Govish/Shimamp-Hardware/README.md

# Shimamp-Hardware
 Hardware Design Files for high-efficiency shim amplifier
