Govish/Shimamp-Hardware/Mechanical CAD/revB/board_outline_r2.dxf

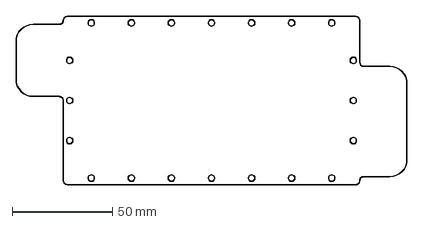
[picture p1: CAD file, 2023-11-08]
Mechanical CAD/revB/board_outline_r2.dxf
195.0 x 84.0 mm
