Govish/Shimamp-Hardware/Mechanical CAD/revB/board_outline.dxf

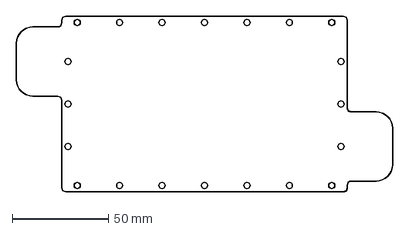
[picture p2: CAD file, 2023-11-08]
Mechanical CAD/revB/board_outline.dxf
195.0 x 91.0 mm
