Govish/Shimamp-Hardware/Mechanical CAD/revA/Class-D Prototype RevA Board Outline.dxf

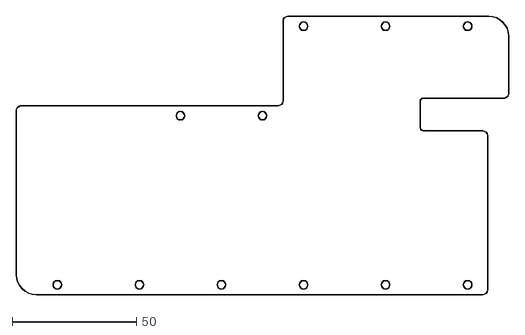
[picture p3: CAD file, 2023-11-08, an earlier design]
Mechanical CAD/revA/Class-D Prototype RevA Board Outline.dxf
198.0 x 112.0
