Govish/Shimamp-Hardware/Mechanical CAD/revA/Class-D Prototype RevA Heatsink.dxf

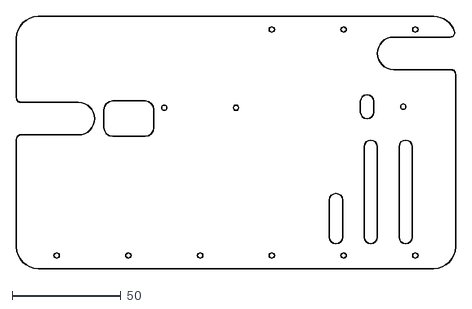
[picture p4: CAD file, 2023-11-08, an earlier design]
Mechanical CAD/revA/Class-D Prototype RevA Heatsink.dxf
202.0 x 116.0
