Govish/Shimamp-Hardware/(list of files, cad)

Other CAD files:
Mechanical CAD/revA/Class-D RevA Board Heatsink.ipt
Mechanical CAD/revA/Class-D RevA Board Outline.ipt
Mechanical CAD/revA/OldVersions/Class-D RevA Board Heatsink.0003.ipt
Mechanical CAD/revA/OldVersions/Class-D RevA Board Outline.0011.ipt
Mechanical CAD/revB/Board Outline.ipt
Mechanical CAD/revB/OldVersions/Board Outline.0009.ipt
