Govish/Shimamp-Hardware/Class-D Prototype revB/Class-D Prototype RevB/Class-D Prototype RevB.pdf

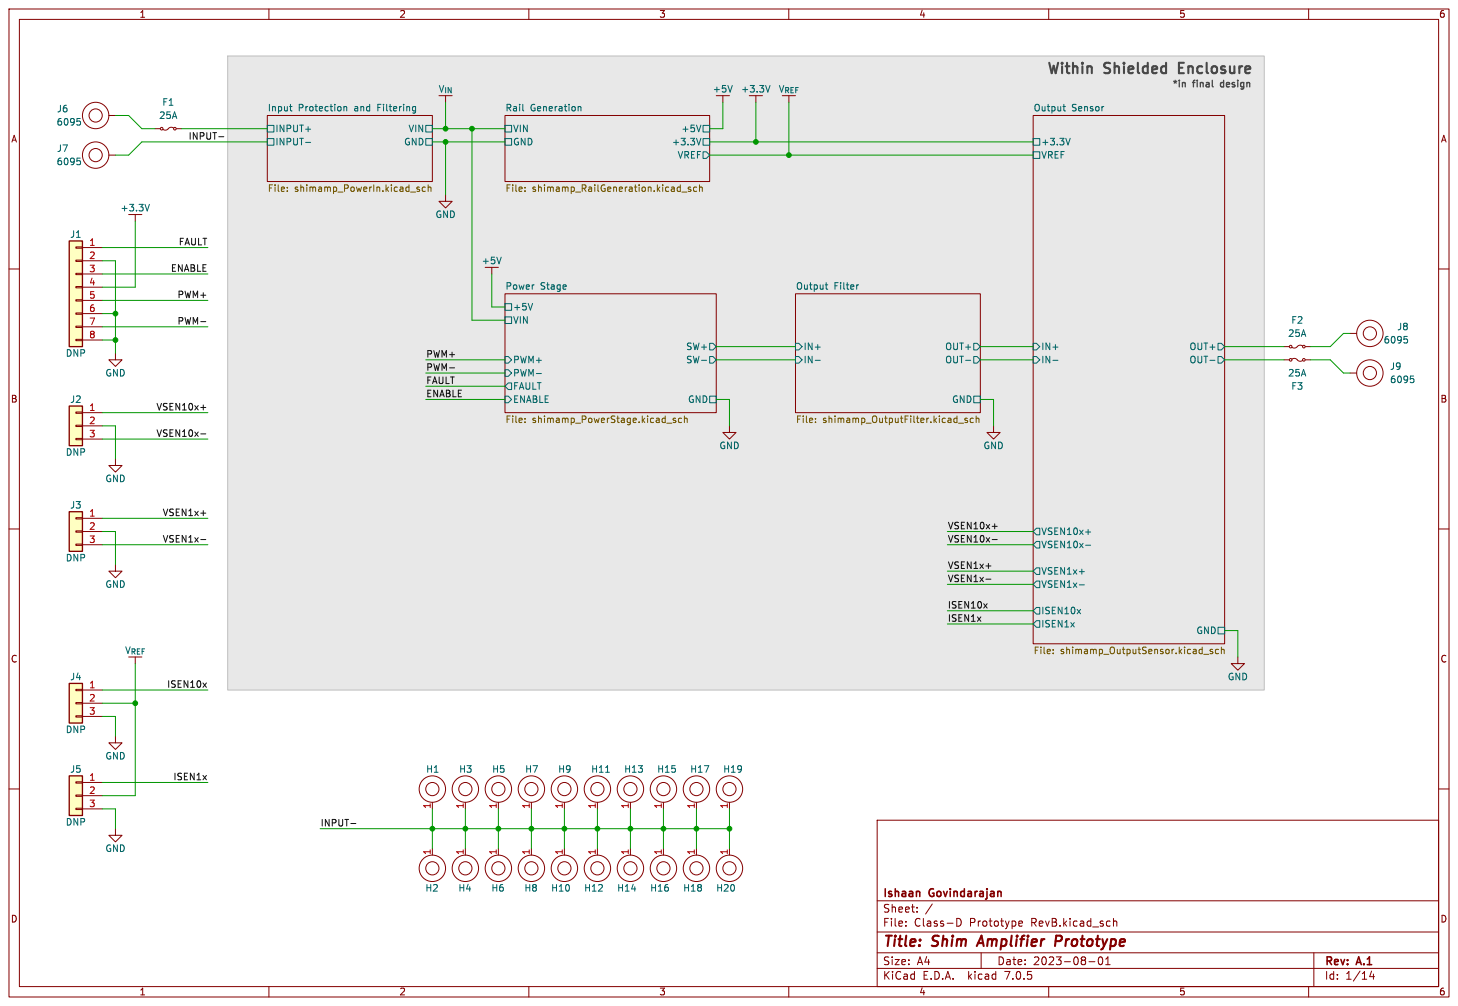
[picture p5: page 1]

Rail Generation File: shimamp_RailGeneration.kicad_sch GND

Ishaan Govindarajan
Id: 1/14 Title: Shim Amplifier Prototype

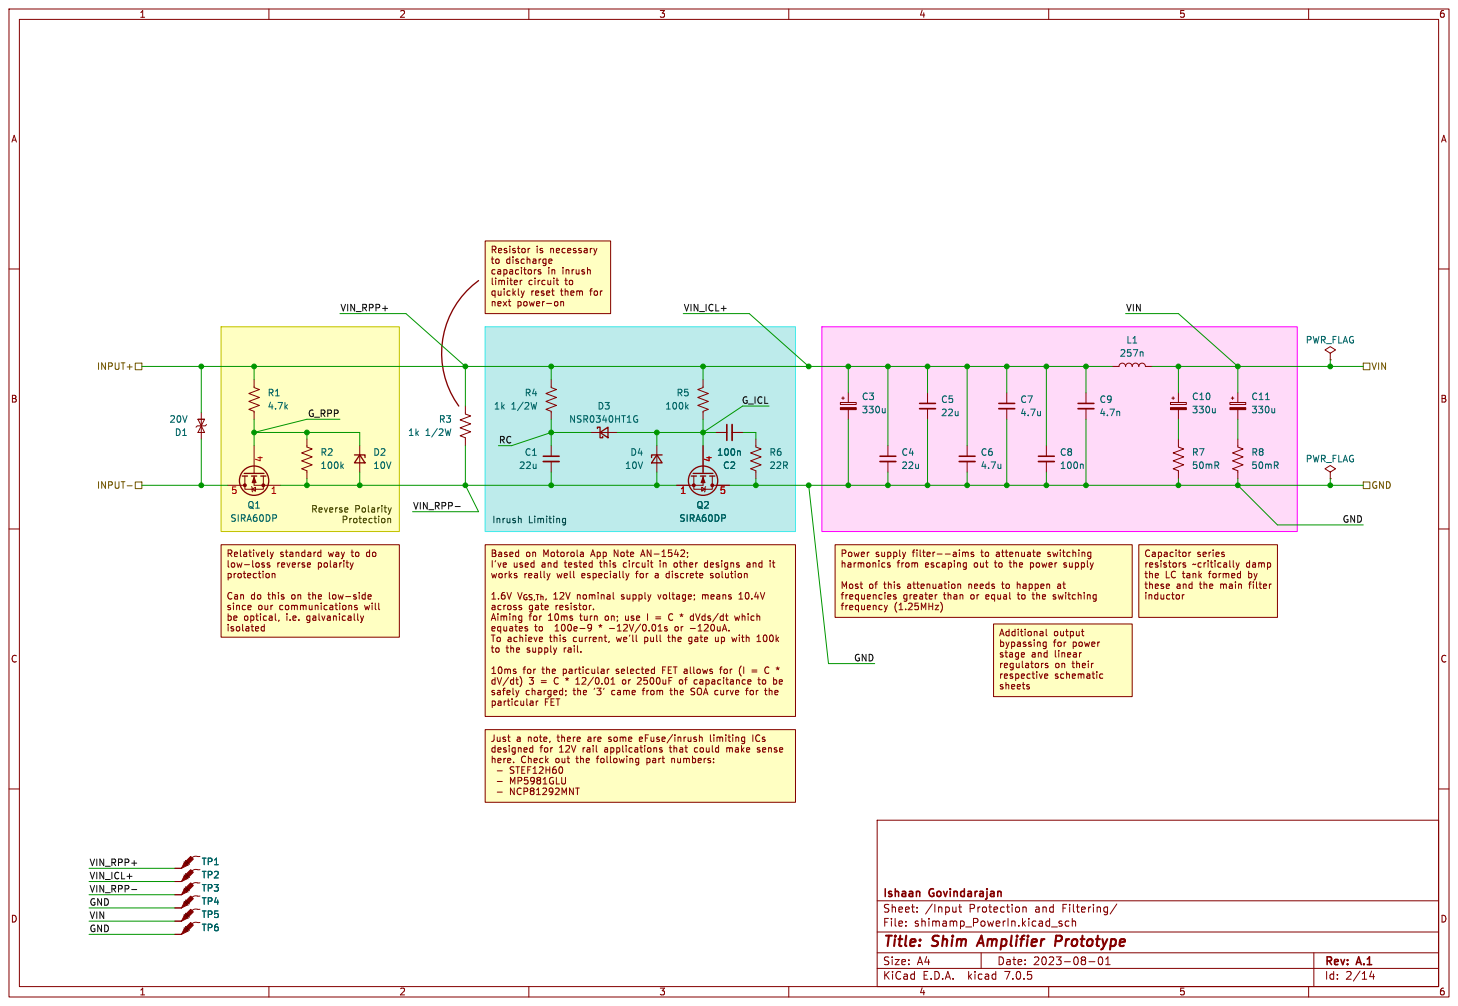
[picture p6: page 2]

- NCP81292MNT Based on Motorola App Note AN-1542;

protection Can do this on the low-side

the LC tank formed by
these and the main filter

1.6V V_{GS,Th}, 12V nominal supply voltage; means 10.4V

safely charged; the '3' came from the SOA curve for the

Id: 2/14 Title: Shim Amplifier Prototype

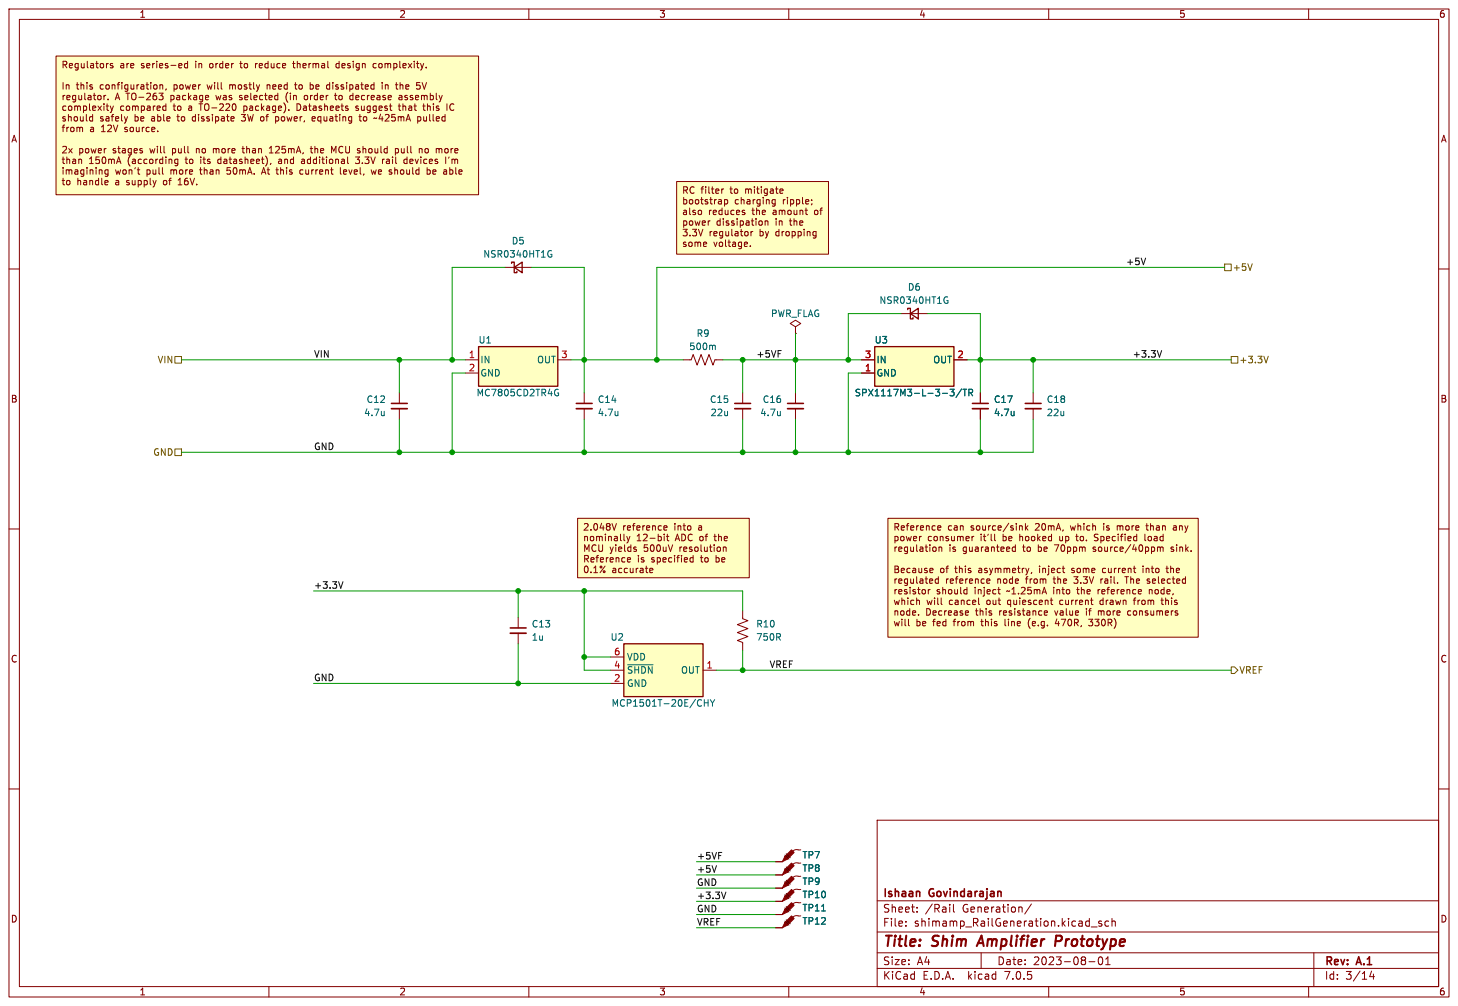
[picture p7: page 3]

from a 12V source. 2x power stages will pull no more than 125mA, the MCU should pull no more

RC filter to mitigate

Ishaan Govindarajan
Id: 3/14 Title: Shim Amplifier Prototype

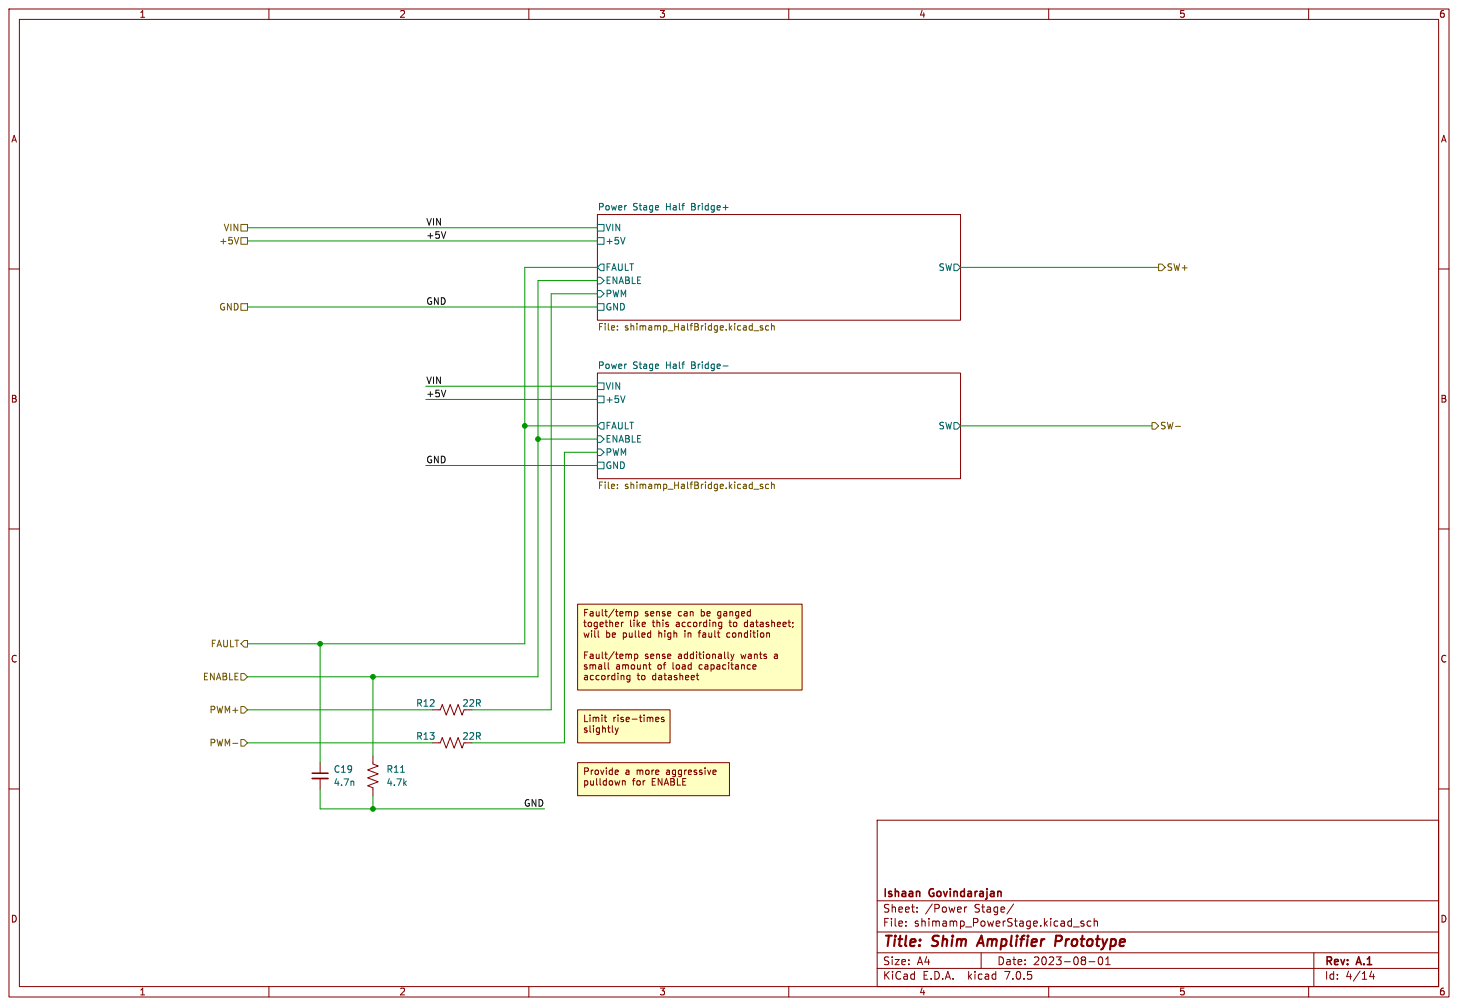
[picture p8: page 4]

Power Stage Half Bridge- File: shimamp_HalfBridge.kicad_sch GND

small amount of load capacitance

Id: 4/14 Title: Shim Amplifier Prototype

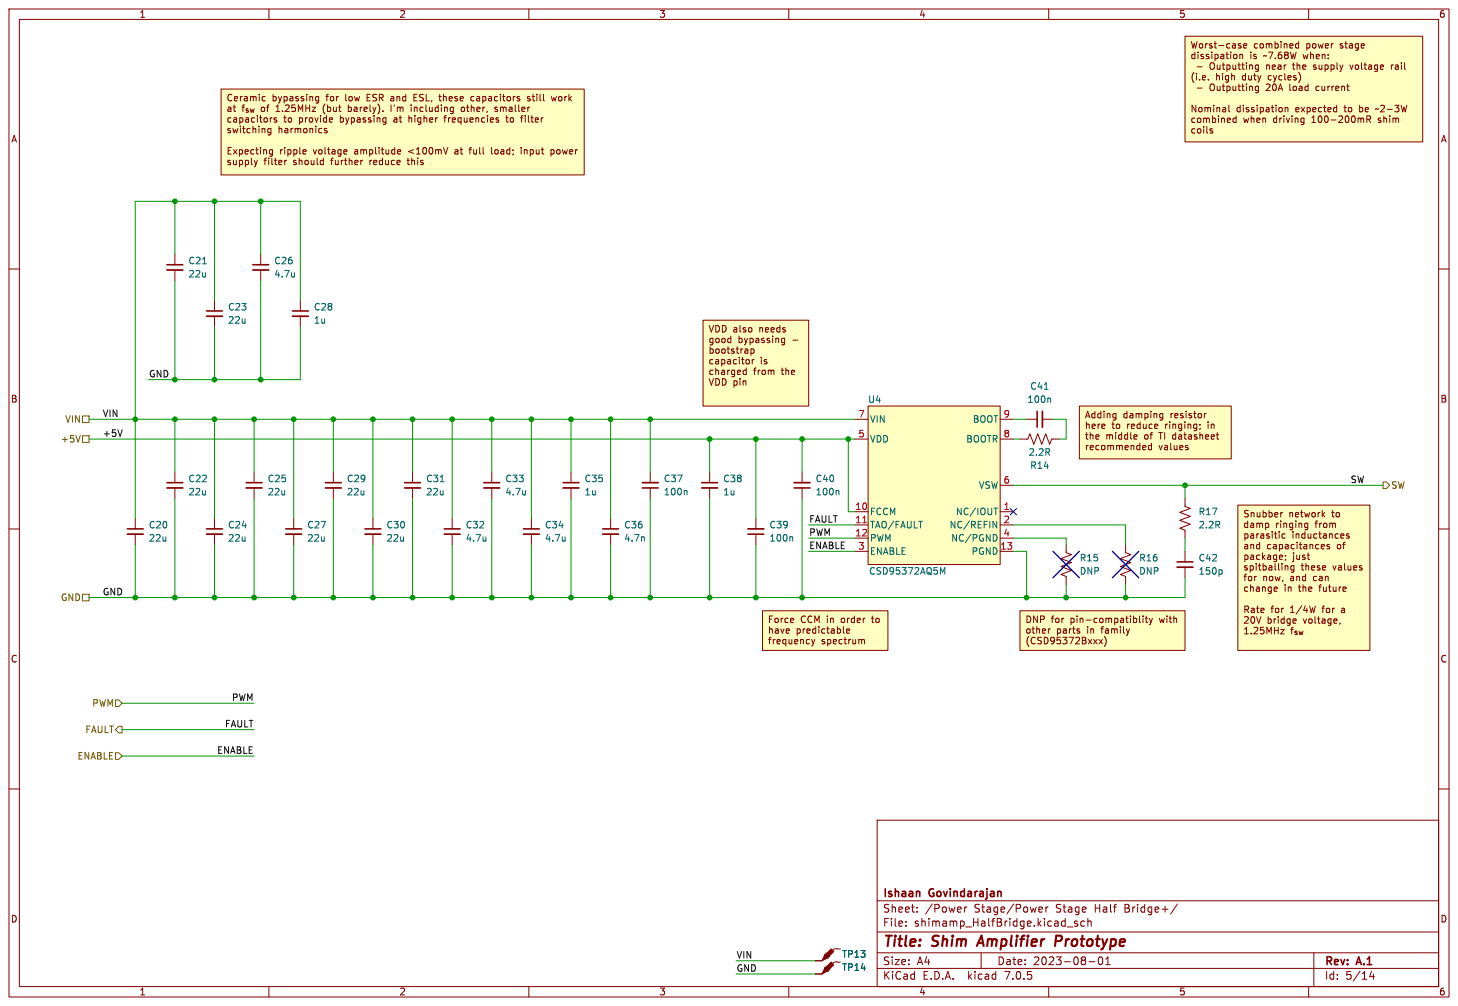
[picture p9: page 5]

charged from the VDD pin

for now, and can
change in the future Rate for 1/4W for a

Force CCM in order to
have predictable

other parts in family

Id: 5/14 Title: Shim Amplifier Prototype

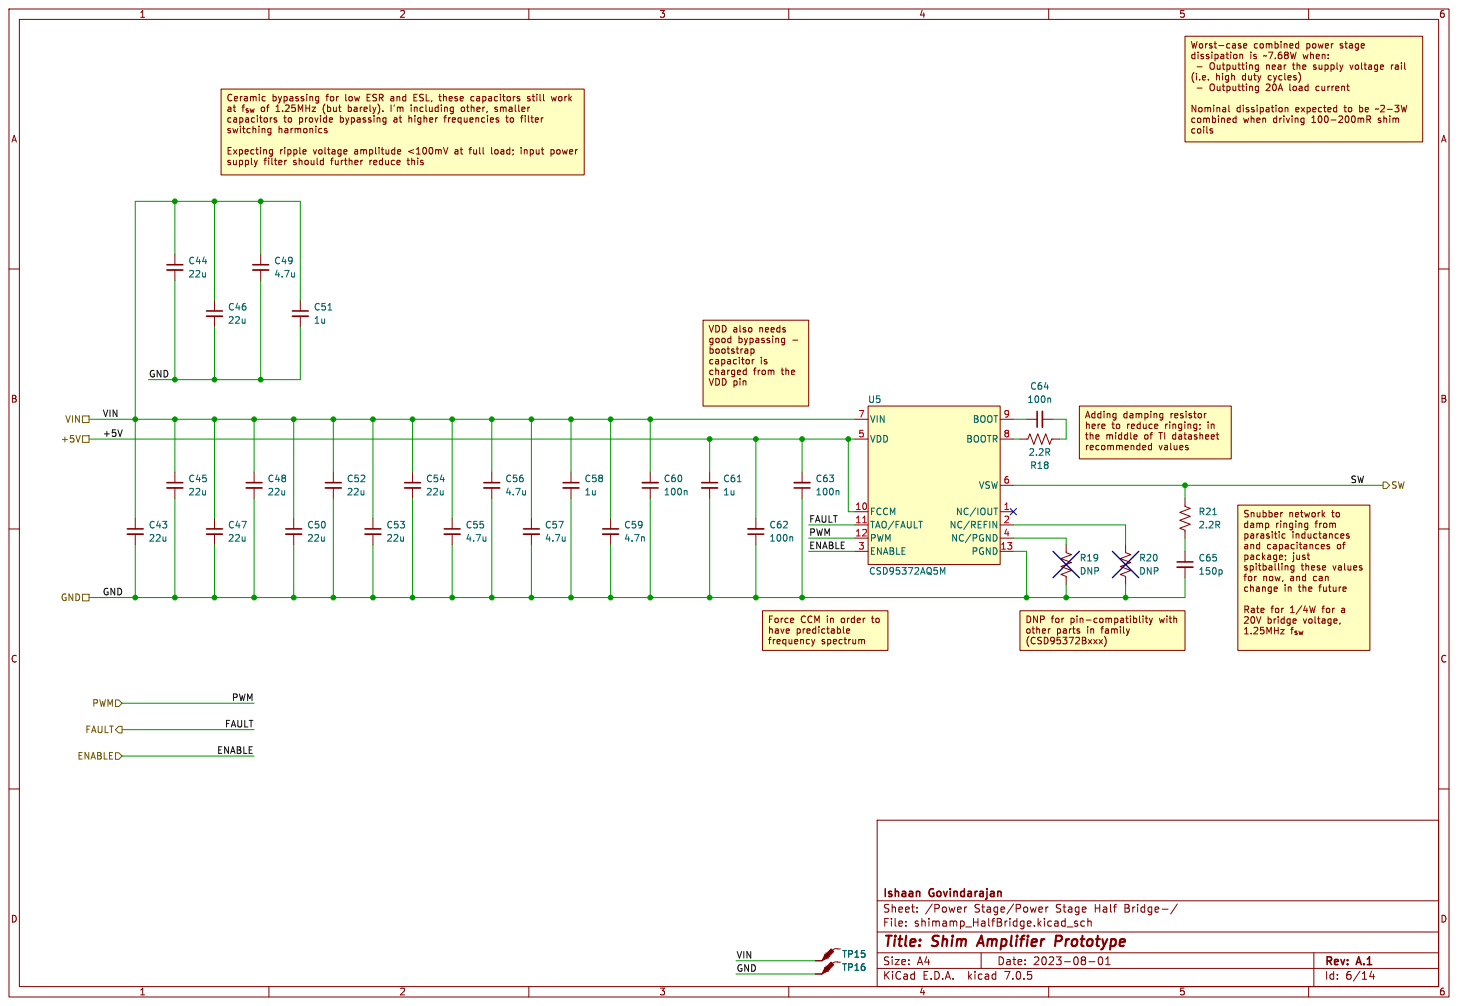
[picture p10: page 6]

charged from the VDD pin

for now, and can
change in the future Rate for 1/4W for a

Force CCM in order to
have predictable

other parts in family

Id: 6/14 Title: Shim Amplifier Prototype

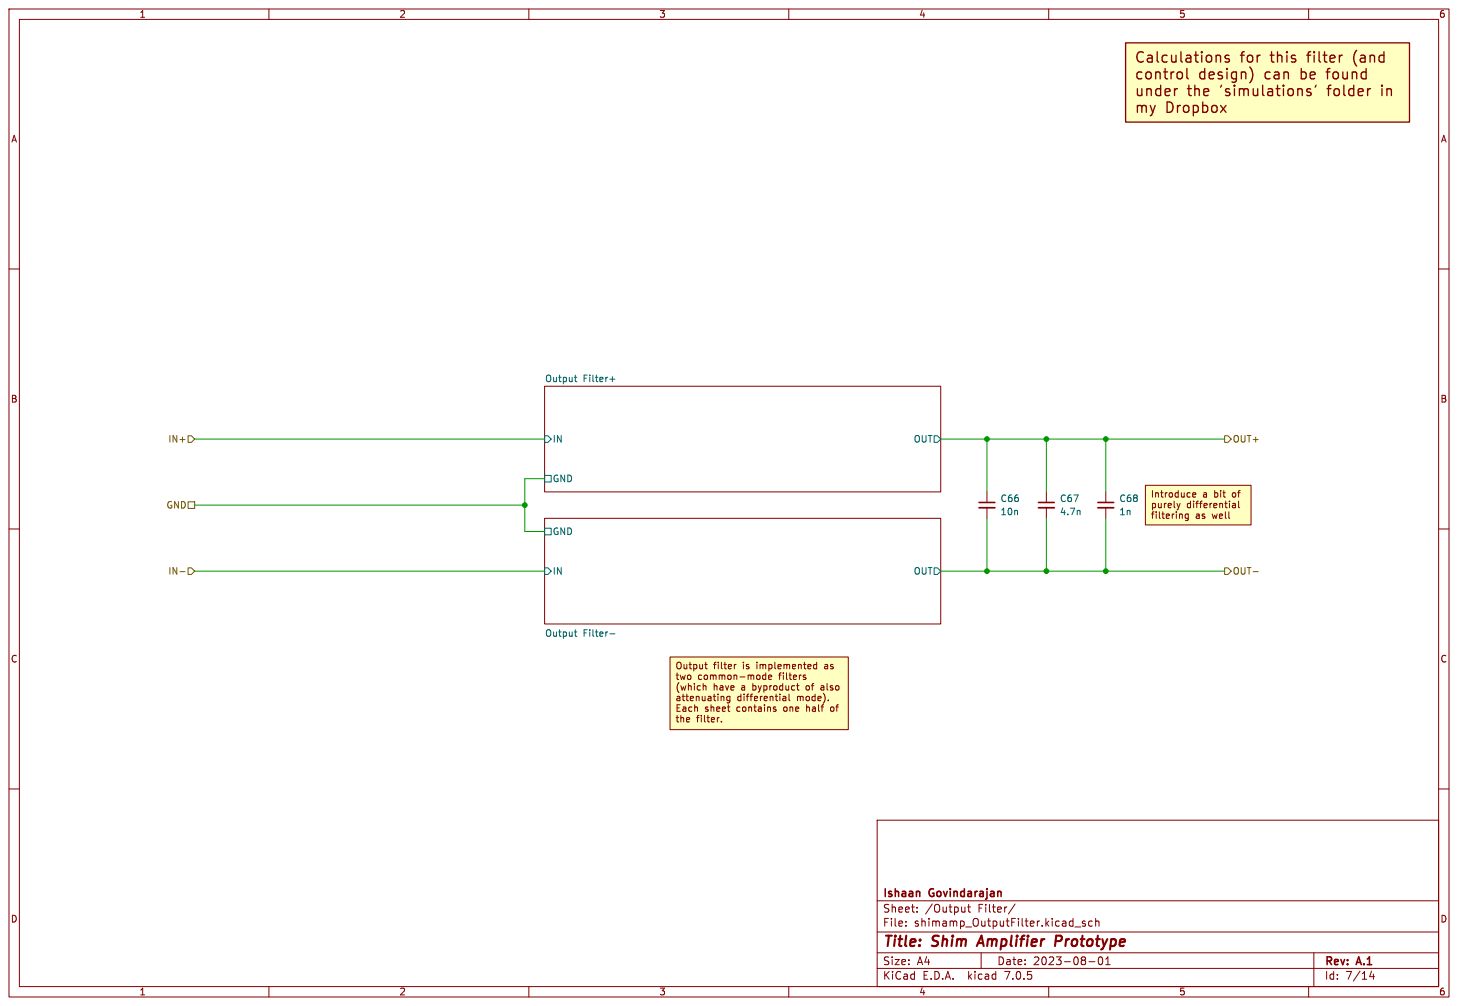
[picture p11: page 7]

Ishaan Govindarajan
Id: 7/14 Title: Shim Amplifier Prototype

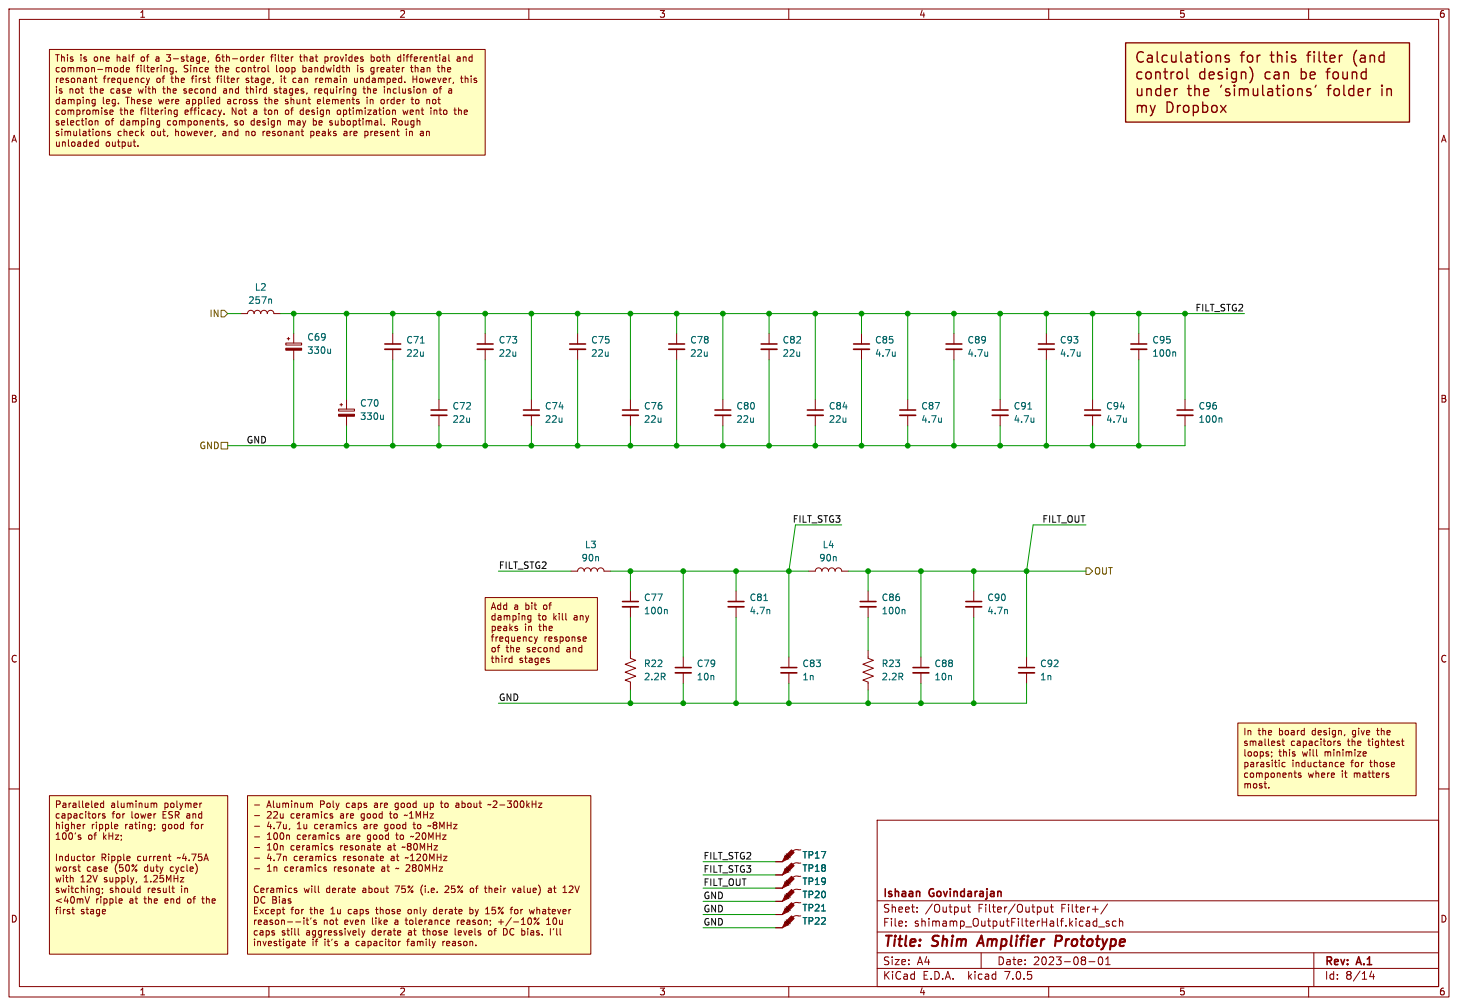
[picture p12: page 8]

Calculations for this filter (and
control design) can be found
my Dropbox

of the second and
third stages

In the board design, give the
loops; this will minimize

- Aluminum Poly caps are good up to about ~2-300kHz

higher ripple rating; good for 100's of kHz;

Ishaan Govindarajan
Id: 8/14 Title: Shim Amplifier Prototype

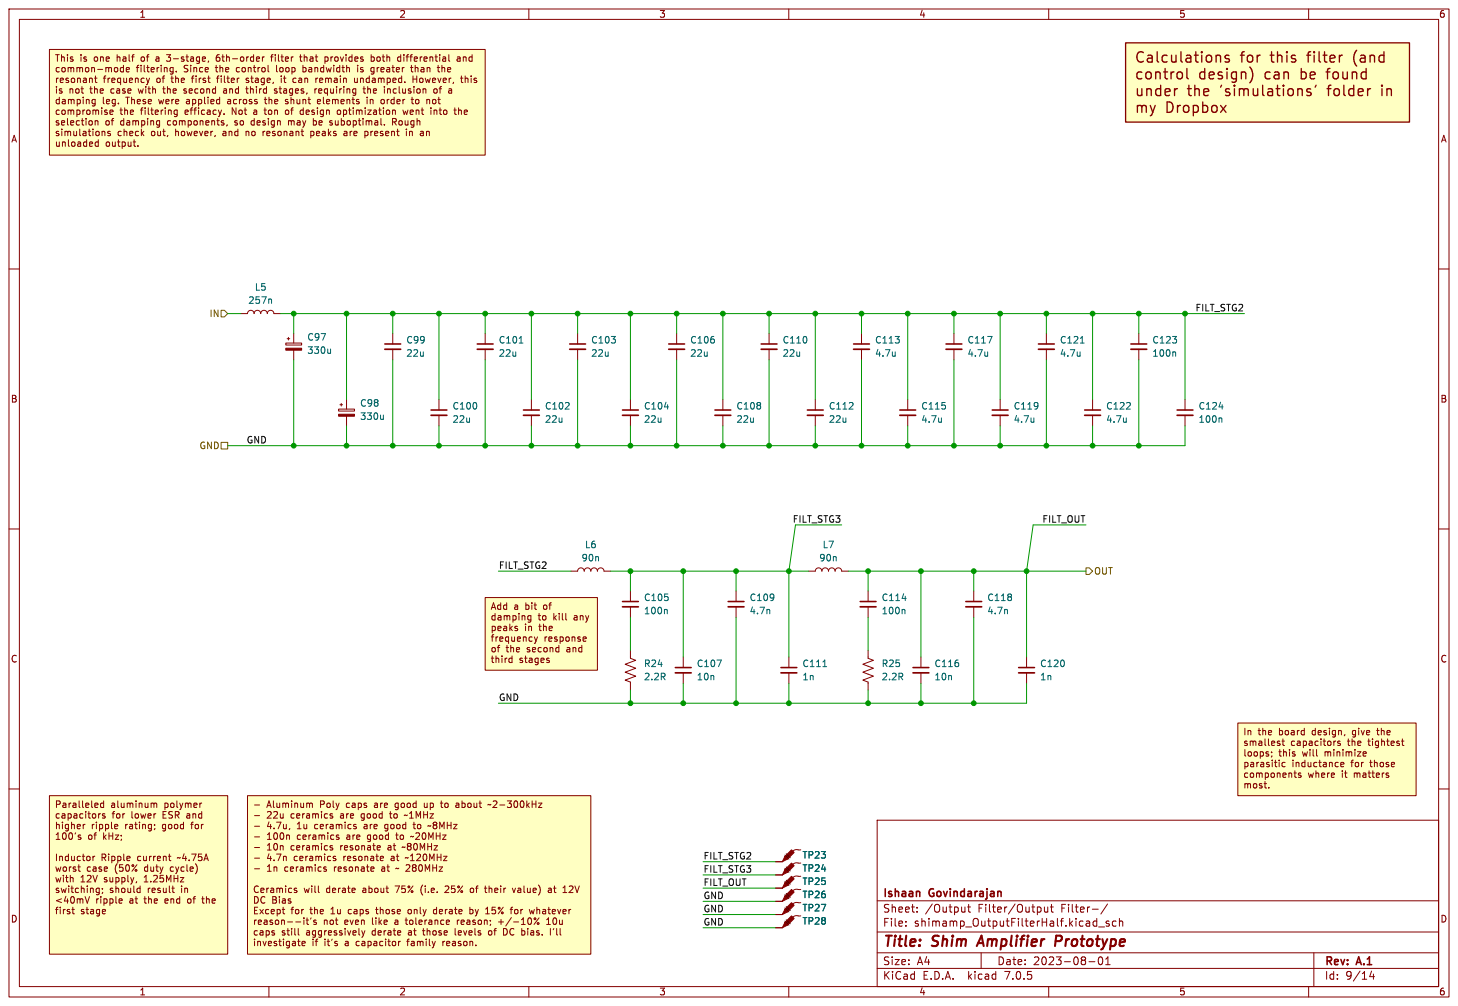
[picture p13: page 9]

Calculations for this filter (and
control design) can be found
my Dropbox

of the second and
third stages

In the board design, give the
loops; this will minimize

- Aluminum Poly caps are good up to about ~2-300kHz

higher ripple rating; good for 100's of kHz;

Ishaan Govindarajan
Id: 9/14 Title: Shim Amplifier Prototype

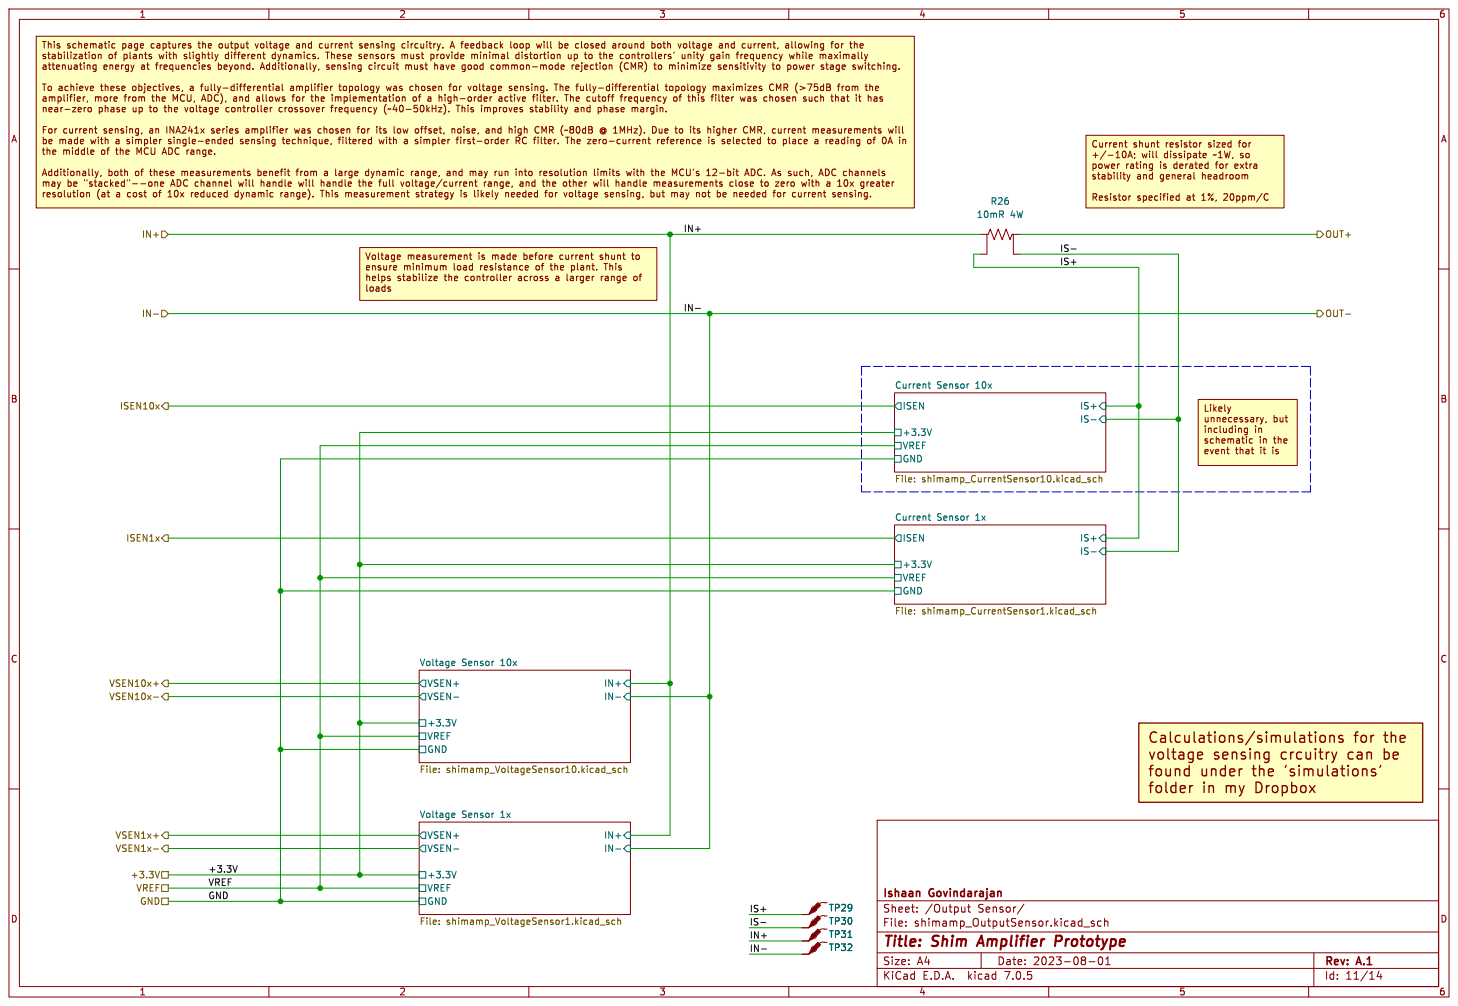
[picture p14: page 10]

power rating is derated for extra

Current Sensor 10x File: shimamp_CurrentSensor10.kicad_sch GND

event that it is

IS+ Current Sensor 1x File: shimamp_CurrentSensor1.kicad_sch VSEN- VSEN+

voltage sensing crcuitry can be
found under the 'simulations'
folder in my Dropbox

Id: 11/14 Title: Shim Amplifier Prototype

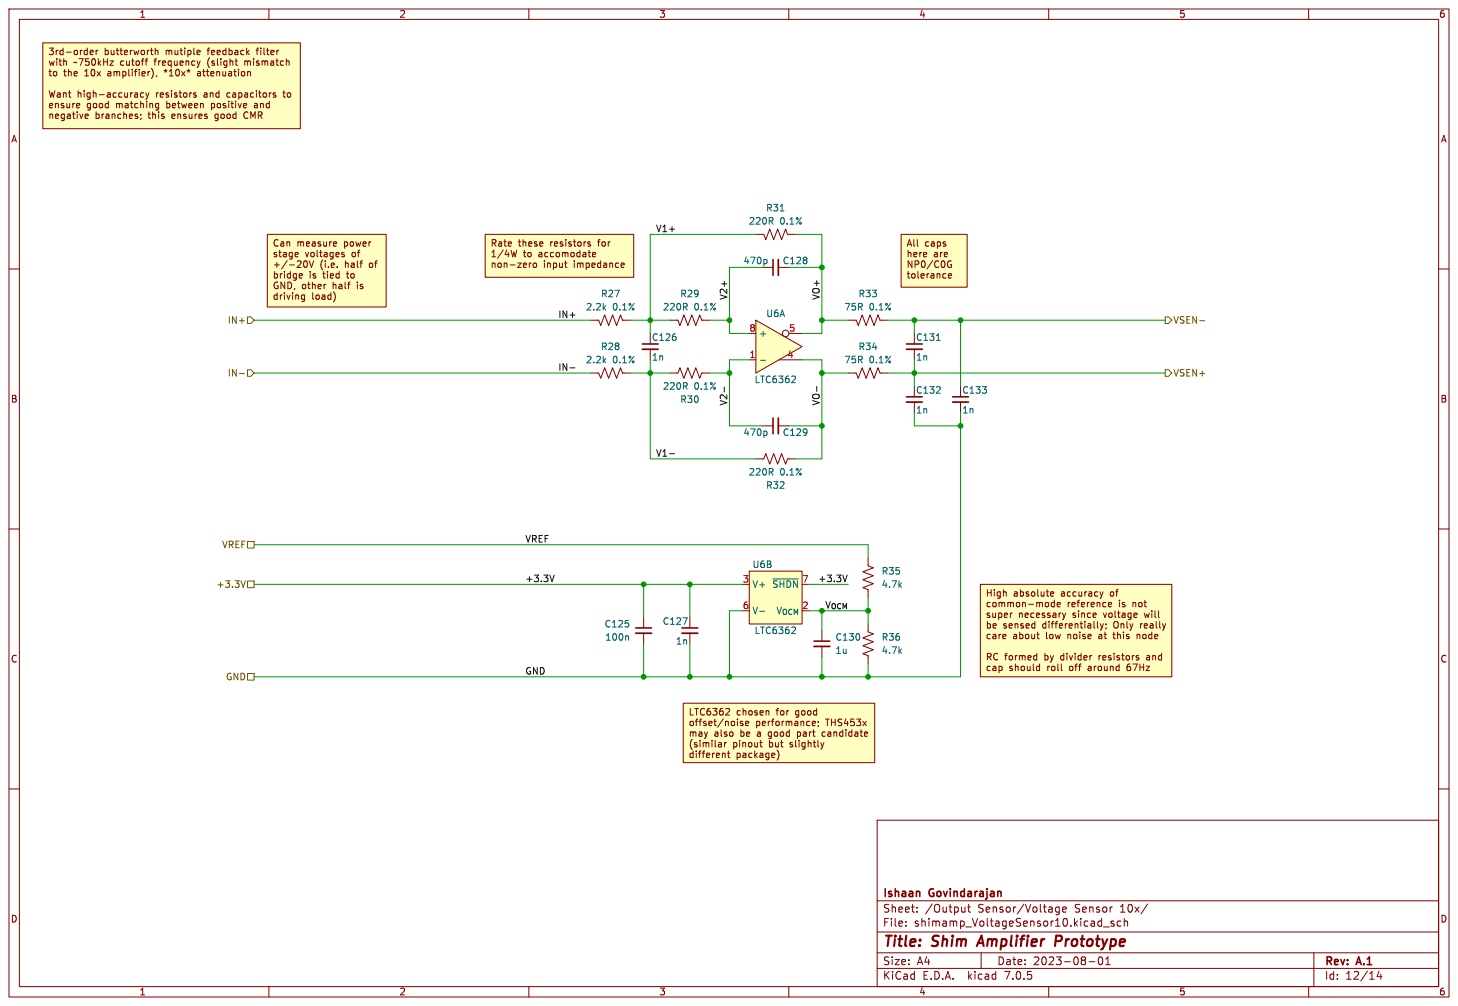
[picture p15: page 11]

cap should roll off around 67Hz LTC6362 chosen for good

Id: 12/14 Title: Shim Amplifier Prototype

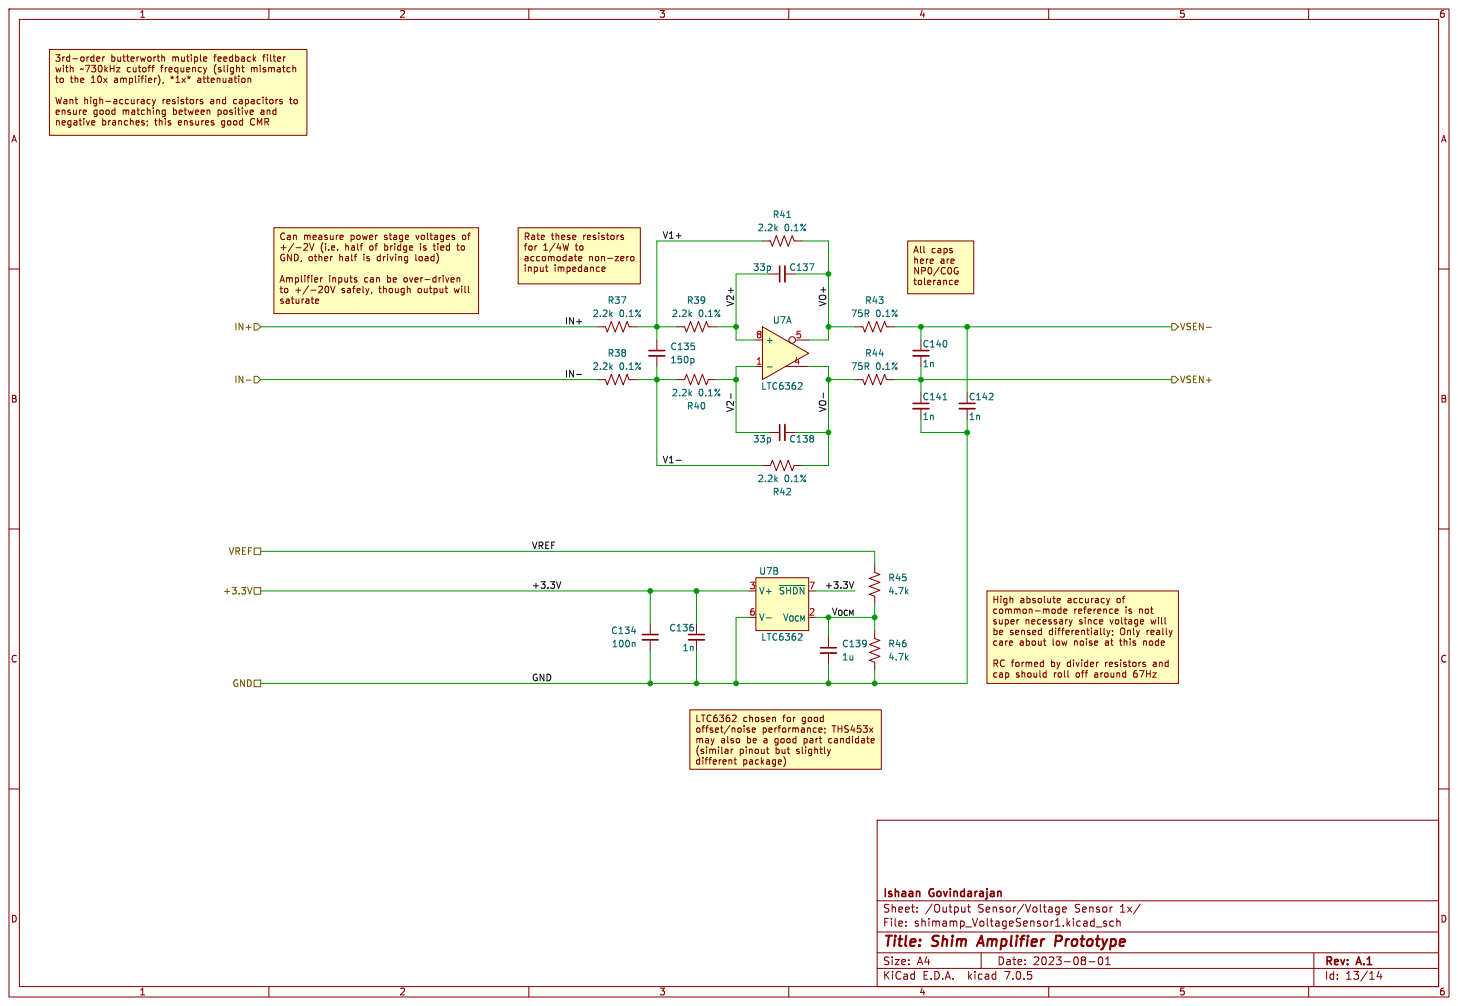
[picture p16: page 12]

cap should roll off around 67Hz All caps here are NP0/C0G

Id: 13/14 Title: Shim Amplifier Prototype

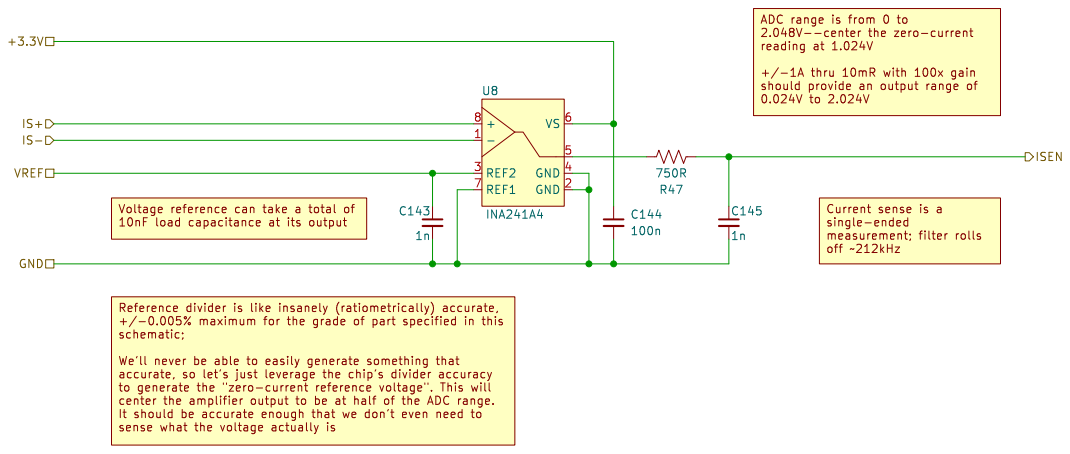
[picture p17: page 13]

should provide an output range of 0.024V to 2.024V

Id: 14/14 Title: Shim Amplifier Prototype

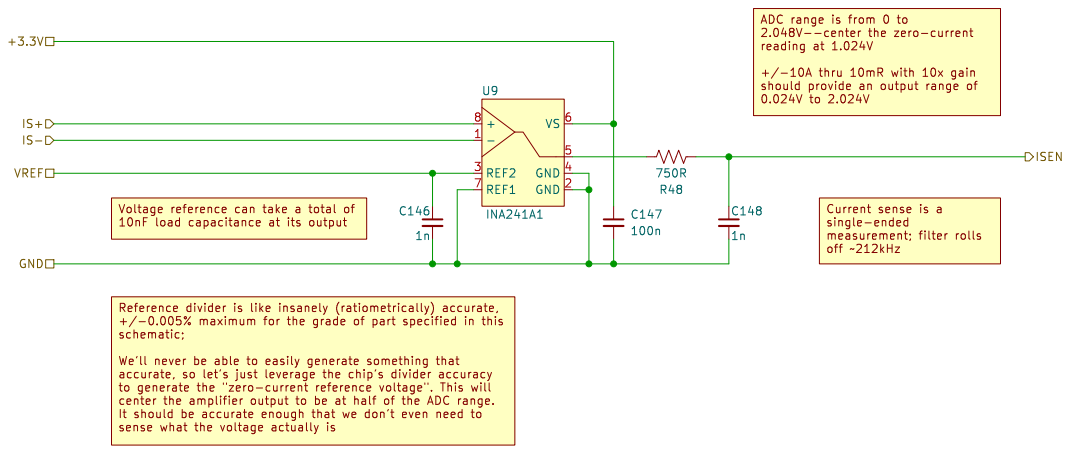
[picture p18: page 14]

should provide an output range of 0.024V to 2.024V

Id: 15/14 Title: Shim Amplifier Prototype
