Govish/Shimamp-Hardware/Class-D Prototype revB2/Class-D Prorotype RevB2/Class-D Prorotype RevB2.pdf

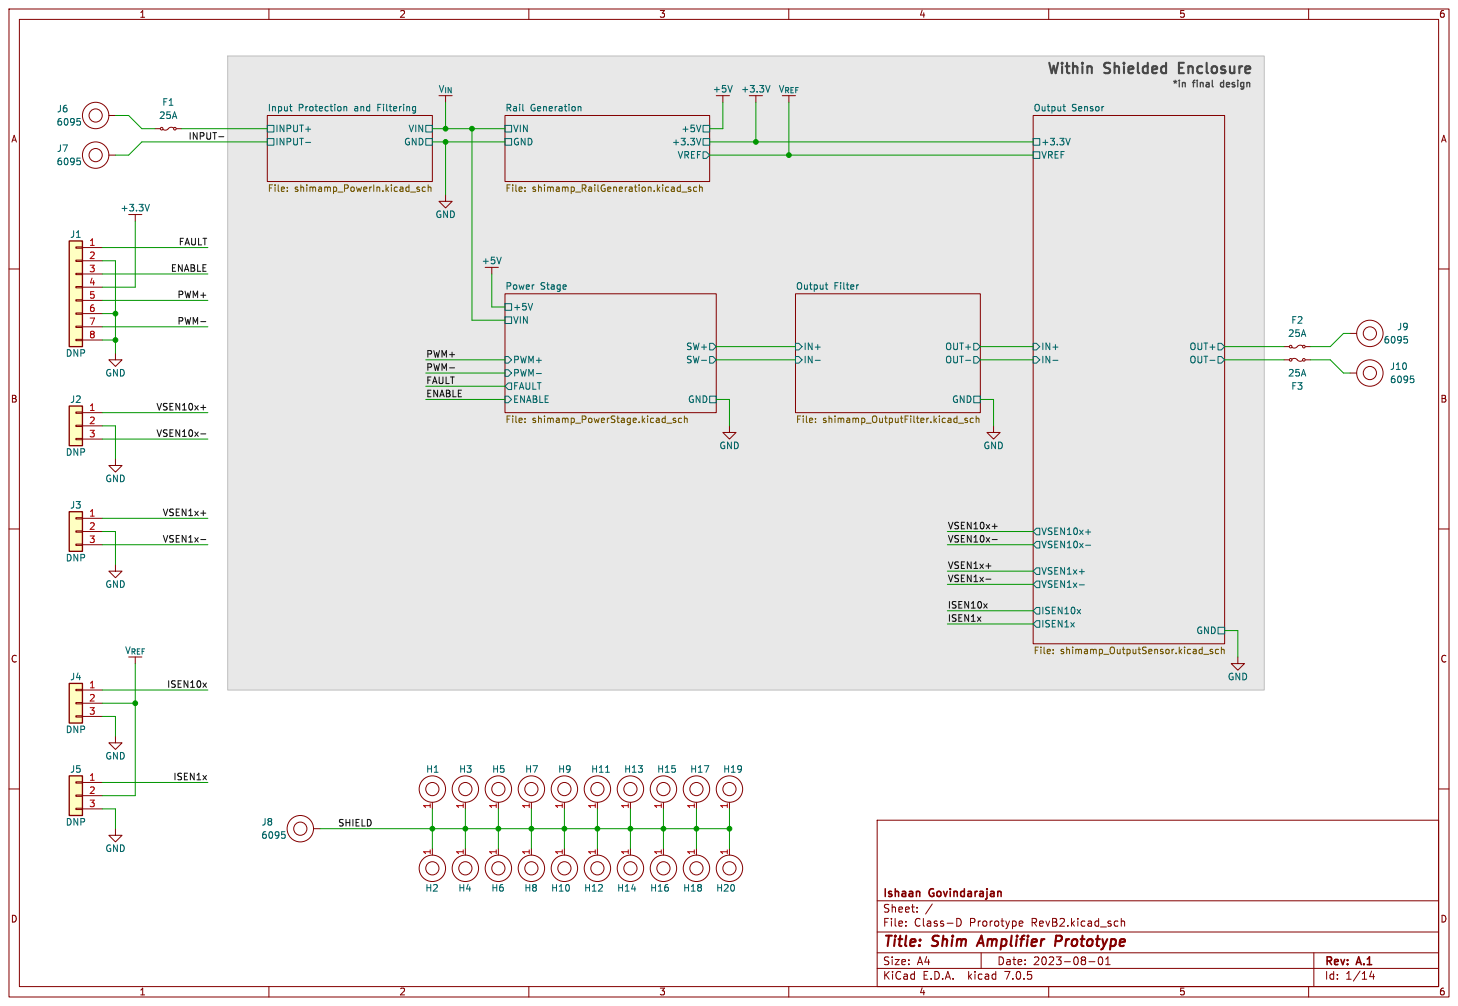
[picture p19: page 1]

Ishaan Govindarajan
Id: 1/14 Title: Shim Amplifier Prototype

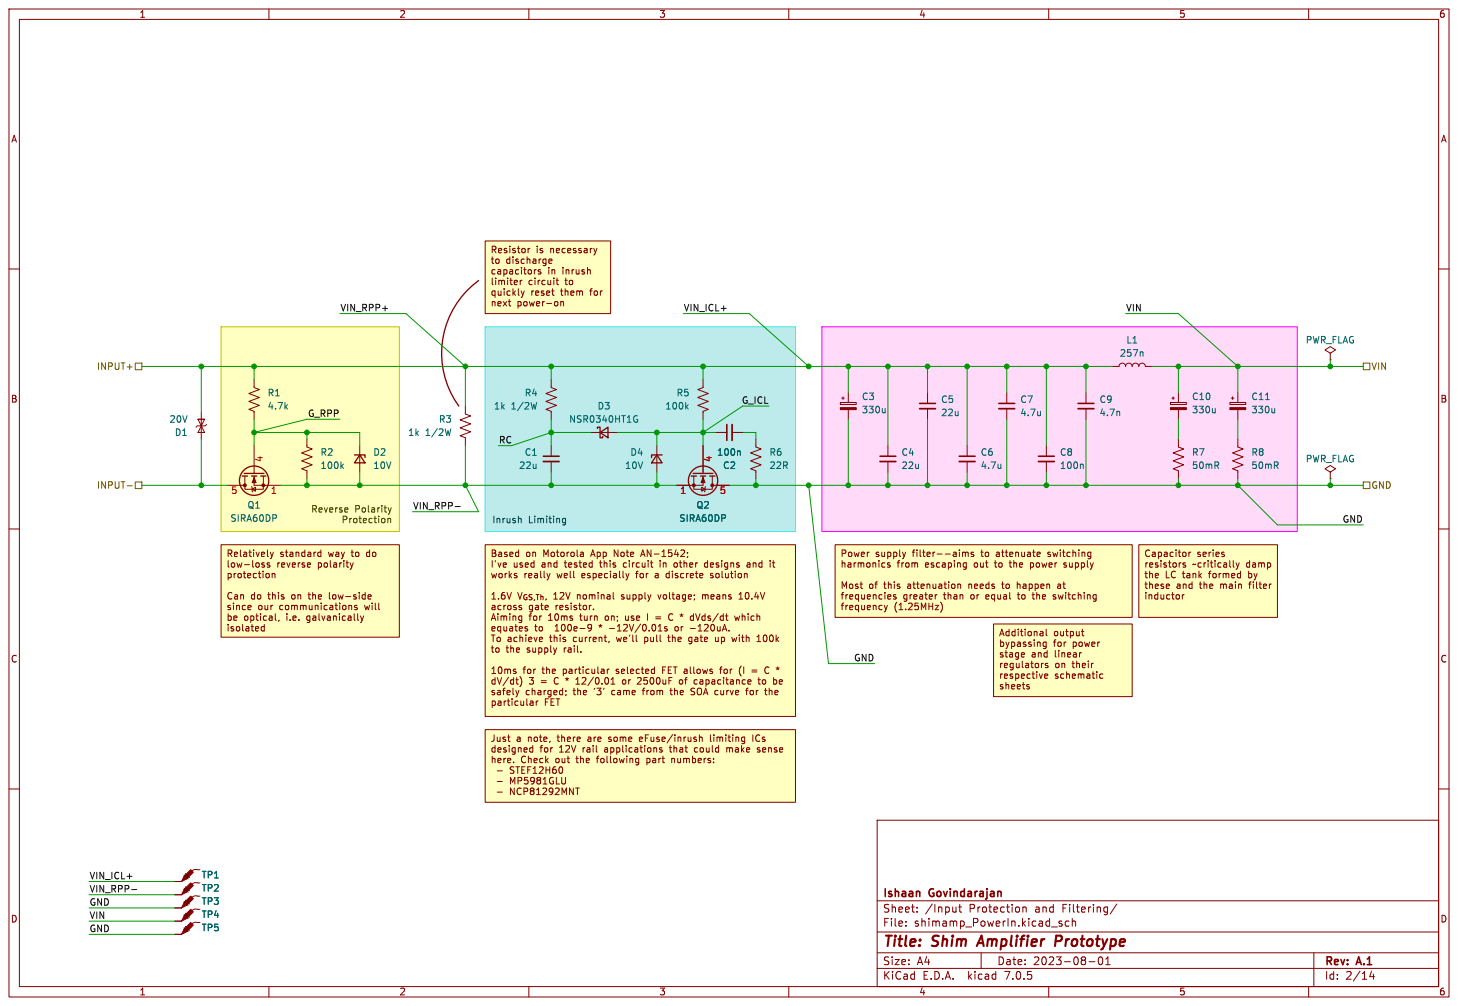
[picture p20: page 2]

protection Can do this on the low-side

the LC tank formed by
these and the main filter

1.6V V_{GS,Th}, 12V nominal supply voltage; means 10.4V

safely charged; the '3' came from the SOA curve for the

Id: 2/14 Title: Shim Amplifier Prototype

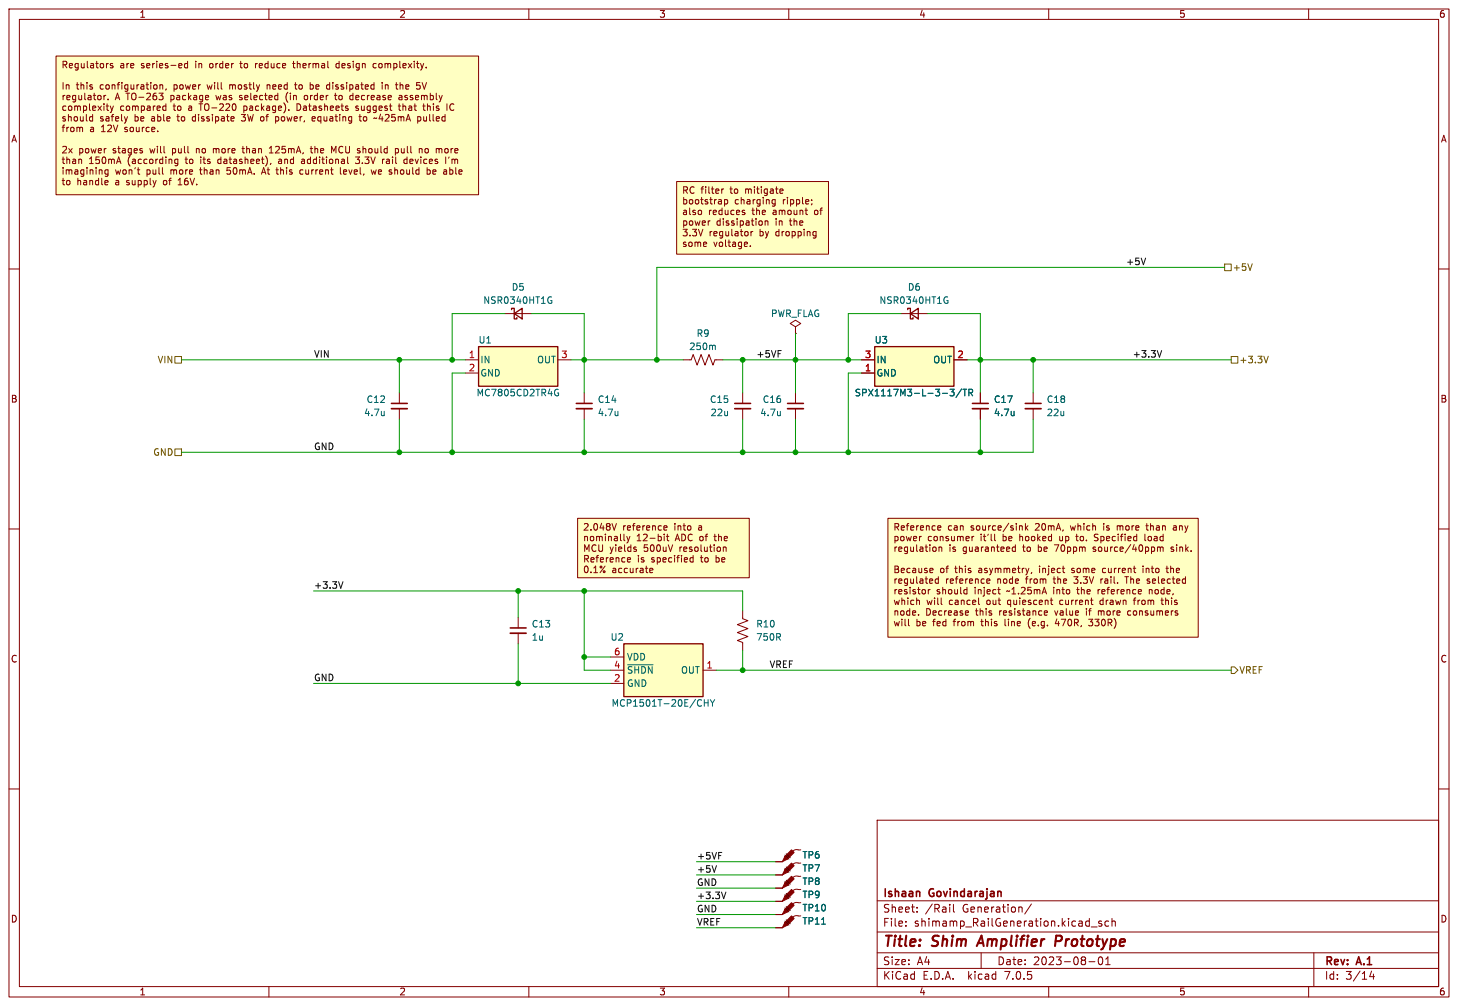
[picture p21: page 3]

from a 12V source. 2x power stages will pull no more than 125mA, the MCU should pull no more

Id: 3/14 Title: Shim Amplifier Prototype


Power Stage Half Bridge- File: shimamp_HalfBridge.kicad_sch GND

small amount of load capacitance

Id: 4/14 Title: Shim Amplifier Prototype

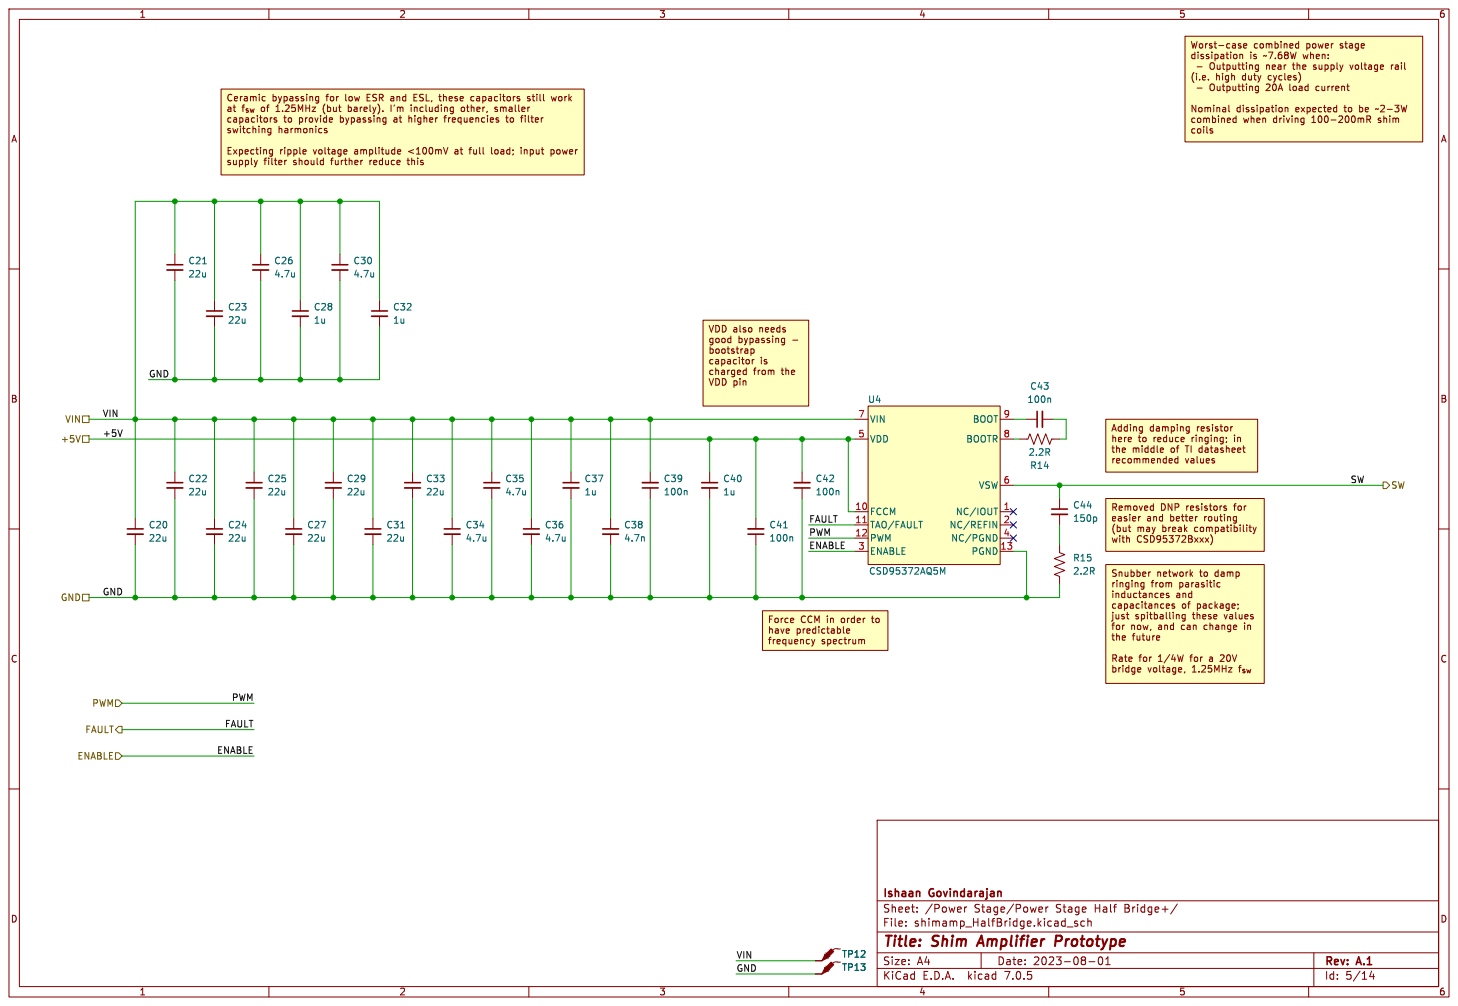
[picture p22: page 5]

coils Snubber network to damp

ringing from parasitic
for now, and can change in
the future Rate for 1/4W for a 20V

bridge voltage, 1.25MHz f_{sw} Force CCM in order to
have predictable

Ishaan Govindarajan
Id: 5/14 Title: Shim Amplifier Prototype

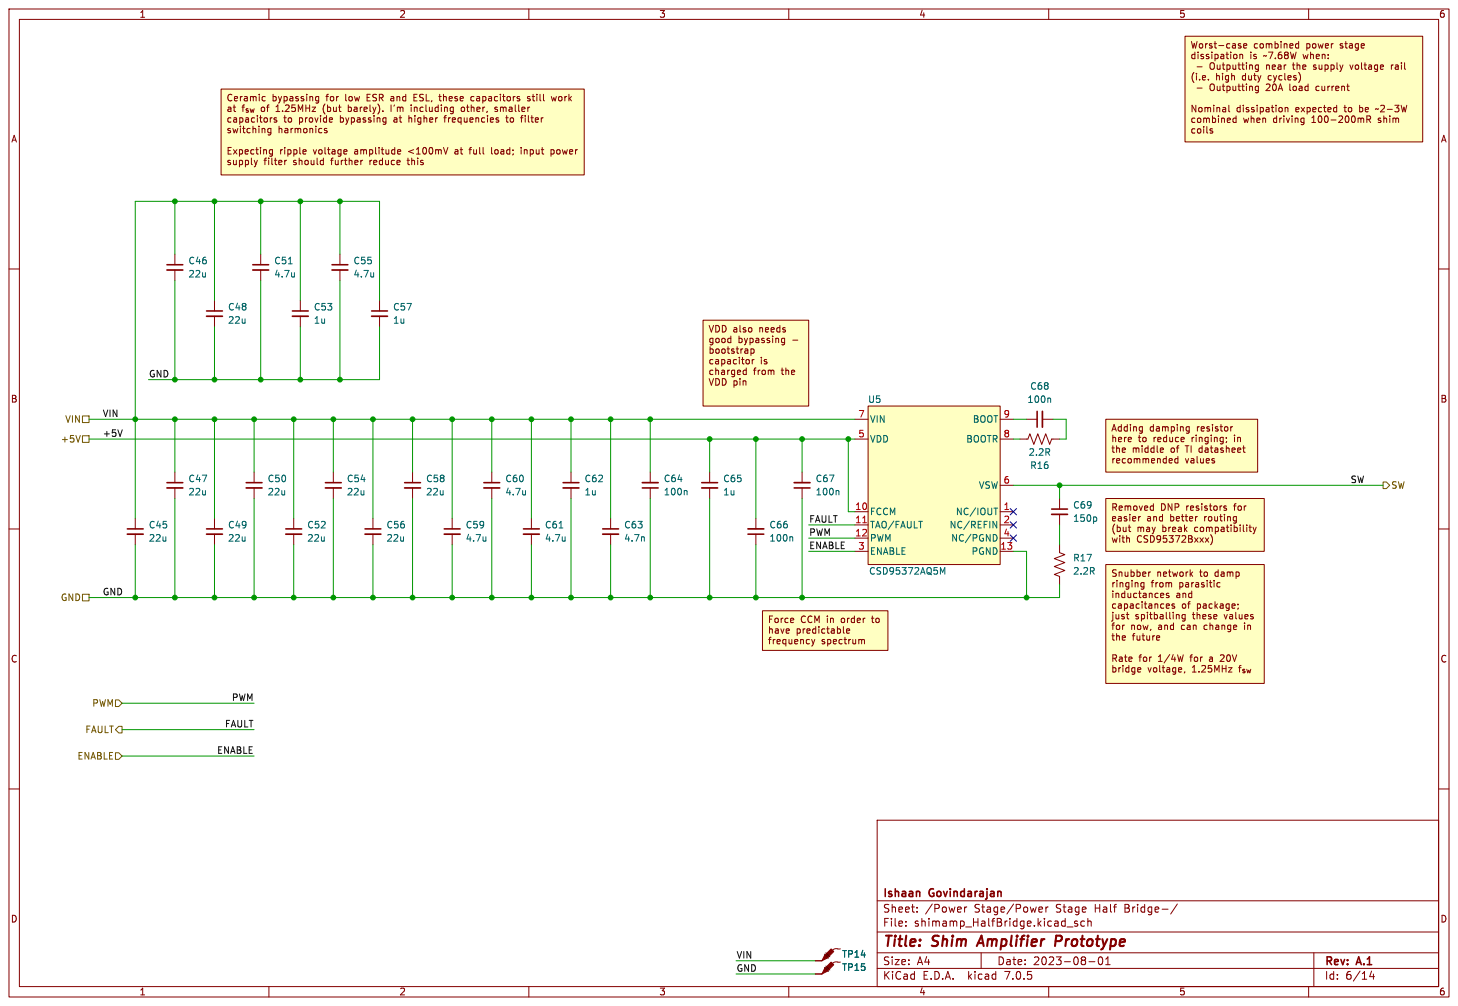
[picture p23: page 6]

coils Snubber network to damp

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

bridge voltage, 1.25MHz f_{sw} Force CCM in order to
have predictable

Ishaan Govindarajan
Id: 6/14 Title: Shim Amplifier Prototype

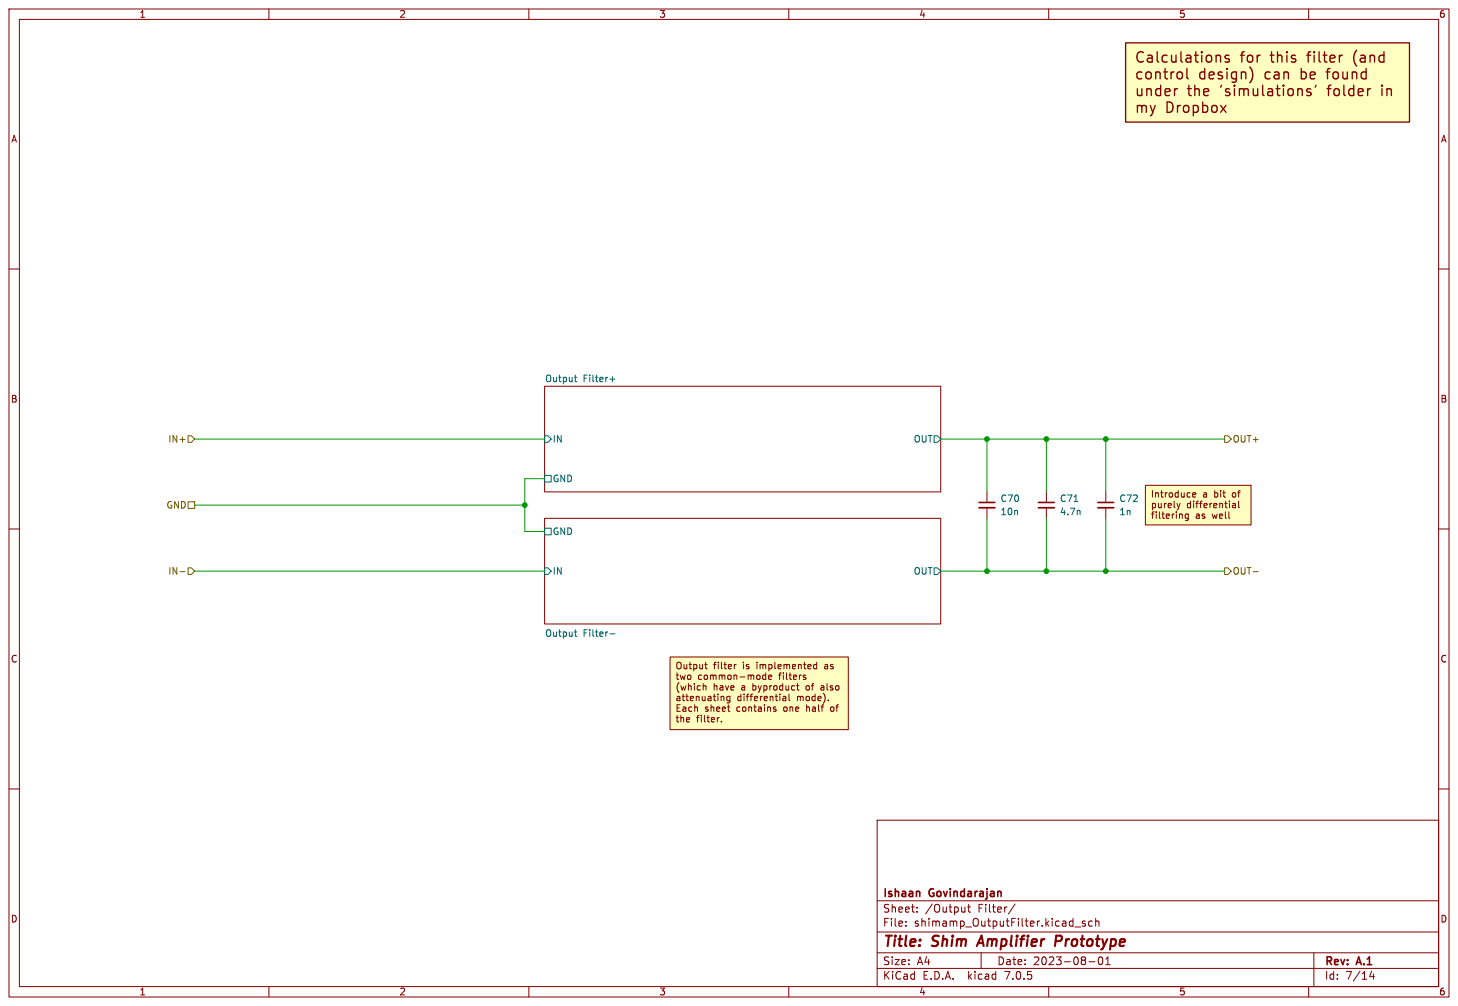
[picture p24: page 7]

Ishaan Govindarajan
Id: 7/14 Title: Shim Amplifier Prototype

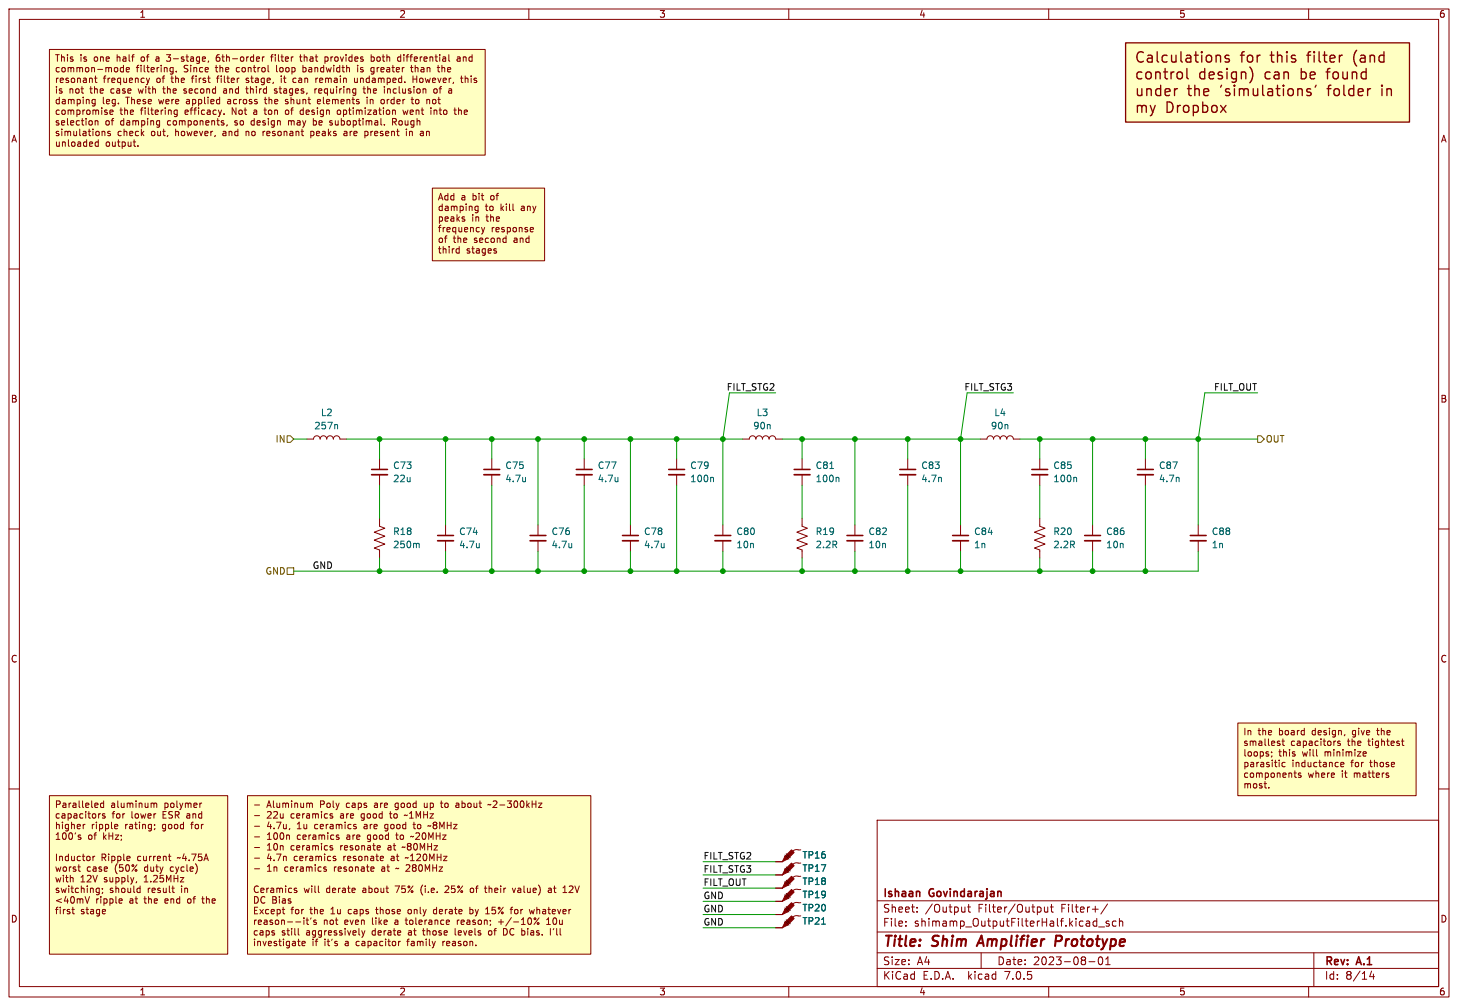
[picture p25: page 8]

Calculations for this filter (and
control design) can be found
my Dropbox

of the second and

In the board design, give the
loops; this will minimize

- Aluminum Poly caps are good up to about ~2-300kHz

higher ripple rating; good for 100's of kHz;

Id: 8/14 Title: Shim Amplifier Prototype

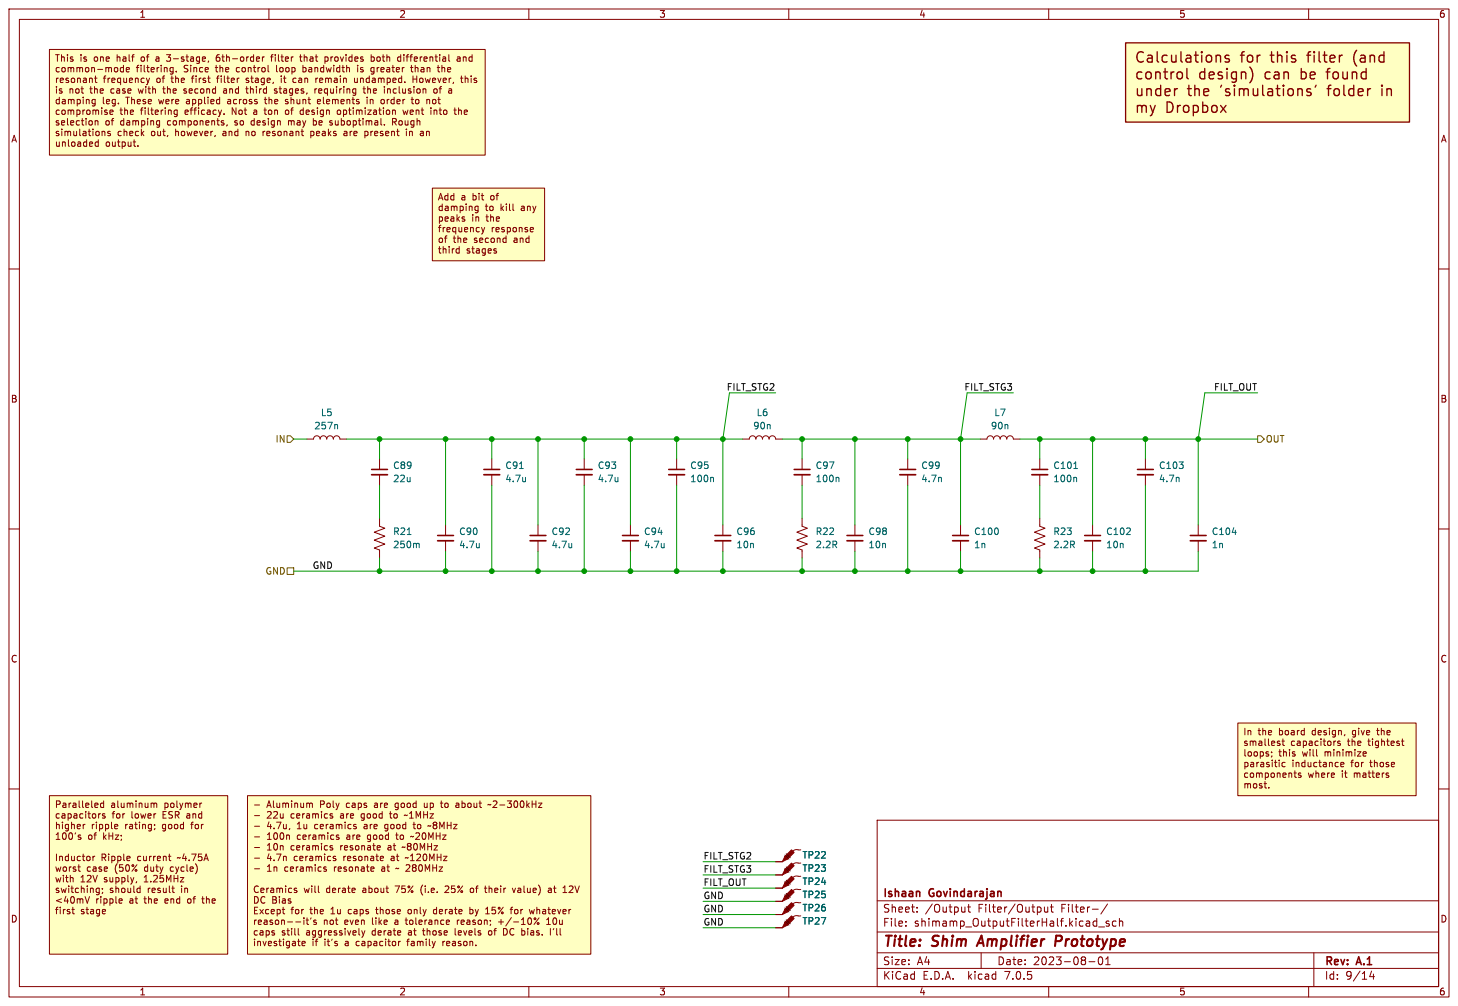
[picture p26: page 9]

Calculations for this filter (and
control design) can be found
my Dropbox

of the second and

In the board design, give the
loops; this will minimize

- Aluminum Poly caps are good up to about ~2-300kHz

higher ripple rating; good for 100's of kHz;

Id: 9/14 Title: Shim Amplifier Prototype

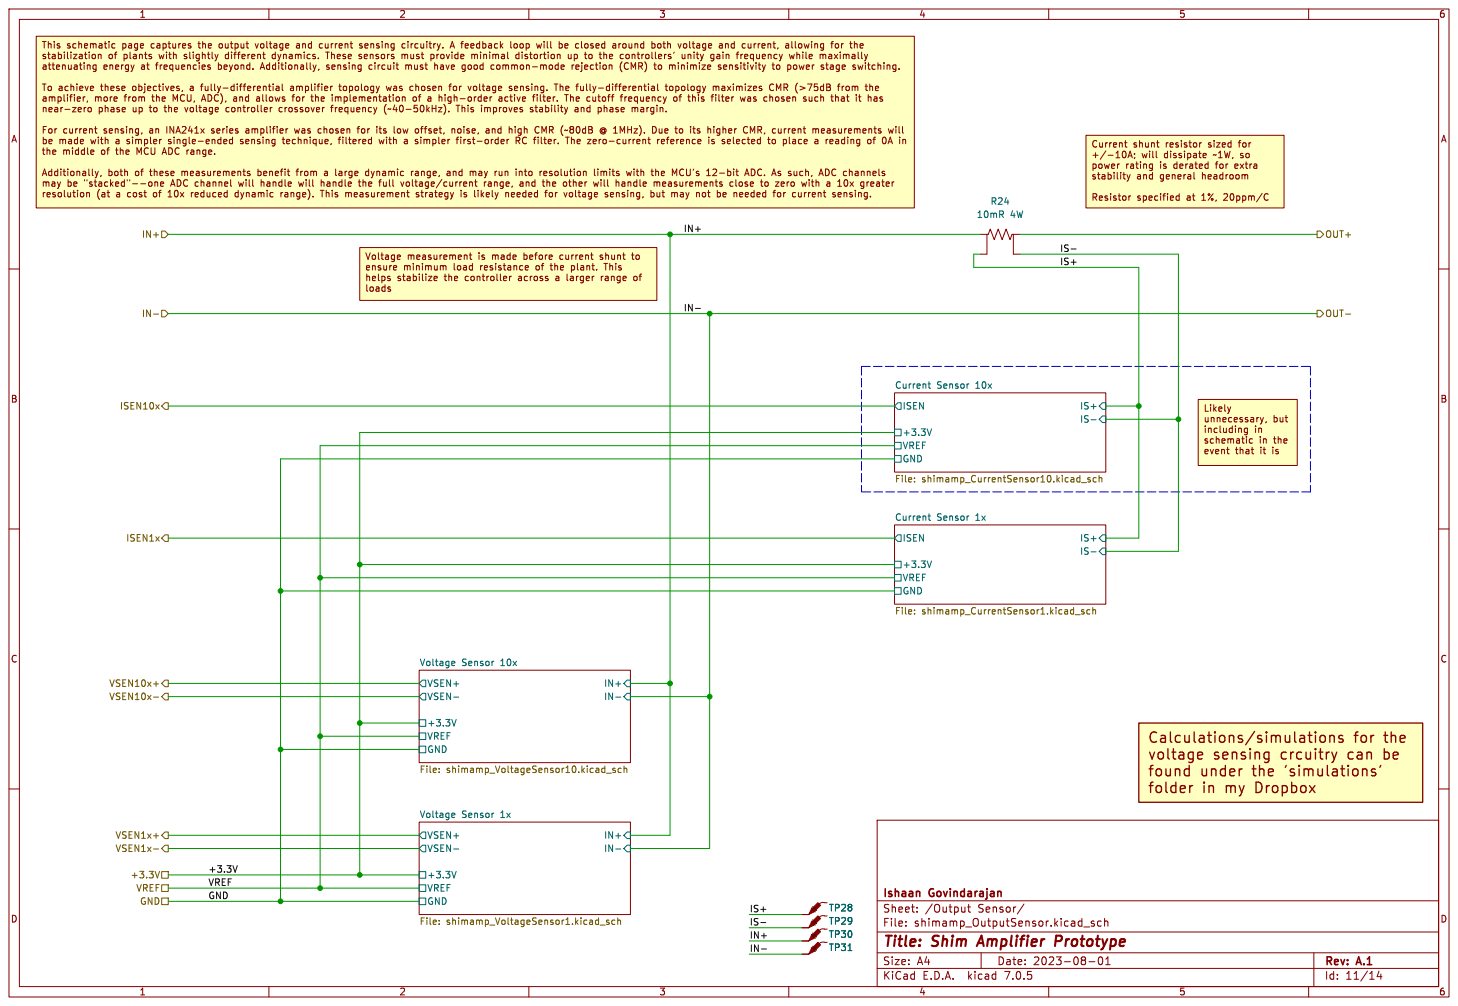
[picture p27: page 10]

power rating is derated for extra

Current Sensor 10x File: shimamp_CurrentSensor10.kicad_sch GND

event that it is

IS+ Current Sensor 1x File: shimamp_CurrentSensor1.kicad_sch VSEN- VSEN+

voltage sensing crcuitry can be
found under the 'simulations'
folder in my Dropbox

Id: 11/14 Title: Shim Amplifier Prototype

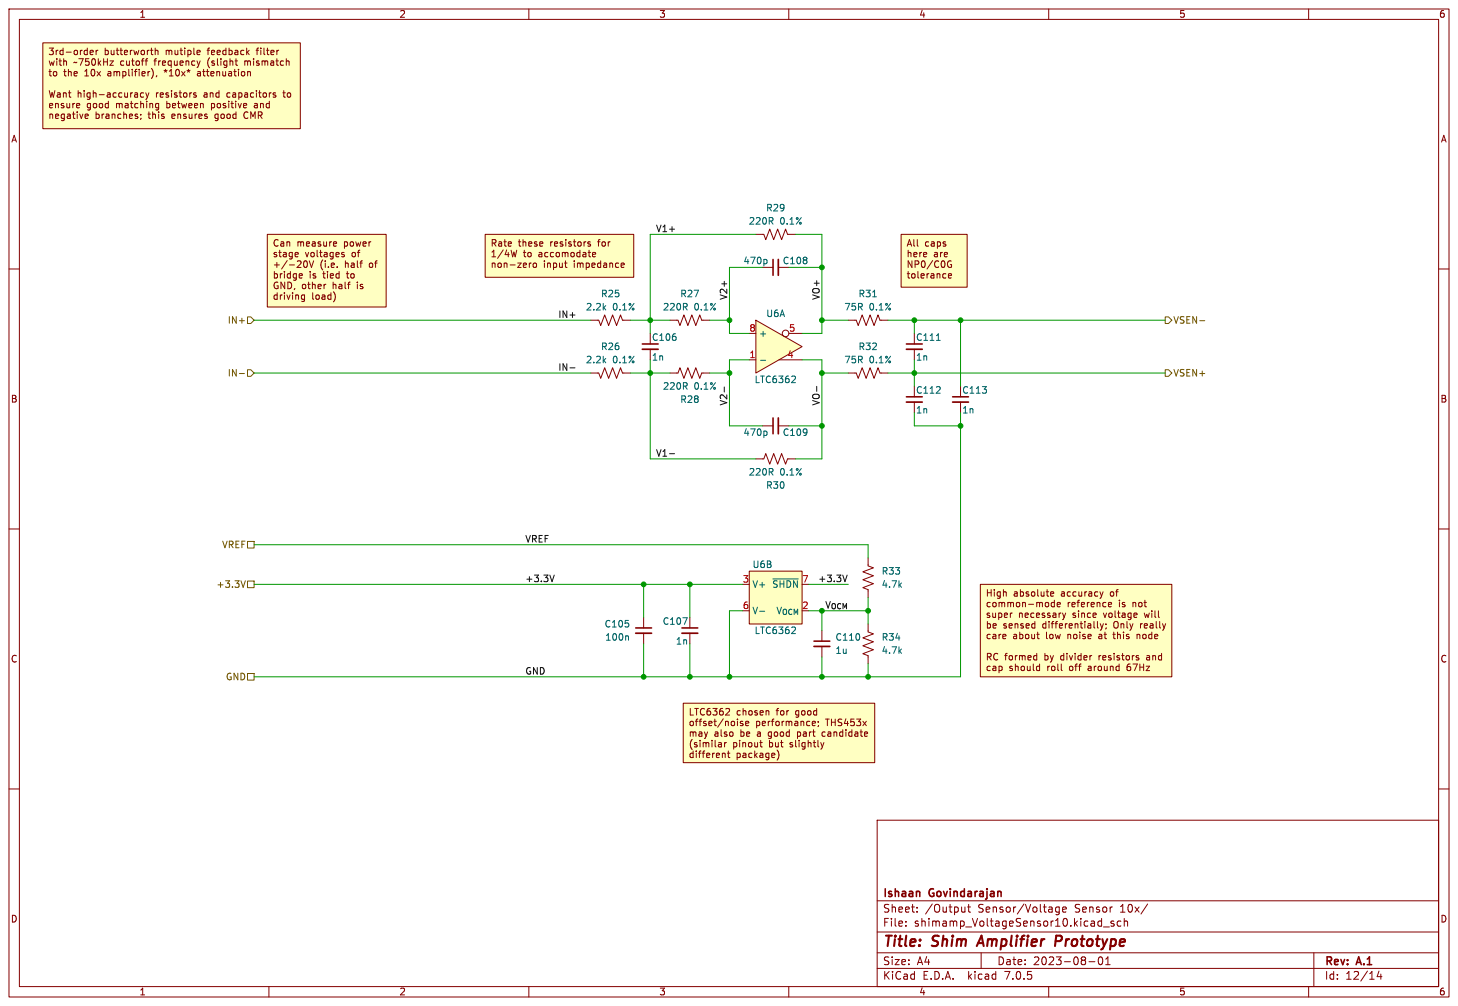
[picture p28: page 11]

cap should roll off around 67Hz LTC6362 chosen for good

Id: 12/14 Title: Shim Amplifier Prototype

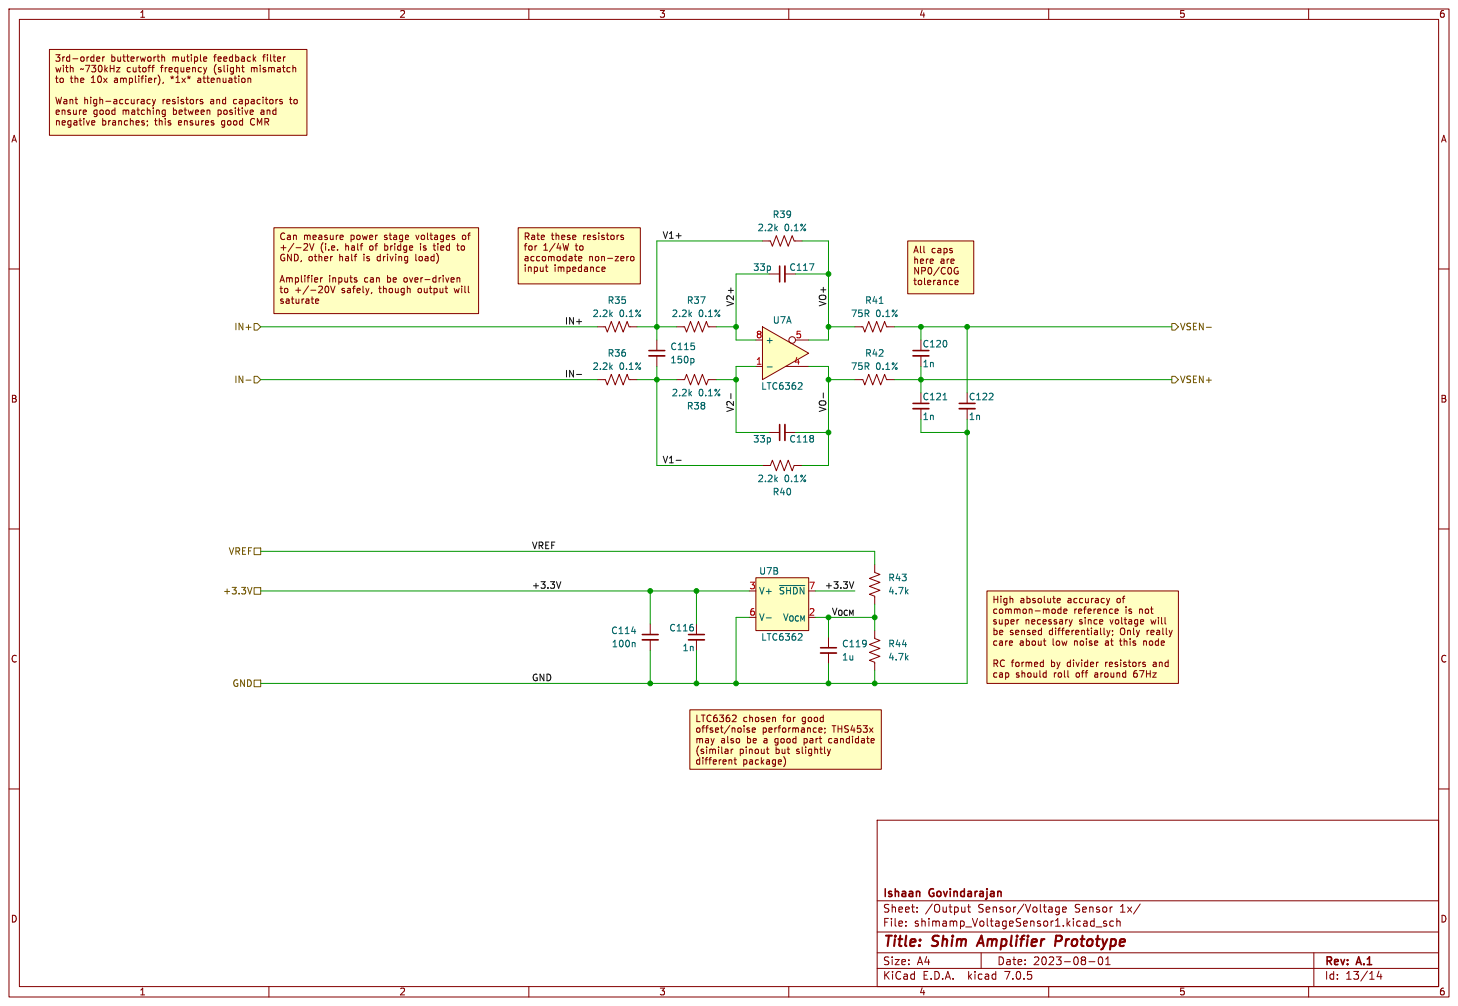
[picture p29: page 12]

cap should roll off around 67Hz All caps here are NP0/C0G

Id: 13/14 Title: Shim Amplifier Prototype

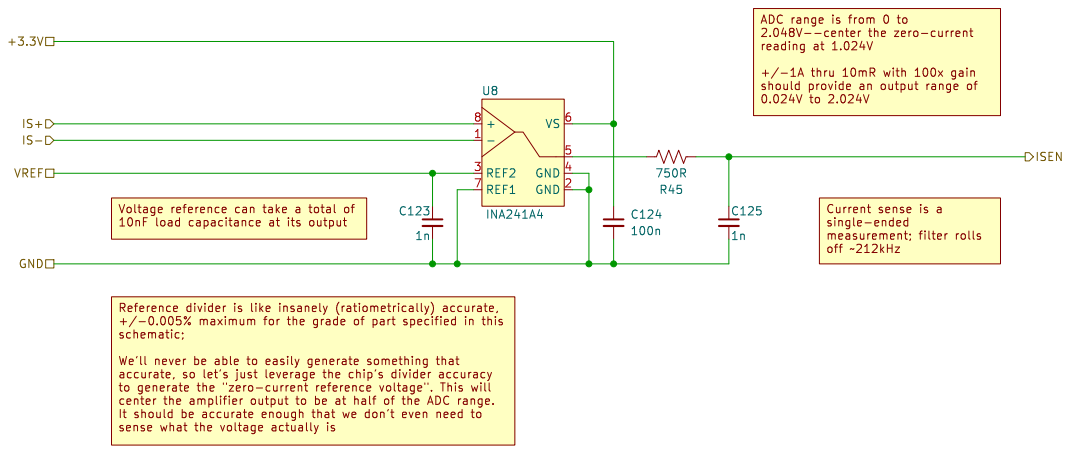
[picture p30: page 13]

should provide an output range of 0.024V to 2.024V

Id: 14/14 Title: Shim Amplifier Prototype

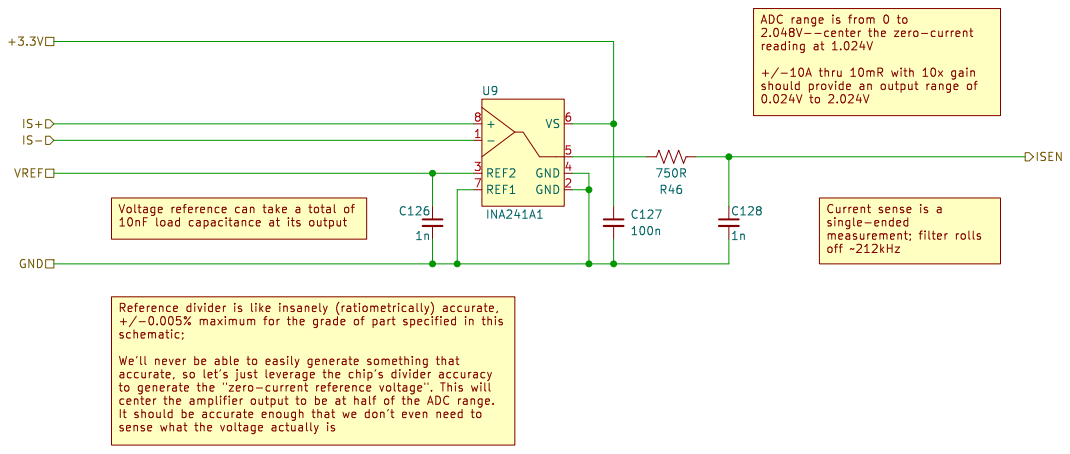
[picture p31: page 14]

ADC range is from 0 to
Ishaan Govindarajan C128

should provide an output range of 0.024V to 2.024V Current sense is a

Id: 15/14 Title: Shim Amplifier Prototype
