Govish/Shimamp-Hardware/Class-D Prototype revA/Class-D Prototype revA Schematic.pdf

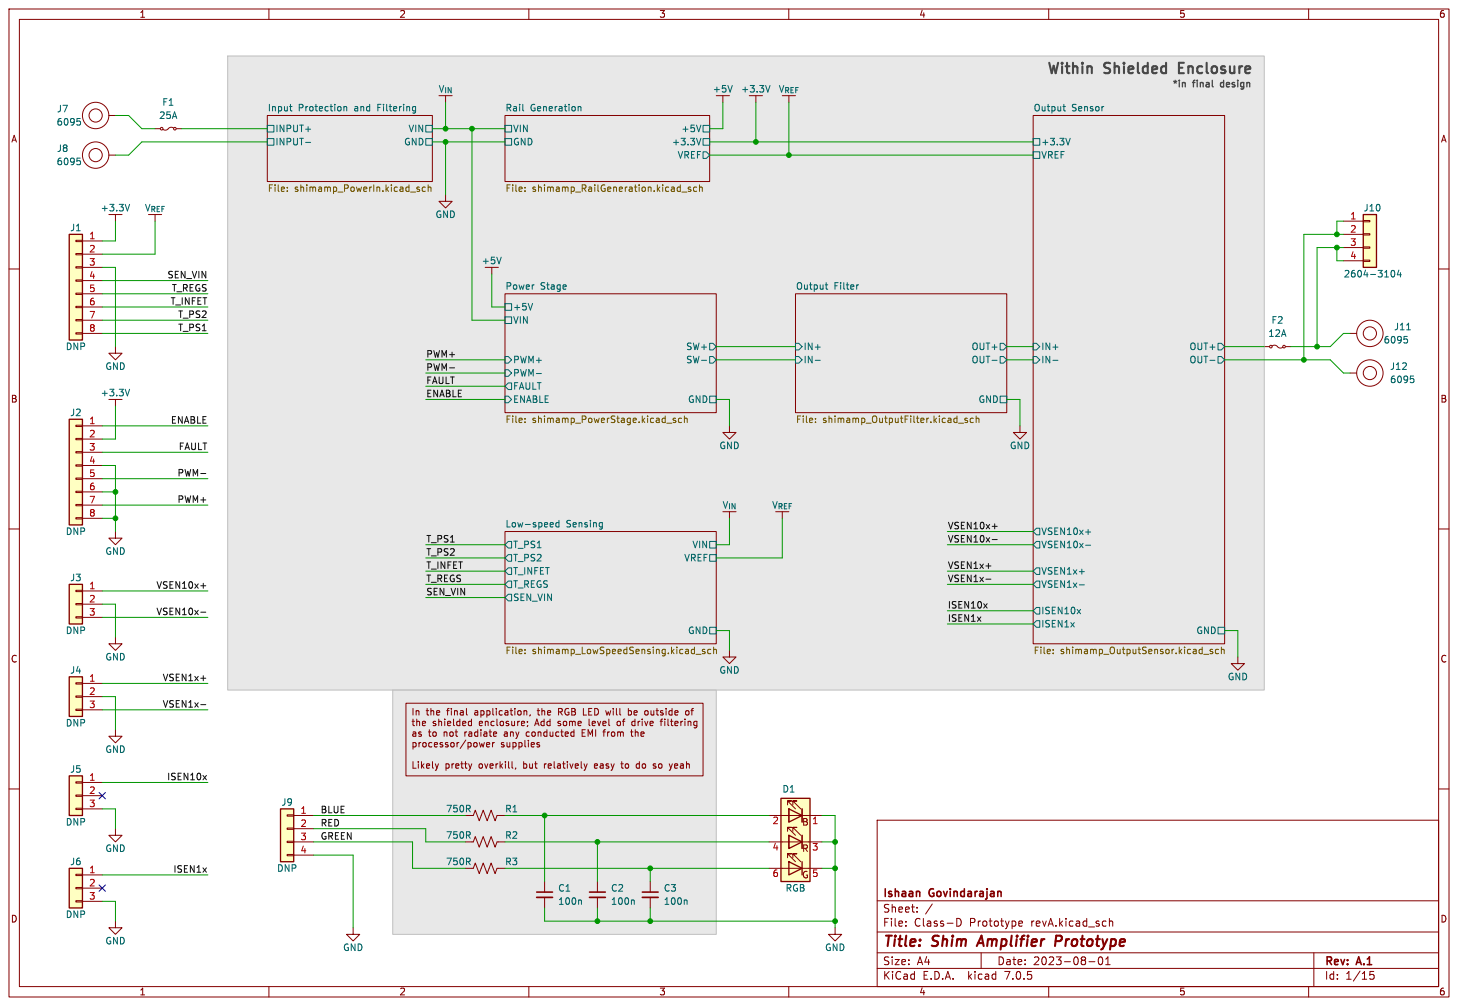
[picture p32: page 1]

VIN
SW- SW+ Power Stage File: shimamp_PowerStage.kicad_sch GND

Id: 1/15 Title: Shim Amplifier Prototype

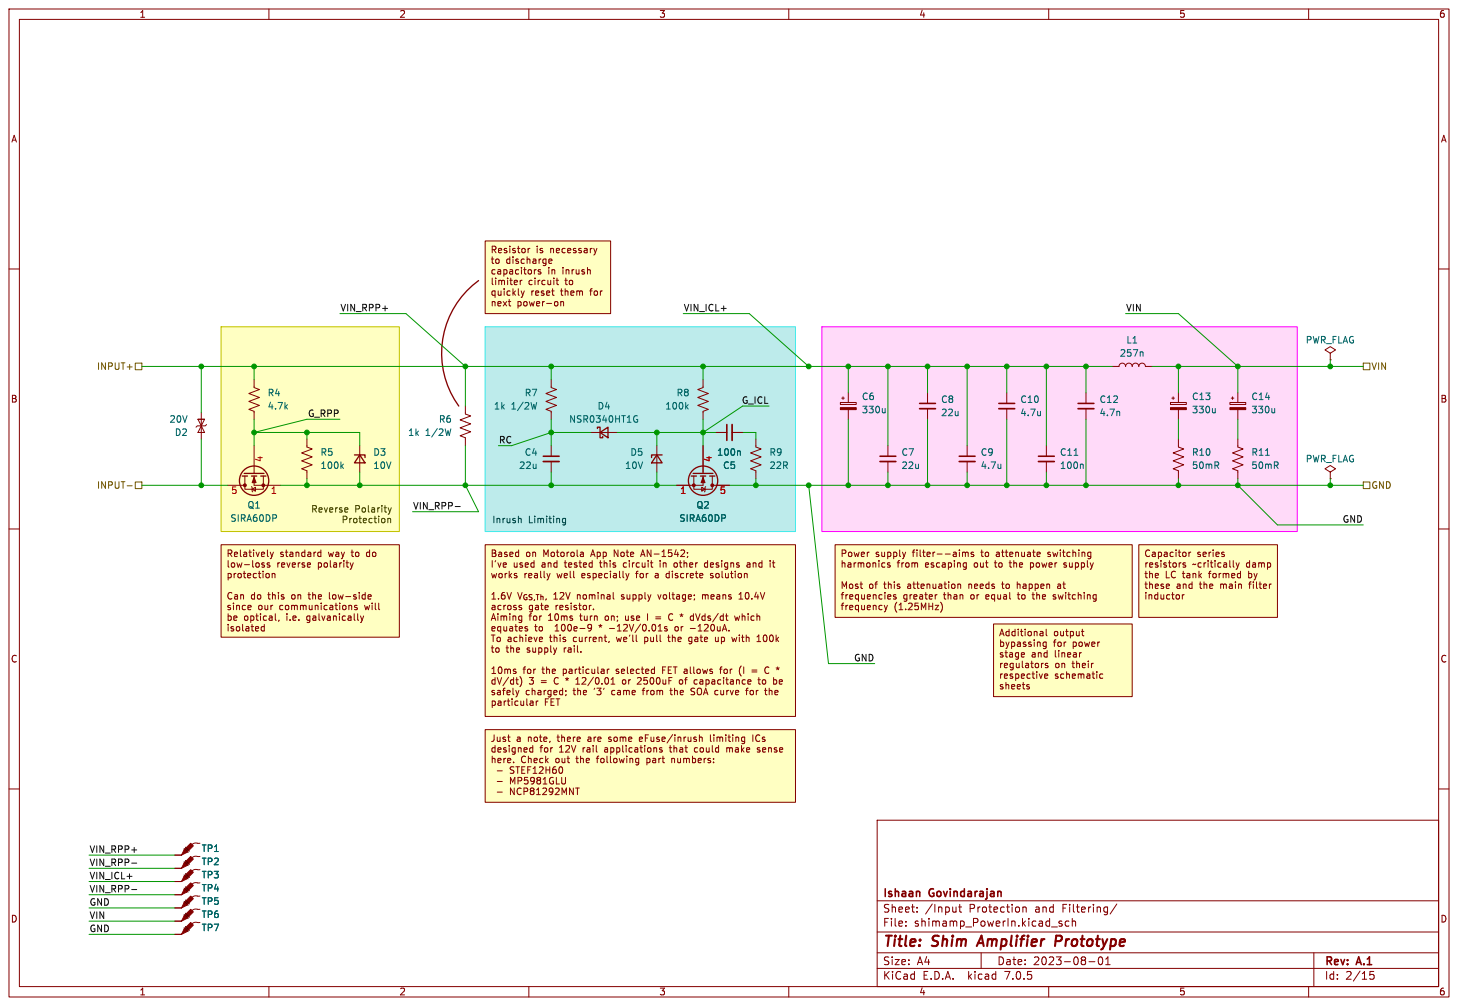
[picture p33: page 2]

protection Can do this on the low-side

the LC tank formed by
these and the main filter

1.6V V_{GS,Th}, 12V nominal supply voltage; means 10.4V

safely charged; the '3' came from the SOA curve for the

Ishaan Govindarajan
Id: 2/15 Title: Shim Amplifier Prototype

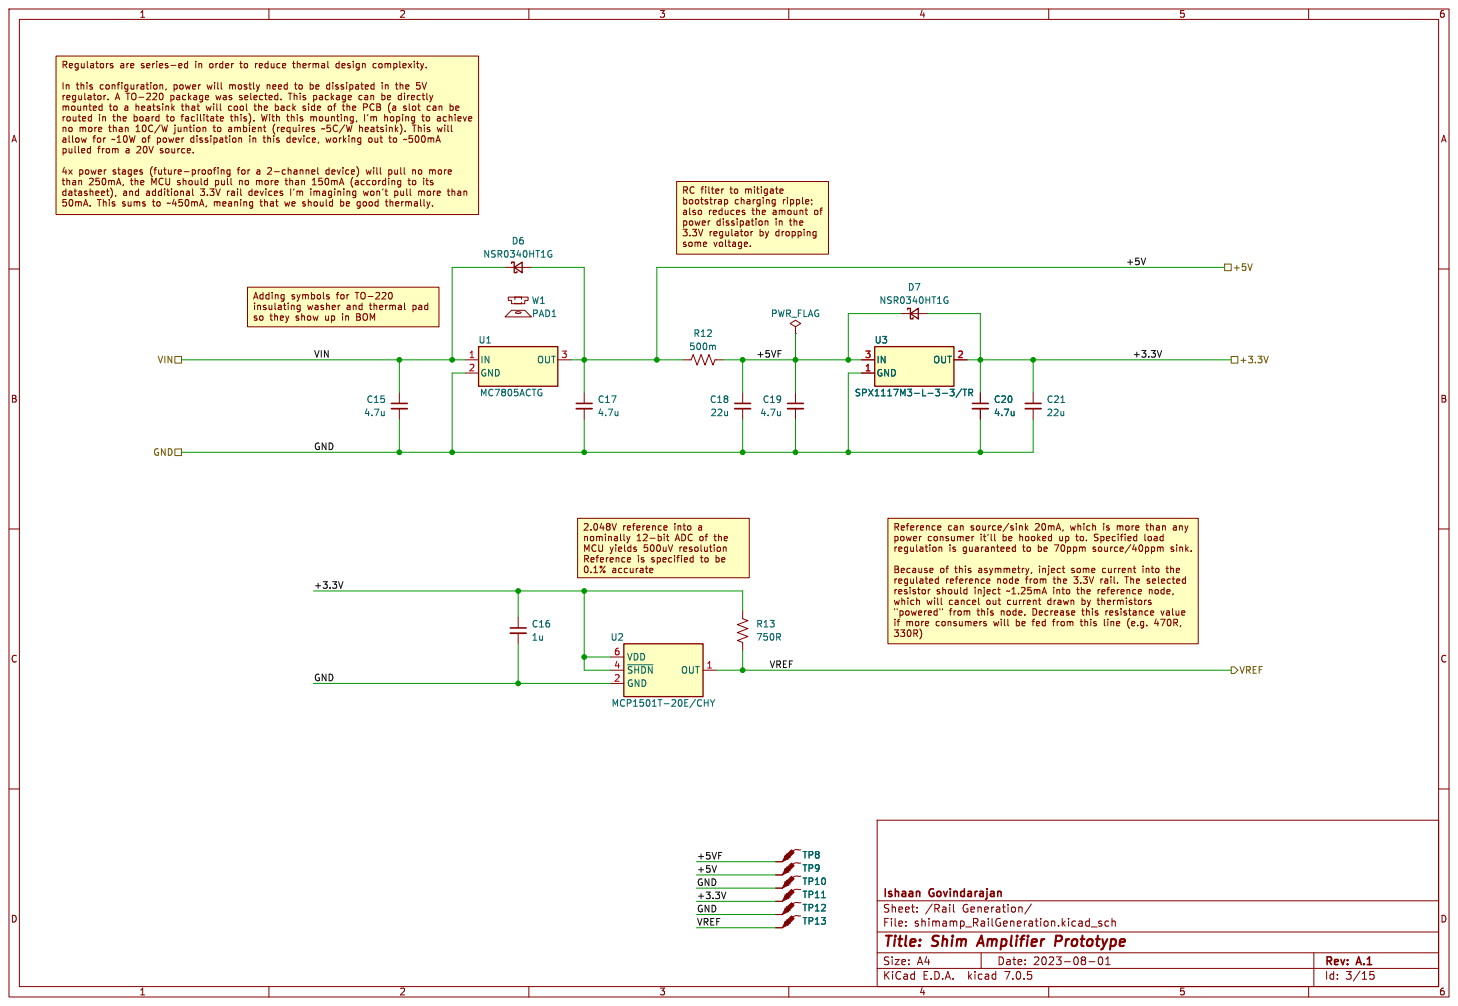
[picture p34: page 3]

Adding symbols for TO-220
so they show up in BOM

Ishaan Govindarajan
Id: 3/15 Title: Shim Amplifier Prototype

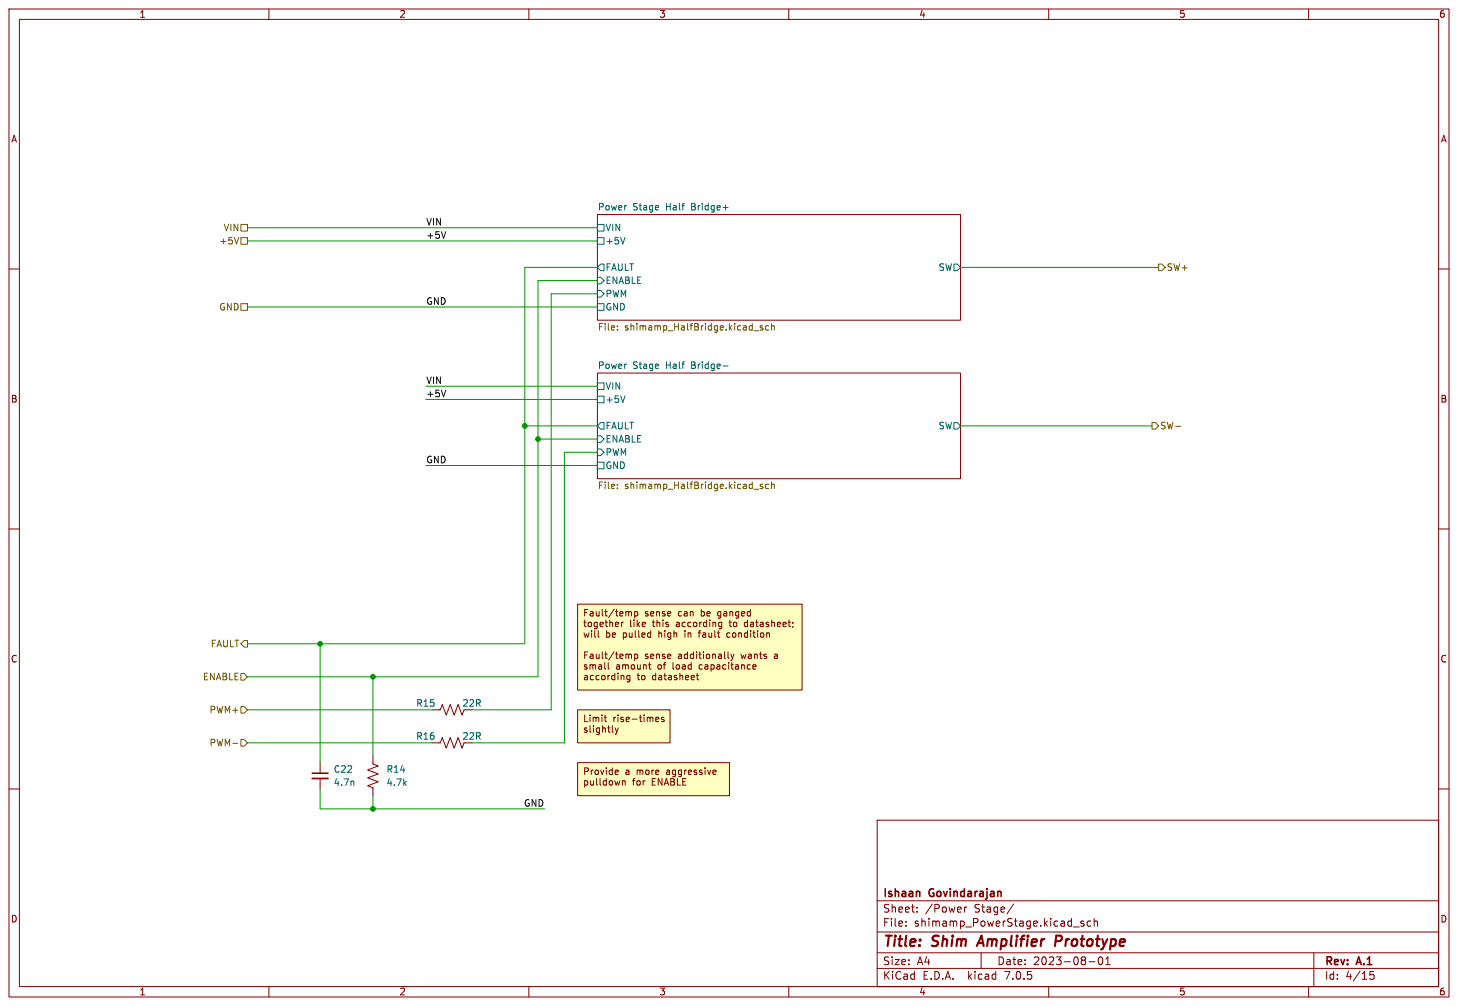
[picture p35: page 4]

Power Stage Half Bridge- File: shimamp_HalfBridge.kicad_sch GND

small amount of load capacitance

Id: 4/15 Title: Shim Amplifier Prototype

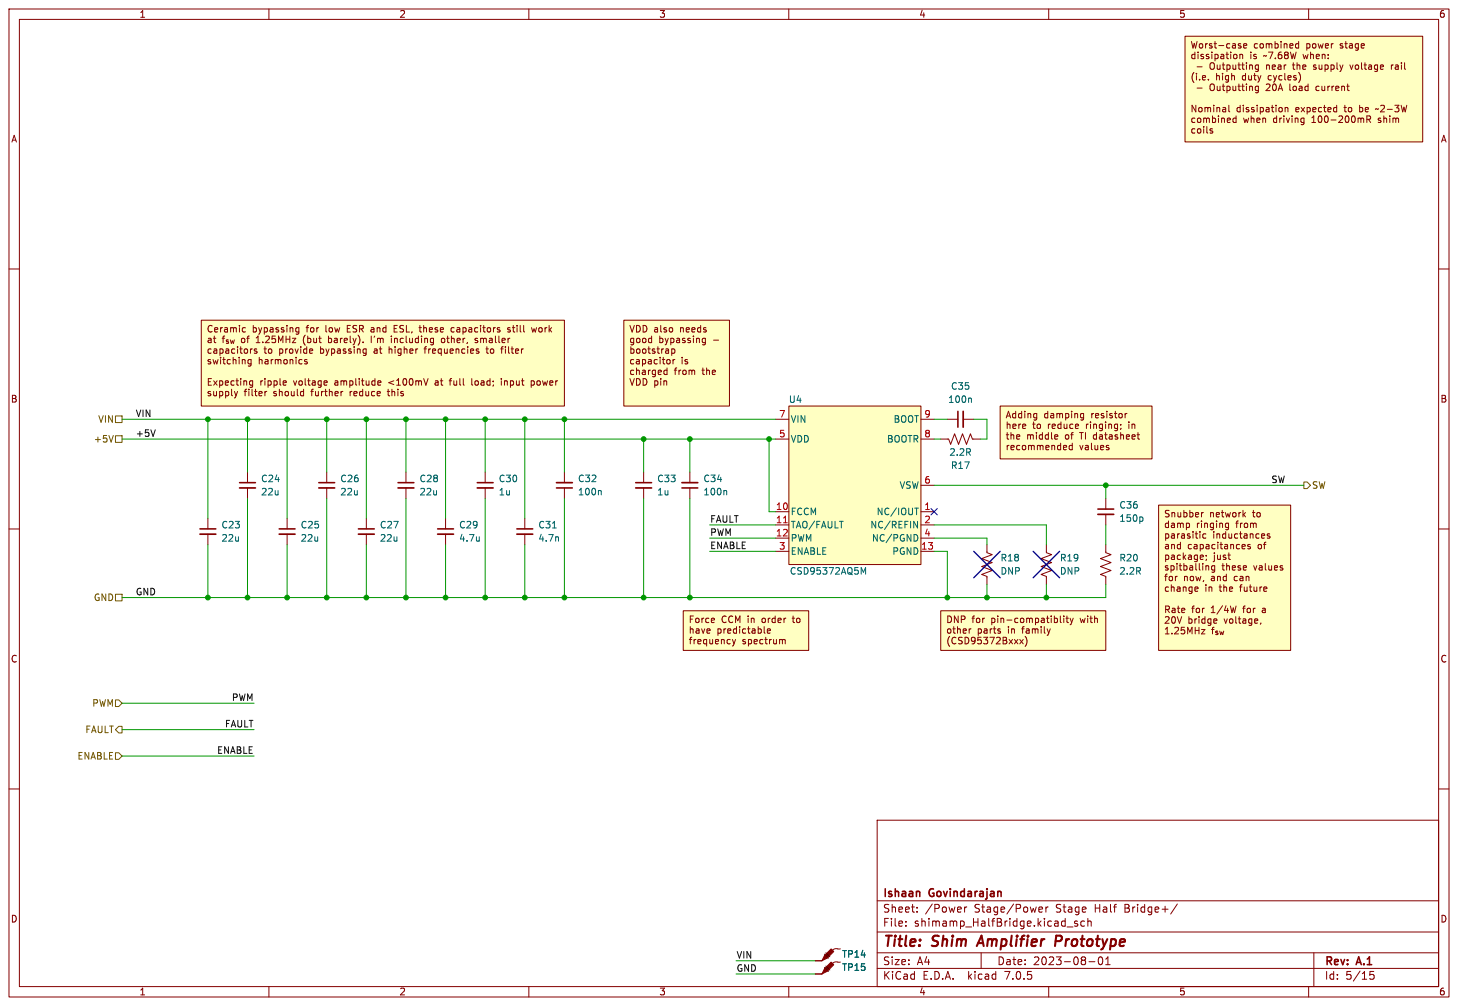
[picture p36: page 5]

coils Snubber network to

for now, and can
change in the future Rate for 1/4W for a

other parts in family
(CSD95372Bxxx)

Ishaan Govindarajan
Id: 5/15 Title: Shim Amplifier Prototype

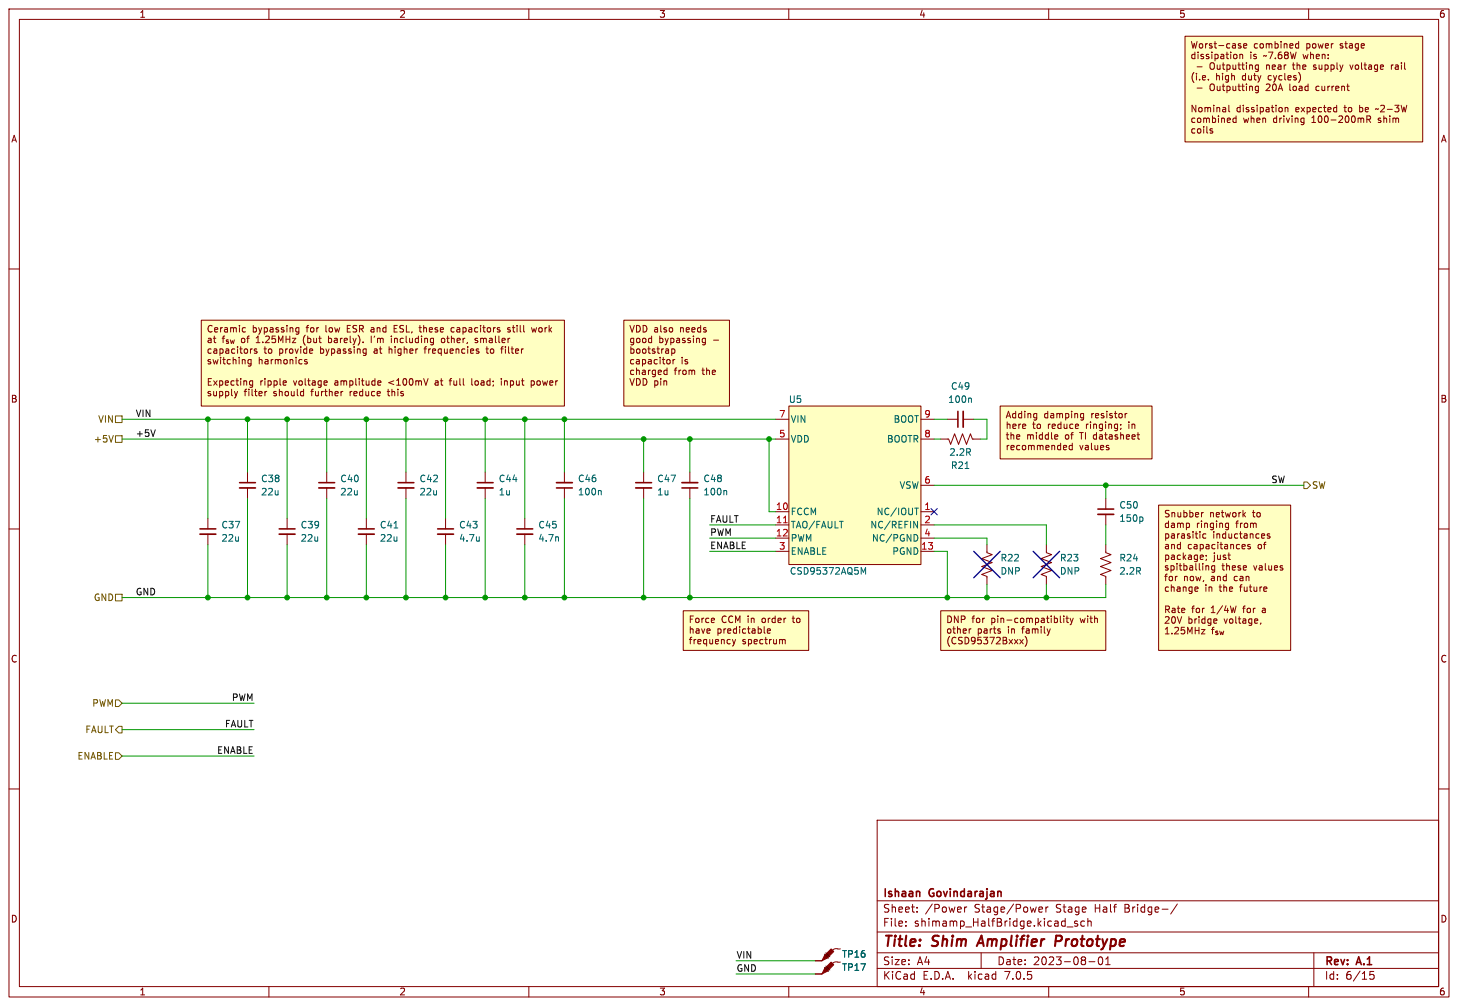
[picture p37: page 6]

coils Snubber network to

for now, and can
change in the future Rate for 1/4W for a

other parts in family
(CSD95372Bxxx)

Ishaan Govindarajan
Id: 6/15 Title: Shim Amplifier Prototype

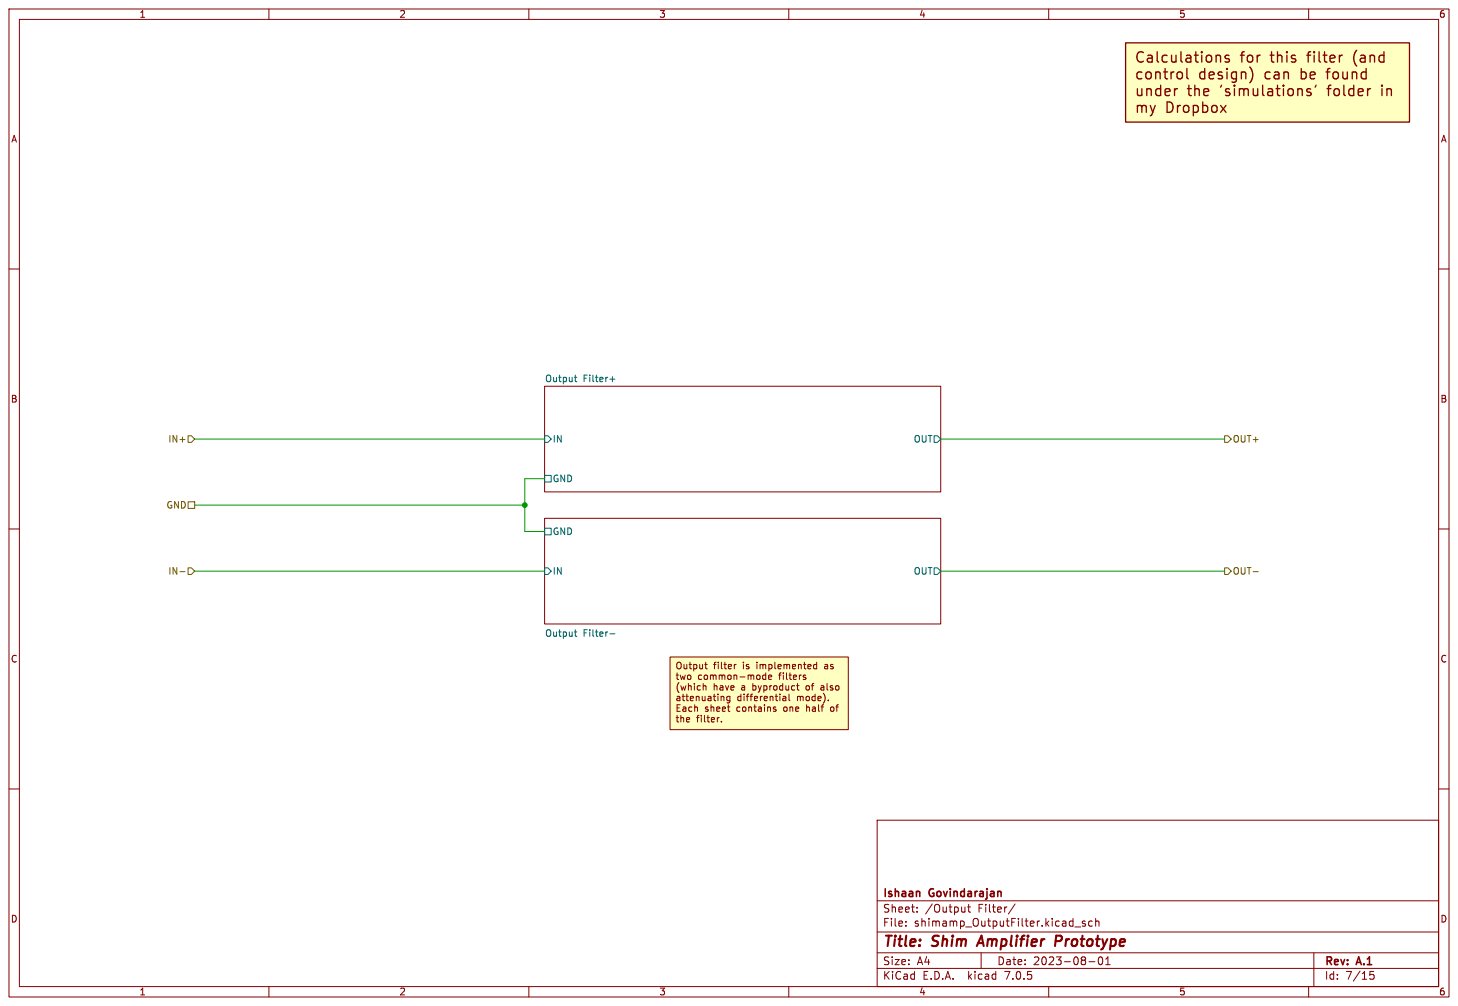
[picture p38: page 7]

Ishaan Govindarajan
Id: 7/15 Title: Shim Amplifier Prototype

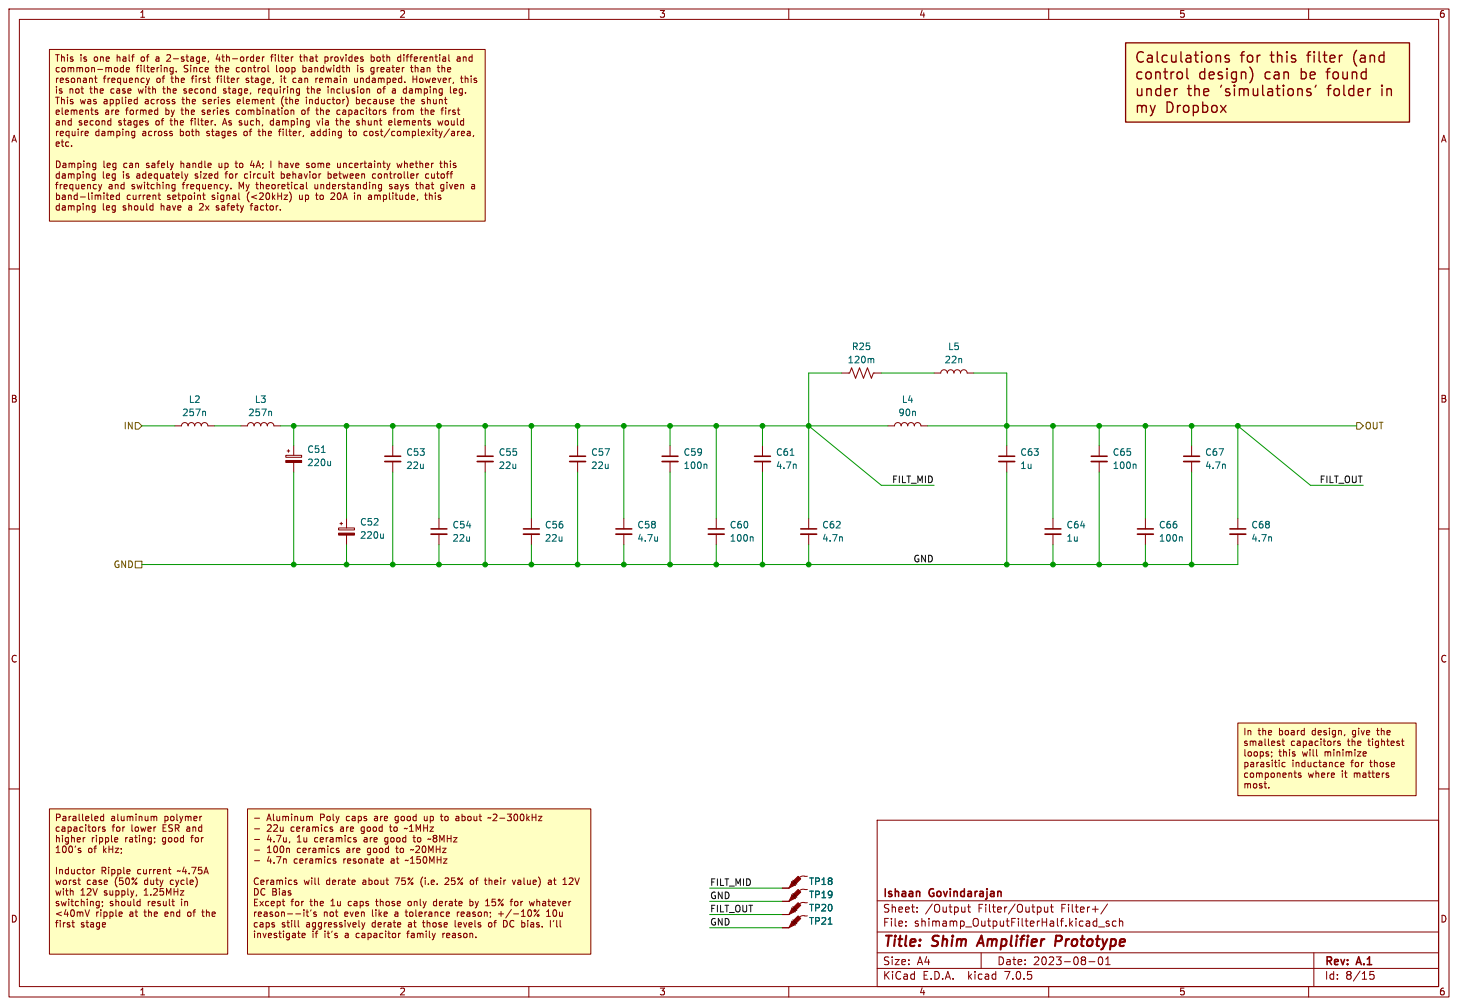
[picture p39: page 8]

control design) can be found
my Dropbox

In the board design, give the
loops; this will minimize

higher ripple rating; good for 100's of kHz;

- Aluminum Poly caps are good up to about ~2-300kHz

Ishaan Govindarajan
Id: 8/15 Title: Shim Amplifier Prototype

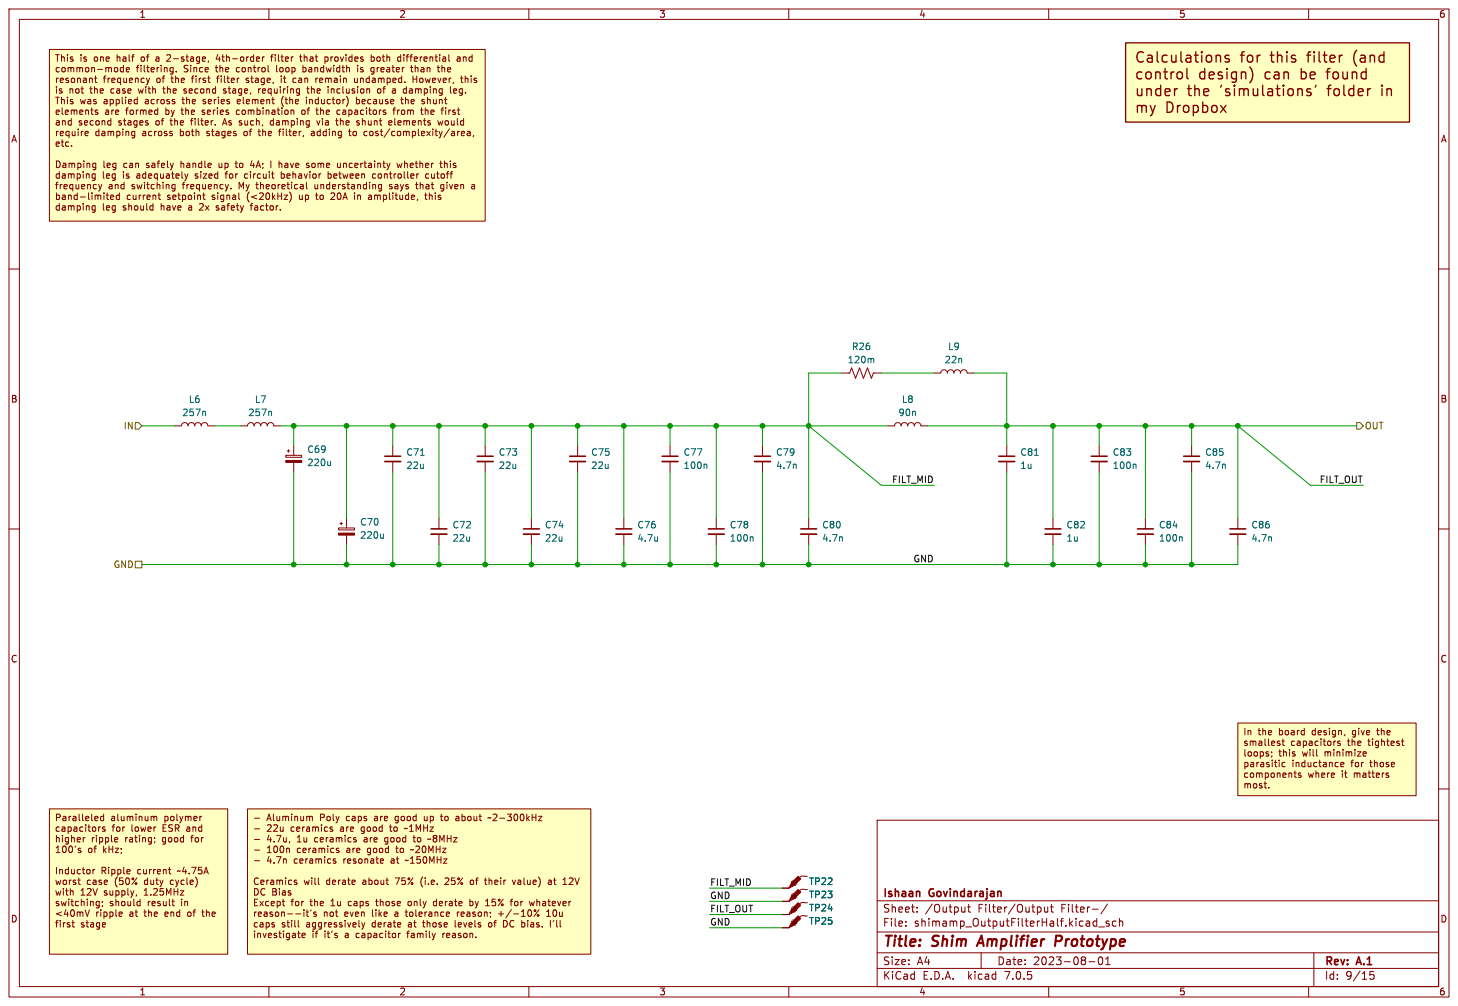
[picture p40: page 9]

control design) can be found
my Dropbox

In the board design, give the
loops; this will minimize

higher ripple rating; good for 100's of kHz;

- Aluminum Poly caps are good up to about ~2-300kHz

Ishaan Govindarajan
Id: 9/15 Title: Shim Amplifier Prototype

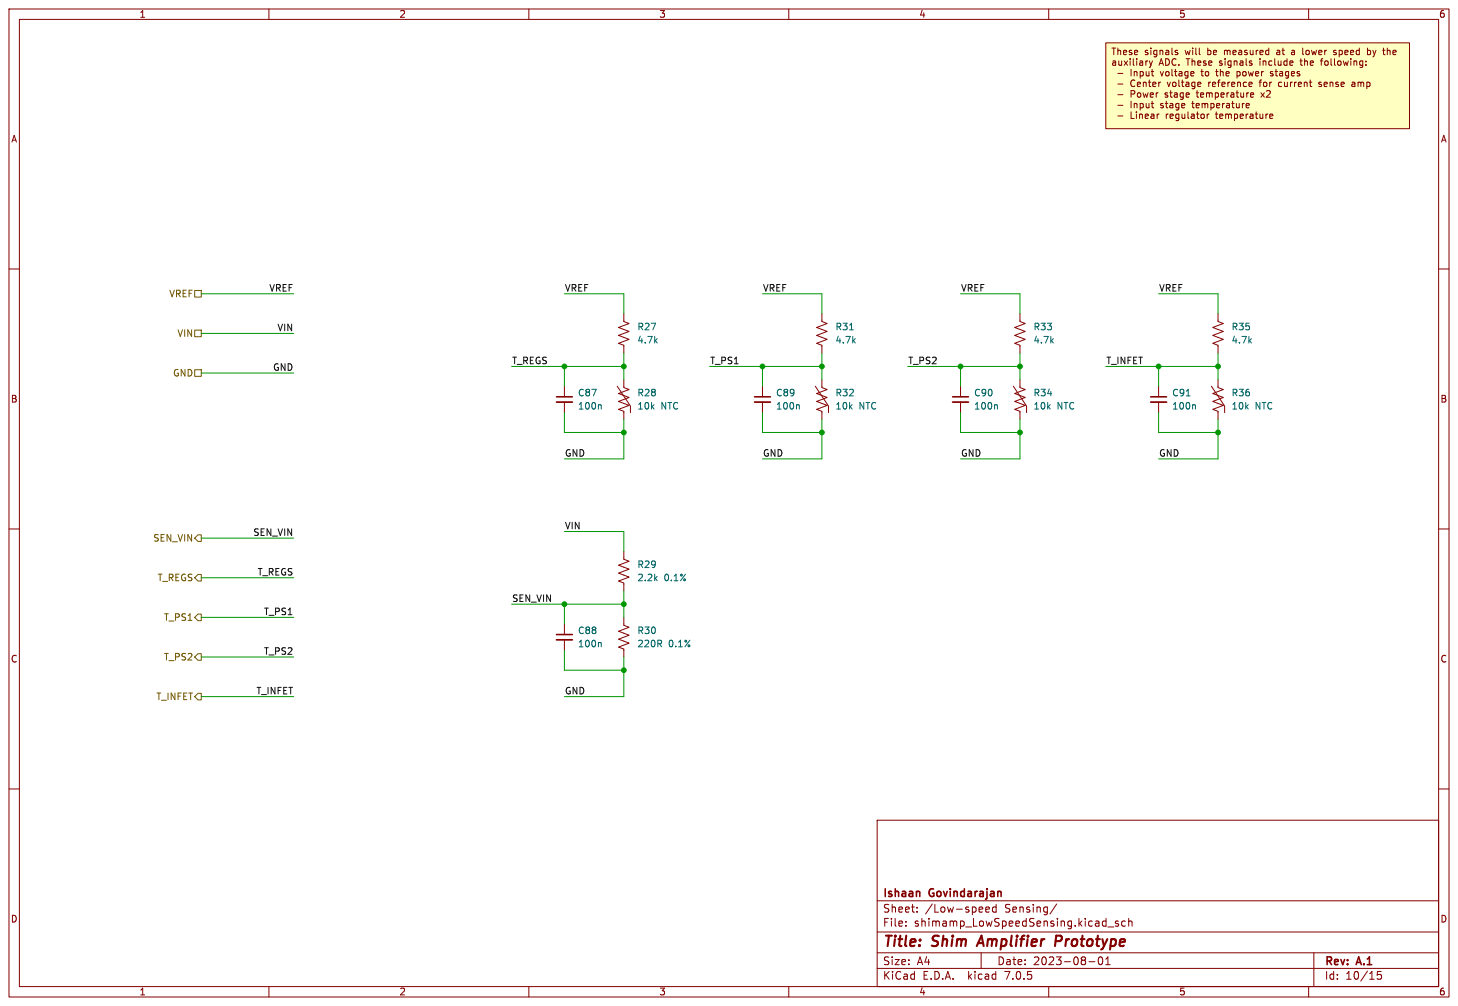
[picture p41: page 10]

These signals will be measured at a lower speed by the

Ishaan Govindarajan
Id: 10/15 Title: Shim Amplifier Prototype

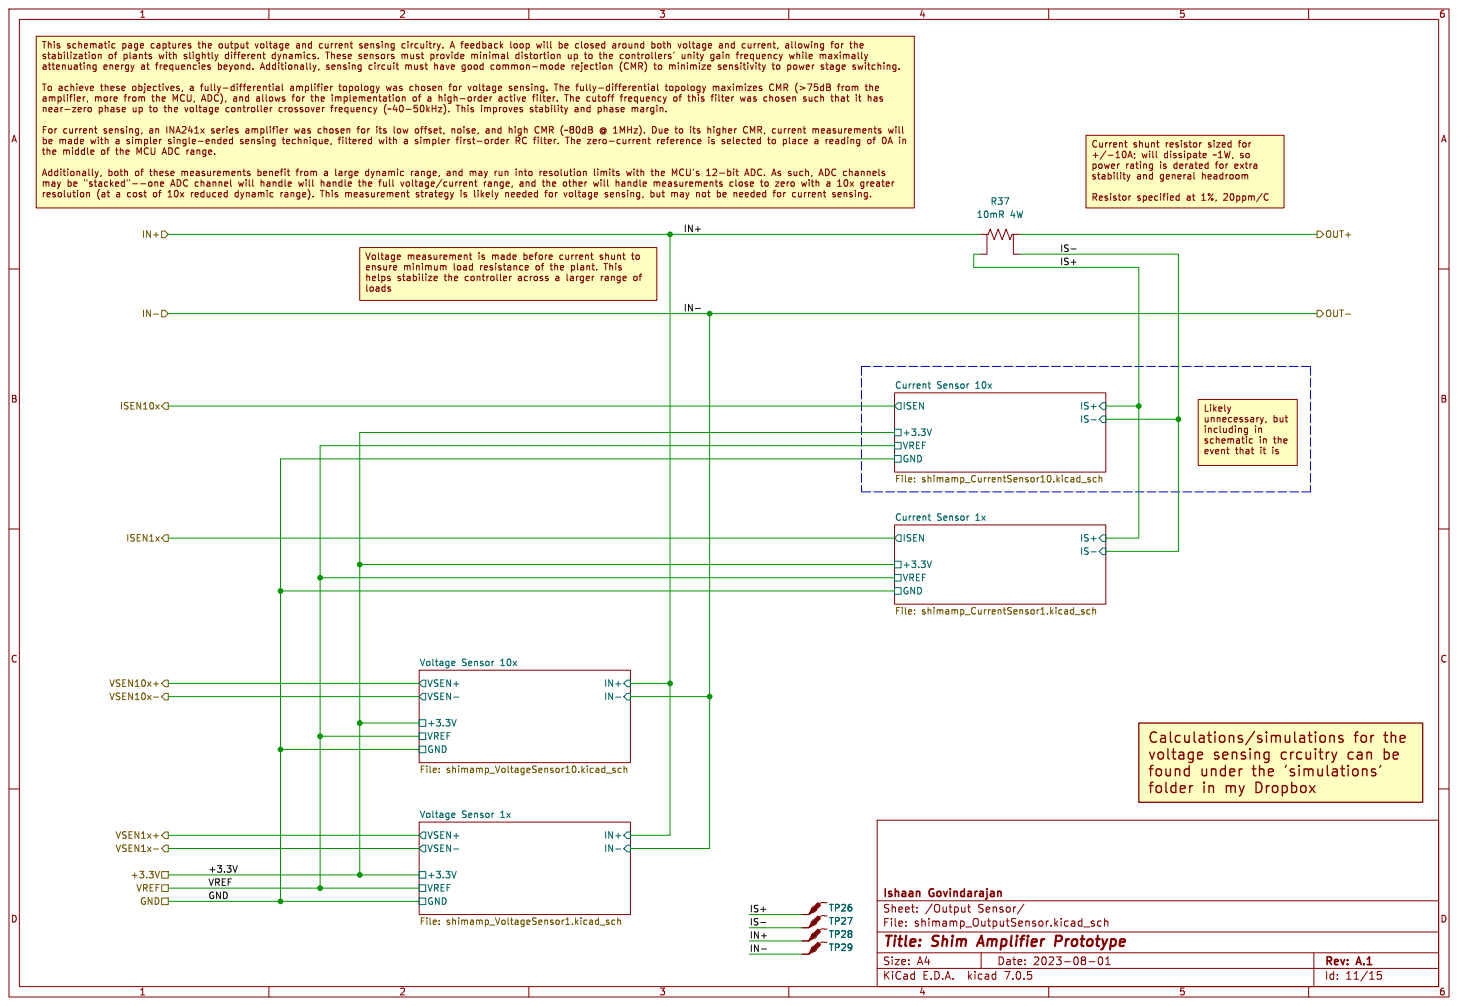
[picture p42: page 11]

power rating is derated for extra

Current Sensor 10x File: shimamp_CurrentSensor10.kicad_sch GND

event that it is

IS+ Current Sensor 1x File: shimamp_CurrentSensor1.kicad_sch VSEN- VSEN+

voltage sensing crcuitry can be
found under the 'simulations'
folder in my Dropbox

Id: 11/15 Title: Shim Amplifier Prototype

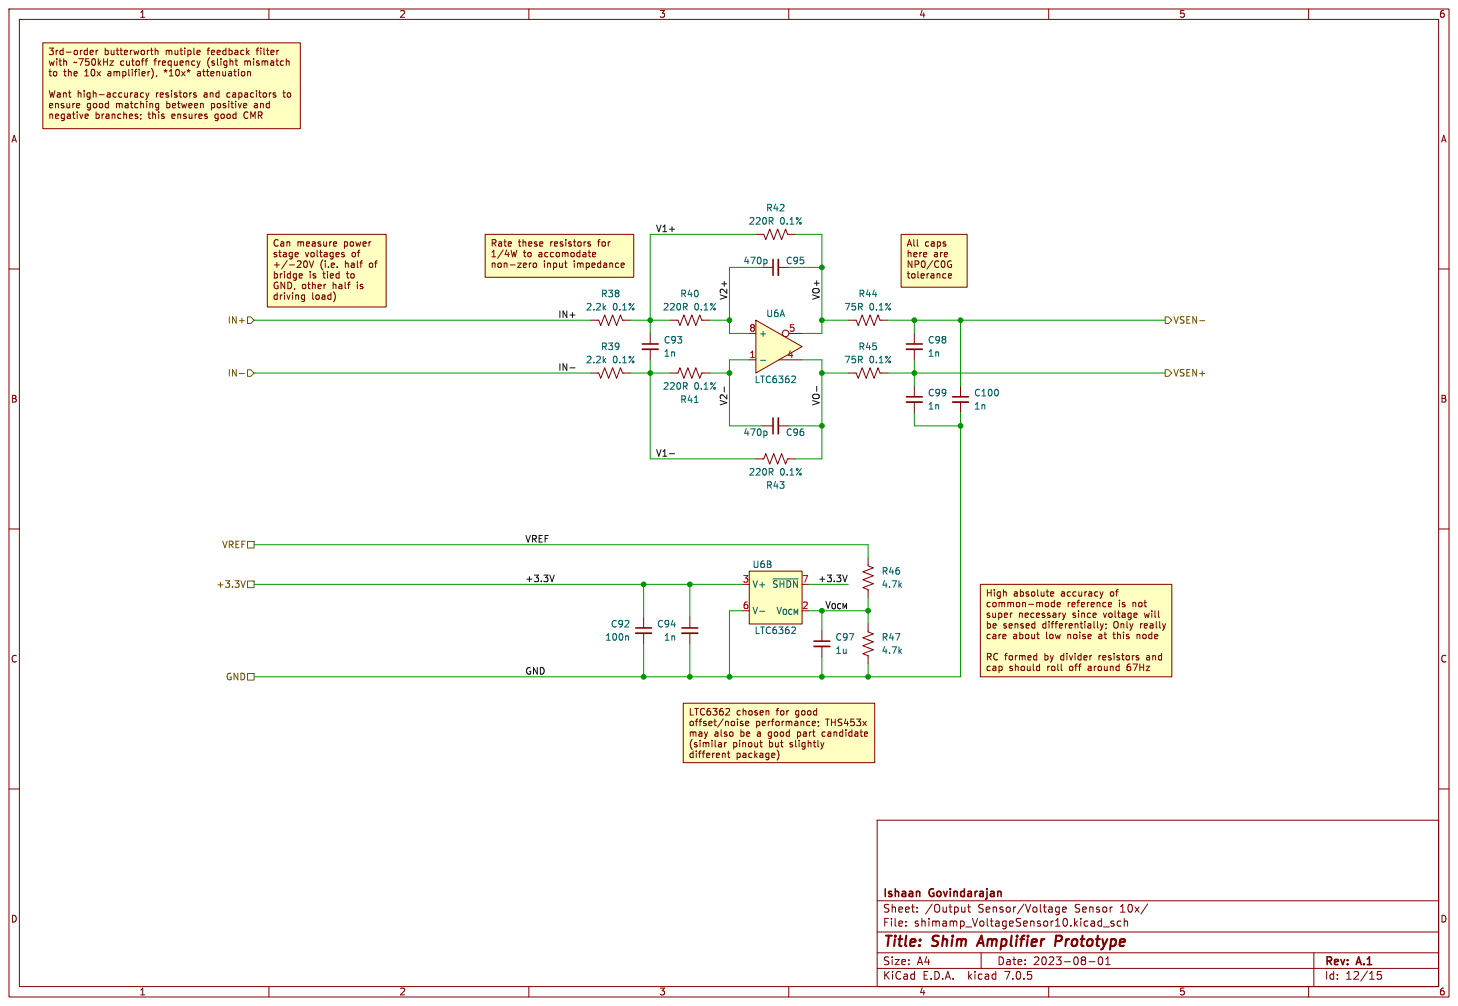
[picture p43: page 12]

cap should roll off around 67Hz LTC6362 chosen for good

Id: 12/15 Title: Shim Amplifier Prototype

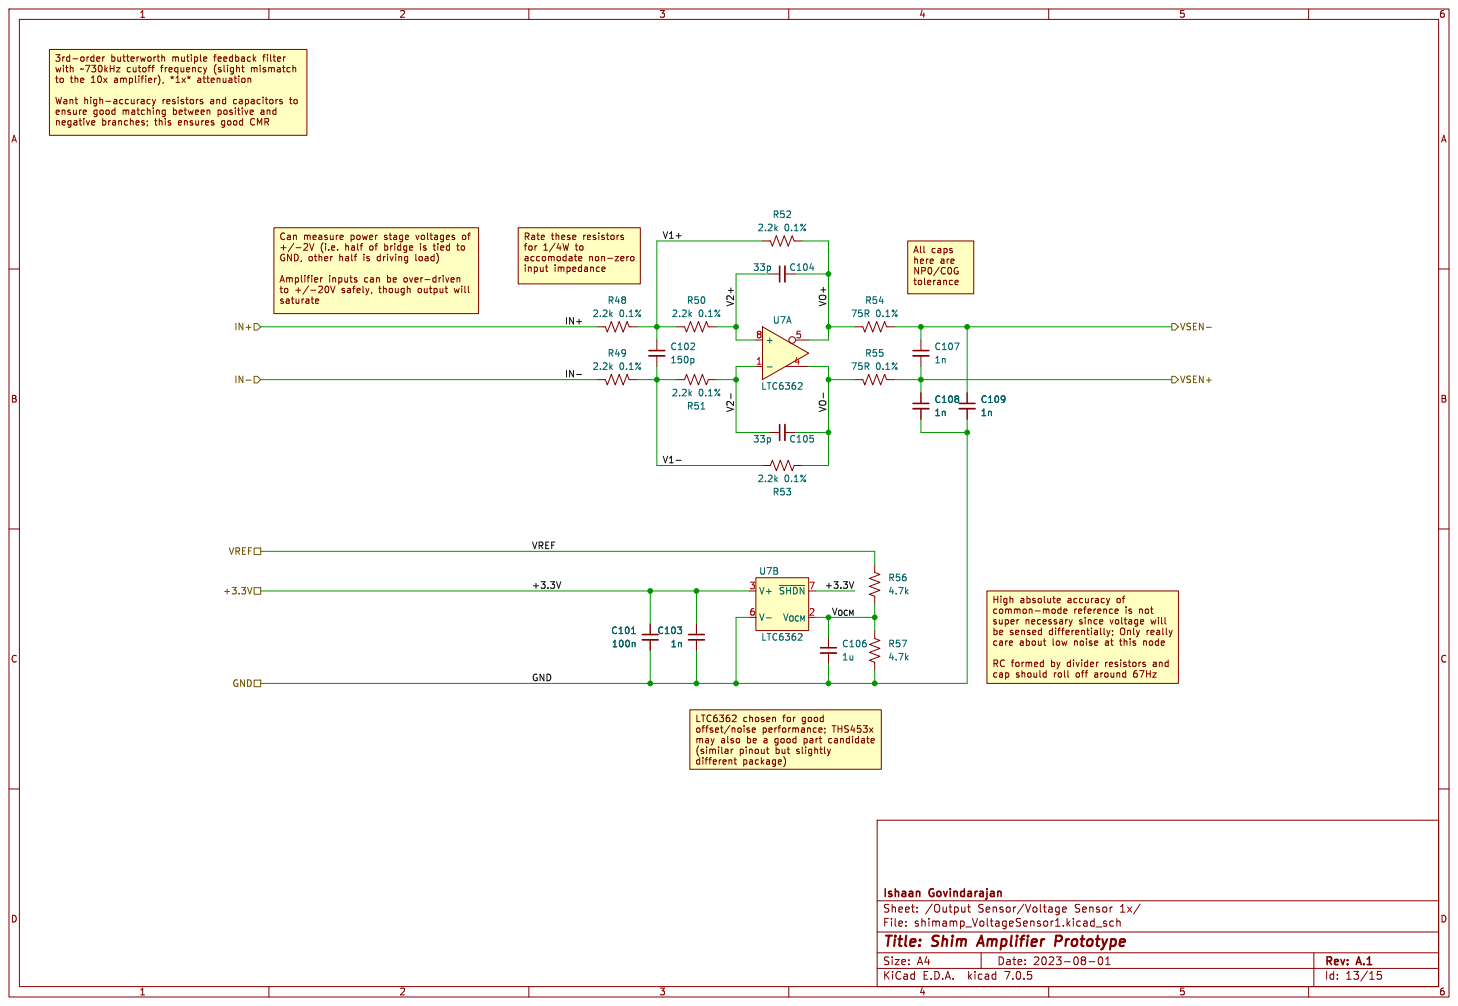
[picture p44: page 13]

All caps here are NP0/C0G

cap should roll off around 67Hz LTC6362 chosen for good

Ishaan Govindarajan
Id: 13/15 Title: Shim Amplifier Prototype

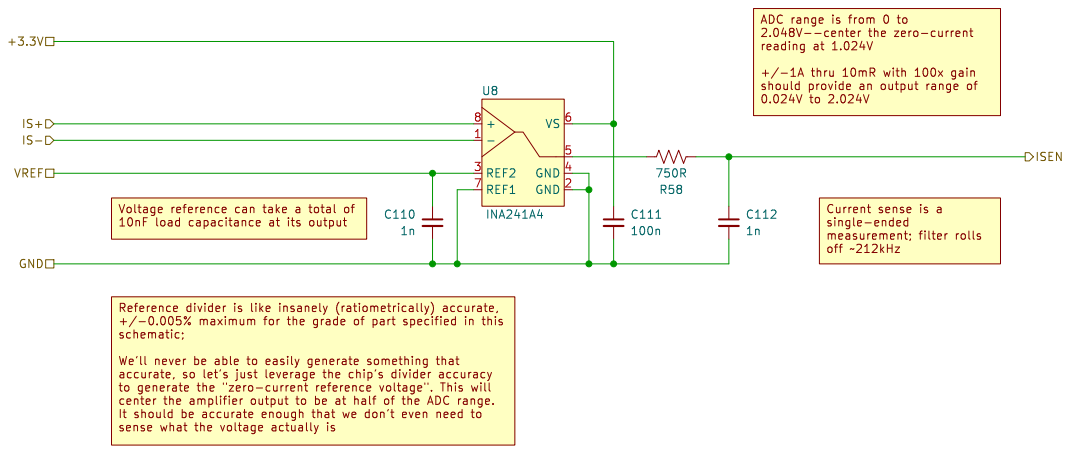
[picture p45: page 14]

should provide an output range of 0.024V to 2.024V

Id: 14/15 Title: Shim Amplifier Prototype

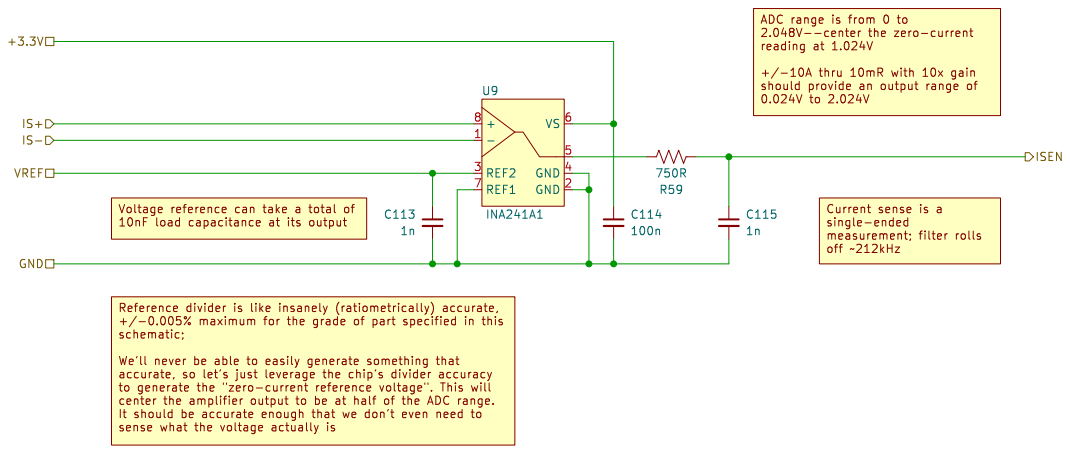
[picture p46: page 15]

should provide an output range of 0.024V to 2.024V

Id: 15/15 Title: Shim Amplifier Prototype
