Govish/Shimamp-Hardware/Class-D Prototype revB/Class-D Prototype RevB/Class-D Prototype RevB.kicad_pcb

## KiCad design Class-D Prototype revB/Class-D Prototype RevB/Class-D Prototype RevB.kicad_pcb (2023-11-08)

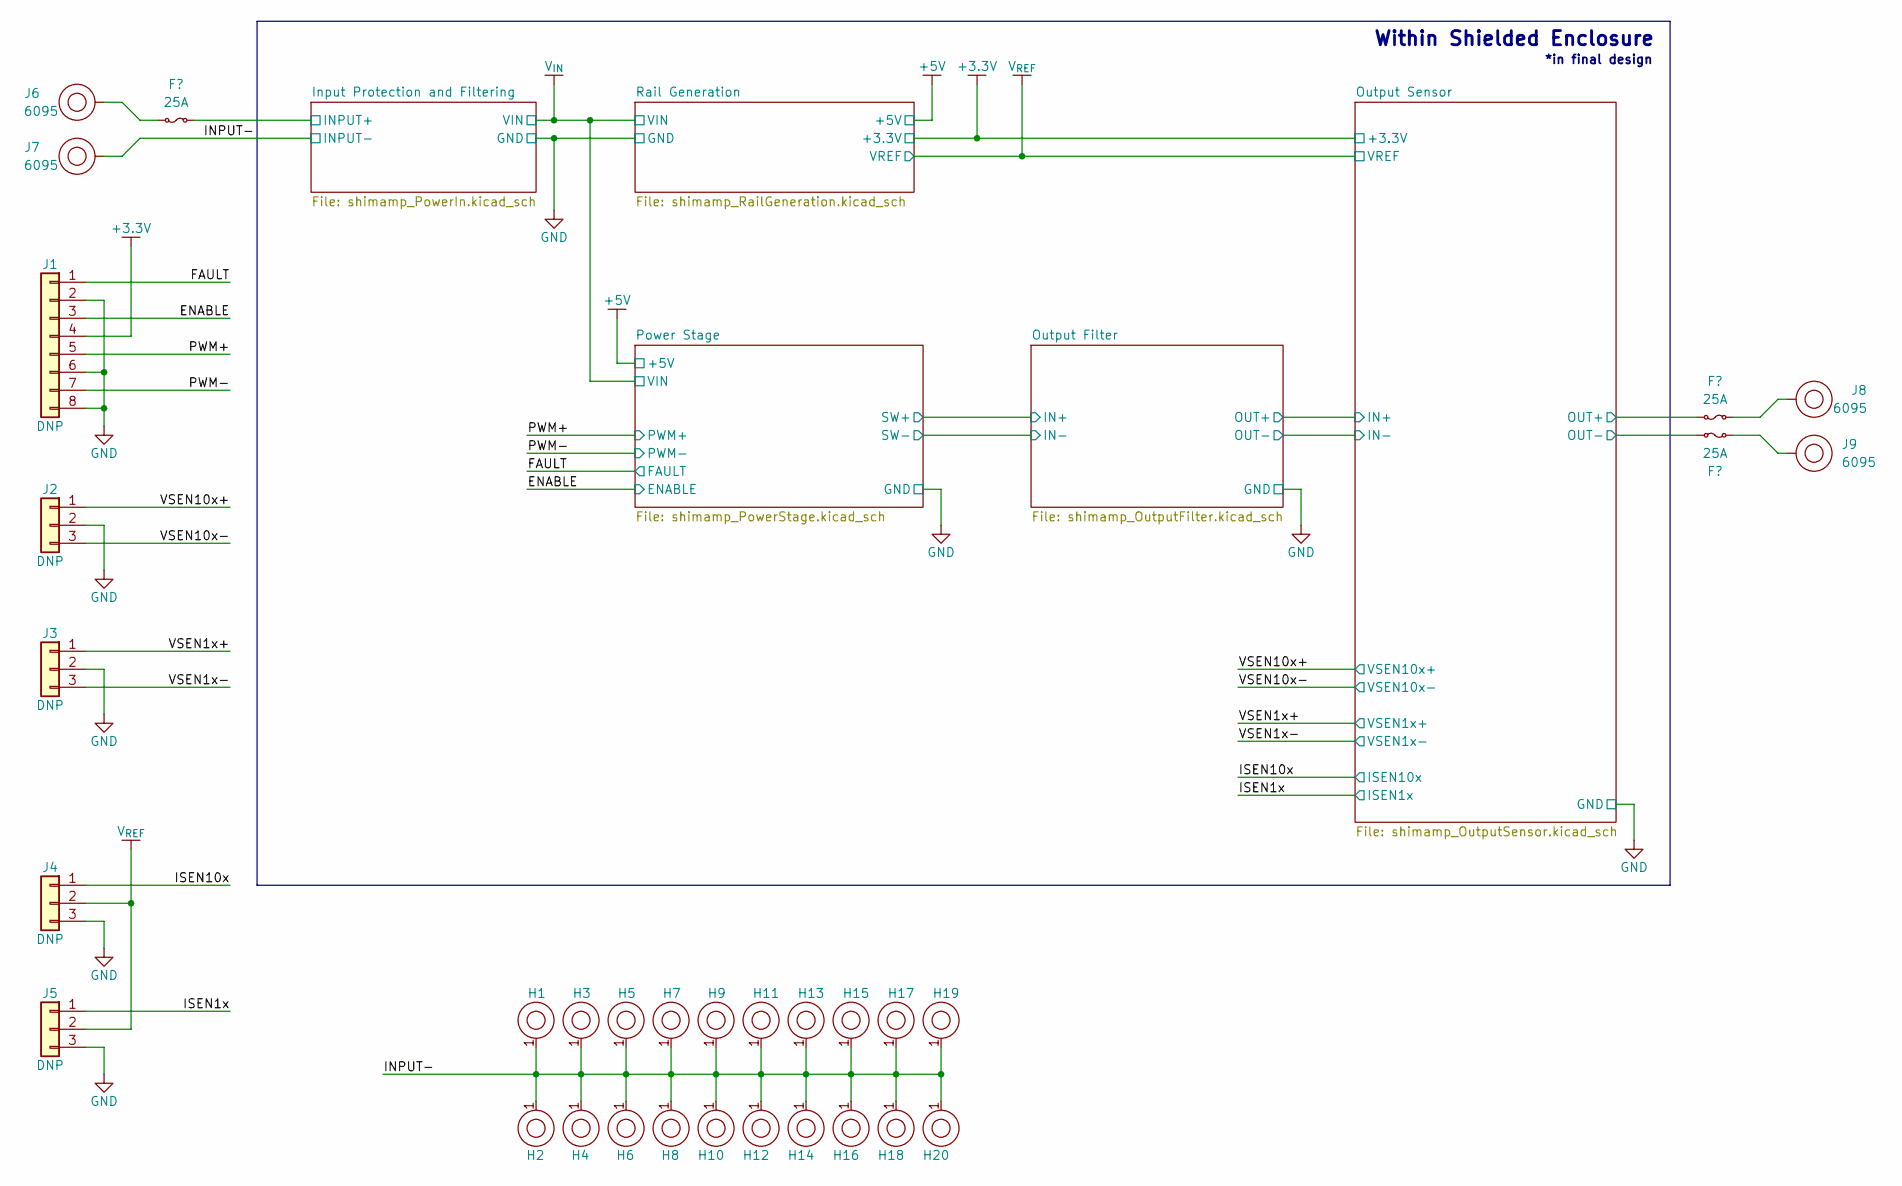
[picture p47: schematic Class-D Prototype RevB.kicad_sch, Shim Amplifier Prototype]

Parts:
F1, F2, F3: 25A; Fuse_1206_3216Metric_Pad1.42x1.75mm_HandSolder; Part Number 0685H9250-01
H1, H2, H3, H4, H5, H6, H7, H8, H9, H10, H11, H12, H13, H14, H15, H16, H17, H18, H19, H20: MountingHole-3mm_small_annulus
J1: DNP; PinHeader_1x08_P2.54mm_Vertical
J2, J3, J4, J5: DNP; PinHeader_1x03_P2.54mm_Vertical
J6, J7, J8, J9: 6095; Keystone 6095; Part Number 6095

Connections:
+3.3V: J1.4; also elsewhere on the board
/ENABLE: J1.3; also elsewhere on the board
/FAULT: J1.1; also elsewhere on the board
/INPUT-: H1.1, H2.1, H3.1, H4.1, H5.1, H6.1, H7.1, H8.1, H9.1, H10.1, H11.1, H12.1, H13.1, H14.1, H15.1, H16.1, H17.1, H18.1, H19.1, H20.1, J7.1; also elsewhere on the board
/ISEN1x: J5.1; also elsewhere on the board
/ISEN10x: J4.1; also elsewhere on the board
/Input Protection and Filtering/VIN_ICL+: F1.2; also elsewhere on the board
/Output Sensor/IN-: F3.1; also elsewhere on the board
/Output Sensor/OUT+: F2.1; also elsewhere on the board
/PWM+: J1.5; also elsewhere on the board
/PWM-: J1.7; also elsewhere on the board
/VSEN1x+: J3.1; also elsewhere on the board
/VSEN1x-: J3.3; also elsewhere on the board
/VSEN10x+: J2.1; also elsewhere on the board
/VSEN10x-: J2.3; also elsewhere on the board
GND: J1.2, J1.6, J1.8, J2.2, J3.2, J4.3, J5.3; also elsewhere on the board
unnamed: F1.1, J6.1
unnamed: F2.2, J8.1
unnamed: F3.2, J9.1
V_{REF}: J4.2, J5.2; also elsewhere on the board

Notes on the sheet:
*in final design
Within Shielded Enclosure

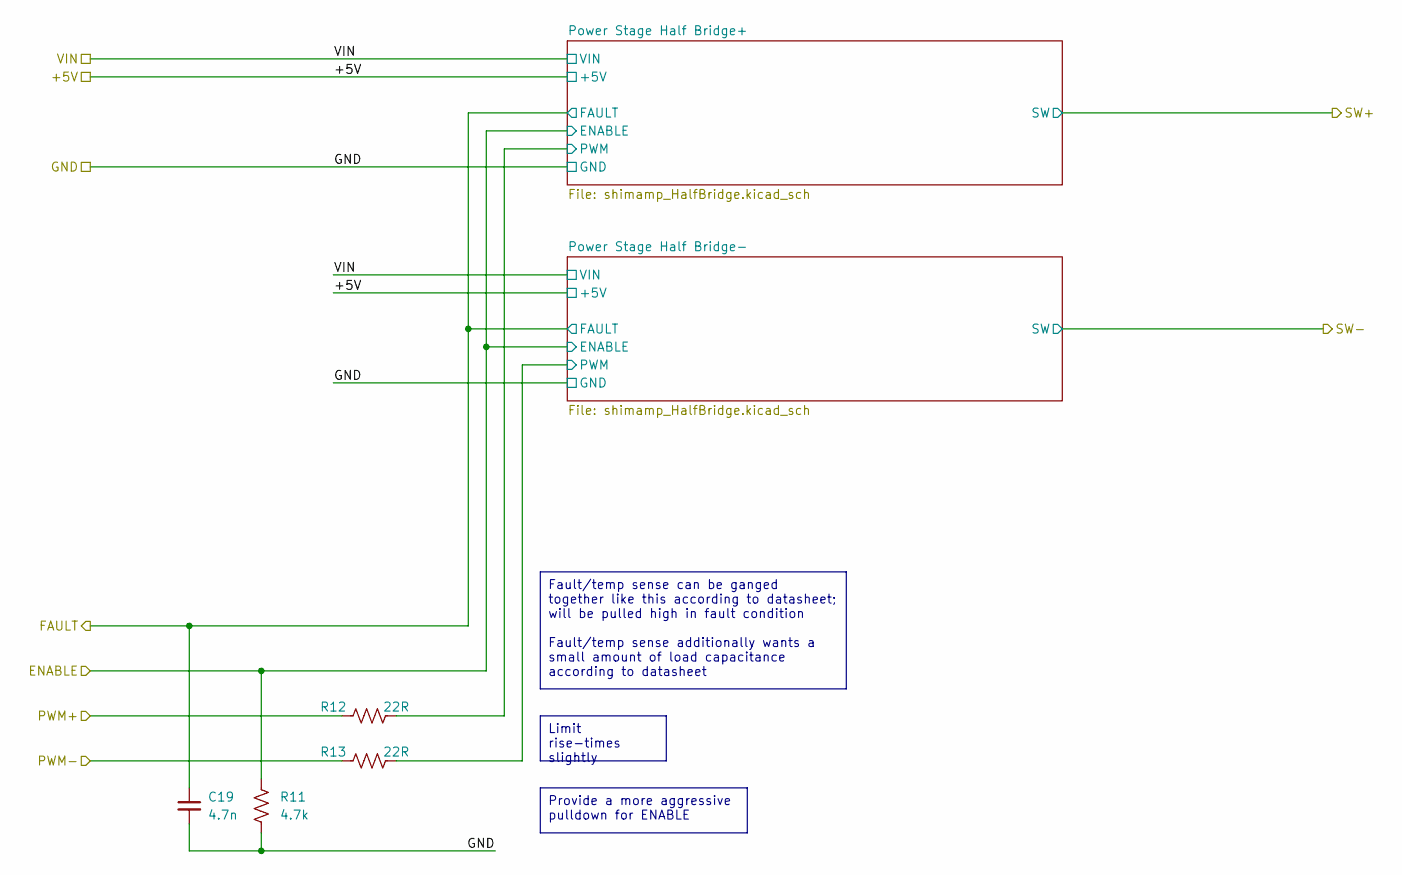
[picture p48: schematic shimamp_PowerStage.kicad_sch, Shim Amplifier Prototype]

Parts:
C19: 4.7n; C_0603_1608Metric_Pad1.08x0.95mm_HandSolder; Part Number CL10B472KB8NFNC
R11: 4.7k; R_0603_1608Metric_Pad0.98x0.95mm_HandSolder; Part Number RMCF0603FT4K70
R12, R13: 22R; R_0603_1608Metric_Pad0.98x0.95mm_HandSolder; Part Number RMCF0603FT22R0

Connections:
/ENABLE: R11.2; also elsewhere on the board
/FAULT: C19.1; also elsewhere on the board
/PWM+: R12.1; also elsewhere on the board
/PWM-: R13.1; also elsewhere on the board
/Power Stage/Power Stage Half Bridge+/PWM: R12.2; also elsewhere on the board
/Power Stage/Power Stage Half Bridge-/PWM: R13.2; also elsewhere on the board
GND: C19.2, R11.1; also elsewhere on the board

Notes on the sheet:
Limit rise-times slightly
Provide a more aggressive pulldown for ENABLE
Fault/temp sense can be ganged together like this according to datasheet; will be pulled high in fault condition Fault/temp sense additionally wants a small amount of load capacitance according to datasheet

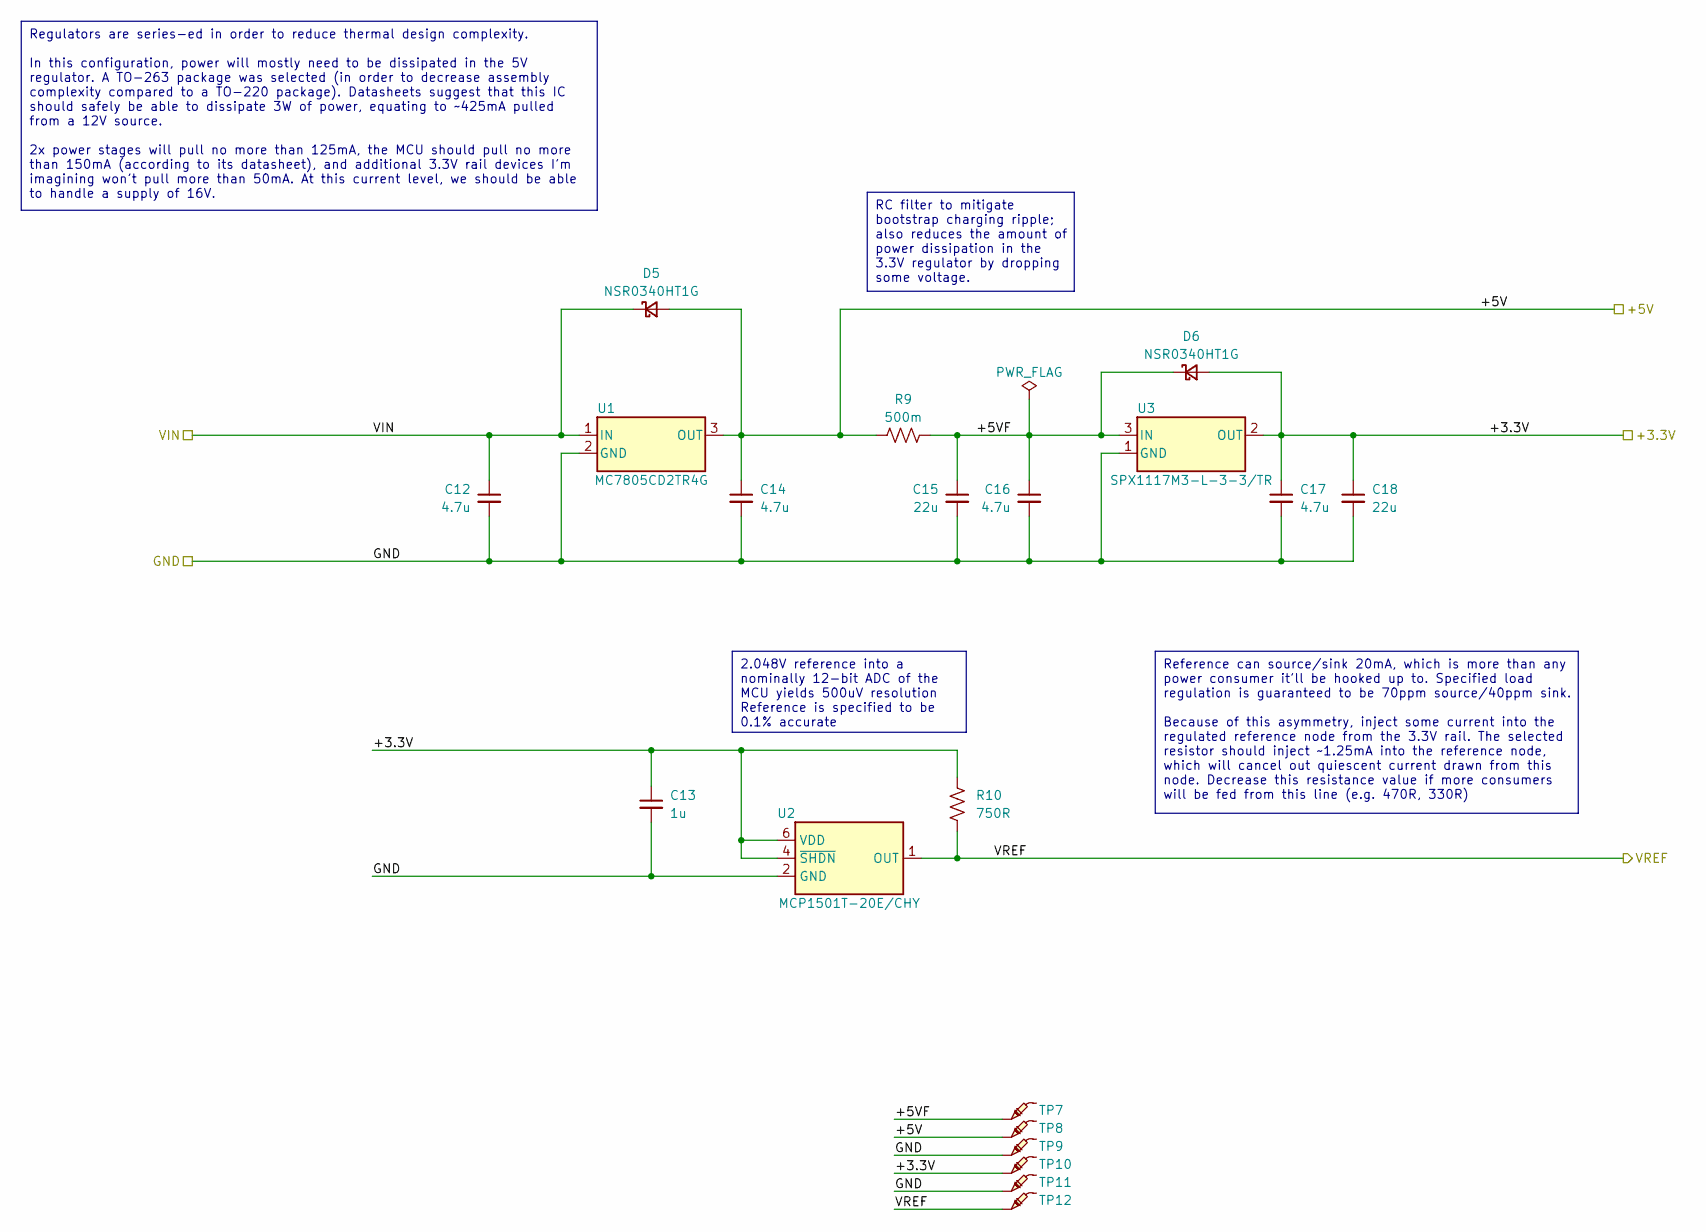
[picture p49: schematic shimamp_RailGeneration.kicad_sch, Shim Amplifier Prototype]

Parts:
C12, C14, C16, C17: 4.7u; C_0805_2012Metric_Pad1.18x1.45mm_HandSolder; Part Number CL21A475KLCLQNC
C13: 1u; C_0805_2012Metric_Pad1.18x1.45mm_HandSolder; Part Number CL21B105KBFNNNG
C15, C18: 22u; C_1210_3225Metric_Pad1.33x2.70mm_HandSolder; Part Number CL32B226KAJNNNE
D5, D6: NSR0340HT1G; D_SOD-323_HandSoldering; Part Number NSR0340HT1G
R9: 500m; R_1206_3216Metric_Pad1.30x1.75mm_HandSolder; Part Number CSR1206FKR500
R10: 750R; R_0603_1608Metric_Pad0.98x0.95mm_HandSolder; Part Number RMCF0603FT750R
TP7, TP8, TP9, TP10, TP11, TP12: -; TestPoint_Pad_D2.0mm
U1: MC7805CD2TR4G; TO-263-2; Part Number MC7805CD2TR4G
U2: MCP1501T-20E/CHY; SOT-23-6; Part Number MCP1501T-20E/CHY
U3: SPX1117M3-L-3-3/TR; SOT-223-3_TabPin2; Part Number SPX1117M3-L-3-3/TR

Connections:
+3.3V: C13.1, C17.1, C18.1, D6.2 (A), R10.1, TP10.1, U2.4 (~SHDN), U2.6 (VDD), U3.2 (OUT); also elsewhere on the board
+5V: C14.1, D5.2 (A), R9.1, TP8.1, U1.3 (OUT); also elsewhere on the board
/Rail Generation/+5VF: C15.1, C16.1, D6.1 (K), R9.2, TP7.1, U3.3 (IN)
GND: C12.2, C13.2, C14.2, C15.2, C16.2, C17.2, C18.2, TP9.1, TP11.1, U1.2 (GND), U2.2 (GND), U2.3 (GND), U2.5 (GND), U3.1 (GND); also elsewhere on the board
V_{IN}: C12.1, D5.1 (K), U1.1 (IN); also elsewhere on the board
V_{REF}: R10.2, TP12.1, U2.1 (OUT); also elsewhere on the board

Notes on the sheet:
Regulators are series-ed in order to reduce thermal design complexity. In this configuration, power will mostly need to be dissipated in the 5V regulator. A TO-263 package was selected (in order to decrease assembly complexity compared to a TO-220 package). Datasheets suggest that this IC should sa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
2.048V reference into a nominally 12-bit ADC of the MCU yields 500uV resolution Reference is specified to be 0.1% accurate
Reference can source/sink 20mA, which is more than any power consumer it'll be hooked up to. Specified load regulation is guaranteed to be 70ppm source/40ppm sink. Because of this asymmetry, inject some current into the regulated reference node from the 3.3V rail. The selected resistor should injec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
RC filter to mitigate bootstrap charging ripple; also reduces the amount of power dissipation in the 3.3V regulator by dropping some voltage.

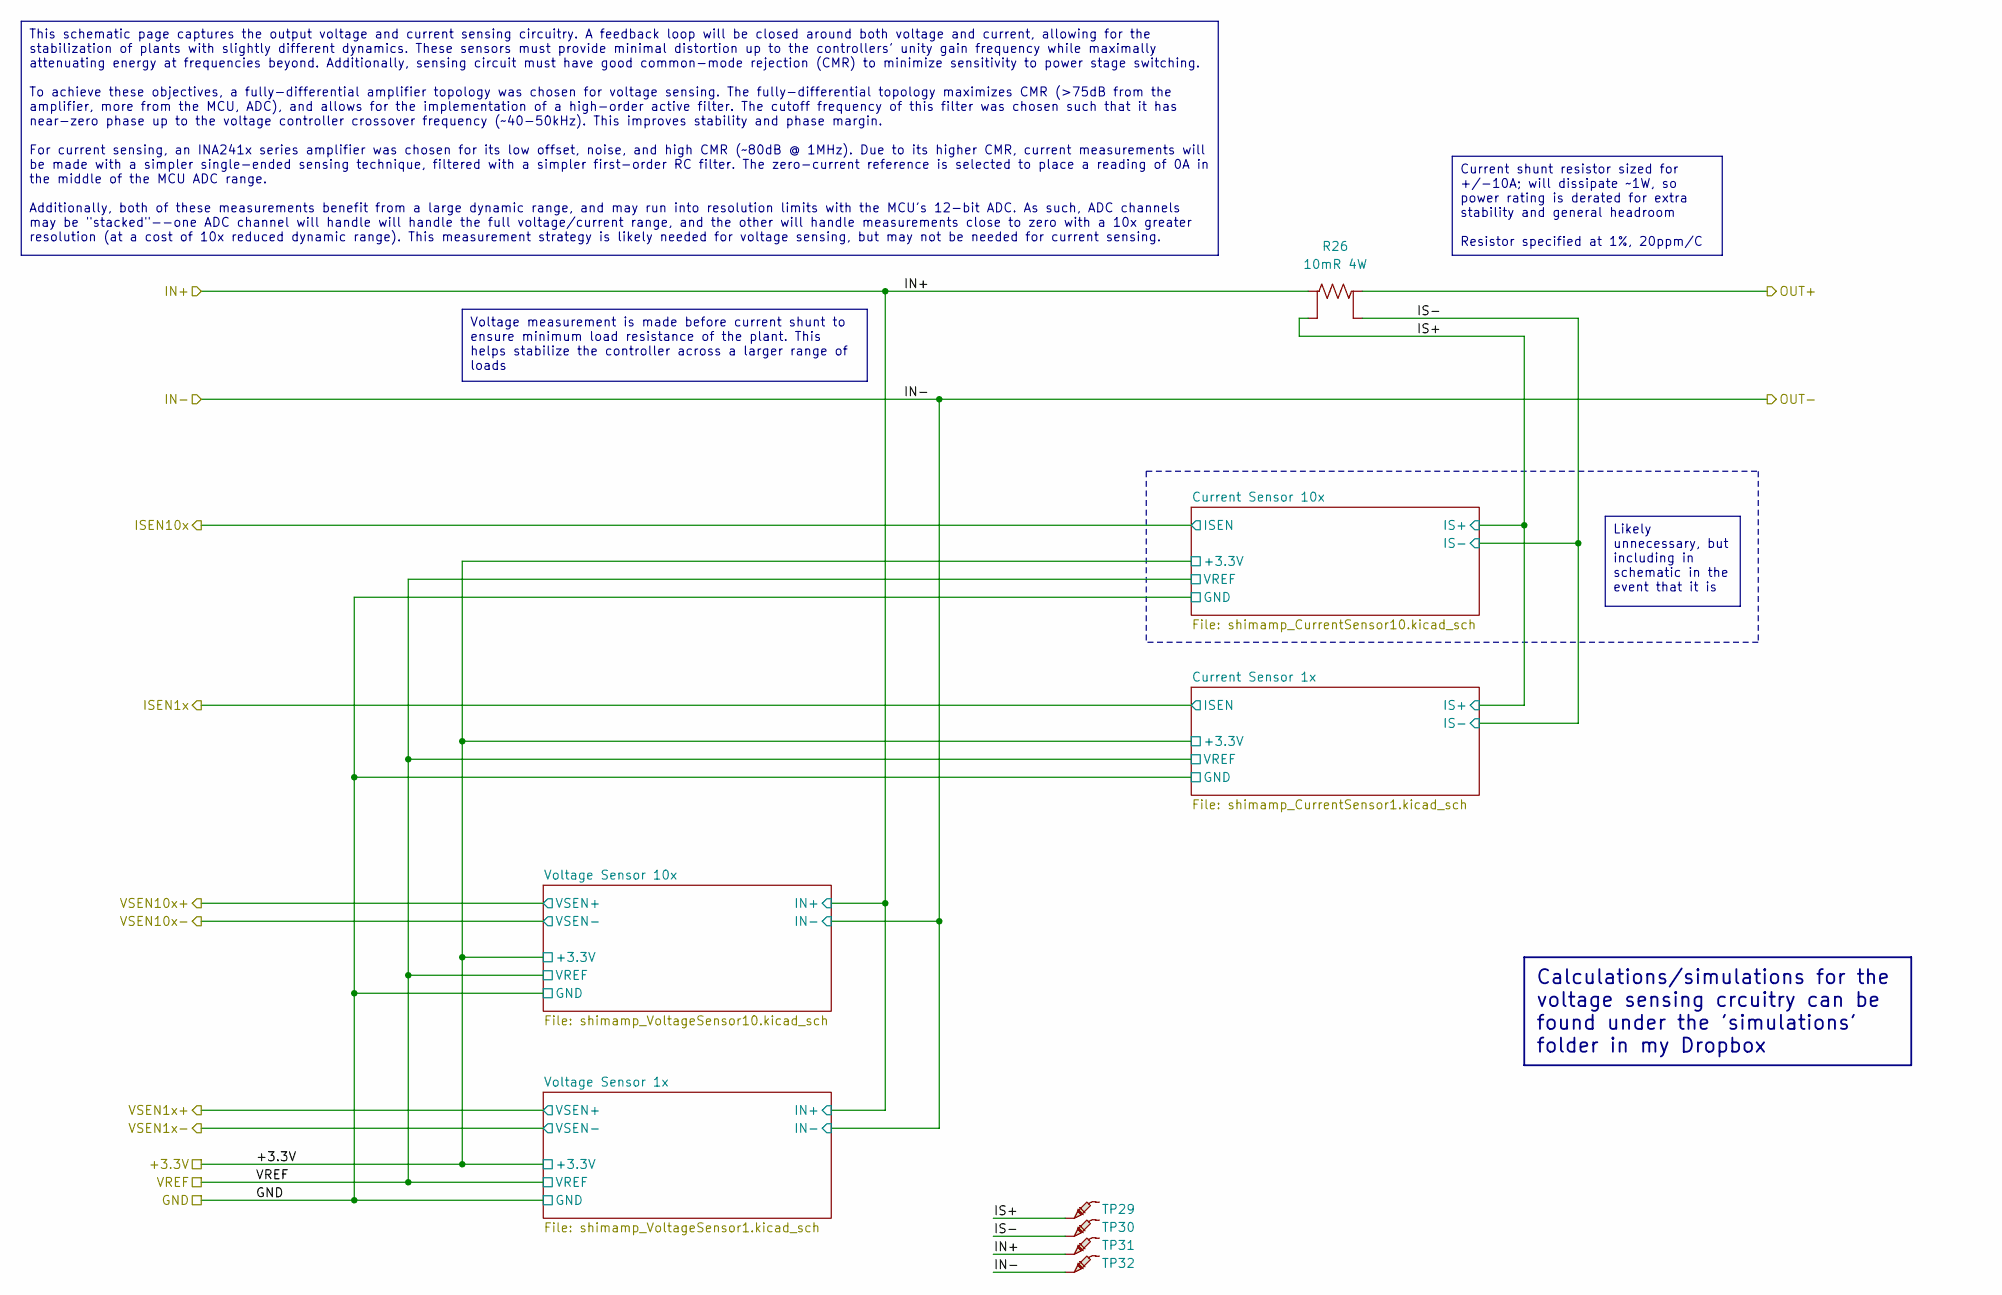
[picture p50: schematic shimamp_OutputSensor.kicad_sch, Shim Amplifier Prototype]

Parts:
R26: 10mR 4W; R_2512_6332_CURRENT_SHUNT; Part Number VMS-R010-1.0-U
TP29, TP30, TP31, TP32: -; TestPoint_Pad_D2.0mm

Connections:
/Output Sensor/IN+: R26.2, TP31.1; also elsewhere on the board
/Output Sensor/IN-: TP32.1; also elsewhere on the board
/Output Sensor/IS+: R26.4, TP29.1; also elsewhere on the board
/Output Sensor/IS-: R26.3, TP30.1; also elsewhere on the board
/Output Sensor/OUT+: R26.1; also elsewhere on the board

Notes on the sheet:
This schematic page captures the output voltage and current sensing circuitry. A feedback loop will be closed around both voltage and current, allowing for the stabilization of plants with slightly different dynamics. These sensors must provide minimal distortion up to the controllers' unity gain f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
Calculations/simulations for the voltage sensing crcuitry can be found under the 'simulations' folder in my Dropbox
Likely unnecessary, but including in schematic in the event that it is
Voltage measurement is made before current shunt to ensure minimum load resistance of the plant. This helps stabilize the controller across a larger range of loads
Current shunt resistor sized for +/-10A; will dissipate ~1W, so power rating is derated for extra stability and general headroom Resistor specified at 1%, 20ppm/C

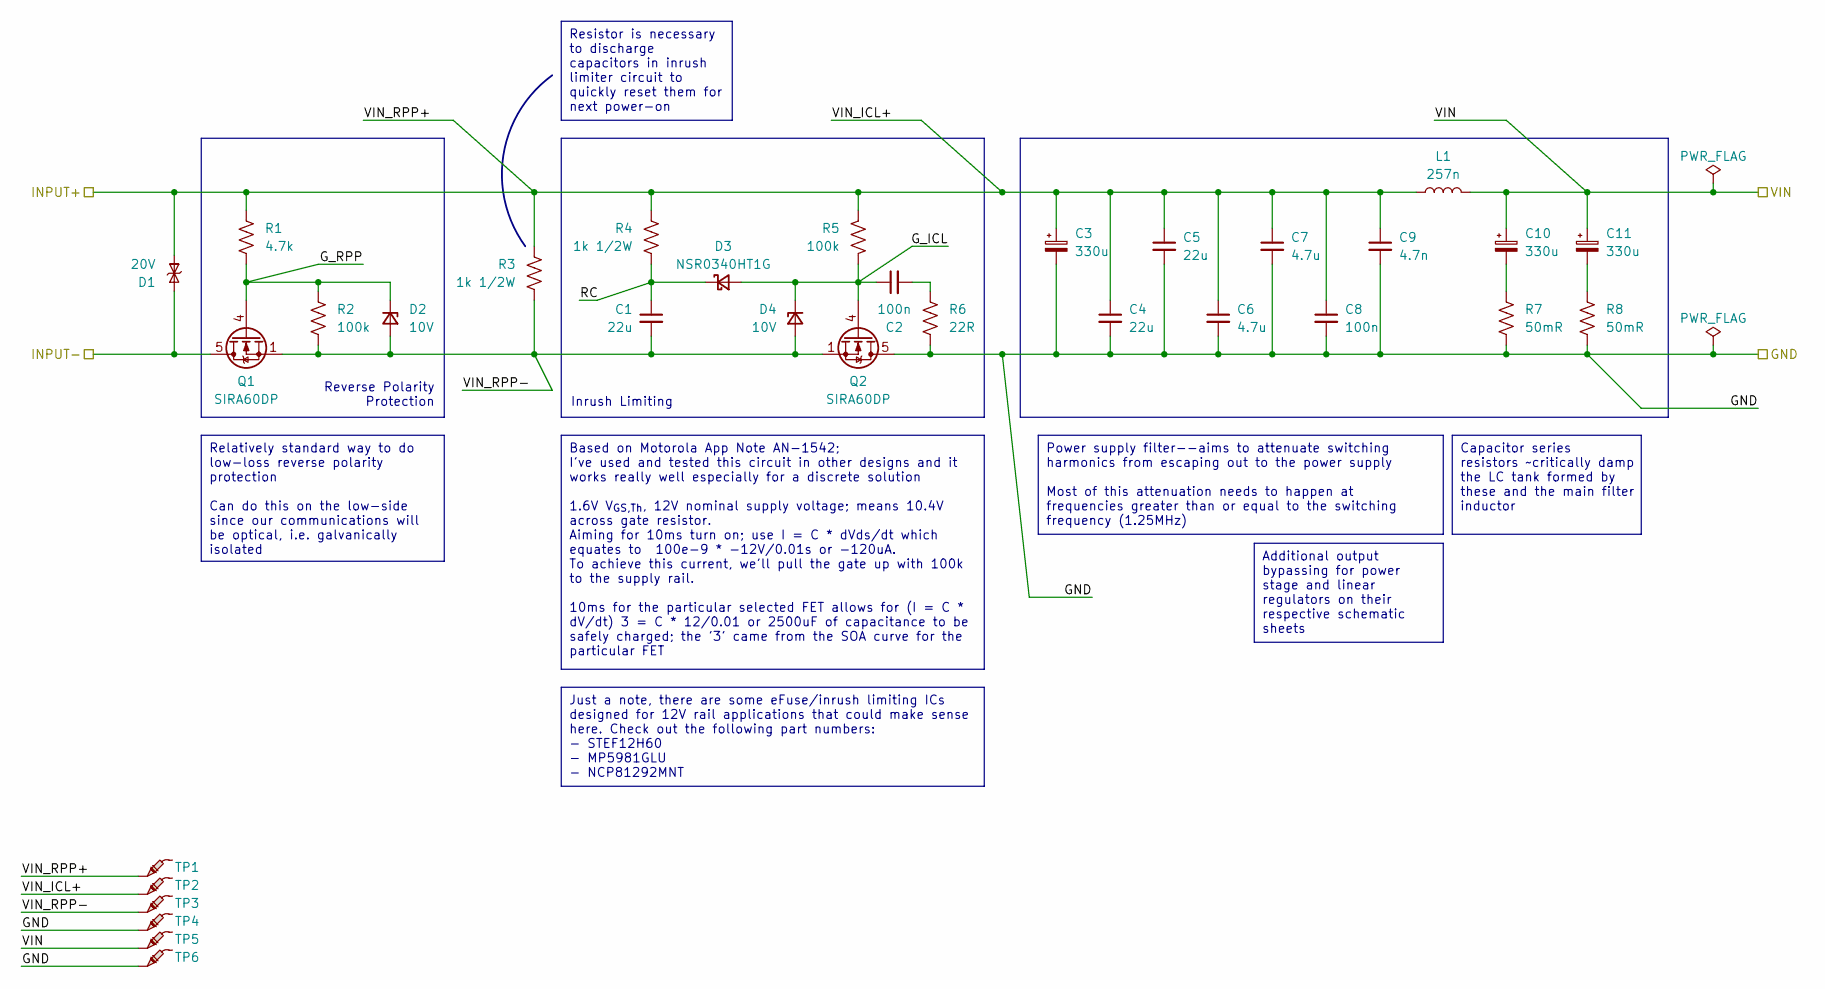
[picture p51: schematic shimamp_PowerIn.kicad_sch, Shim Amplifier Prototype]

Parts:
C1, C4, C5: 22u; C_1210_3225Metric_Pad1.33x2.70mm_HandSolder; Part Number CL32B226KAJNNNE
C2, C8: 100n; C_0603_1608Metric_Pad1.08x0.95mm_HandSolder; Part Number CL10B104KB8NNWC
C3, C10, C11: 330u; CP_Elec_10x12.6; Part Number 25SVPF330M
C6, C7: 4.7u; C_0805_2012Metric_Pad1.18x1.45mm_HandSolder; Part Number CL21A475KLCLQNC
C9: 4.7n; C_0603_1608Metric_Pad1.08x0.95mm_HandSolder; Part Number CL10B472KB8NFNC
D1: 20V; D_SMC; Part Number SMCJ20CA
D2, D4: 10V; D_SOD-323_HandSoldering; Part Number MM3Z10VC
D3: NSR0340HT1G; D_SOD-323_HandSoldering; Part Number NSR0340HT1G
L1: 257n; COILCRAFT_2014; Part Number 2014VS-251MED
Q1, Q2: SIRA60DP; PQFN-8-EP_6x5mm_P1.27mm_Generic; Part Number SIRA60DP-T1-GE3
R1: 4.7k; R_0603_1608Metric_Pad0.98x0.95mm_HandSolder; Part Number RMCF0603FT4K70
R2, R5: 100k; R_0603_1608Metric_Pad0.98x0.95mm_HandSolder; Part Number RMCF0603FT100K
R3, R4: 1k 1/2W; R_1210_3225Metric_Pad1.30x2.65mm_HandSolder; Part Number RMCF1210JT1K00
R6: 22R; R_0603_1608Metric_Pad0.98x0.95mm_HandSolder; Part Number RMCF0603FT22R0
R7, R8: 50mR; R_2512_6332Metric_Pad1.40x3.35mm_HandSolder; Part Number CSRN2512FK50L0
TP1, TP2, TP3, TP4, TP5, TP6: -; TestPoint_Pad_D2.0mm

Connections:
/INPUT-: D1.2 (A), Q1.5 (D); also elsewhere on the board
/Input Protection and Filtering/G_ICL: C2.1, D3.2 (A), D4.1 (K), Q2.4 (G), R5.2
/Input Protection and Filtering/G_RPP: D2.1 (K), Q1.4 (G), R1.2, R2.1
/Input Protection and Filtering/RC: C1.1, D3.1 (K), R4.2
/Input Protection and Filtering/VIN_ICL+: C3.1, C4.1, C5.1, C6.1, C7.1, C8.1, C9.1, D1.1 (K), L1.1, R1.1, R3.1, R4.1, R5.1, TP1.1, TP2.1; also elsewhere on the board
/Input Protection and Filtering/VIN_RPP-: C1.2, D2.2 (A), D4.2 (A), Q1.1 (S), Q1.2 (S), Q1.3 (S), Q2.1 (S), Q2.2 (S), Q2.3 (S), R2.2, R3.2, TP3.1
GND: C3.2, C4.2, C5.2, C6.2, C7.2, C8.2, C9.2, Q2.5 (D), R6.2, R7.2, R8.2, TP4.1, TP6.1; also elsewhere on the board
unnamed: C2.2, R6.1
unnamed: C10.2, R7.1
unnamed: C11.2, R8.1
V_{IN}: C10.1, C11.1, L1.2, TP5.1; also elsewhere on the board

Notes on the sheet:
Additional output bypassing for power stage and linear regulators on their respective schematic sheets
Power supply filter--aims to attenuate switching harmonics from escaping out to the power supply Most of this attenuation needs to happen at frequencies greater than or equal to the switching frequency (1.25MHz)
Just a note, there are some eFuse/inrush limiting ICs designed for 12V rail applications that could make sense here. Check out the following part numbers: - STEF12H60 - MP5981GLU - NCP81292MNT
Based on Motorola App Note AN-1542; I've used and tested this circuit in other designs and it works really well especially for a discrete solution 1.6V V_{GS,Th}, 12V nominal supply voltage; means 10.4V across gate resistor. Aiming for 10ms turn on; use I = C * dVds/dt which equates to 100e-9 * -12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
Relatively standard way to do low-loss reverse polarity protection Can do this on the low-side since our communications will be optical, i.e. galvanically isolated
Resistor is necessary to discharge capacitors in inrush limiter circuit to quickly reset them for next power-on
Capacitor series resistors ~critically damp the LC tank formed by these and the main filter inductor
Inrush Limiting
Reverse Polarity Protection

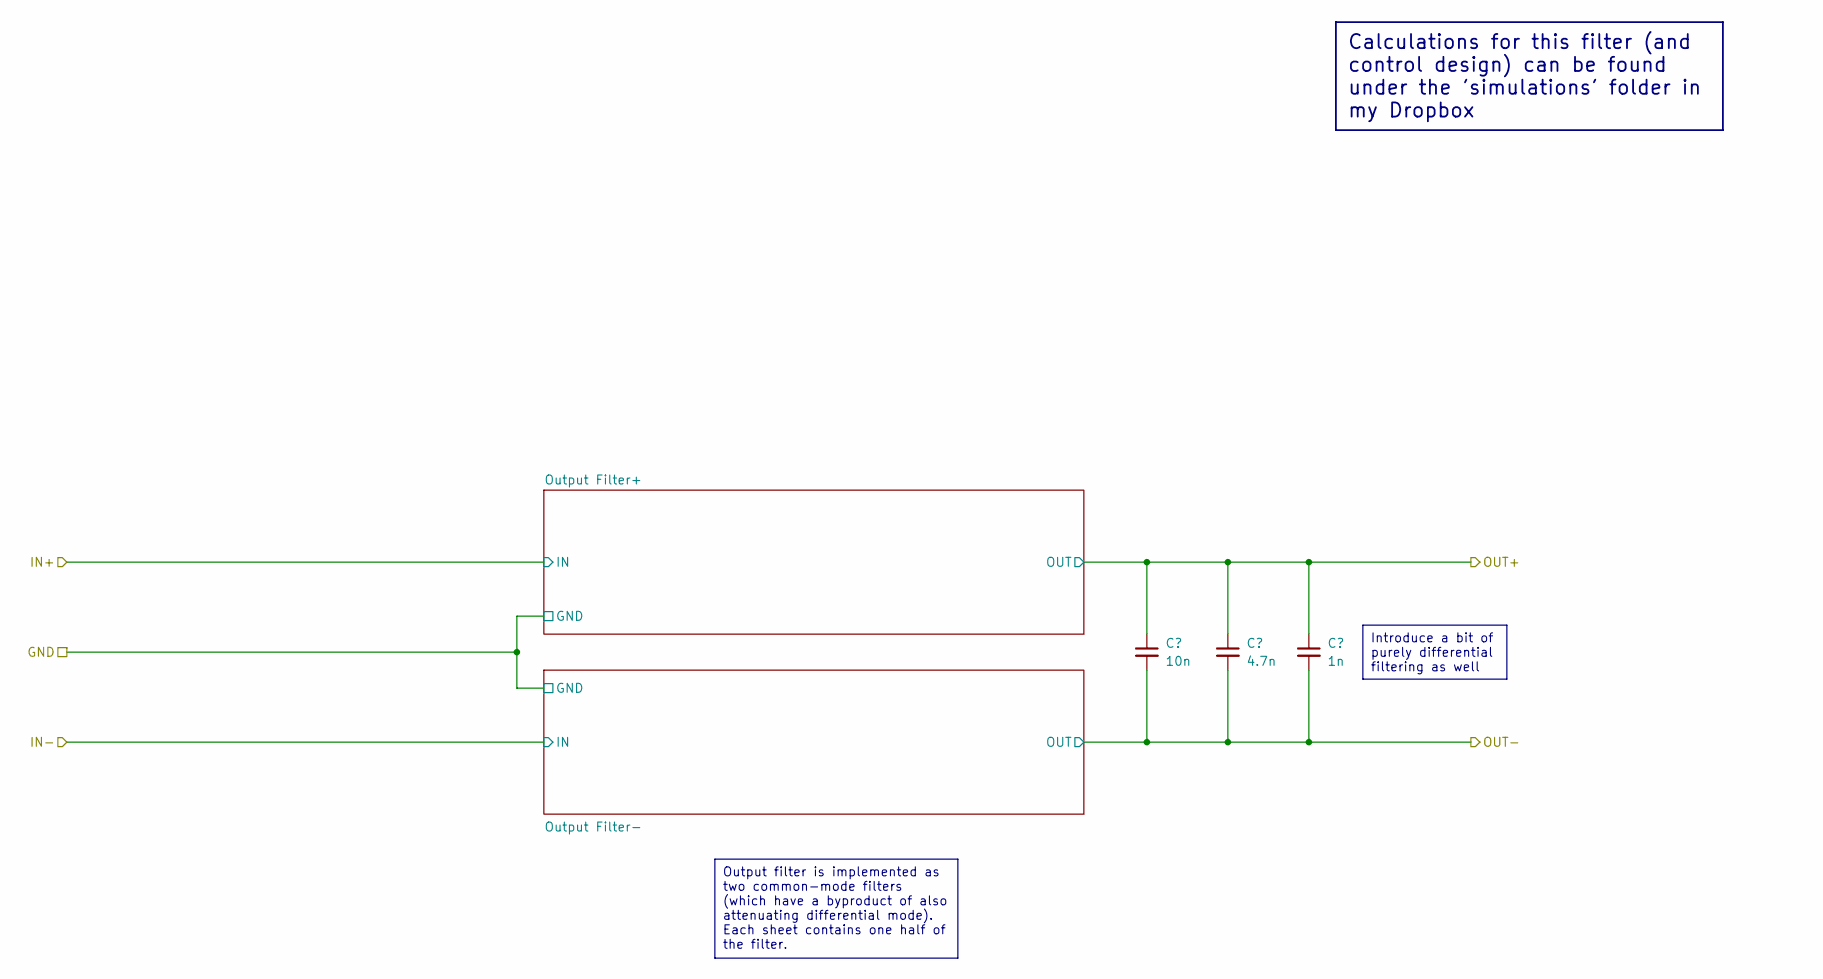
[picture p52: schematic shimamp_OutputFilter.kicad_sch, Shim Amplifier Prototype]

Parts:
C66: 10n; C_0603_1608Metric_Pad1.08x0.95mm_HandSolder; Part Number CL10B103KB8NNNC
C67: 4.7n; C_0603_1608Metric_Pad1.08x0.95mm_HandSolder; Part Number CL10B472KB8NFNC
C68: 1n; C_0603_1608Metric_Pad1.08x0.95mm_HandSolder; Part Number CL10B102KB8NNNC

Connections:
/Output Sensor/IN+: C66.1, C67.1, C68.1; also elsewhere on the board
/Output Sensor/IN-: C66.2, C67.2, C68.2; also elsewhere on the board

Notes on the sheet:
Output filter is implemented as two common-mode filters (which have a byproduct of also attenuating differential mode). Each sheet contains one half of the filter.
Calculations for this filter (and control design) can be found under the 'simulations' folder in my Dropbox
Introduce a bit of purely differential filtering as well

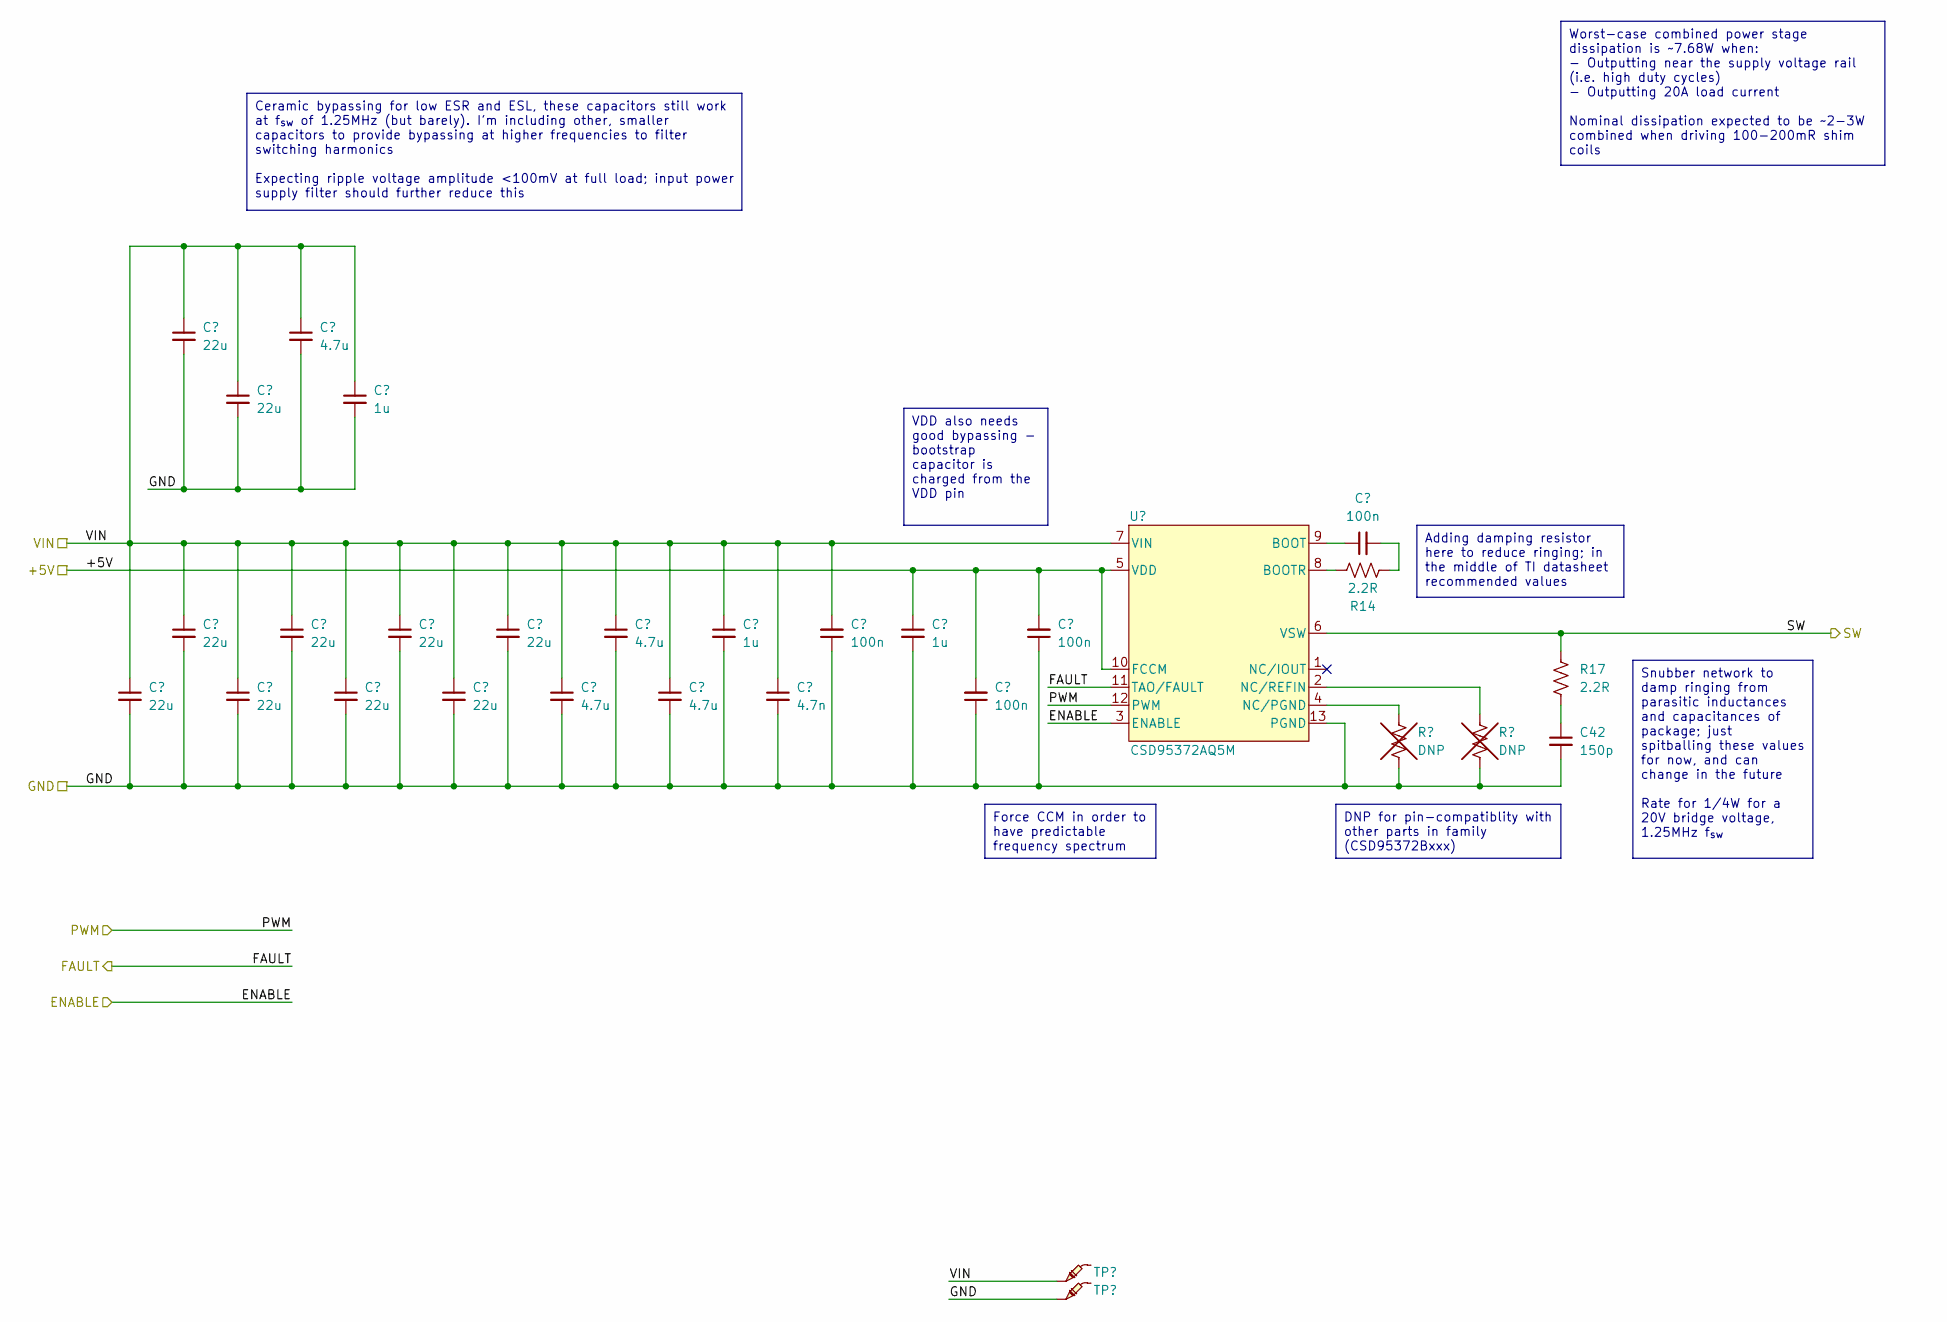
[picture p53: schematic shimamp_HalfBridge.kicad_sch, Shim Amplifier Prototype]

Parts:
C20, C21, C22, C23, C24, C25, C27, C29, C30, C31: 22u; C_1210_3225Metric_Pad1.33x2.70mm_HandSolder; Part Number CL32B226KAJNNNE
C26, C32, C33, C34: 4.7u; C_0805_2012Metric_Pad1.18x1.45mm_HandSolder; Part Number CL21A475KLCLQNC
C28, C35, C38: 1u; C_0805_2012Metric_Pad1.18x1.45mm_HandSolder; Part Number CL21B105KBFNNNG
C36: 4.7n; C_0603_1608Metric_Pad1.08x0.95mm_HandSolder; Part Number CL10B472KB8NFNC
C37, C39, C40, C41: 100n; C_0603_1608Metric_Pad1.08x0.95mm_HandSolder; Part Number CL10B104KB8NNWC
C42: 150p; C_0603_1608Metric_Pad1.08x0.95mm_HandSolder; Part Number GCM1885C2A151JA16D
R14, R17: 2.2R; R_0805_2012Metric_Pad1.20x1.40mm_HandSolder; Part Number RPC0805JT2R20-UP
R15, R16: DNP; DNP_R_0603_1608Metric_Pad0.98x0.95mm_HandSolder
TP13, TP14: -; TestPoint_Pad_D2.0mm
U4: CSD95372AQ5M; LSON-12-1EP_5x6mm; Part Number CSD95372AQ5M

Connections:
+5V: C38.1, C39.2, C40.2, U4.5 (VDD), U4.10 (FCCM); also elsewhere on the board
/ENABLE: U4.3 (ENABLE); also elsewhere on the board
/FAULT: U4.11 (TAO/FAULT); also elsewhere on the board
/Power Stage/Power Stage Half Bridge+/PWM: U4.12 (PWM); also elsewhere on the board
/Power Stage/Power Stage Half Bridge+/SW: R17.1, U4.6 (VSW); also elsewhere on the board
GND: C20.2, C21.2, C22.2, C23.2, C24.2, C25.2, C26.2, C27.2, C28.2, C29.2, C30.2, C31.2, C32.2, C33.2, C34.2, C35.2, C36.2, C37.1, C38.2, C39.1, C40.1, C42.2, R15.2, R16.2, TP14.1, U4.13 (PGND); also elsewhere on the board
unnamed: C41.2, R14.2
unnamed: C42.1, R17.2
unnamed: C41.1, U4.9 (BOOT)
unnamed: R14.1, U4.8 (BOOTR)
unnamed: R15.1, U4.4 (NC/PGND)
unnamed: R16.1, U4.2 (NC/REFIN)
V_{IN}: C20.1, C21.1, C22.1, C23.1, C24.1, C25.1, C26.1, C27.1, C28.1, C29.1, C30.1, C31.1, C32.1, C33.1, C34.1, C35.1, C36.1, C37.2, TP13.1, U4.7 (VIN); also elsewhere on the board

Parts of its further copies:
C43, C44, C45, C46, C47, C48, C50, C52, C53, C54: 22u; C_1210_3225Metric_Pad1.33x2.70mm_HandSolder; Part Number CL32B226KAJNNNE
C49, C55, C56, C57: 4.7u; C_0805_2012Metric_Pad1.18x1.45mm_HandSolder; Part Number CL21A475KLCLQNC
C51, C58, C61: 1u; C_0805_2012Metric_Pad1.18x1.45mm_HandSolder; Part Number CL21B105KBFNNNG
C59: 4.7n; C_0603_1608Metric_Pad1.08x0.95mm_HandSolder; Part Number CL10B472KB8NFNC
C60, C62, C63, C64: 100n; C_0603_1608Metric_Pad1.08x0.95mm_HandSolder; Part Number CL10B104KB8NNWC
C65: 150p; C_0603_1608Metric_Pad1.08x0.95mm_HandSolder; Part Number GCM1885C2A151JA16D
R18, R21: 2.2R; R_0805_2012Metric_Pad1.20x1.40mm_HandSolder; Part Number RPC0805JT2R20-UP
R19, R20: DNP; DNP_R_0603_1608Metric_Pad0.98x0.95mm_HandSolder
TP15, TP16: -; TestPoint_Pad_D2.0mm
U5: CSD95372AQ5M; LSON-12-1EP_5x6mm; Part Number CSD95372AQ5M

Connections of its further copies:
+5V: C61.1, C62.2, C63.2, U5.5 (VDD), U5.10 (FCCM); also elsewhere on the board
/ENABLE: U5.3 (ENABLE); also elsewhere on the board
/FAULT: U5.11 (TAO/FAULT); also elsewhere on the board
/Power Stage/Power Stage Half Bridge-/PWM: U5.12 (PWM); also elsewhere on the board
/Power Stage/Power Stage Half Bridge-/SW: R21.1, U5.6 (VSW); also elsewhere on the board
GND: C43.2, C44.2, C45.2, C46.2, C47.2, C48.2, C49.2, C50.2, C51.2, C52.2, C53.2, C54.2, C55.2, C56.2, C57.2, C58.2, C59.2, C60.1, C61.2, C62.1, C63.1, C65.2, R19.2, R20.2, TP16.1, U5.13 (PGND); also elsewhere on the board
unnamed: C64.2, R18.2
unnamed: C65.1, R21.2
unnamed: C64.1, U5.9 (BOOT)
unnamed: R18.1, U5.8 (BOOTR)
unnamed: R19.1, U5.4 (NC/PGND)
unnamed: R20.1, U5.2 (NC/REFIN)
V_{IN}: C43.1, C44.1, C45.1, C46.1, C47.1, C48.1, C49.1, C50.1, C51.1, C52.1, C53.1, C54.1, C55.1, C56.1, C57.1, C58.1, C59.1, C60.2, TP15.1, U5.7 (VIN); also elsewhere on the board

Notes on the sheet:
Worst-case combined power stage dissipation is ~7.68W when: - Outputting near the supply voltage rail (i.e. high duty cycles) - Outputting 20A load current Nominal dissipation expected to be ~2-3W combined when driving 100-200mR shim coils
Adding damping resistor here to reduce ringing; in the middle of TI datasheet recommended values
VDD also needs good bypassing - bootstrap capacitor is charged from the VDD pin
DNP for pin-compatiblity with other parts in family (CSD95372Bxxx)
Force CCM in order to have predictable frequency spectrum
Ceramic bypassing for low ESR and ESL, these capacitors still work at f_{sw} of 1.25MHz (but barely). I'm including other, smaller capacitors to provide bypassing at higher frequencies to filter switching harmonics Expecting ripple voltage amplitude <100mV at full load; input power supply filter sh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
Snubber network to damp ringing from parasitic inductances and capacitances of package; just spitballing these values for now, and can change in the future Rate for 1/4W for a 20V bridge voltage, 1.25MHz f_{sw}
