Govish/Shimamp-Hardware/Class-D Prototype revB/Class-D Prototype RevB/Class-D Prototype RevB.kicad_pcb

## KiCad design Class-D Prototype revB/Class-D Prototype RevB/Class-D Prototype RevB.kicad_pcb (continued)

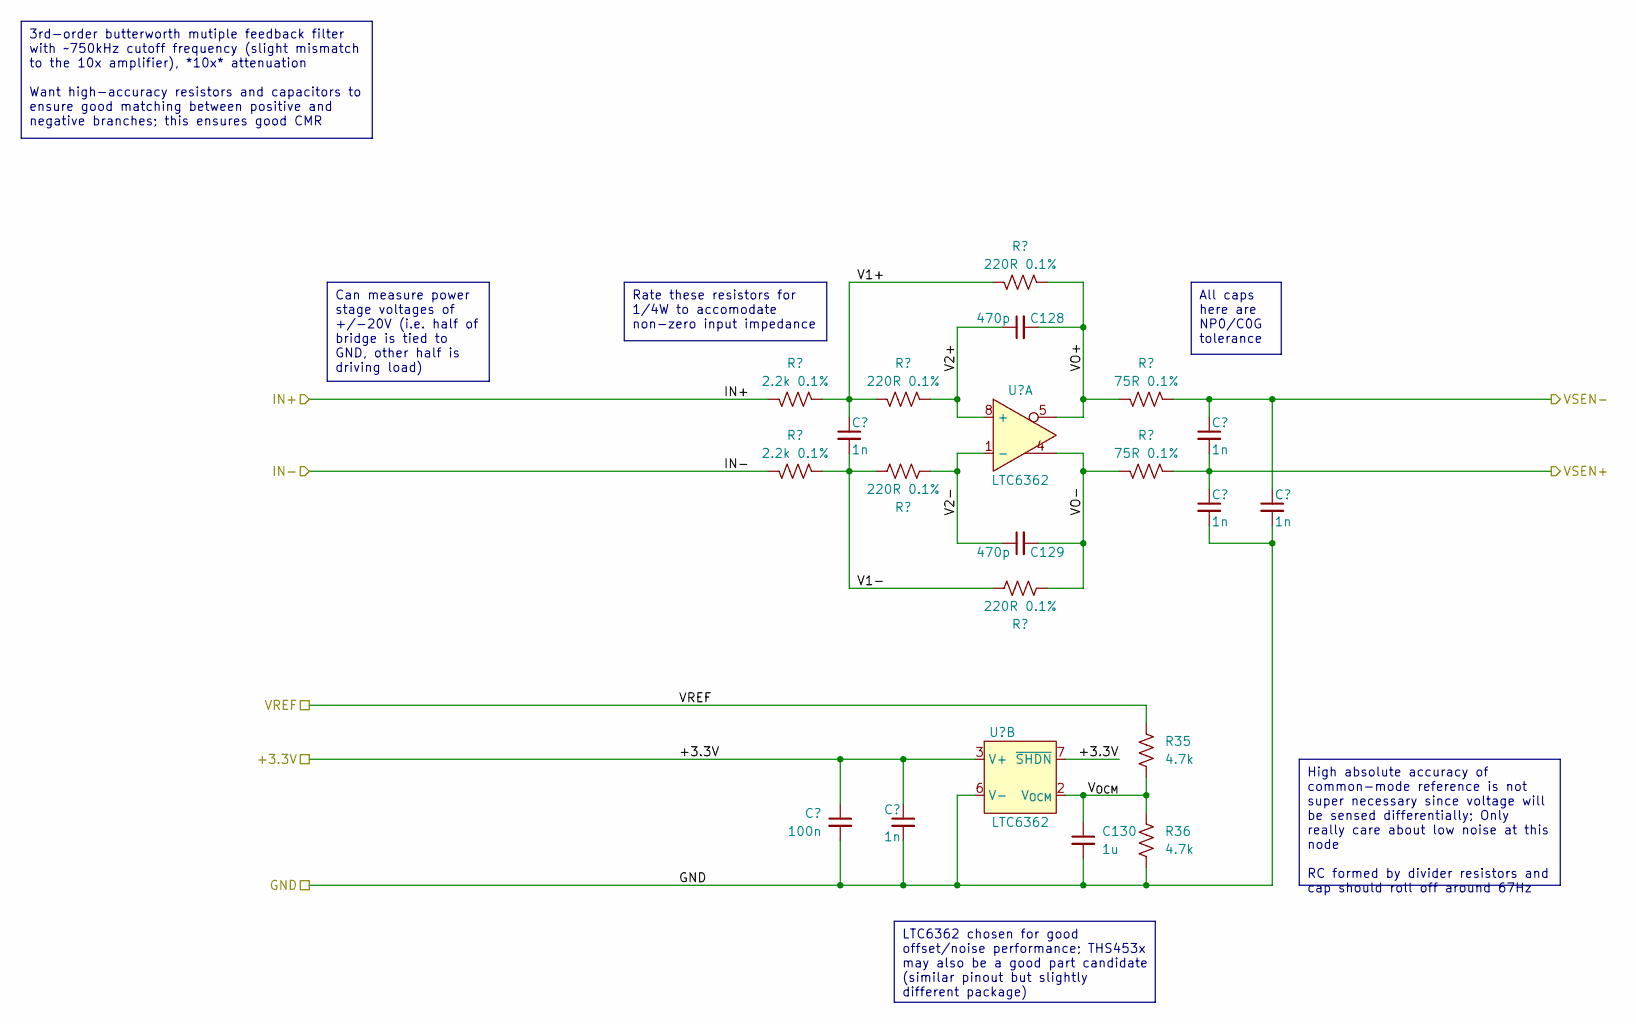
[picture p54: schematic shimamp_VoltageSensor10.kicad_sch, Shim Amplifier Prototype]

Parts:
C125: 100n; C_0603_1608Metric_Pad1.08x0.95mm_HandSolder; Part Number CL10B104KB8NNWC
C126, C127, C131, C132, C133: 1n; C_0603_1608Metric_Pad1.08x0.95mm_HandSolder; Part Number CL10B102KB8NNNC
C128, C129: 470p; C_0603_1608Metric_Pad1.08x0.95mm_HandSolder; Part Number GCM1885C2A471FA16D
C130: 1u; C_0805_2012Metric_Pad1.18x1.45mm_HandSolder; Part Number CL21B105KBFNNNG
R27, R28: 2.2k 0.1%; R_1206_3216Metric_Pad1.30x1.75mm_HandSolder; Part Number RN73R2BTTD2201B25
R29, R30, R31, R32: 220R 0.1%; R_0603_1608Metric_Pad0.98x0.95mm_HandSolder; Part Number RN73R1JTTD2200B25
R33, R34: 75R 0.1%; R_0603_1608Metric_Pad0.98x0.95mm_HandSolder; Part Number RN73R1JTTD75R0B25
R35, R36: 4.7k; R_0603_1608Metric_Pad0.98x0.95mm_HandSolder; Part Number RMCF0603FT4K70
U6: LTC6362; MSOP-8_3x3mm_P0.65mm; Part Number LTC6362CMS8#TRPBF

Connections:
+3.3V: C125.1, C127.1, U6.3 (V+), U6.7 (~SHDN); also elsewhere on the board
/Output Sensor/IN+: R27.2; also elsewhere on the board
/Output Sensor/IN-: R28.2; also elsewhere on the board
/Output Sensor/Voltage Sensor 10x/V1+: C126.1, R27.1, R29.2, R31.2
/Output Sensor/Voltage Sensor 10x/V1-: C126.2, R28.1, R30.2, R32.2
/Output Sensor/Voltage Sensor 10x/V2+: C128.1, R29.1, U6.8 (+)
/Output Sensor/Voltage Sensor 10x/V2-: C129.1, R30.1, U6.1 (-)
/Output Sensor/Voltage Sensor 10x/VO+: C128.2, R31.1, R33.2, U6.5
/Output Sensor/Voltage Sensor 10x/VO-: C129.2, R32.1, R34.2, U6.4
/Output Sensor/Voltage Sensor 10x/V_{OCM}: C130.1, R35.2, R36.1, U6.2 (V_{OCM})
/VSEN10x+: C131.2, C132.1, R34.1; also elsewhere on the board
/VSEN10x-: C131.1, C133.1, R33.1; also elsewhere on the board
GND: C125.2, C127.2, C130.2, C132.2, C133.2, R36.2, U6.6 (V-); also elsewhere on the board
V_{REF}: R35.1; also elsewhere on the board

Notes on the sheet:
LTC6362 chosen for good offset/noise performance; THS453x may also be a good part candidate (similar pinout but slightly different package)
3rd-order butterworth mutiple feedback filter with ~750kHz cutoff frequency (slight mismatch to the 10x amplifier), *10x* attenuation Want high-accuracy resistors and capacitors to ensure good matching between positive and negative branches; this ensures good CMR
All caps here are NP0/C0G tolerance
Rate these resistors for 1/4W to accomodate non-zero input impedance
Can measure power stage voltages of +/-20V (i.e. half of bridge is tied to GND, other half is driving load)
High absolute accuracy of common-mode reference is not super necessary since voltage will be sensed differentially; Only really care about low noise at this node RC formed by divider resistors and cap should roll off around 67Hz

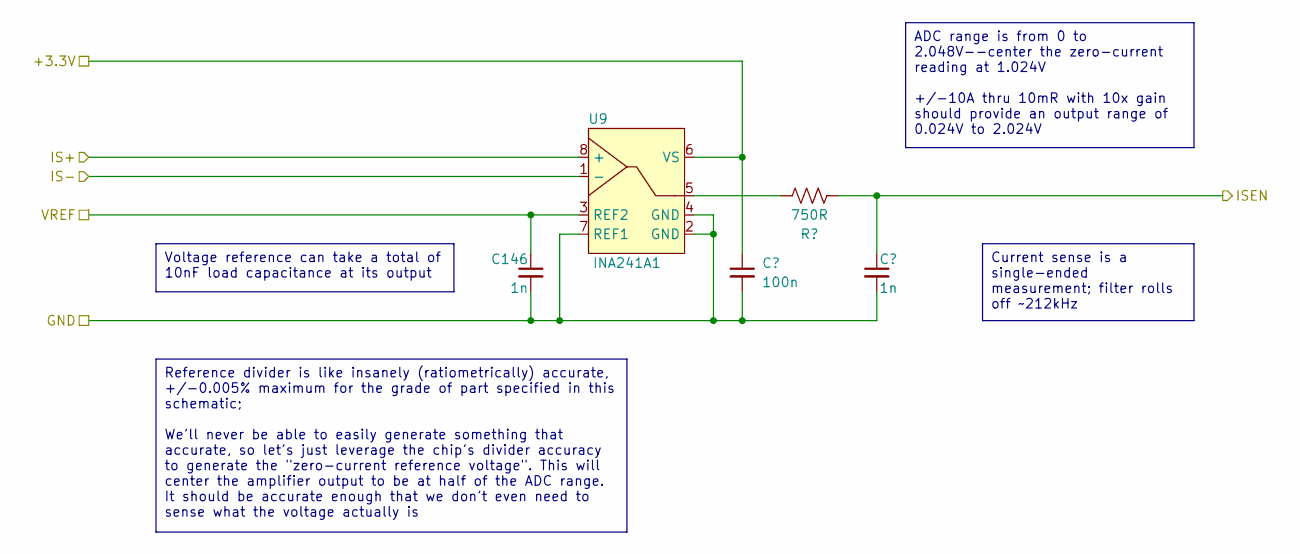
[picture p55: schematic shimamp_CurrentSensor1.kicad_sch, Shim Amplifier Prototype]

Parts:
C146, C148: 1n; C_0603_1608Metric_Pad1.08x0.95mm_HandSolder; Part Number CL10B102KB8NNNC
C147: 100n; C_0603_1608Metric_Pad1.08x0.95mm_HandSolder; Part Number CL10B104KB8NNWC
R48: 750R; R_0603_1608Metric_Pad0.98x0.95mm_HandSolder; Part Number RMCF0603FT750R
U9: INA241A1; SOT-23-8_Handsoldering; Part Number INA241A1IDDFR

Connections:
+3.3V: C147.1, U9.6 (VS); also elsewhere on the board
/ISEN1x: C148.1, R48.1; also elsewhere on the board
/Output Sensor/IS+: U9.8 (+); also elsewhere on the board
/Output Sensor/IS-: U9.1 (-); also elsewhere on the board
GND: C146.2, C147.2, C148.2, U9.2 (GND), U9.4 (GND), U9.7 (REF1); also elsewhere on the board
unnamed: R48.2, U9.5
V_{REF}: C146.1, U9.3 (REF2); also elsewhere on the board

Notes on the sheet:
Current sense is a single-ended measurement; filter rolls off ~212kHz
ADC range is from 0 to 2.048V--center the zero-current reading at 1.024V +/-10A thru 10mR with 10x gain should provide an output range of 0.024V to 2.024V
Reference divider is like insanely (ratiometrically) accurate, +/-0.005% maximum for the grade of part specified in this schematic; We'll never be able to easily generate something that accurate, so let's just leverage the chip's divider accuracy to generate the "zero-current reference voltage". Th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
Voltage reference can take a total of 10nF load capacitance at its output

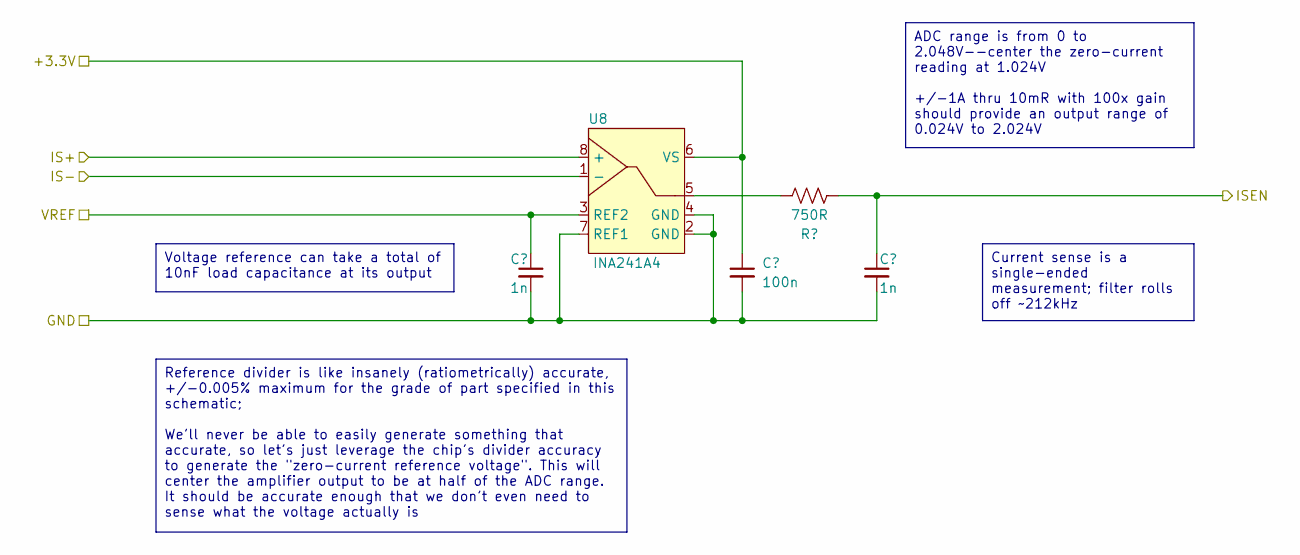
[picture p56: schematic shimamp_CurrentSensor10.kicad_sch, Shim Amplifier Prototype]

Parts:
C143, C145: 1n; C_0603_1608Metric_Pad1.08x0.95mm_HandSolder; Part Number CL10B102KB8NNNC
C144: 100n; C_0603_1608Metric_Pad1.08x0.95mm_HandSolder; Part Number CL10B104KB8NNWC
R47: 750R; R_0603_1608Metric_Pad0.98x0.95mm_HandSolder; Part Number RMCF0603FT750R
U8: INA241A4; SOT-23-8_Handsoldering; Part Number INA241A4IDDFR

Connections:
+3.3V: C144.1, U8.6 (VS); also elsewhere on the board
/ISEN10x: C145.1, R47.1; also elsewhere on the board
/Output Sensor/IS+: U8.8 (+); also elsewhere on the board
/Output Sensor/IS-: U8.1 (-); also elsewhere on the board
GND: C143.2, C144.2, C145.2, U8.2 (GND), U8.4 (GND), U8.7 (REF1); also elsewhere on the board
unnamed: R47.2, U8.5
V_{REF}: C143.1, U8.3 (REF2); also elsewhere on the board

Notes on the sheet:
Voltage reference can take a total of 10nF load capacitance at its output
Reference divider is like insanely (ratiometrically) accurate, +/-0.005% maximum for the grade of part specified in this schematic; We'll never be able to easily generate something that accurate, so let's just leverage the chip's divider accuracy to generate the "zero-current reference voltage". Th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
Current sense is a single-ended measurement; filter rolls off ~212kHz
ADC range is from 0 to 2.048V--center the zero-current reading at 1.024V +/-1A thru 10mR with 100x gain should provide an output range of 0.024V to 2.024V

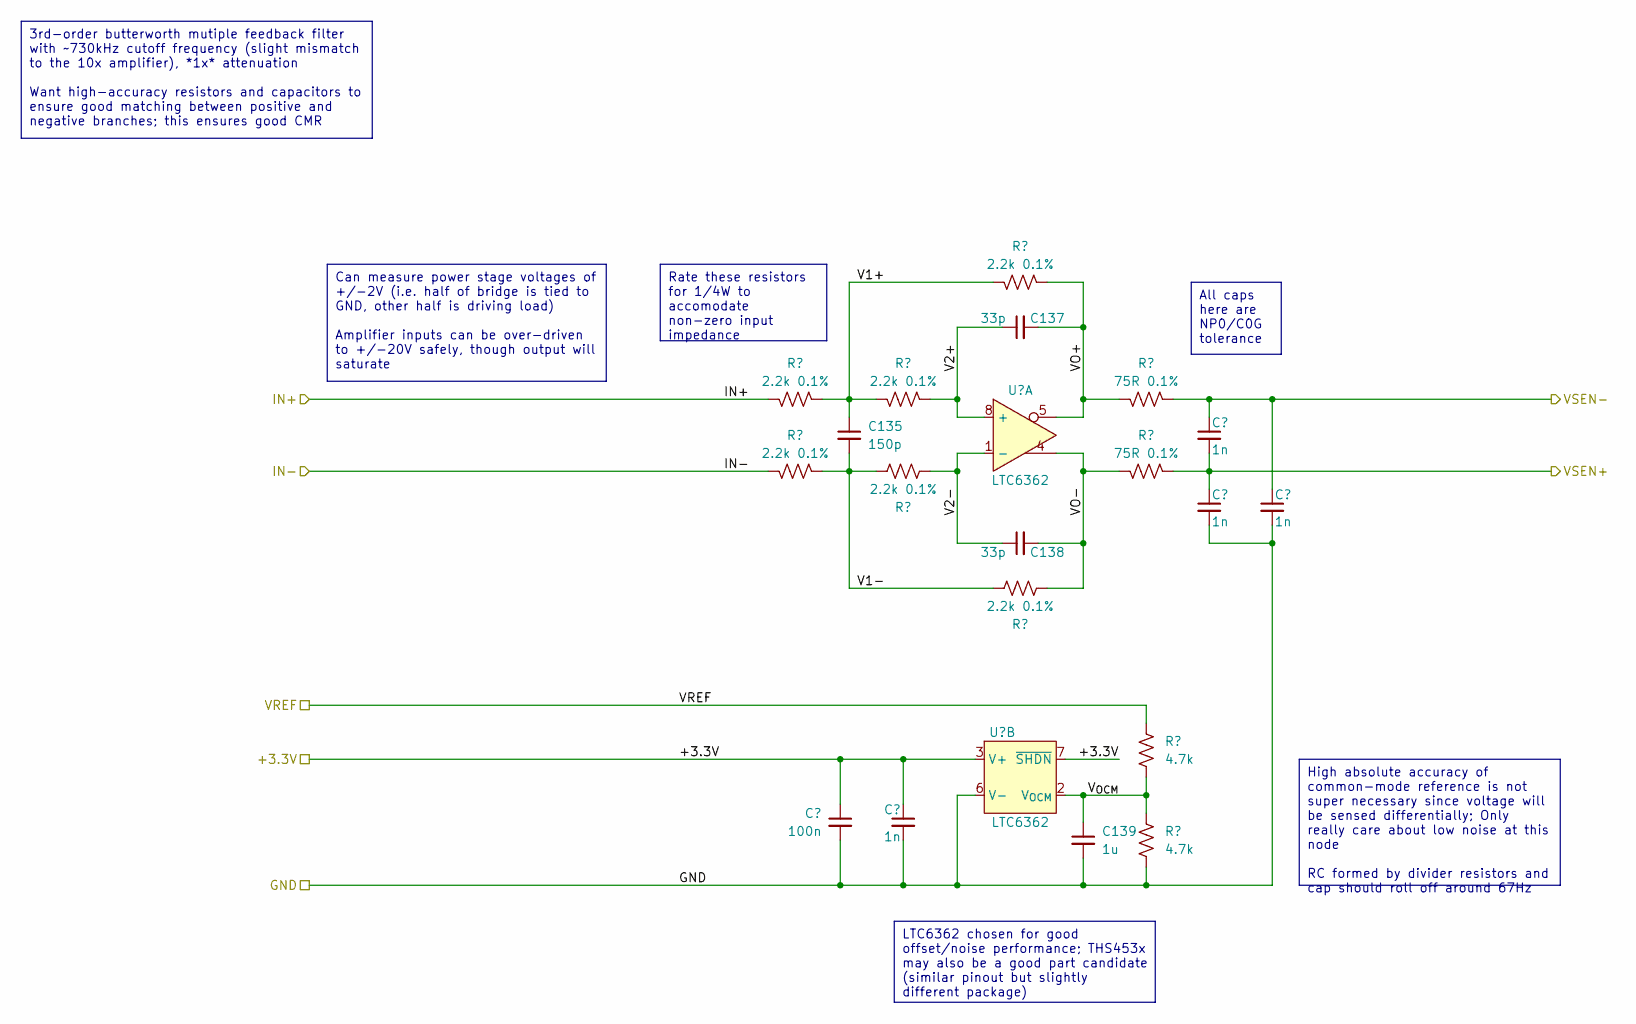
[picture p57: schematic shimamp_VoltageSensor1.kicad_sch, Shim Amplifier Prototype]

Parts:
C134: 100n; C_0603_1608Metric_Pad1.08x0.95mm_HandSolder; Part Number CL10B104KB8NNWC
C135: 150p; C_0603_1608Metric_Pad1.08x0.95mm_HandSolder; Part Number GCM1885C2A151JA16D
C136, C140, C141, C142: 1n; C_0603_1608Metric_Pad1.08x0.95mm_HandSolder; Part Number CL10B102KB8NNNC
C137, C138: 33p; C_0603_1608Metric_Pad1.08x0.95mm_HandSolder; Part Number GCM1885C2A330JA16D
C139: 1u; C_0805_2012Metric_Pad1.18x1.45mm_HandSolder; Part Number CL21B105KBFNNNG
R37, R38, R39, R40, R41, R42: 2.2k 0.1%; R_1206_3216Metric_Pad1.30x1.75mm_HandSolder; Part Number RN73R2BTTD2201B25
R43, R44: 75R 0.1%; R_0603_1608Metric_Pad0.98x0.95mm_HandSolder; Part Number RN73R1JTTD75R0B25
R45, R46: 4.7k; R_0603_1608Metric_Pad0.98x0.95mm_HandSolder; Part Number RMCF0603FT4K70
U7: LTC6362; MSOP-8_3x3mm_P0.65mm; Part Number LTC6362CMS8#TRPBF

Connections:
+3.3V: C134.1, C136.1, U7.3 (V+), U7.7 (~SHDN); also elsewhere on the board
/Output Sensor/IN+: R37.2; also elsewhere on the board
/Output Sensor/IN-: R38.2; also elsewhere on the board
/Output Sensor/Voltage Sensor 1x/V1+: C135.1, R37.1, R39.2, R41.2
/Output Sensor/Voltage Sensor 1x/V1-: C135.2, R38.1, R40.2, R42.2
/Output Sensor/Voltage Sensor 1x/V2+: C137.1, R39.1, U7.8 (+)
/Output Sensor/Voltage Sensor 1x/V2-: C138.1, R40.1, U7.1 (-)
/Output Sensor/Voltage Sensor 1x/VO+: C137.2, R41.1, R43.2, U7.5
/Output Sensor/Voltage Sensor 1x/VO-: C138.2, R42.1, R44.2, U7.4
/Output Sensor/Voltage Sensor 1x/V_{OCM}: C139.1, R45.2, R46.1, U7.2 (V_{OCM})
/VSEN1x+: C140.2, C141.1, R44.1; also elsewhere on the board
/VSEN1x-: C140.1, C142.1, R43.1; also elsewhere on the board
GND: C134.2, C136.2, C139.2, C141.2, C142.2, R46.2, U7.6 (V-); also elsewhere on the board
V_{REF}: R45.1; also elsewhere on the board

Notes on the sheet:
All caps here are NP0/C0G tolerance
LTC6362 chosen for good offset/noise performance; THS453x may also be a good part candidate (similar pinout but slightly different package)
Rate these resistors for 1/4W to accomodate non-zero input impedance
Can measure power stage voltages of +/-2V (i.e. half of bridge is tied to GND, other half is driving load) Amplifier inputs can be over-driven to +/-20V safely, though output will saturate
3rd-order butterworth mutiple feedback filter with ~730kHz cutoff frequency (slight mismatch to the 10x amplifier), *1x* attenuation Want high-accuracy resistors and capacitors to ensure good matching between positive and negative branches; this ensures good CMR
High absolute accuracy of common-mode reference is not super necessary since voltage will be sensed differentially; Only really care about low noise at this node RC formed by divider resistors and cap should roll off around 67Hz

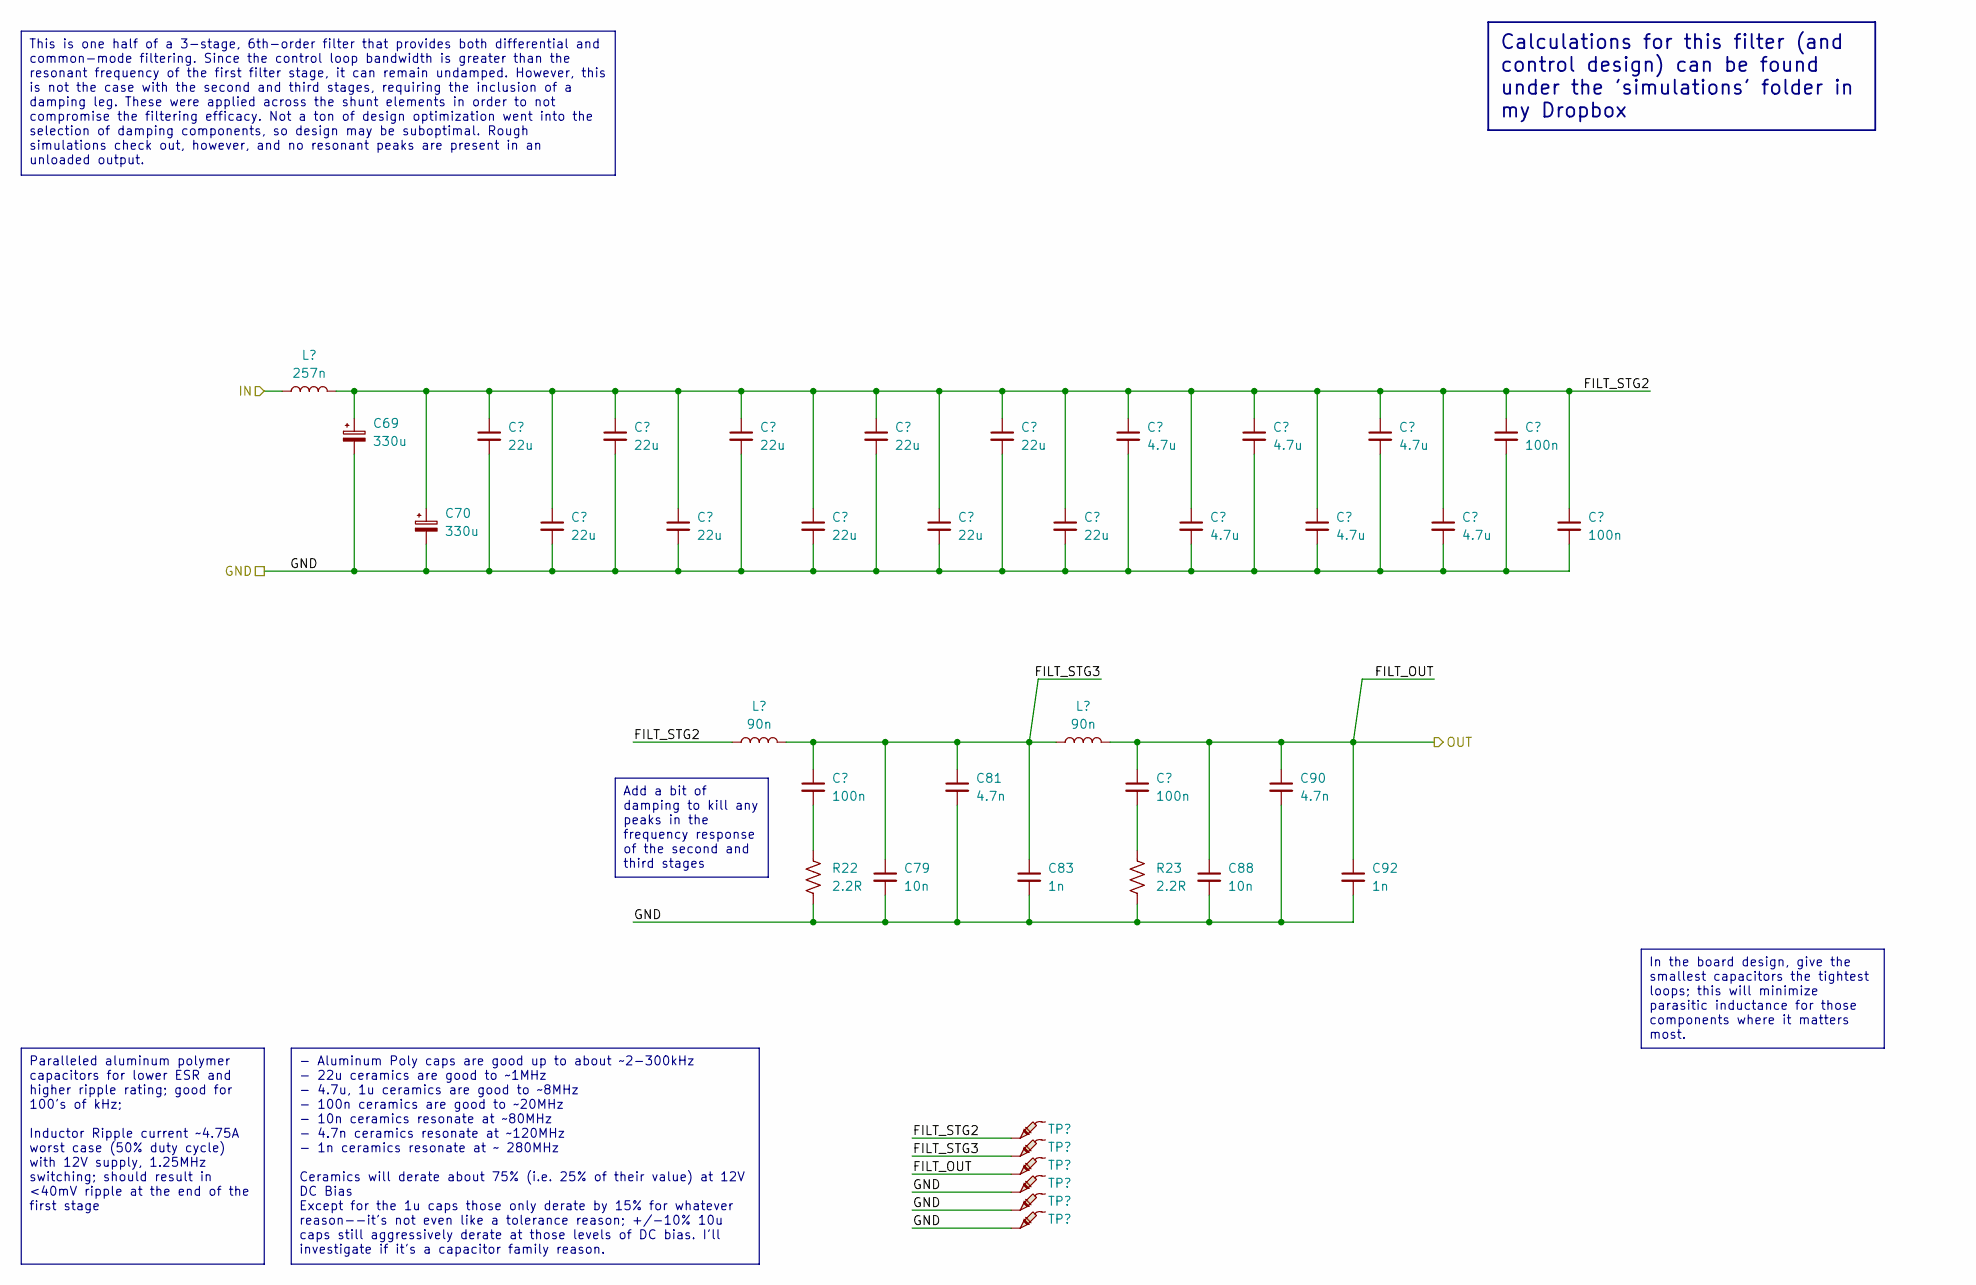
[picture p58: schematic shimamp_OutputFilterHalf.kicad_sch, Shim Amplifier Prototype]

Parts:
C69, C70: 330u; CP_Elec_10x12.6; Part Number 25SVPF330M
C71, C72, C73, C74, C75, C76, C78, C80, C82, C84: 22u; C_1210_3225Metric_Pad1.33x2.70mm_HandSolder; Part Number CL32B226KAJNNNE
C77, C86, C95, C96: 100n; C_0603_1608Metric_Pad1.08x0.95mm_HandSolder; Part Number CL10B104KB8NNWC
C79, C88: 10n; C_0603_1608Metric_Pad1.08x0.95mm_HandSolder; Part Number CL10B103KB8NNNC
C81, C90: 4.7n; C_0603_1608Metric_Pad1.08x0.95mm_HandSolder; Part Number CL10B472KB8NFNC
C83, C92: 1n; C_0603_1608Metric_Pad1.08x0.95mm_HandSolder; Part Number CL10B102KB8NNNC
C85, C87, C89, C91, C93, C94: 4.7u; C_0805_2012Metric_Pad1.18x1.45mm_HandSolder; Part Number CL21A475KLCLQNC
L2: 257n; COILCRAFT_2014; Part Number 2014VS-251MED
L3, L4: 90n; COILCRAFT_1212; Part Number 1212VS-90NMED
R22, R23: 2.2R; R_0805_2012Metric_Pad1.20x1.40mm_HandSolder; Part Number RPC0805JT2R20-UP
TP17, TP18, TP19, TP20, TP21, TP22: -; TestPoint_Pad_D2.0mm

Connections:
/Output Filter/Output Filter+/FILT_STG2: C69.1, C70.1, C71.1, C72.1, C73.1, C74.1, C75.1, C76.1, C78.1, C80.1, C82.1, C84.1, C85.1, C87.1, C89.1, C91.1, C93.1, C94.1, C95.1, C96.1, L2.1, L3.1, TP17.1
/Output Filter/Output Filter+/FILT_STG3: C77.1, C79.1, C81.1, C83.1, L3.2, L4.1, TP18.1
/Output Sensor/IN+: C86.1, C88.1, C90.1, C92.1, L4.2, TP19.1; also elsewhere on the board
/Power Stage/Power Stage Half Bridge+/SW: L2.2; also elsewhere on the board
GND: C69.2, C70.2, C71.2, C72.2, C73.2, C74.2, C75.2, C76.2, C78.2, C79.2, C80.2, C81.2, C82.2, C83.2, C84.2, C85.2, C87.2, C88.2, C89.2, C90.2, C91.2, C92.2, C93.2, C94.2, C95.2, C96.2, R22.2, R23.2, TP20.1, TP21.1, TP22.1; also elsewhere on the board
unnamed: C77.2, R22.1
unnamed: C86.2, R23.1

Parts of its further copies:
C97, C98: 330u; CP_Elec_10x12.6; Part Number 25SVPF330M
C99, C100, C101, C102, C103, C104, C106, C108, C110, C112: 22u; C_1210_3225Metric_Pad1.33x2.70mm_HandSolder; Part Number CL32B226KAJNNNE
C105, C114, C123, C124: 100n; C_0603_1608Metric_Pad1.08x0.95mm_HandSolder; Part Number CL10B104KB8NNWC
C107, C116: 10n; C_0603_1608Metric_Pad1.08x0.95mm_HandSolder; Part Number CL10B103KB8NNNC
C109, C118: 4.7n; C_0603_1608Metric_Pad1.08x0.95mm_HandSolder; Part Number CL10B472KB8NFNC
C111, C120: 1n; C_0603_1608Metric_Pad1.08x0.95mm_HandSolder; Part Number CL10B102KB8NNNC
C113, C115, C117, C119, C121, C122: 4.7u; C_0805_2012Metric_Pad1.18x1.45mm_HandSolder; Part Number CL21A475KLCLQNC
L5: 257n; COILCRAFT_2014; Part Number 2014VS-251MED
L6, L7: 90n; COILCRAFT_1212; Part Number 1212VS-90NMED
R24, R25: 2.2R; R_0805_2012Metric_Pad1.20x1.40mm_HandSolder; Part Number RPC0805JT2R20-UP
TP23, TP24, TP25, TP26, TP27, TP28: -; TestPoint_Pad_D2.0mm

Connections of its further copies:
/Output Filter/Output Filter-/FILT_STG2: C97.1, C98.1, C99.1, C100.1, C101.1, C102.1, C103.1, C104.1, C106.1, C108.1, C110.1, C112.1, C113.1, C115.1, C117.1, C119.1, C121.1, C122.1, C123.1, C124.1, L5.1, L6.1, TP23.1
/Output Filter/Output Filter-/FILT_STG3: C105.1, C107.1, C109.1, C111.1, L6.2, L7.1, TP24.1
/Output Sensor/IN-: C114.1, C116.1, C118.1, C120.1, L7.2, TP25.1; also elsewhere on the board
/Power Stage/Power Stage Half Bridge-/SW: L5.2; also elsewhere on the board
GND: C97.2, C98.2, C99.2, C100.2, C101.2, C102.2, C103.2, C104.2, C106.2, C107.2, C108.2, C109.2, C110.2, C111.2, C112.2, C113.2, C115.2, C116.2, C117.2, C118.2, C119.2, C120.2, C121.2, C122.2, C123.2, C124.2, R24.2, R25.2, TP26.1, TP27.1, TP28.1; also elsewhere on the board
unnamed: C105.2, R24.1
unnamed: C114.2, R25.1

Notes on the sheet:
Add a bit of damping to kill any peaks in the frequency response of the second and third stages
This is one half of a 3-stage, 6th-order filter that provides both differential and common-mode filtering. Since the control loop bandwidth is greater than the resonant frequency of the first filter stage, it can remain undamped. However, this is not the case with the second and third stages, requi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
Calculations for this filter (and control design) can be found under the 'simulations' folder in my Dropbox
- Aluminum Poly caps are good up to about ~2-300kHz - 22u ceramics are good to ~1MHz - 4.7u, 1u ceramics are good to ~8MHz - 100n ceramics are good to ~20MHz - 10n ceramics resonate at ~80MHz - 4.7n ceramics resonate at ~120MHz - 1n ceramics resonate at ~ 280MHz Ceramics will derate about 75% (i.e.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
Paralleled aluminum polymer capacitors for lower ESR and higher ripple rating; good for 100's of kHz; Inductor Ripple current ~4.75A worst case (50% duty cycle) with 12V supply, 1.25MHz switching; should result in <40mV ripple at the end of the first stage
In the board design, give the smallest capacitors the tightest loops; this will minimize parasitic inductance for those components where it matters most.

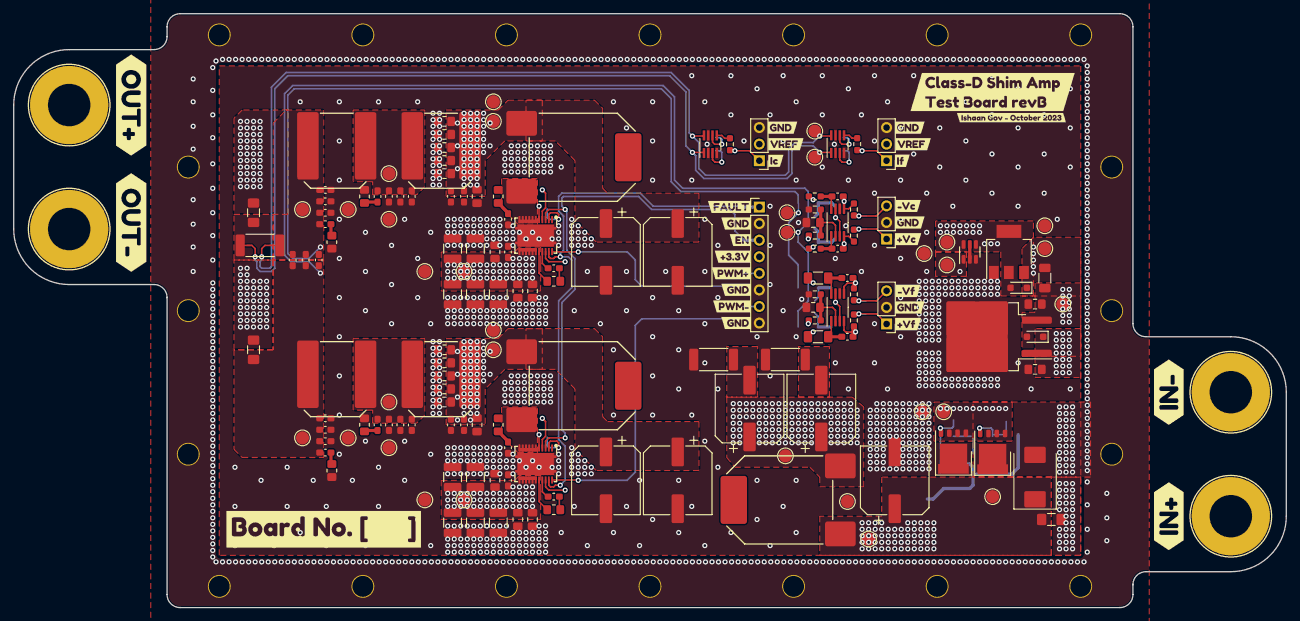
[picture p59: board Class-D Prototype RevB.kicad_pcb from above]

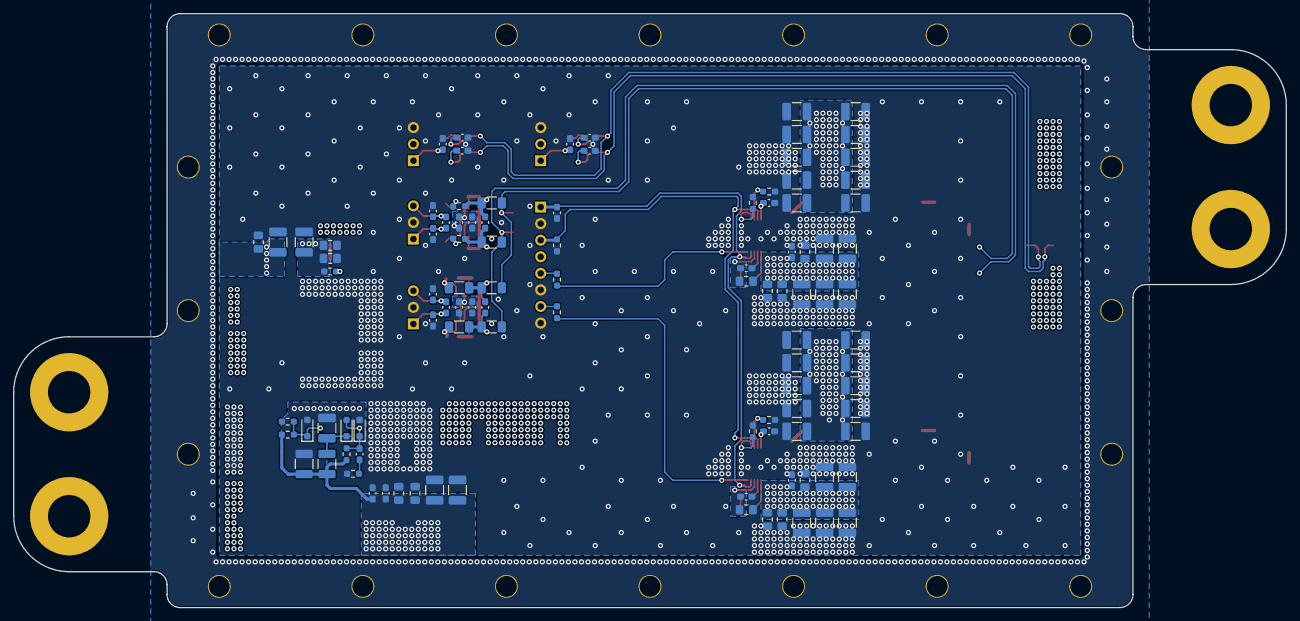
[picture p60: board Class-D Prototype RevB.kicad_pcb from below]

Board: 4 copper layers, 195.0 x 91.0 mm, 311 parts (101 on the bottom side), 73 nets.

Other parts of the board:
kibuzzard-6525E0C3: G***; kibuzzard-6525E0C3
kibuzzard-6525E1AD: G***; kibuzzard-6525E1AD
kibuzzard-6525E1B5: G***; kibuzzard-6525E1B5
kibuzzard-6525E1C4: G***; kibuzzard-6525E1C4
kibuzzard-6525E1D0: G***; kibuzzard-6525E1D0
kibuzzard-6525E1DB: G***; kibuzzard-6525E1DB
kibuzzard-6525E1FF: G***; kibuzzard-6525E1FF
kibuzzard-6525E2FE: G***; kibuzzard-6525E2FE
kibuzzard-6525E3DB: G***; kibuzzard-6525E3DB
kibuzzard-6525E19B: G***; kibuzzard-6525E19B
kibuzzard-6525E21C: G***; kibuzzard-6525E21C
kibuzzard-6525E23B: G***; kibuzzard-6525E23B
kibuzzard-6525E33F: G***; kibuzzard-6525E33F
kibuzzard-6525E43B: G***; kibuzzard-6525E43B
kibuzzard-6525E106: G***; kibuzzard-6525E106
kibuzzard-6525E114: G***; kibuzzard-6525E114
kibuzzard-6525E122: G***; kibuzzard-6525E122
kibuzzard-6525E130: G***; kibuzzard-6525E130
kibuzzard-6525E138: G***; kibuzzard-6525E138
kibuzzard-6525E140: G***; kibuzzard-6525E140
kibuzzard-6525E147: G***; kibuzzard-6525E147
kibuzzard-6525E213: G***; kibuzzard-6525E213
kibuzzard-6525E231: G***; kibuzzard-6525E231
kibuzzard-6525E244: G***; kibuzzard-6525E244
kibuzzard-6525E307: G***; kibuzzard-6525E307
kibuzzard-6525E349: G***; kibuzzard-6525E349
kibuzzard-6525E518: G***; kibuzzard-6525E518
