Govish/Shimamp-Hardware/Class-D Prototype revA/Class-D Prototype revA.kicad_pcb

## KiCad design Class-D Prototype revA/Class-D Prototype revA.kicad_pcb (2023-11-08, an earlier design)

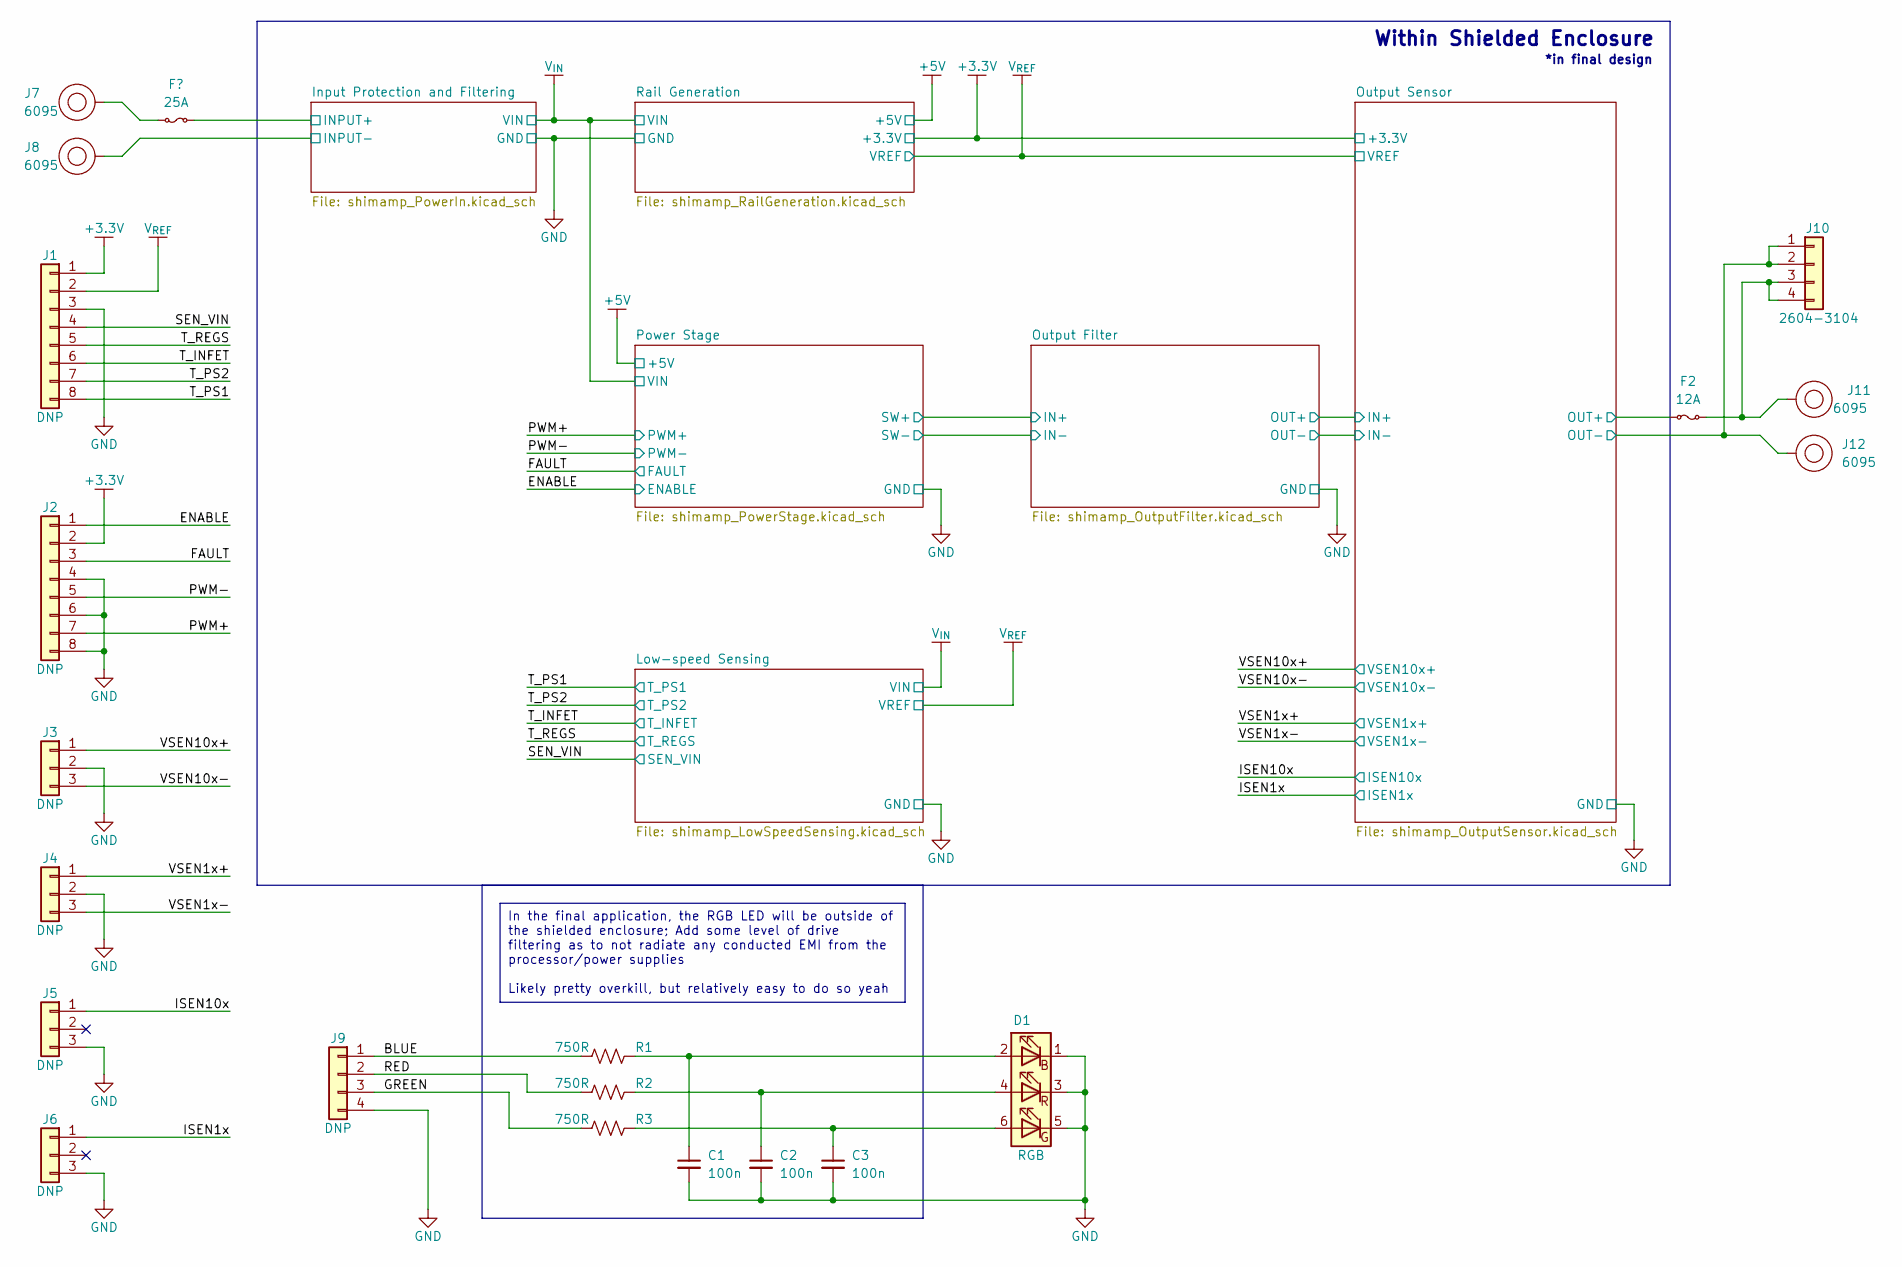
[picture p61: schematic Class-D Prototype revA.kicad_sch, Shim Amplifier Prototype]

Parts:
C1, C2, C3: 100n; C_0603_1608Metric_Pad1.08x0.95mm_HandSolder; Part Number CL10B104KB8NNWC
D1: RGB; LED_RGB_5050-6-WURTH; Part Number 150505M173300
F1: 25A; Fuse_1206_3216Metric_Pad1.42x1.75mm_HandSolder; Part Number 0685H9250-01
F2: 12A; Fuse_1206_3216Metric_Pad1.42x1.75mm_HandSolder; Part Number 0685H9120-01
J1, J2: DNP; PinHeader_1x08_P2.54mm_Vertical
J3, J4, J5, J6: DNP; PinHeader_1x03_P2.54mm_Vertical
J7, J8, J11, J12: 6095; Keystone 6095; Part Number 6095
J9: DNP; PinHeader_1x04_P2.54mm_Vertical
J10: 2604-3104; Wago_2604-3104; Part Number 2604-3104
R1, R2, R3: 750R; R_0603_1608Metric_Pad0.98x0.95mm_HandSolder; Part Number RMCF0603FT750R

Connections:
+3.3V: J1.1, J2.2; also elsewhere on the board
/BLUE: J9.1, R1.1
/ENABLE: J2.1; also elsewhere on the board
/FAULT: J2.3; also elsewhere on the board
/GREEN: J9.3, R3.1
/ISEN1x: J6.1; also elsewhere on the board
/ISEN10x: J5.1; also elsewhere on the board
/Input Protection and Filtering/INPUT-: J8.1; also elsewhere on the board
/Input Protection and Filtering/VIN_ICL+: F1.2; also elsewhere on the board
/Output Sensor/IN-: J10.1, J10.2, J12.1; also elsewhere on the board
/Output Sensor/OUT+: F2.1; also elsewhere on the board
/PWM+: J2.7; also elsewhere on the board
/PWM-: J2.5; also elsewhere on the board
/RED: J9.2, R2.1
/SEN_VIN: J1.4; also elsewhere on the board
/T_INFET: J1.6; also elsewhere on the board
/T_PS1: J1.8; also elsewhere on the board
/T_PS2: J1.7; also elsewhere on the board
/T_REGS: J1.5; also elsewhere on the board
/VSEN1x+: J4.1; also elsewhere on the board
/VSEN1x-: J4.3; also elsewhere on the board
/VSEN10x+: J3.1; also elsewhere on the board
/VSEN10x-: J3.3; also elsewhere on the board
GND: C1.2, C2.2, C3.2, D1.1 (BK), D1.3 (RK), D1.5 (GK), J1.3, J2.4, J2.6, J2.8, J3.2, J4.2, J5.3, J6.3, J9.4; also elsewhere on the board
unnamed: C1.1, D1.2 (BA), R1.2
unnamed: C3.1, D1.6 (GA), R3.2
unnamed: C2.1, D1.4 (RA), R2.2
unnamed: F1.1, J7.1
unnamed: F2.2, J10.3, J10.4, J11.1
V_{REF}: J1.2; also elsewhere on the board

Notes on the sheet:
In the final application, the RGB LED will be outside of the shielded enclosure; Add some level of drive filtering as to not radiate any conducted EMI from the processor/power supplies Likely pretty overkill, but relatively easy to do so yeah
*in final design
Within Shielded Enclosure

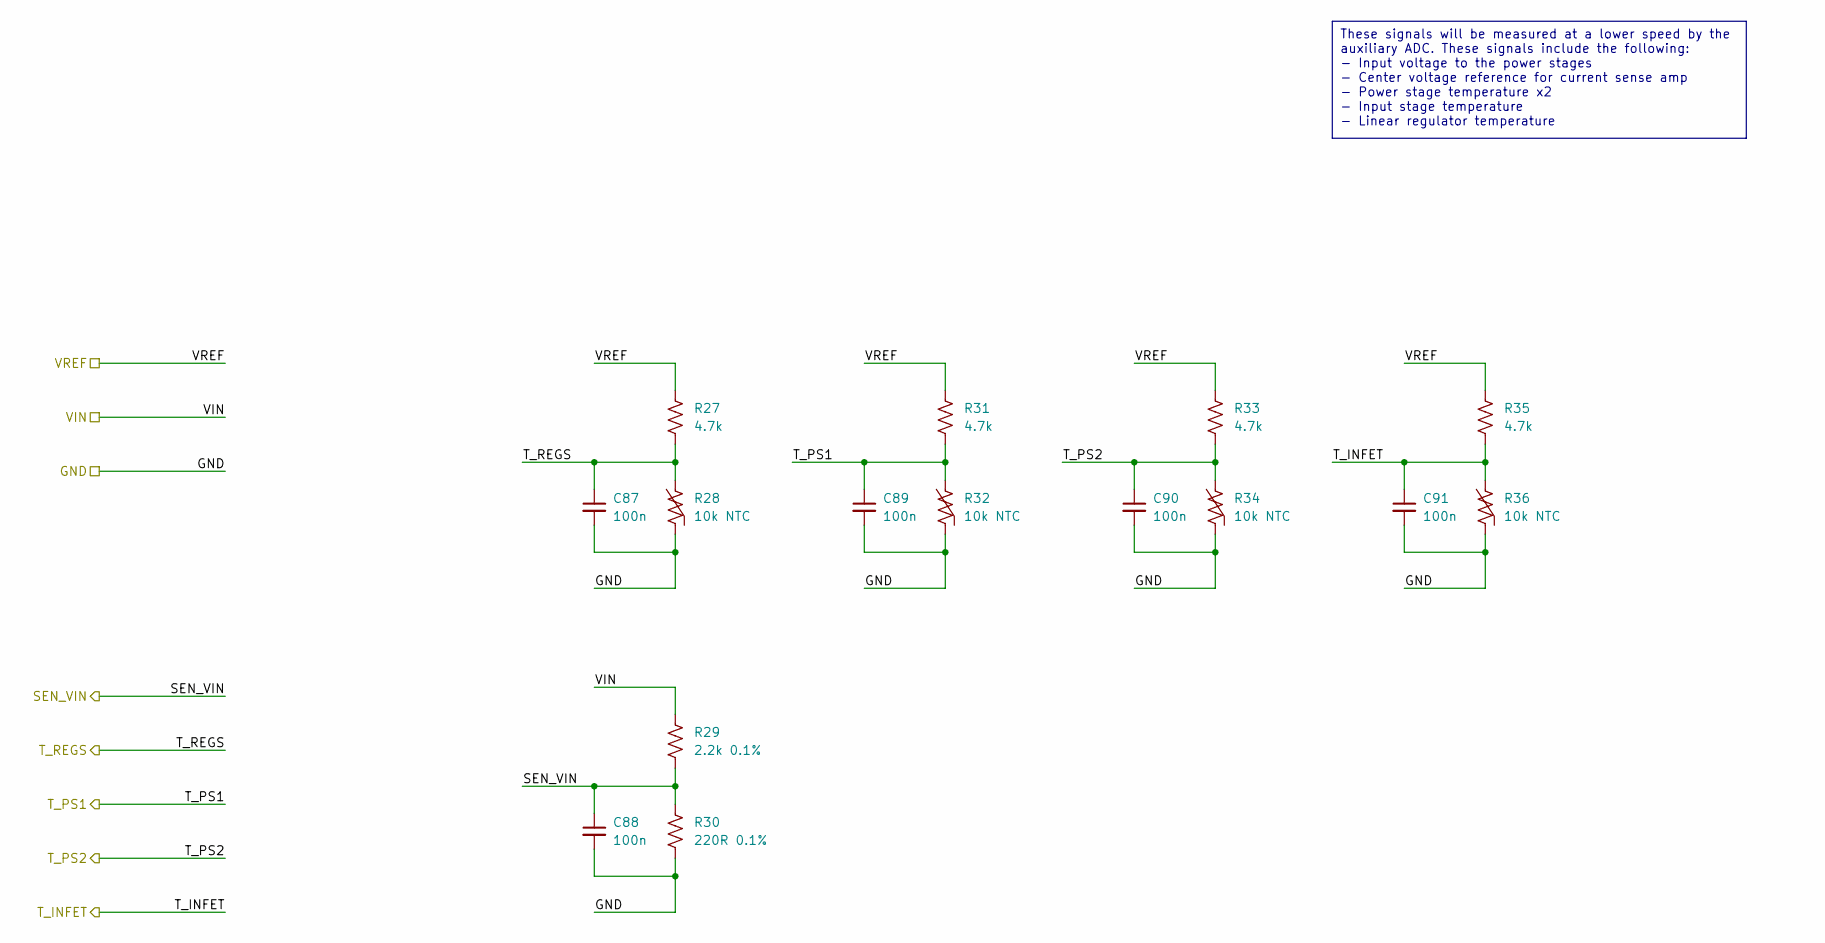
[picture p62: schematic shimamp_LowSpeedSensing.kicad_sch, Shim Amplifier Prototype]

Parts:
C87, C88, C89, C90, C91: 100n; C_0603_1608Metric_Pad1.08x0.95mm_HandSolder; Part Number CL10B104KB8NNWC
R27, R31, R33, R35: 4.7k; R_0603_1608Metric_Pad0.98x0.95mm_HandSolder; Part Number RMCF0603FT4K70
R28, R32, R34, R36: 10k NTC; R_0603_1608Metric_Pad0.98x0.95mm_HandSolder; Part Number B57330V2103F260
R29: 2.2k 0.1%; R_1206_3216Metric_Pad1.30x1.75mm_HandSolder; Part Number RN73R2BTTD2201B25
R30: 220R 0.1%; R_0603_1608Metric_Pad0.98x0.95mm_HandSolder; Part Number RN73R1JTTD2200B25

Connections:
/SEN_VIN: C88.1, R29.2, R30.1; also elsewhere on the board
/T_INFET: C91.1, R35.2, R36.1; also elsewhere on the board
/T_PS1: C89.1, R31.2, R32.1; also elsewhere on the board
/T_PS2: C90.1, R33.2, R34.1; also elsewhere on the board
/T_REGS: C87.1, R27.2, R28.1; also elsewhere on the board
GND: C87.2, C88.2, C89.2, C90.2, C91.2, R28.2, R30.2, R32.2, R34.2, R36.2; also elsewhere on the board
V_{IN}: R29.1; also elsewhere on the board
V_{REF}: R27.1, R31.1, R33.1, R35.1; also elsewhere on the board

Notes on the sheet:
These signals will be measured at a lower speed by the auxiliary ADC. These signals include the following: - Input voltage to the power stages - Center voltage reference for current sense amp - Power stage temperature x2 - Input stage temperature - Linear regulator temperature
