Govish/Shimamp-Hardware/Class-D Prototype revA/Class-D Prototype revA.kicad_pcb

## KiCad design Class-D Prototype revA/Class-D Prototype revA.kicad_pcb (continued)

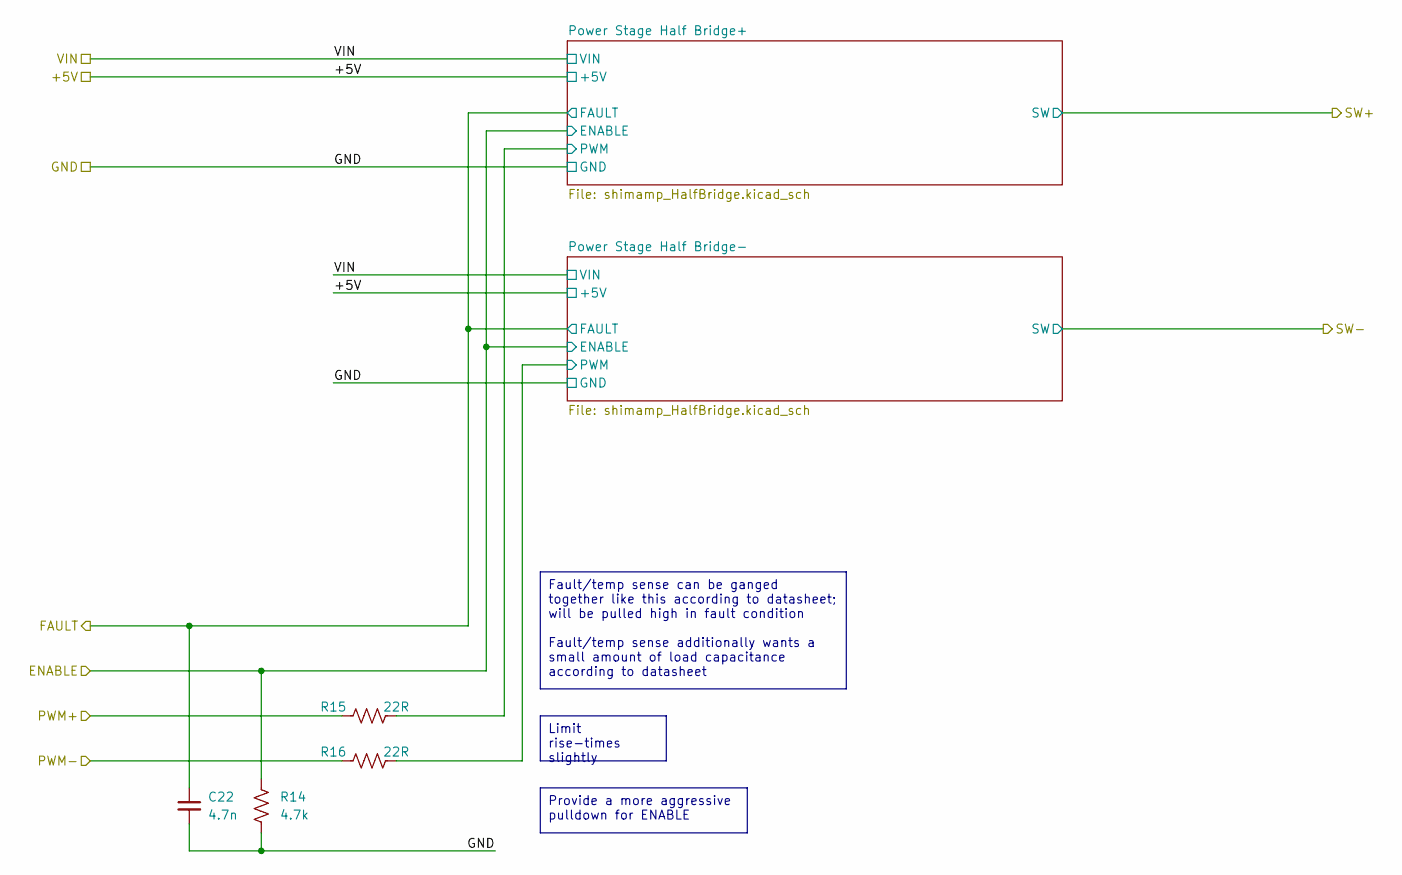
[picture p63: schematic shimamp_PowerStage.kicad_sch, Shim Amplifier Prototype]

Parts:
C22: 4.7n; C_0402_1005Metric_Pad0.74x0.62mm_HandSolder; Part Number CL05B472KB5NNNC
R14: 4.7k; R_0603_1608Metric_Pad0.98x0.95mm_HandSolder; Part Number RMCF0603FT4K70
R15, R16: 22R; R_0603_1608Metric_Pad0.98x0.95mm_HandSolder; Part Number RMCF0603FT22R0

Connections:
/ENABLE: R14.2; also elsewhere on the board
/FAULT: C22.1; also elsewhere on the board
/PWM+: R15.1; also elsewhere on the board
/PWM-: R16.1; also elsewhere on the board
/Power Stage/Power Stage Half Bridge+/PWM: R15.2; also elsewhere on the board
/Power Stage/Power Stage Half Bridge-/PWM: R16.2; also elsewhere on the board
GND: C22.2, R14.1; also elsewhere on the board

Notes on the sheet:
Limit rise-times slightly
Provide a more aggressive pulldown for ENABLE
Fault/temp sense can be ganged together like this according to datasheet; will be pulled high in fault condition Fault/temp sense additionally wants a small amount of load capacitance according to datasheet

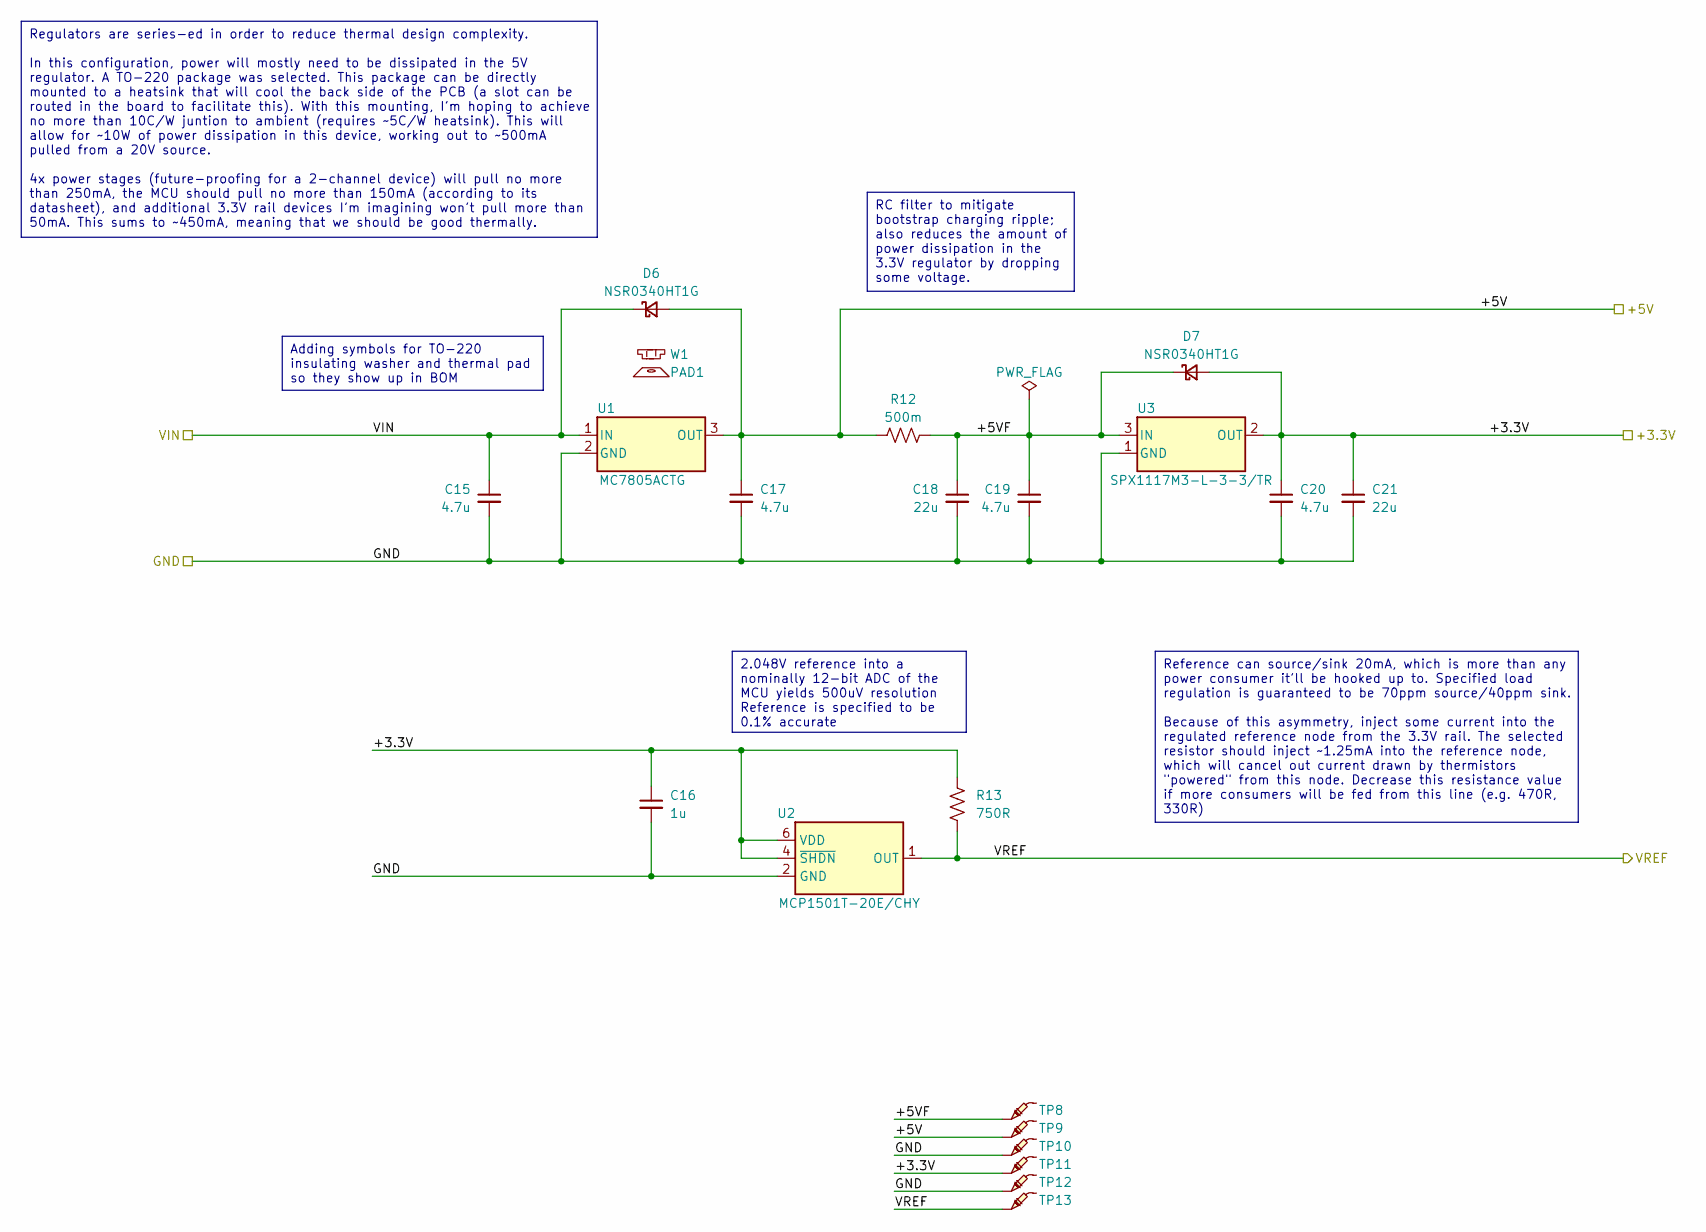
[picture p64: schematic shimamp_RailGeneration.kicad_sch, Shim Amplifier Prototype]

Parts:
C15, C17, C19, C20: 4.7u; C_0805_2012Metric_Pad1.18x1.45mm_HandSolder; Part Number CL21A475KLCLQNC
C16: 1u; C_0805_2012Metric_Pad1.18x1.45mm_HandSolder; Part Number CL21B105KBFNNNG
C18, C21: 22u; C_1210_3225Metric_Pad1.33x2.70mm_HandSolder; Part Number CL32B226KAJNNNE
D6, D7: NSR0340HT1G; D_SOD-323_HandSoldering; Part Number NSR0340HT1G
PAD1: 173-7-220P; Part Number 173-7-220P
R12: 500m; R_1206_3216Metric_Pad1.30x1.75mm_HandSolder; Part Number CSR1206FKR500
R13: 750R; R_0603_1608Metric_Pad0.98x0.95mm_HandSolder; Part Number RMCF0603FT750R
TP8, TP9, TP10, TP11, TP12, TP13: -; TestPoint_Pad_D2.0mm
U1: MC7805ACTG; TO-220-3_Horizontal_TabDown; Part Number MC7805ACTG
U2: MCP1501T-20E/CHY; SOT-23-6; Part Number MCP1501T-20E/CHY
U3: SPX1117M3-L-3-3/TR; SOT-223-3_TabPin2; Part Number SPX1117M3-L-3-3/TR
W1: INSULATING WASHER; Part Number V5359

Connections:
+3.3V: C16.1, C20.1, C21.1, D7.2 (A), R13.1, TP11.1, U2.4 (~SHDN), U2.6 (VDD), U3.2 (OUT); also elsewhere on the board
+5V: C17.1, D6.2 (A), R12.1, TP9.1, U1.3 (OUT); also elsewhere on the board
/Rail Generation/+5VF: C18.1, C19.1, D7.1 (K), R12.2, TP8.1, U3.3 (IN)
GND: C15.2, C16.2, C17.2, C18.2, C19.2, C20.2, C21.2, TP10.1, TP12.1, U1.2 (GND), U2.2 (GND), U2.3 (GND), U2.5 (GND), U3.1 (GND); also elsewhere on the board
V_{IN}: C15.1, D6.1 (K), U1.1 (IN); also elsewhere on the board
V_{REF}: R13.2, TP13.1, U2.1 (OUT); also elsewhere on the board

Notes on the sheet:
Regulators are series-ed in order to reduce thermal design complexity. In this configuration, power will mostly need to be dissipated in the 5V regulator. A TO-220 package was selected. This package can be directly mounted to a heatsink that will cool the back side of the PCB (a slot can be routed 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
2.048V reference into a nominally 12-bit ADC of the MCU yields 500uV resolution Reference is specified to be 0.1% accurate
Reference can source/sink 20mA, which is more than any power consumer it'll be hooked up to. Specified load regulation is guaranteed to be 70ppm source/40ppm sink. Because of this asymmetry, inject some current into the regulated reference node from the 3.3V rail. The selected resistor should injec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
Adding symbols for TO-220 insulating washer and thermal pad so they show up in BOM
RC filter to mitigate bootstrap charging ripple; also reduces the amount of power dissipation in the 3.3V regulator by dropping some voltage.

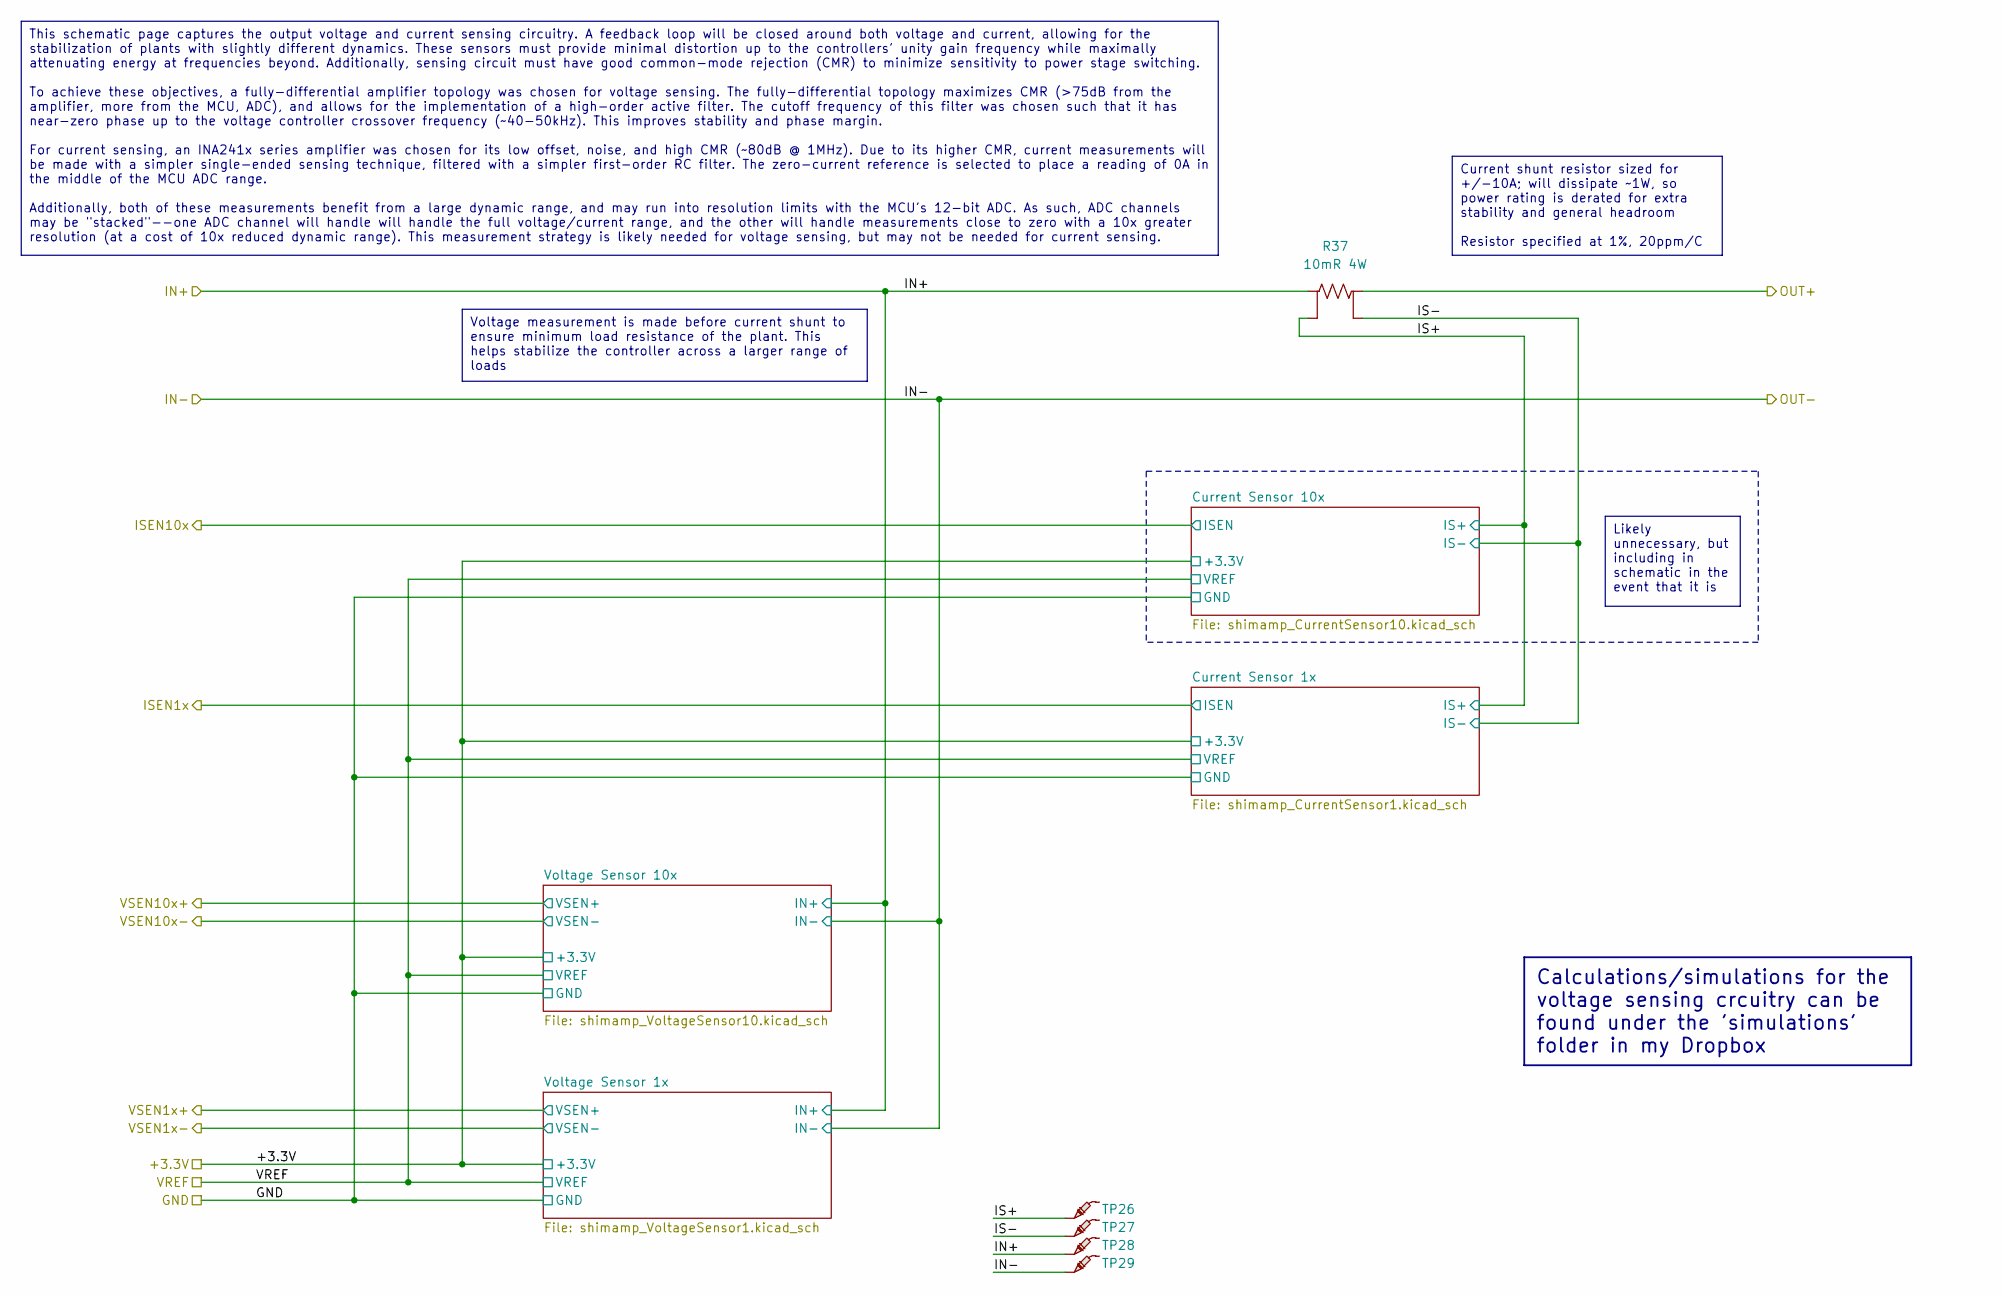
[picture p65: schematic shimamp_OutputSensor.kicad_sch, Shim Amplifier Prototype]

Parts:
R37: 10mR 4W; R_2512_6332_CURRENT_SHUNT; Part Number VMS-R010-1.0-U
TP26, TP27, TP28, TP29: -; TestPoint_Pad_D2.0mm

Connections:
/Output Sensor/IN+: R37.2, TP28.1; also elsewhere on the board
/Output Sensor/IN-: TP29.1; also elsewhere on the board
/Output Sensor/IS+: R37.4, TP26.1; also elsewhere on the board
/Output Sensor/IS-: R37.3, TP27.1; also elsewhere on the board
/Output Sensor/OUT+: R37.1; also elsewhere on the board

Notes on the sheet:
This schematic page captures the output voltage and current sensing circuitry. A feedback loop will be closed around both voltage and current, allowing for the stabilization of plants with slightly different dynamics. These sensors must provide minimal distortion up to the controllers' unity gain f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
Calculations/simulations for the voltage sensing crcuitry can be found under the 'simulations' folder in my Dropbox
Likely unnecessary, but including in schematic in the event that it is
Voltage measurement is made before current shunt to ensure minimum load resistance of the plant. This helps stabilize the controller across a larger range of loads
Current shunt resistor sized for +/-10A; will dissipate ~1W, so power rating is derated for extra stability and general headroom Resistor specified at 1%, 20ppm/C

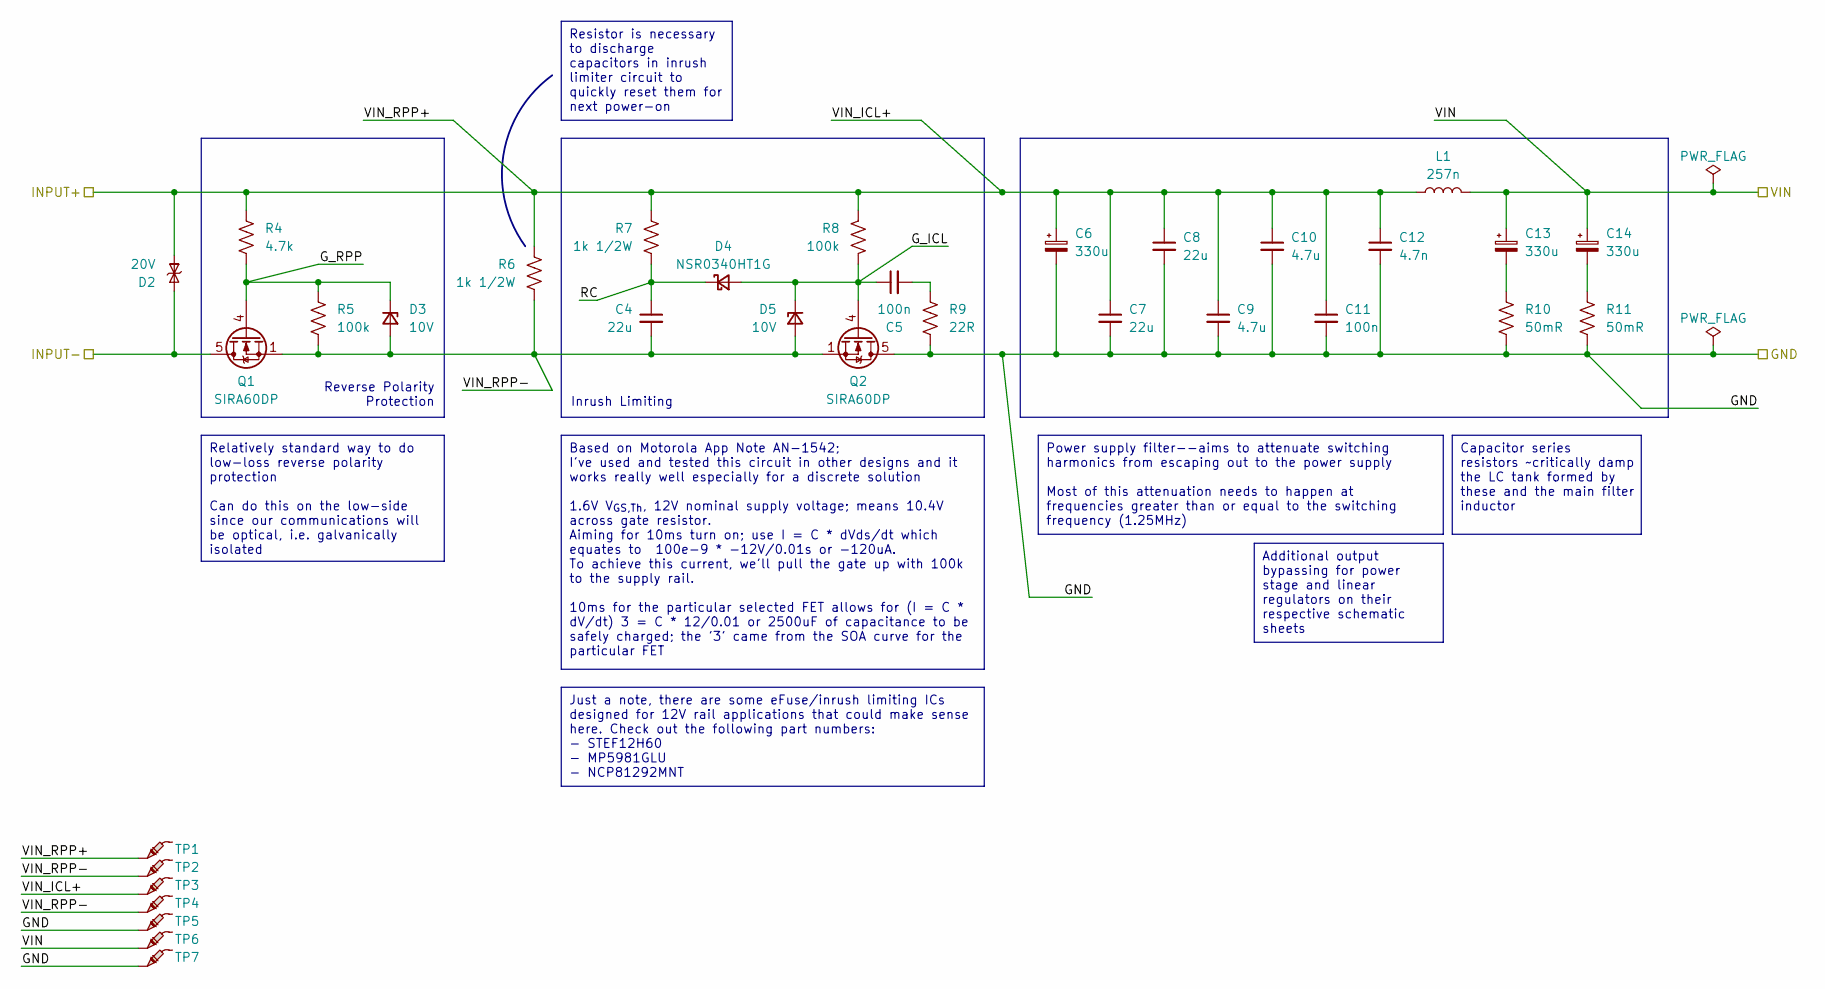
[picture p66: schematic shimamp_PowerIn.kicad_sch, Shim Amplifier Prototype]

Parts:
C4, C7, C8: 22u; C_1210_3225Metric_Pad1.33x2.70mm_HandSolder; Part Number CL32B226KAJNNNE
C5, C11: 100n; C_0603_1608Metric_Pad1.08x0.95mm_HandSolder; Part Number CL10B104KB8NNWC
C6, C13, C14: 330u; CP_Elec_10x12.6; Part Number 25SVPF330M
C9, C10: 4.7u; C_0805_2012Metric_Pad1.18x1.45mm_HandSolder; Part Number CL21A475KLCLQNC
C12: 4.7n; C_0402_1005Metric_Pad0.74x0.62mm_HandSolder; Part Number CL05B472KB5NNNC
D2: 20V; D_SMC; Part Number SMCJ20CA
D3, D5: 10V; D_SOD-323_HandSoldering; Part Number MM3Z10VC
D4: NSR0340HT1G; D_SOD-323_HandSoldering; Part Number NSR0340HT1G
L1: 257n; COILCRAFT_2014; Part Number 2014VS-251MED
Q1, Q2: SIRA60DP; PQFN-8-EP_6x5mm_P1.27mm_Generic; Part Number SIRA60DP-T1-GE3
R4: 4.7k; R_0603_1608Metric_Pad0.98x0.95mm_HandSolder; Part Number RMCF0603FT4K70
R5, R8: 100k; R_0603_1608Metric_Pad0.98x0.95mm_HandSolder; Part Number RMCF0603FT100K
R6, R7: 1k 1/2W; R_1210_3225Metric_Pad1.30x2.65mm_HandSolder; Part Number RMCF1210JT1K00
R9: 22R; R_0603_1608Metric_Pad0.98x0.95mm_HandSolder; Part Number RMCF0603FT22R0
R10, R11: 50mR; R_2512_6332Metric_Pad1.40x3.35mm_HandSolder; Part Number CSRN2512FK50L0
TP1, TP2, TP3, TP4, TP5, TP6, TP7: -; TestPoint_Pad_D2.0mm

Connections:
/Input Protection and Filtering/G_ICL: C5.1, D4.2 (A), D5.1 (K), Q2.4 (G), R8.2
/Input Protection and Filtering/G_RPP: D3.1 (K), Q1.4 (G), R4.2, R5.1
/Input Protection and Filtering/INPUT-: D2.2 (A), Q1.5 (D); also elsewhere on the board
/Input Protection and Filtering/RC: C4.1, D4.1 (K), R7.2
/Input Protection and Filtering/VIN_ICL+: C6.1, C7.1, C8.1, C9.1, C10.1, C11.1, C12.1, D2.1 (K), L1.1, R4.1, R6.1, R7.1, R8.1, TP1.1, TP3.1; also elsewhere on the board
/Input Protection and Filtering/VIN_RPP-: C4.2, D3.2 (A), D5.2 (A), Q1.1 (S), Q1.2 (S), Q1.3 (S), Q2.1 (S), Q2.2 (S), Q2.3 (S), R5.2, R6.2, TP2.1, TP4.1
GND: C6.2, C7.2, C8.2, C9.2, C10.2, C11.2, C12.2, Q2.5 (D), R9.2, R10.2, R11.2, TP5.1, TP7.1; also elsewhere on the board
unnamed: C5.2, R9.1
unnamed: C13.2, R10.1
unnamed: C14.2, R11.1
V_{IN}: C13.1, C14.1, L1.2, TP6.1; also elsewhere on the board

Notes on the sheet:
Additional output bypassing for power stage and linear regulators on their respective schematic sheets
Power supply filter--aims to attenuate switching harmonics from escaping out to the power supply Most of this attenuation needs to happen at frequencies greater than or equal to the switching frequency (1.25MHz)
Just a note, there are some eFuse/inrush limiting ICs designed for 12V rail applications that could make sense here. Check out the following part numbers: - STEF12H60 - MP5981GLU - NCP81292MNT
Based on Motorola App Note AN-1542; I've used and tested this circuit in other designs and it works really well especially for a discrete solution 1.6V V_{GS,Th}, 12V nominal supply voltage; means 10.4V across gate resistor. Aiming for 10ms turn on; use I = C * dVds/dt which equates to 100e-9 * -12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
Relatively standard way to do low-loss reverse polarity protection Can do this on the low-side since our communications will be optical, i.e. galvanically isolated
Resistor is necessary to discharge capacitors in inrush limiter circuit to quickly reset them for next power-on
Capacitor series resistors ~critically damp the LC tank formed by these and the main filter inductor
Inrush Limiting
Reverse Polarity Protection

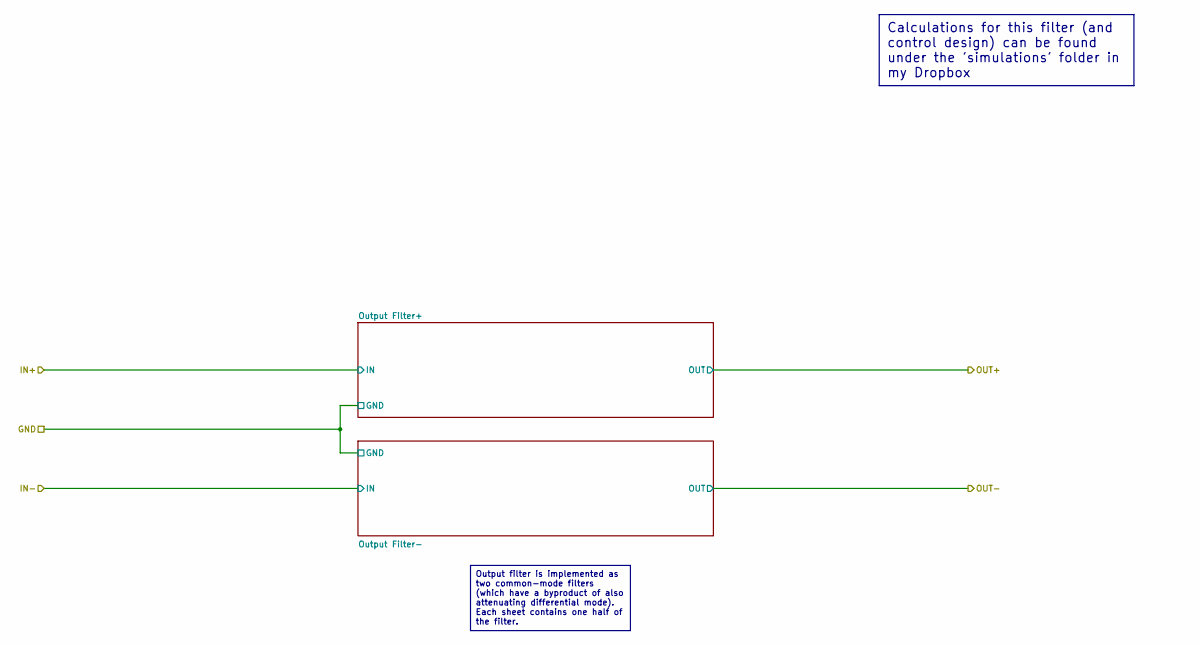
[picture p67: schematic shimamp_OutputFilter.kicad_sch, Shim Amplifier Prototype]

Notes on the sheet:
Output filter is implemented as two common-mode filters (which have a byproduct of also attenuating differential mode). Each sheet contains one half of the filter.
Calculations for this filter (and control design) can be found under the 'simulations' folder in my Dropbox

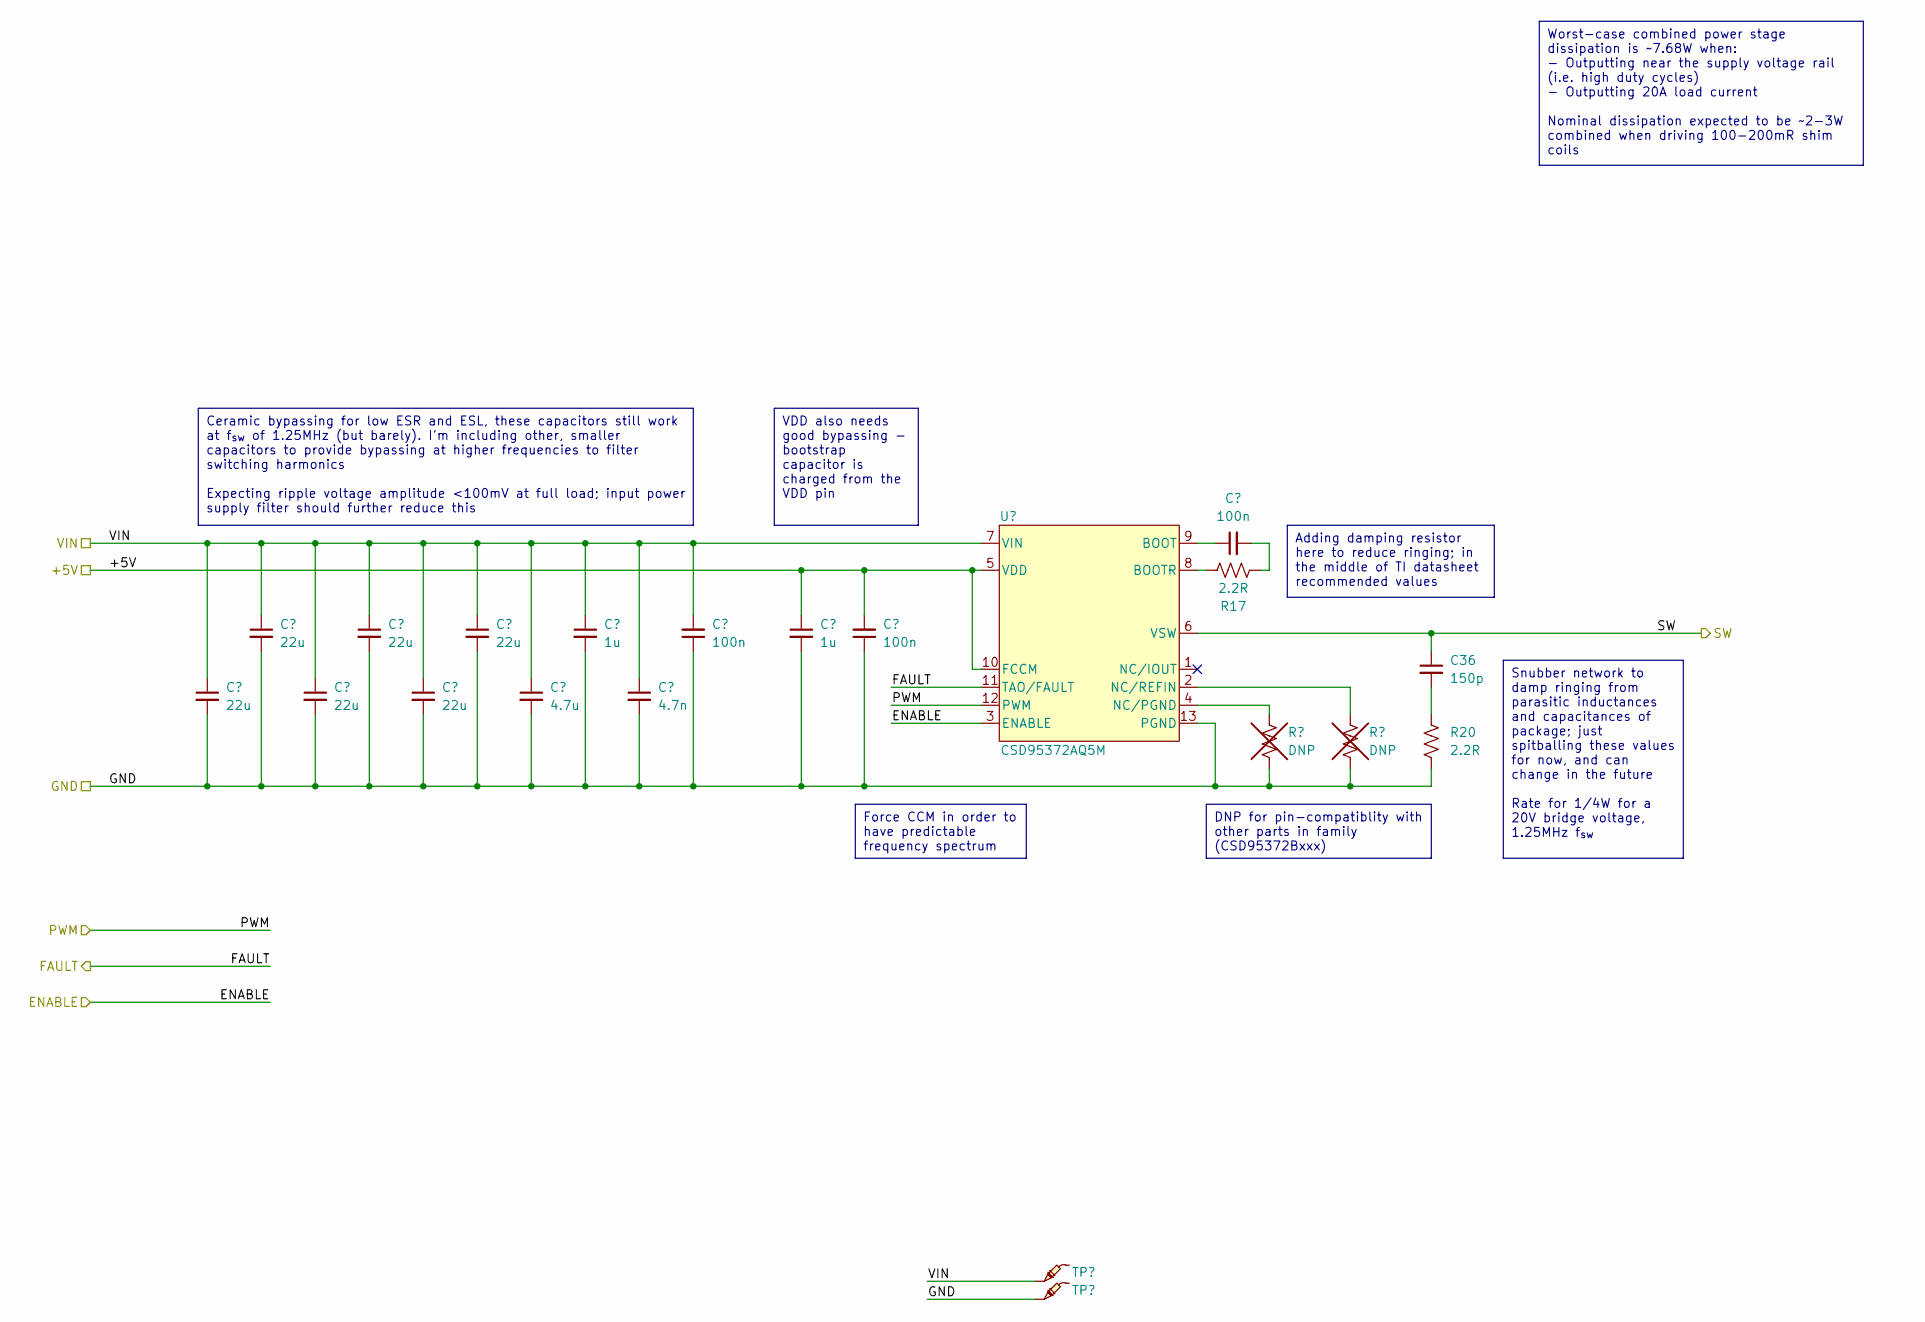
[picture p68: schematic shimamp_HalfBridge.kicad_sch, Shim Amplifier Prototype]

Parts:
C23, C24, C25, C26, C27, C28: 22u; C_1210_3225Metric_Pad1.33x2.70mm_HandSolder; Part Number CL32B226KAJNNNE
C29: 4.7u; C_0805_2012Metric_Pad1.18x1.45mm_HandSolder; Part Number CL21A475KLCLQNC
C30, C33: 1u; C_0805_2012Metric_Pad1.18x1.45mm_HandSolder; Part Number CL21B105KBFNNNG
C31: 4.7n; C_0402_1005Metric_Pad0.74x0.62mm_HandSolder; Part Number CL05B472KB5NNNC
C32, C34, C35: 100n; C_0603_1608Metric_Pad1.08x0.95mm_HandSolder; Part Number CL10B104KB8NNWC
C36: 150p; C_0603_1608Metric_Pad1.08x0.95mm_HandSolder; Part Number GCM1885C2A151JA16D
R17, R20: 2.2R; R_0805_2012Metric_Pad1.20x1.40mm_HandSolder; Part Number RPC0805JT2R20-UP
R18, R19: DNP; DNP_R_0603_1608Metric_Pad0.98x0.95mm_HandSolder
TP14, TP15: -; TestPoint_Pad_D2.0mm
U4: CSD95372AQ5M; LSON-12-1EP_5x6mm; Part Number CSD95372AQ5M

Connections:
+5V: C33.1, C34.2, U4.5 (VDD), U4.10 (FCCM); also elsewhere on the board
/ENABLE: U4.3 (ENABLE); also elsewhere on the board
/FAULT: U4.11 (TAO/FAULT); also elsewhere on the board
/Power Stage/Power Stage Half Bridge+/PWM: U4.12 (PWM); also elsewhere on the board
/Power Stage/Power Stage Half Bridge+/SW: C36.1, U4.6 (VSW); also elsewhere on the board
GND: C23.2, C24.2, C25.2, C26.2, C27.2, C28.2, C29.2, C30.2, C31.2, C32.1, C33.2, C34.1, R18.2, R19.2, R20.2, TP15.1, U4.13 (PGND); also elsewhere on the board
unnamed: C35.2, R17.2
unnamed: C36.2, R20.1
unnamed: C35.1, U4.9 (BOOT)
unnamed: R17.1, U4.8 (BOOTR)
unnamed: R18.1, U4.4 (NC/PGND)
unnamed: R19.1, U4.2 (NC/REFIN)
V_{IN}: C23.1, C24.1, C25.1, C26.1, C27.1, C28.1, C29.1, C30.1, C31.1, C32.2, TP14.1, U4.7 (VIN); also elsewhere on the board

Parts of its further copies:
C37, C38, C39, C40, C41, C42: 22u; C_1210_3225Metric_Pad1.33x2.70mm_HandSolder; Part Number CL32B226KAJNNNE
C43: 4.7u; C_0805_2012Metric_Pad1.18x1.45mm_HandSolder; Part Number CL21A475KLCLQNC
C44, C47: 1u; C_0805_2012Metric_Pad1.18x1.45mm_HandSolder; Part Number CL21B105KBFNNNG
C45: 4.7n; C_0402_1005Metric_Pad0.74x0.62mm_HandSolder; Part Number CL05B472KB5NNNC
C46, C48, C49: 100n; C_0603_1608Metric_Pad1.08x0.95mm_HandSolder; Part Number CL10B104KB8NNWC
C50: 150p; C_0603_1608Metric_Pad1.08x0.95mm_HandSolder; Part Number GCM1885C2A151JA16D
R21, R24: 2.2R; R_0805_2012Metric_Pad1.20x1.40mm_HandSolder; Part Number RPC0805JT2R20-UP
R22, R23: DNP; DNP_R_0603_1608Metric_Pad0.98x0.95mm_HandSolder
TP16, TP17: -; TestPoint_Pad_D2.0mm
U5: CSD95372AQ5M; LSON-12-1EP_5x6mm; Part Number CSD95372AQ5M

Connections of its further copies:
+5V: C47.1, C48.2, U5.5 (VDD), U5.10 (FCCM); also elsewhere on the board
/ENABLE: U5.3 (ENABLE); also elsewhere on the board
/FAULT: U5.11 (TAO/FAULT); also elsewhere on the board
/Power Stage/Power Stage Half Bridge-/PWM: U5.12 (PWM); also elsewhere on the board
/Power Stage/Power Stage Half Bridge-/SW: C50.1, U5.6 (VSW); also elsewhere on the board
GND: C37.2, C38.2, C39.2, C40.2, C41.2, C42.2, C43.2, C44.2, C45.2, C46.1, C47.2, C48.1, R22.2, R23.2, R24.2, TP17.1, U5.13 (PGND); also elsewhere on the board
unnamed: C49.2, R21.2
unnamed: C50.2, R24.1
unnamed: C49.1, U5.9 (BOOT)
unnamed: R21.1, U5.8 (BOOTR)
unnamed: R22.1, U5.4 (NC/PGND)
unnamed: R23.1, U5.2 (NC/REFIN)
V_{IN}: C37.1, C38.1, C39.1, C40.1, C41.1, C42.1, C43.1, C44.1, C45.1, C46.2, TP16.1, U5.7 (VIN); also elsewhere on the board

Notes on the sheet:
Worst-case combined power stage dissipation is ~7.68W when: - Outputting near the supply voltage rail (i.e. high duty cycles) - Outputting 20A load current Nominal dissipation expected to be ~2-3W combined when driving 100-200mR shim coils
Adding damping resistor here to reduce ringing; in the middle of TI datasheet recommended values
VDD also needs good bypassing - bootstrap capacitor is charged from the VDD pin
DNP for pin-compatiblity with other parts in family (CSD95372Bxxx)
Force CCM in order to have predictable frequency spectrum
Ceramic bypassing for low ESR and ESL, these capacitors still work at f_{sw} of 1.25MHz (but barely). I'm including other, smaller capacitors to provide bypassing at higher frequencies to filter switching harmonics Expecting ripple voltage amplitude <100mV at full load; input power supply filter sh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
Snubber network to damp ringing from parasitic inductances and capacitances of package; just spitballing these values for now, and can change in the future Rate for 1/4W for a 20V bridge voltage, 1.25MHz f_{sw}

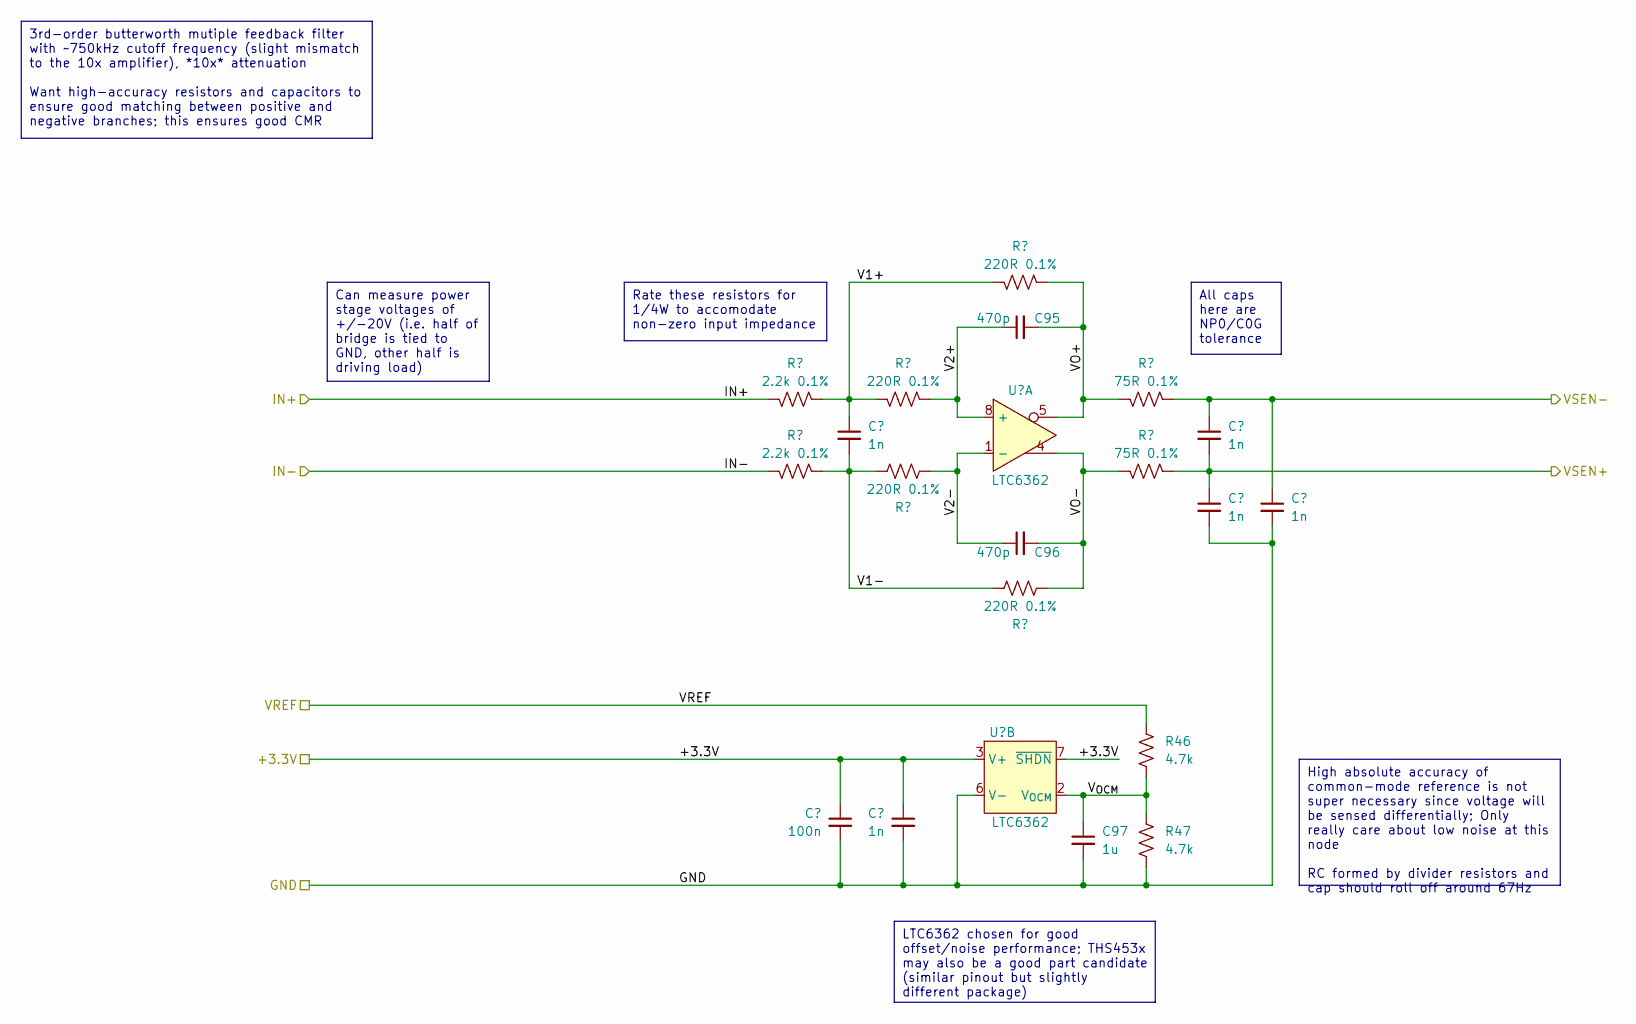
[picture p69: schematic shimamp_VoltageSensor10.kicad_sch, Shim Amplifier Prototype]

Parts:
C92: 100n; C_0603_1608Metric_Pad1.08x0.95mm_HandSolder; Part Number CL10B104KB8NNWC
C93, C94, C98, C99, C100: 1n; C_0603_1608Metric_Pad1.08x0.95mm_HandSolder; Part Number GCM1885C2A102FA16D
C95, C96: 470p; C_0603_1608Metric_Pad1.08x0.95mm_HandSolder; Part Number GCM1885C2A471FA16D
C97: 1u; C_0805_2012Metric_Pad1.18x1.45mm_HandSolder; Part Number CL21B105KBFNNNG
R38, R39: 2.2k 0.1%; R_1206_3216Metric_Pad1.30x1.75mm_HandSolder; Part Number RN73R2BTTD2201B25
R40, R41, R42, R43: 220R 0.1%; R_0603_1608Metric_Pad0.98x0.95mm_HandSolder; Part Number RN73R1JTTD2200B25
R44, R45: 75R 0.1%; R_0603_1608Metric_Pad0.98x0.95mm_HandSolder; Part Number RN73R1JTTD75R0B25
R46, R47: 4.7k; R_0603_1608Metric_Pad0.98x0.95mm_HandSolder; Part Number RMCF0603FT4K70
U6: LTC6362; MSOP-8_3x3mm_P0.65mm; Part Number LTC6362CMS8#TRPBF

Connections:
+3.3V: C92.1, C94.1, U6.3 (V+), U6.7 (~SHDN); also elsewhere on the board
/Output Sensor/IN+: R38.2; also elsewhere on the board
/Output Sensor/IN-: R39.2; also elsewhere on the board
/Output Sensor/Voltage Sensor 10x/V1+: C93.1, R38.1, R40.2, R42.2
/Output Sensor/Voltage Sensor 10x/V1-: C93.2, R39.1, R41.2, R43.2
/Output Sensor/Voltage Sensor 10x/V2+: C95.1, R40.1, U6.8 (+)
/Output Sensor/Voltage Sensor 10x/V2-: C96.1, R41.1, U6.1 (-)
/Output Sensor/Voltage Sensor 10x/VO+: C95.2, R42.1, R44.2, U6.5
/Output Sensor/Voltage Sensor 10x/VO-: C96.2, R43.1, R45.2, U6.4
/Output Sensor/Voltage Sensor 10x/V_{OCM}: C97.1, R46.2, R47.1, U6.2 (V_{OCM})
/VSEN10x+: C98.2, C99.1, R45.1; also elsewhere on the board
/VSEN10x-: C98.1, C100.1, R44.1; also elsewhere on the board
GND: C92.2, C94.2, C97.2, C99.2, C100.2, R47.2, U6.6 (V-); also elsewhere on the board
V_{REF}: R46.1; also elsewhere on the board

Notes on the sheet:
LTC6362 chosen for good offset/noise performance; THS453x may also be a good part candidate (similar pinout but slightly different package)
3rd-order butterworth mutiple feedback filter with ~750kHz cutoff frequency (slight mismatch to the 10x amplifier), *10x* attenuation Want high-accuracy resistors and capacitors to ensure good matching between positive and negative branches; this ensures good CMR
All caps here are NP0/C0G tolerance
Rate these resistors for 1/4W to accomodate non-zero input impedance
Can measure power stage voltages of +/-20V (i.e. half of bridge is tied to GND, other half is driving load)
High absolute accuracy of common-mode reference is not super necessary since voltage will be sensed differentially; Only really care about low noise at this node RC formed by divider resistors and cap should roll off around 67Hz

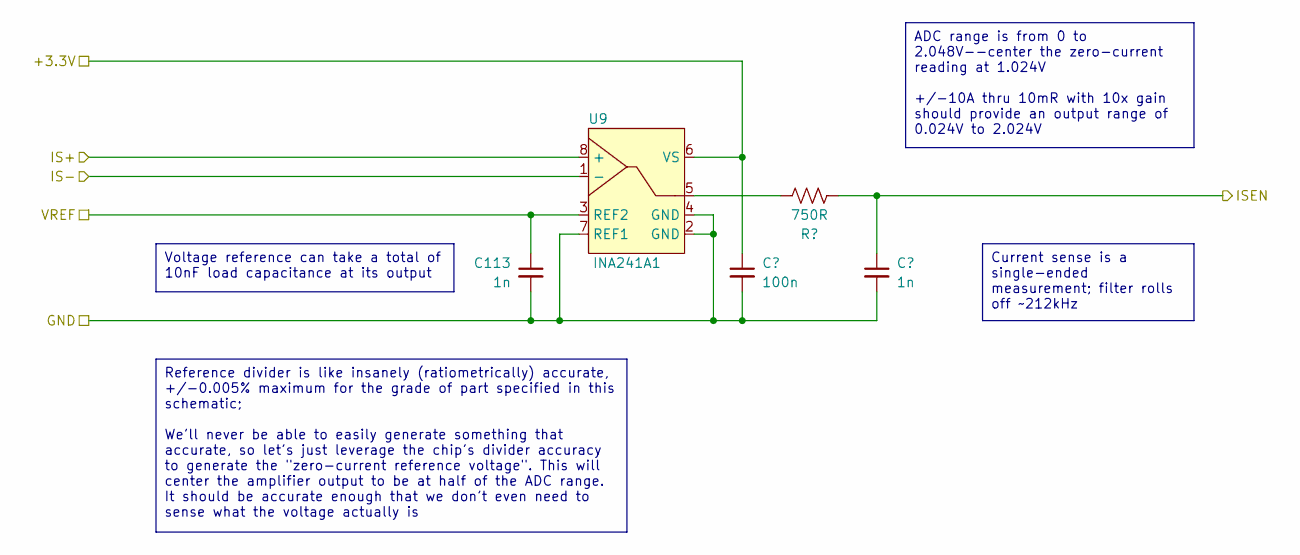
[picture p70: schematic shimamp_CurrentSensor1.kicad_sch, Shim Amplifier Prototype]

Parts:
C113, C115: 1n; C_0603_1608Metric_Pad1.08x0.95mm_HandSolder; Part Number GCM1885C2A102FA16D
C114: 100n; C_0603_1608Metric_Pad1.08x0.95mm_HandSolder; Part Number CL10B104KB8NNWC
R59: 750R; R_0603_1608Metric_Pad0.98x0.95mm_HandSolder; Part Number RMCF0603FT750R
U9: INA241A1; SOT-23-8_Handsoldering; Part Number INA241A1IDDFR

Connections:
+3.3V: C114.1, U9.6 (VS); also elsewhere on the board
/ISEN1x: C115.1, R59.1; also elsewhere on the board
/Output Sensor/IS+: U9.8 (+); also elsewhere on the board
/Output Sensor/IS-: U9.1 (-); also elsewhere on the board
GND: C113.2, C114.2, C115.2, U9.2 (GND), U9.4 (GND), U9.7 (REF1); also elsewhere on the board
unnamed: R59.2, U9.5
V_{REF}: C113.1, U9.3 (REF2); also elsewhere on the board

Notes on the sheet:
Current sense is a single-ended measurement; filter rolls off ~212kHz
ADC range is from 0 to 2.048V--center the zero-current reading at 1.024V +/-10A thru 10mR with 10x gain should provide an output range of 0.024V to 2.024V
Reference divider is like insanely (ratiometrically) accurate, +/-0.005% maximum for the grade of part specified in this schematic; We'll never be able to easily generate something that accurate, so let's just leverage the chip's divider accuracy to generate the "zero-current reference voltage". Th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
Voltage reference can take a total of 10nF load capacitance at its output
