Govish/Shimamp-Hardware/Class-D Prototype revA/Class-D Prototype revA.kicad_pcb

## KiCad design Class-D Prototype revA/Class-D Prototype revA.kicad_pcb (continued)

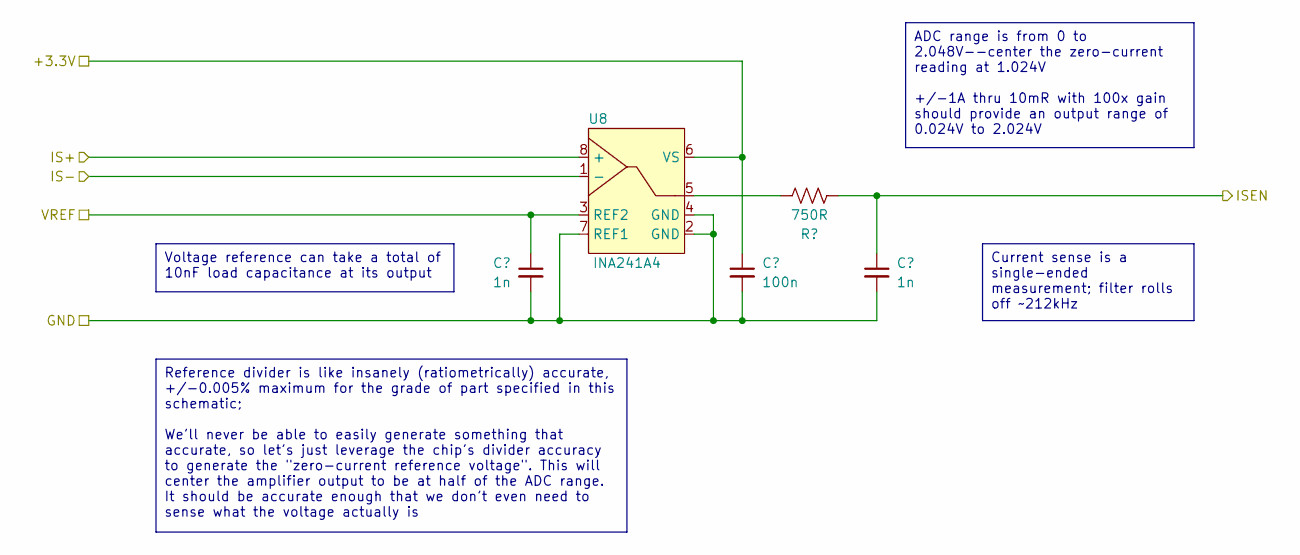
[picture p71: schematic shimamp_CurrentSensor10.kicad_sch, Shim Amplifier Prototype]

Parts:
C110, C112: 1n; C_0603_1608Metric_Pad1.08x0.95mm_HandSolder; Part Number GCM1885C2A102FA16D
C111: 100n; C_0603_1608Metric_Pad1.08x0.95mm_HandSolder; Part Number CL10B104KB8NNWC
R58: 750R; R_0603_1608Metric_Pad0.98x0.95mm_HandSolder; Part Number RMCF0603FT750R
U8: INA241A4; SOT-23-8_Handsoldering; Part Number INA241A4IDDFR

Connections:
+3.3V: C111.1, U8.6 (VS); also elsewhere on the board
/ISEN10x: C112.1, R58.1; also elsewhere on the board
/Output Sensor/IS+: U8.8 (+); also elsewhere on the board
/Output Sensor/IS-: U8.1 (-); also elsewhere on the board
GND: C110.2, C111.2, C112.2, U8.2 (GND), U8.4 (GND), U8.7 (REF1); also elsewhere on the board
unnamed: R58.2, U8.5
V_{REF}: C110.1, U8.3 (REF2); also elsewhere on the board

Notes on the sheet:
Voltage reference can take a total of 10nF load capacitance at its output
Reference divider is like insanely (ratiometrically) accurate, +/-0.005% maximum for the grade of part specified in this schematic; We'll never be able to easily generate something that accurate, so let's just leverage the chip's divider accuracy to generate the "zero-current reference voltage". Th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
Current sense is a single-ended measurement; filter rolls off ~212kHz
ADC range is from 0 to 2.048V--center the zero-current reading at 1.024V +/-1A thru 10mR with 100x gain should provide an output range of 0.024V to 2.024V

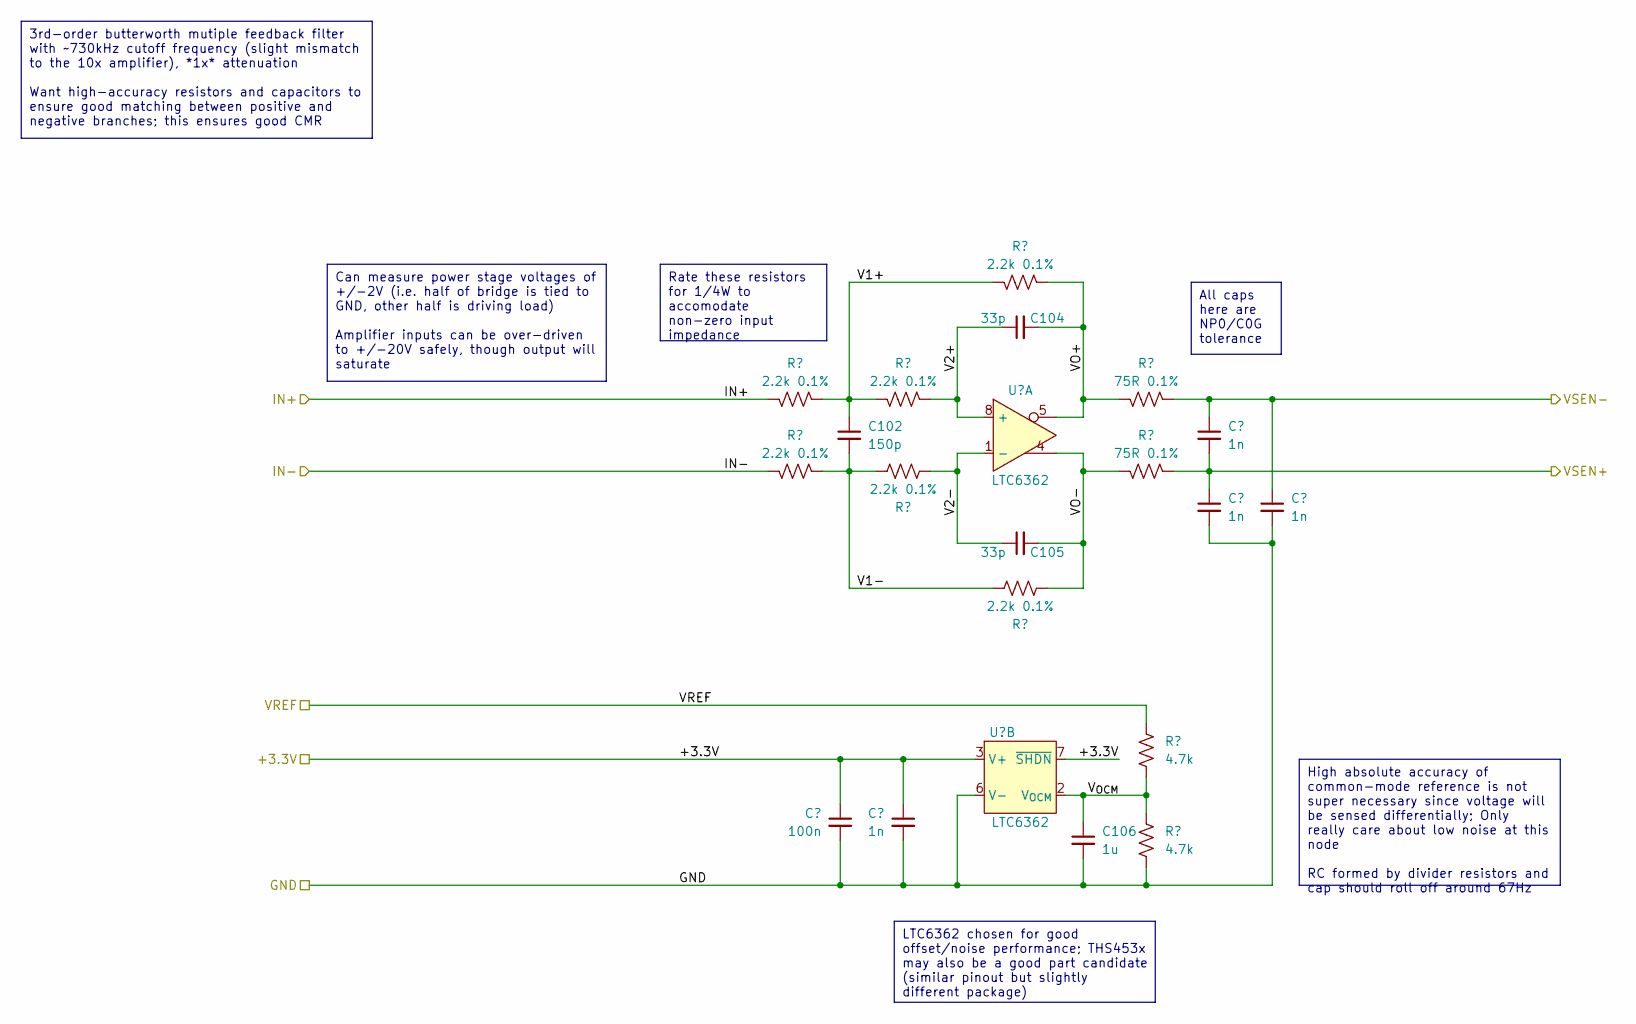
[picture p72: schematic shimamp_VoltageSensor1.kicad_sch, Shim Amplifier Prototype]

Parts:
C101: 100n; C_0603_1608Metric_Pad1.08x0.95mm_HandSolder; Part Number CL10B104KB8NNWC
C102: 150p; C_0603_1608Metric_Pad1.08x0.95mm_HandSolder; Part Number GCM1885C2A151JA16D
C103, C107, C108, C109: 1n; C_0603_1608Metric_Pad1.08x0.95mm_HandSolder; Part Number GCM1885C2A102FA16D
C104, C105: 33p; C_0603_1608Metric_Pad1.08x0.95mm_HandSolder; Part Number GCM1885C2A330JA16D
C106: 1u; C_0805_2012Metric_Pad1.18x1.45mm_HandSolder; Part Number CL21B105KBFNNNG
R48, R49, R50, R51, R52, R53: 2.2k 0.1%; R_1206_3216Metric_Pad1.30x1.75mm_HandSolder; Part Number RN73R2BTTD2201B25
R54, R55: 75R 0.1%; R_0603_1608Metric_Pad0.98x0.95mm_HandSolder; Part Number RN73R1JTTD75R0B25
R56, R57: 4.7k; R_0603_1608Metric_Pad0.98x0.95mm_HandSolder; Part Number RMCF0603FT4K70
U7: LTC6362; MSOP-8_3x3mm_P0.65mm; Part Number LTC6362CMS8#TRPBF

Connections:
+3.3V: C101.1, C103.1, U7.3 (V+), U7.7 (~SHDN); also elsewhere on the board
/Output Sensor/IN+: R48.2; also elsewhere on the board
/Output Sensor/IN-: R49.2; also elsewhere on the board
/Output Sensor/Voltage Sensor 1x/V1+: C102.1, R48.1, R50.2, R52.2
/Output Sensor/Voltage Sensor 1x/V1-: C102.2, R49.1, R51.2, R53.2
/Output Sensor/Voltage Sensor 1x/V2+: C104.1, R50.1, U7.8 (+)
/Output Sensor/Voltage Sensor 1x/V2-: C105.1, R51.1, U7.1 (-)
/Output Sensor/Voltage Sensor 1x/VO+: C104.2, R52.1, R54.2, U7.5
/Output Sensor/Voltage Sensor 1x/VO-: C105.2, R53.1, R55.2, U7.4
/Output Sensor/Voltage Sensor 1x/V_{OCM}: C106.1, R56.2, R57.1, U7.2 (V_{OCM})
/VSEN1x+: C107.2, C108.1, R55.1; also elsewhere on the board
/VSEN1x-: C107.1, C109.1, R54.1; also elsewhere on the board
GND: C101.2, C103.2, C106.2, C108.2, C109.2, R57.2, U7.6 (V-); also elsewhere on the board
V_{REF}: R56.1; also elsewhere on the board

Notes on the sheet:
All caps here are NP0/C0G tolerance
LTC6362 chosen for good offset/noise performance; THS453x may also be a good part candidate (similar pinout but slightly different package)
Rate these resistors for 1/4W to accomodate non-zero input impedance
Can measure power stage voltages of +/-2V (i.e. half of bridge is tied to GND, other half is driving load) Amplifier inputs can be over-driven to +/-20V safely, though output will saturate
3rd-order butterworth mutiple feedback filter with ~730kHz cutoff frequency (slight mismatch to the 10x amplifier), *1x* attenuation Want high-accuracy resistors and capacitors to ensure good matching between positive and negative branches; this ensures good CMR
High absolute accuracy of common-mode reference is not super necessary since voltage will be sensed differentially; Only really care about low noise at this node RC formed by divider resistors and cap should roll off around 67Hz

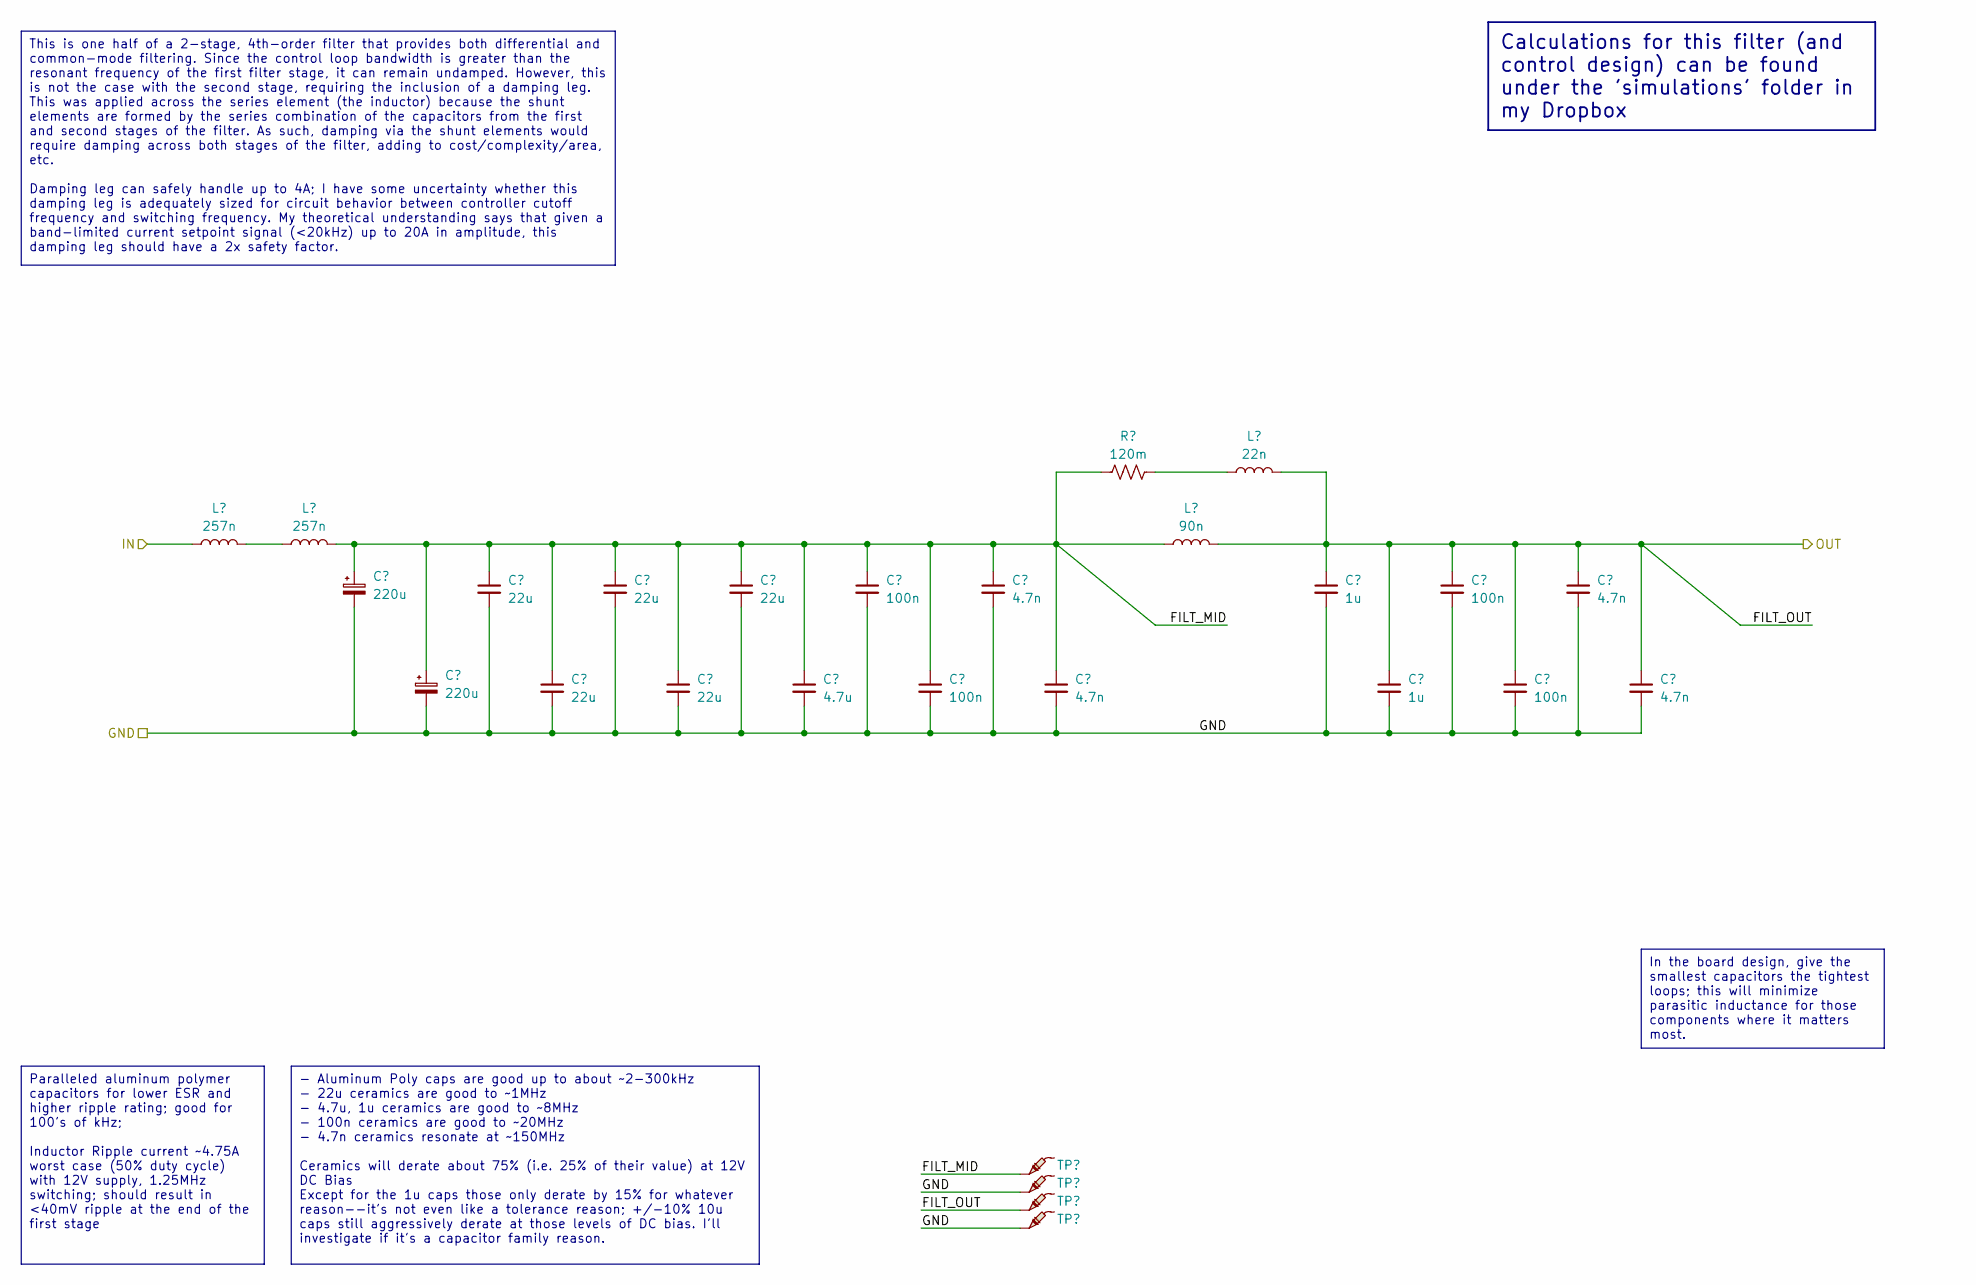
[picture p73: schematic shimamp_OutputFilterHalf.kicad_sch, Shim Amplifier Prototype]

Parts:
C51, C52: 220u; CP_Elec_10x12.5; Part Number 875075561008
C53, C54, C55, C56, C57: 22u; C_1210_3225Metric_Pad1.33x2.70mm_HandSolder; Part Number CL32B226KAJNNNE
C58: 4.7u; C_0805_2012Metric_Pad1.18x1.45mm_HandSolder; Part Number CL21A475KLCLQNC
C59, C60, C65, C66: 100n; C_0603_1608Metric_Pad1.08x0.95mm_HandSolder; Part Number CL10B104KB8NNWC
C61, C62, C67, C68: 4.7n; C_0402_1005Metric_Pad0.74x0.62mm_HandSolder; Part Number CL05B472KB5NNNC
C63, C64: 1u; C_0805_2012Metric_Pad1.18x1.45mm_HandSolder; Part Number CL21B105KBFNNNG
L2, L3: 257n; COILCRAFT_2014; Part Number 2014VS-251MED
L4: 90n; COILCRAFT_1212; Part Number 1212VS-90NMED
L5: 22n; WURTH_3168; Part Number 744914122
R25: 120m; R_1206_3216Metric_Pad1.30x1.75mm_HandSolder; Part Number MFHA1206R1200FC
TP18, TP19, TP20, TP21: -; TestPoint_Pad_D2.0mm

Connections:
/Output Filter/Output Filter+/FILT_MID: C51.1, C52.1, C53.1, C54.1, C55.1, C56.1, C57.1, C58.1, C59.1, C60.1, C61.1, C62.1, L3.1, L4.1, R25.1, TP18.1
/Output Sensor/IN+: C63.1, C64.1, C65.1, C66.1, C67.1, C68.1, L4.2, L5.2, TP20.1; also elsewhere on the board
/Power Stage/Power Stage Half Bridge+/SW: L2.2; also elsewhere on the board
GND: C51.2, C52.2, C53.2, C54.2, C55.2, C56.2, C57.2, C58.2, C59.2, C60.2, C61.2, C62.2, C63.2, C64.2, C65.2, C66.2, C67.2, C68.2, TP19.1, TP21.1; also elsewhere on the board
unnamed: L2.1, L3.2
unnamed: L5.1, R25.2

Parts of its further copies:
C69, C70: 220u; CP_Elec_10x12.5; Part Number 875075561008
C71, C72, C73, C74, C75: 22u; C_1210_3225Metric_Pad1.33x2.70mm_HandSolder; Part Number CL32B226KAJNNNE
C76: 4.7u; C_0805_2012Metric_Pad1.18x1.45mm_HandSolder; Part Number CL21A475KLCLQNC
C77, C78, C83, C84: 100n; C_0603_1608Metric_Pad1.08x0.95mm_HandSolder; Part Number CL10B104KB8NNWC
C79, C80, C85, C86: 4.7n; C_0402_1005Metric_Pad0.74x0.62mm_HandSolder; Part Number CL05B472KB5NNNC
C81, C82: 1u; C_0805_2012Metric_Pad1.18x1.45mm_HandSolder; Part Number CL21B105KBFNNNG
L6, L7: 257n; COILCRAFT_2014; Part Number 2014VS-251MED
L8: 90n; COILCRAFT_1212; Part Number 1212VS-90NMED
L9: 22n; WURTH_3168; Part Number 744914122
R26: 120m; R_1206_3216Metric_Pad1.30x1.75mm_HandSolder; Part Number MFHA1206R1200FC
TP22, TP23, TP24, TP25: -; TestPoint_Pad_D2.0mm

Connections of its further copies:
/Output Filter/Output Filter-/FILT_MID: C69.1, C70.1, C71.1, C72.1, C73.1, C74.1, C75.1, C76.1, C77.1, C78.1, C79.1, C80.1, L7.1, L8.1, R26.1, TP22.1
/Output Sensor/IN-: C81.1, C82.1, C83.1, C84.1, C85.1, C86.1, L8.2, L9.2, TP24.1; also elsewhere on the board
/Power Stage/Power Stage Half Bridge-/SW: L6.2; also elsewhere on the board
GND: C69.2, C70.2, C71.2, C72.2, C73.2, C74.2, C75.2, C76.2, C77.2, C78.2, C79.2, C80.2, C81.2, C82.2, C83.2, C84.2, C85.2, C86.2, TP23.1, TP25.1; also elsewhere on the board
unnamed: L6.1, L7.2
unnamed: L9.1, R26.2

Notes on the sheet:
This is one half of a 2-stage, 4th-order filter that provides both differential and common-mode filtering. Since the control loop bandwidth is greater than the resonant frequency of the first filter stage, it can remain undamped. However, this is not the case with the second stage, requiring the in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
Calculations for this filter (and control design) can be found under the 'simulations' folder in my Dropbox
- Aluminum Poly caps are good up to about ~2-300kHz - 22u ceramics are good to ~1MHz - 4.7u, 1u ceramics are good to ~8MHz - 100n ceramics are good to ~20MHz - 4.7n ceramics resonate at ~150MHz Ceramics will derate about 75% (i.e. 25% of their value) at 12V DC Bias Except for the 1u caps those only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
Paralleled aluminum polymer capacitors for lower ESR and higher ripple rating; good for 100's of kHz; Inductor Ripple current ~4.75A worst case (50% duty cycle) with 12V supply, 1.25MHz switching; should result in <40mV ripple at the end of the first stage
In the board design, give the smallest capacitors the tightest loops; this will minimize parasitic inductance for those components where it matters most.

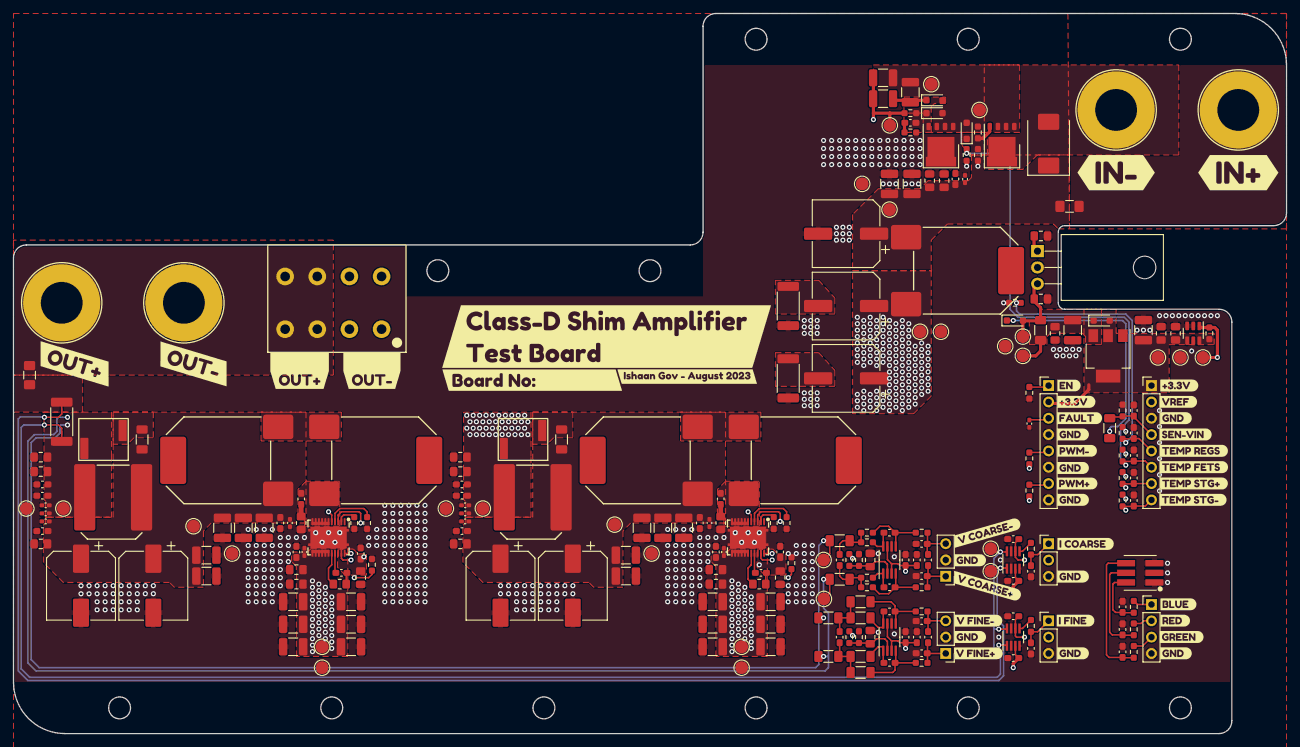
[picture p74: board Class-D Prototype revA.kicad_pcb from above]

Board: 4 copper layers, 198.0 x 112.0 mm, 283 parts (0 on the bottom side), 81 nets.

Other parts of the board:
kibuzzard-64CF1C96: G***; kibuzzard-64CF1C96
kibuzzard-64CF1CEA: G***; kibuzzard-64CF1CEA
kibuzzard-64CF1E0D: G***; kibuzzard-64CF1E0D
kibuzzard-64CF1E1A: G***; kibuzzard-64CF1E1A
kibuzzard-64CF1E3D: G***; kibuzzard-64CF1E3D
kibuzzard-64CF1E8F: G***; kibuzzard-64CF1E8F
kibuzzard-64CF1E29: G***; kibuzzard-64CF1E29
kibuzzard-64CF1E34: G***; kibuzzard-64CF1E34
kibuzzard-64CF1E44: G***; kibuzzard-64CF1E44
kibuzzard-64CF1E82: G***; kibuzzard-64CF1E82
kibuzzard-64CF1EB5: G***; kibuzzard-64CF1EB5
kibuzzard-64CF1EC8: G***; kibuzzard-64CF1EC8
kibuzzard-64CF1ED1: G***; kibuzzard-64CF1ED1
kibuzzard-64CF1EE4: G***; kibuzzard-64CF1EE4
kibuzzard-64CF1F01: G***; kibuzzard-64CF1F01
kibuzzard-64CF1F4F: G***; kibuzzard-64CF1F4F
kibuzzard-64CF1F6F: G***; kibuzzard-64CF1F6F
kibuzzard-64CF1F11: G***; kibuzzard-64CF1F11
kibuzzard-64CF1F61: G***; kibuzzard-64CF1F61
kibuzzard-64CF1F69: G***; kibuzzard-64CF1F69
kibuzzard-64CF1F79: G***; kibuzzard-64CF1F79
kibuzzard-64CF1FA1: G***; kibuzzard-64CF1FA1
kibuzzard-64CF1FAA: G***; kibuzzard-64CF1FAA
kibuzzard-64CF1FB5: G***; kibuzzard-64CF1FB5
kibuzzard-64CF22CA: G***; kibuzzard-64CF22CA
kibuzzard-64CF22E7: G***; kibuzzard-64CF22E7
kibuzzard-64CF24C8: G***; kibuzzard-64CF24C8
kibuzzard-64CF24F4: G***; kibuzzard-64CF24F4
kibuzzard-64CF222A: G***; kibuzzard-64CF222A
kibuzzard-64CF223D: G***; kibuzzard-64CF223D
kibuzzard-64CF2245: G***; kibuzzard-64CF2245
kibuzzard-64CF2417: G***; kibuzzard-64CF2417
kibuzzard-64CF2468: G***; kibuzzard-64CF2468
kibuzzard-64CFD6AE: G***; kibuzzard-64CFD6AE
kibuzzard-64CFD733: G***; kibuzzard-64CFD733
kibuzzard-64CFD751: G***; kibuzzard-64CFD751
kibuzzard-64CFDF40: G***; kibuzzard-64CFDF40
kibuzzard-64CFDF65: G***; kibuzzard-64CFDF65
kibuzzard-64CFDFD1: G***; kibuzzard-64CFDFD1
