Govish/Shimamp-Hardware/Class-D Prototype revB2/Class-D Prorotype RevB2/Class-D Prorotype RevB2.kicad_sch

## KiCad design Class-D Prototype revB2/Class-D Prorotype RevB2/Class-D Prorotype RevB2.kicad_sch (2023-11-08)

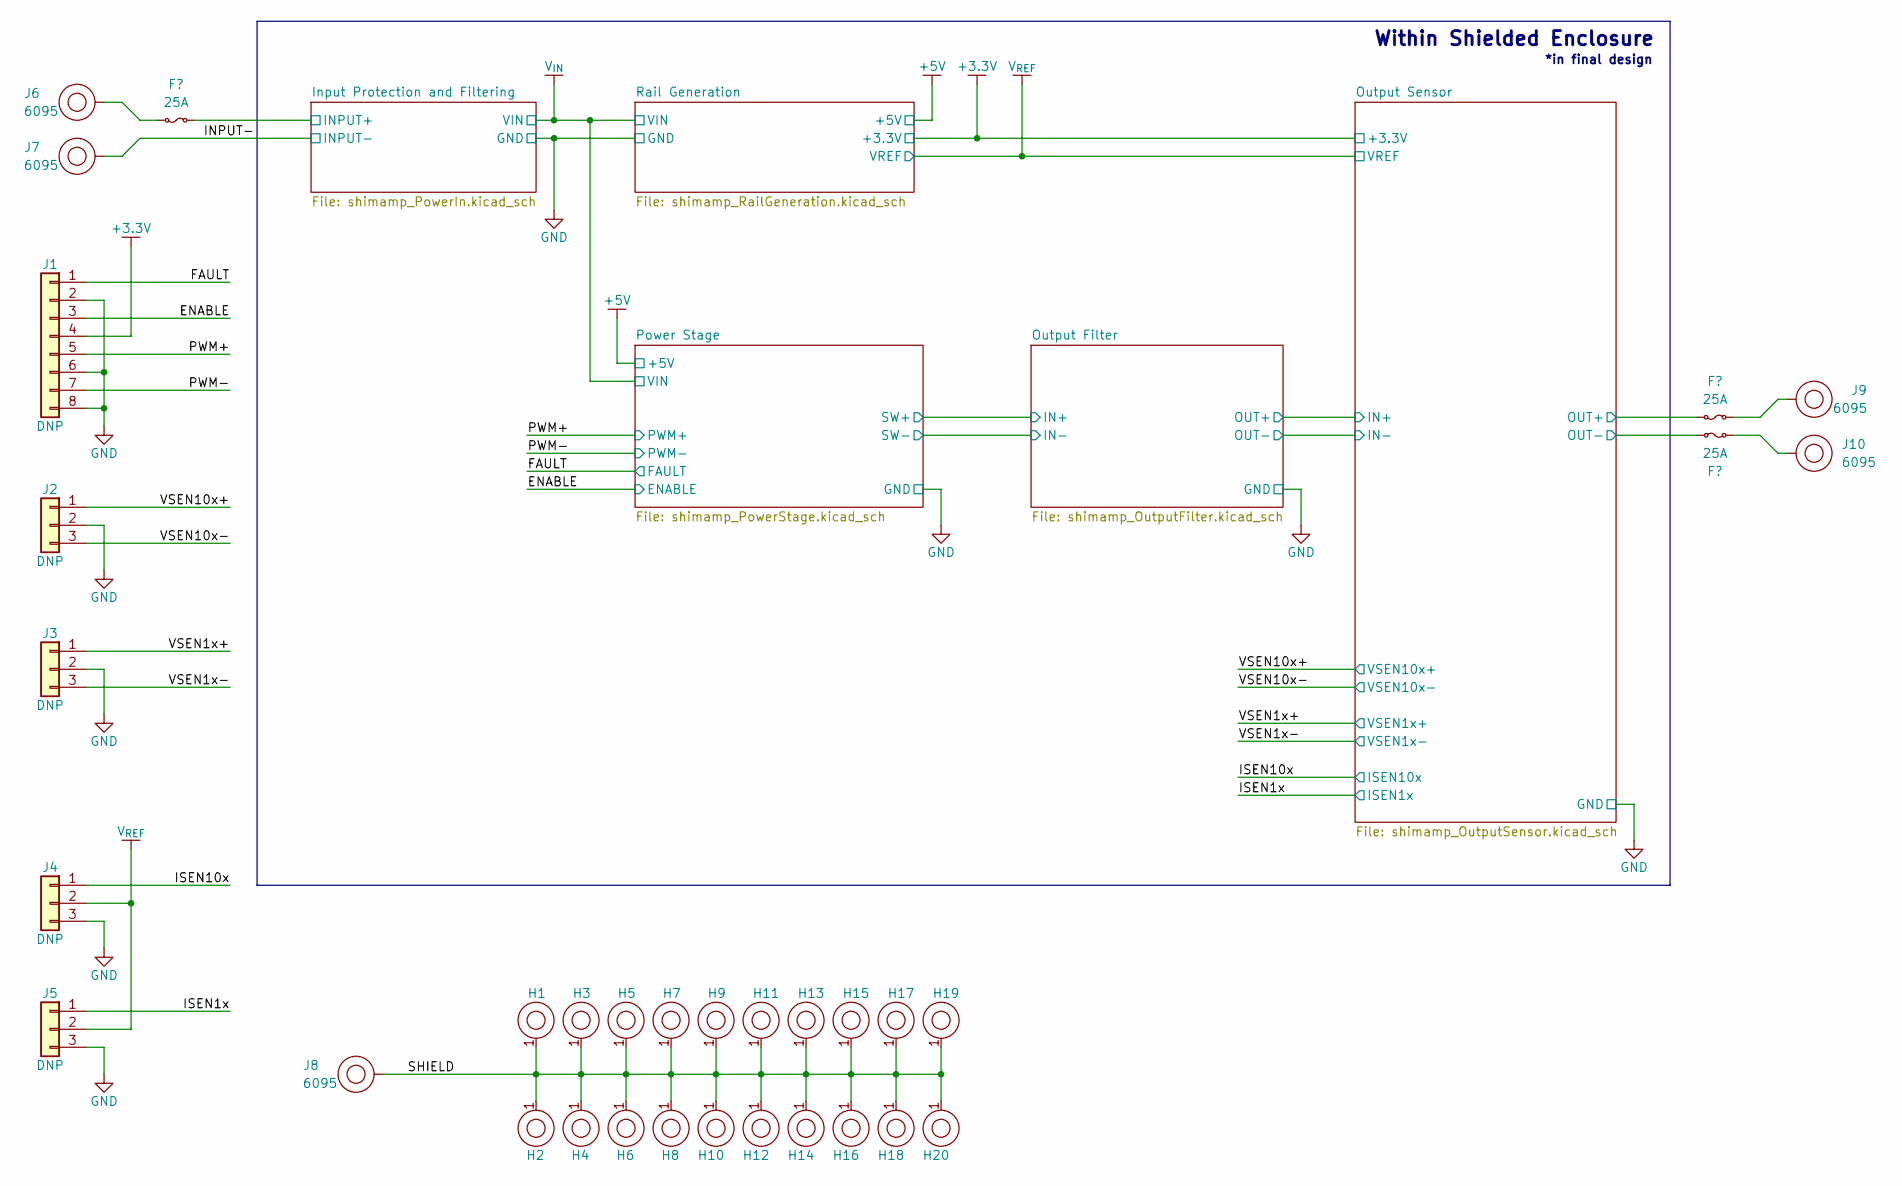
[picture p75: schematic Class-D Prorotype RevB2.kicad_sch]

Parts:
F1, F2, F3: 25A; Fuse_1206_3216Metric_Pad1.42x1.75mm_HandSolder; Part Number 0685H9250-01
H1, H2, H3, H4, H5, H6, H7, H8, H9, H10, H11, H12, H13, H14, H15, H16, H17, H18, H19, H20: MountingHole-3mm_small_annulus
J1: DNP; PinHeader_1x08_P2.54mm_Vertical
J2, J3, J4, J5: DNP; PinHeader_1x03_P2.54mm_Vertical
J6, J7, J8, J9, J10: 6095; Keystone 6095; Part Number 6095

Connections:
+3.3V: J1.4
ENABLE: J1.3
FAULT: J1.1
GND: J1.2, J1.6, J1.8, J2.2, J3.2, J4.3, J5.3
INPUT+: F1.2
INPUT-: J7.1
ISEN1x: J5.1
ISEN10x: J4.1
unnamed: F1.1, J6.1
unnamed: F2.2, J9.1
unnamed: F3.2, J10.1
OUT+: F2.1
OUT-: F3.1
PWM+: J1.5
PWM-: J1.7
SHIELD: H1.1, H2.1, H3.1, H4.1, H5.1, H6.1, H7.1, H8.1, H9.1, H10.1, H11.1, H12.1, H13.1, H14.1, H15.1, H16.1, H17.1, H18.1, H19.1, H20.1, J8.1
VSEN1x+: J3.1
VSEN1x-: J3.3
VSEN10x+: J2.1
VSEN10x-: J2.3
V_{REF}: J4.2, J5.2

Notes on the sheet:
*in final design
Within Shielded Enclosure
