Govish/Shimamp-Hardware/Class-D Prototype revB2/Class-D Prorotype RevB2/shimamp_CurrentSensor1.kicad_sch

## KiCad design Class-D Prototype revB2/Class-D Prorotype RevB2/shimamp_CurrentSensor1.kicad_sch (2023-11-08)

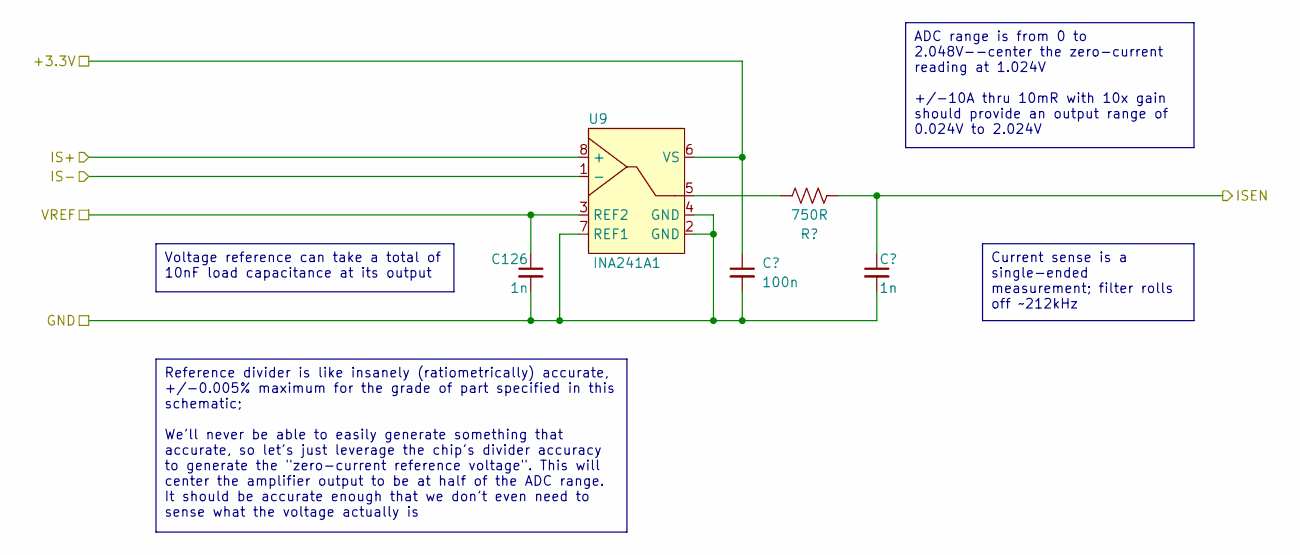
[picture p76: schematic shimamp_CurrentSensor1.kicad_sch]

Parts:
C126, C128: 1n; C_0603_1608Metric_Pad1.08x0.95mm_HandSolder; Part Number CL10B102KB8NNNC
C127: 100n; C_0603_1608Metric_Pad1.08x0.95mm_HandSolder; Part Number CL10B104KB8NNWC
R46: 750R; R_0603_1608Metric_Pad0.98x0.95mm_HandSolder; Part Number RMCF0603FT750R
U9: INA241A1; SOT-23-8_Handsoldering; Part Number INA241A1IDDFR

Connections:
+3.3V: C127.1, U9.6 (VS)
GND: C126.2, C127.2, C128.2, U9.2 (GND), U9.4 (GND), U9.7 (REF1)
IS+: U9.8 (+)
IS-: U9.1 (-)
ISEN: C128.1, R46.1
unnamed: R46.2, U9.5
VREF: C126.1, U9.3 (REF2)

Notes on the sheet:
Current sense is a single-ended measurement; filter rolls off ~212kHz
ADC range is from 0 to 2.048V--center the zero-current reading at 1.024V +/-10A thru 10mR with 10x gain should provide an output range of 0.024V to 2.024V
Reference divider is like insanely (ratiometrically) accurate, +/-0.005% maximum for the grade of part specified in this schematic; We'll never be able to easily generate something that accurate, so let's just leverage the chip's divider accuracy to generate the "zero-current reference voltage". Th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
Voltage reference can take a total of 10nF load capacitance at its output
