Govish/Shimamp-Hardware/Class-D Prototype revB2/Class-D Prorotype RevB2/shimamp_CurrentSensor10.kicad_sch

## KiCad design Class-D Prototype revB2/Class-D Prorotype RevB2/shimamp_CurrentSensor10.kicad_sch (2023-11-08)


Parts:
C123, C125: 1n; C_0603_1608Metric_Pad1.08x0.95mm_HandSolder; Part Number CL10B102KB8NNNC
C124: 100n; C_0603_1608Metric_Pad1.08x0.95mm_HandSolder; Part Number CL10B104KB8NNWC
R45: 750R; R_0603_1608Metric_Pad0.98x0.95mm_HandSolder; Part Number RMCF0603FT750R
U8: INA241A4; SOT-23-8_Handsoldering; Part Number INA241A4IDDFR

Connections:
+3.3V: C124.1, U8.6 (VS)
GND: C123.2, C124.2, C125.2, U8.2 (GND), U8.4 (GND), U8.7 (REF1)
IS+: U8.8 (+)
IS-: U8.1 (-)
ISEN: C125.1, R45.1
unnamed: R45.2, U8.5
VREF: C123.1, U8.3 (REF2)

Notes on the sheet:
Voltage reference can take a total of 10nF load capacitance at its output
Reference divider is like insanely (ratiometrically) accurate, +/-0.005% maximum for the grade of part specified in this schematic; We'll never be able to easily generate something that accurate, so let's just leverage the chip's divider accuracy to generate the "zero-current reference voltage". Th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
Current sense is a single-ended measurement; filter rolls off ~212kHz
ADC range is from 0 to 2.048V--center the zero-current reading at 1.024V +/-1A thru 10mR with 100x gain should provide an output range of 0.024V to 2.024V
