Govish/Shimamp-Hardware/Class-D Prototype revB2/Class-D Prorotype RevB2/shimamp_HalfBridge.kicad_sch

## KiCad design Class-D Prototype revB2/Class-D Prorotype RevB2/shimamp_HalfBridge.kicad_sch (2023-11-08)

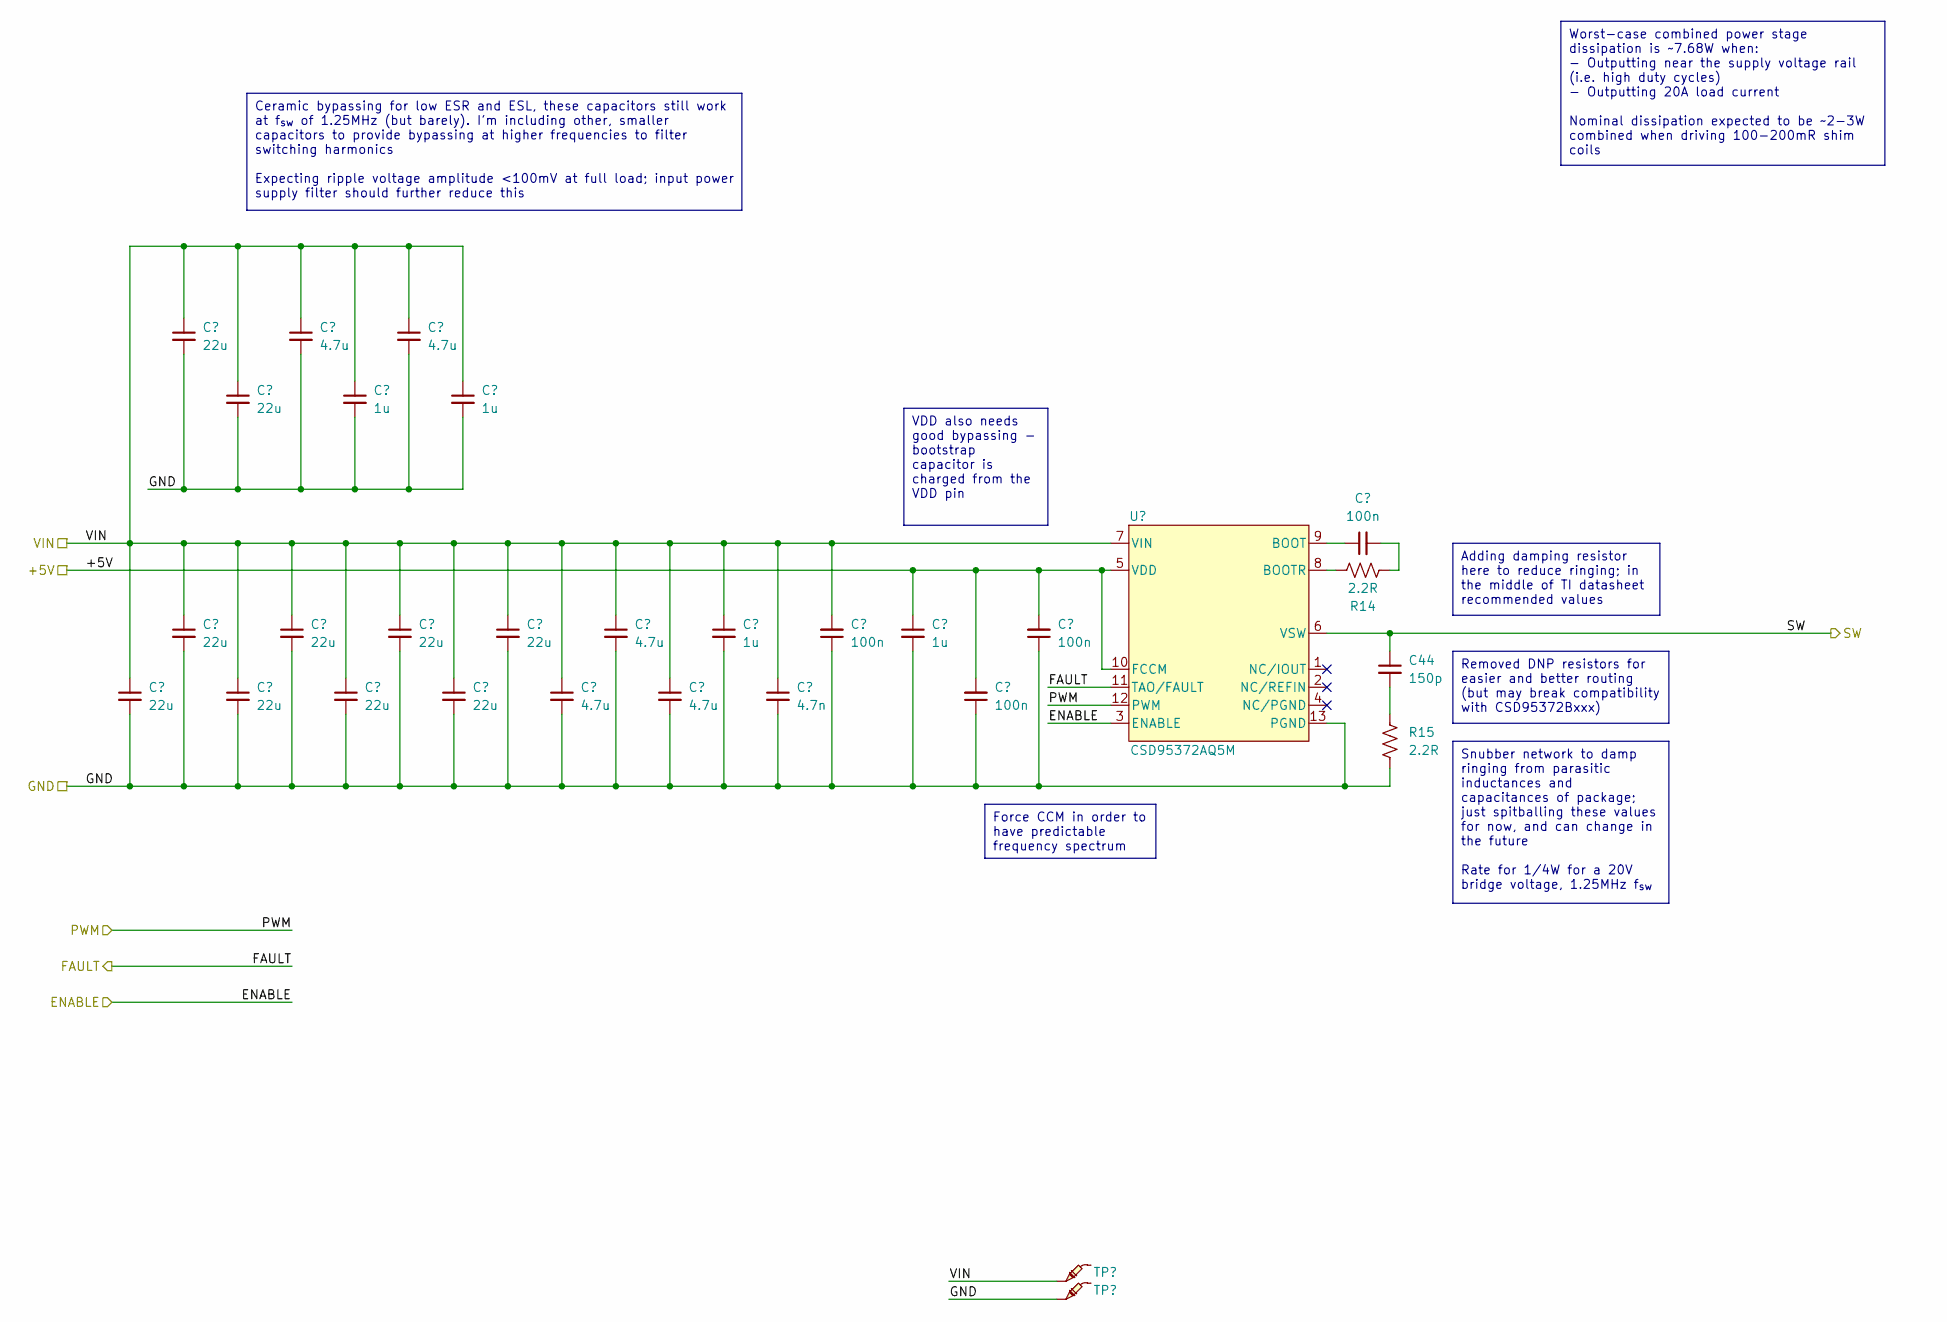
[picture p77: schematic shimamp_HalfBridge.kicad_sch]

Parts:
C20, C21, C22, C23, C24, C25, C27, C29, C31, C33: 22u; C_1210_3225Metric_Pad1.33x2.70mm_HandSolder; Part Number CL32B226KAJNNNE
C26, C30, C34, C35, C36: 4.7u; C_0805_2012Metric_Pad1.18x1.45mm_HandSolder; Part Number CL21A475KLCLQNC
C28, C32, C37, C40: 1u; C_0805_2012Metric_Pad1.18x1.45mm_HandSolder; Part Number CL21B105KBFNNNG
C38: 4.7n; C_0603_1608Metric_Pad1.08x0.95mm_HandSolder; Part Number CL10B472KB8NFNC
C39, C41, C42, C43: 100n; C_0603_1608Metric_Pad1.08x0.95mm_HandSolder; Part Number CL10B104KB8NNWC
C44: 150p; C_0603_1608Metric_Pad1.08x0.95mm_HandSolder; Part Number GCM1885C2A151JA16D
R14, R15: 2.2R; R_0805_2012Metric_Pad1.20x1.40mm_HandSolder; Part Number RPC0805JT2R20-UP
TP12, TP13: -; TestPoint_Pad_D2.0mm
U4: CSD95372AQ5M; LSON-12-1EP_5x6mm; Part Number CSD95372AQ5M

Connections:
+5V: C40.1, C41.2, C42.2, U4.5 (VDD), U4.10 (FCCM)
ENABLE: U4.3 (ENABLE)
FAULT: U4.11 (TAO/FAULT)
GND: C20.2, C21.2, C22.2, C23.2, C24.2, C25.2, C26.2, C27.2, C28.2, C29.2, C30.2, C31.2, C32.2, C33.2, C34.2, C35.2, C36.2, C37.2, C38.2, C39.1, C40.2, C41.1, C42.1, R15.2, TP13.1, U4.13 (PGND)
unnamed: C43.1, U4.9 (BOOT)
unnamed: C43.2, R14.2
unnamed: C44.2, R15.1
unnamed: R14.1, U4.8 (BOOTR)
PWM: U4.12 (PWM)
SW: C44.1, U4.6 (VSW)
VIN: C20.1, C21.1, C22.1, C23.1, C24.1, C25.1, C26.1, C27.1, C28.1, C29.1, C30.1, C31.1, C32.1, C33.1, C34.1, C35.1, C36.1, C37.1, C38.1, C39.2, TP12.1, U4.7 (VIN)

Notes on the sheet:
Worst-case combined power stage dissipation is ~7.68W when: - Outputting near the supply voltage rail (i.e. high duty cycles) - Outputting 20A load current Nominal dissipation expected to be ~2-3W combined when driving 100-200mR shim coils
Adding damping resistor here to reduce ringing; in the middle of TI datasheet recommended values
VDD also needs good bypassing - bootstrap capacitor is charged from the VDD pin
Removed DNP resistors for easier and better routing (but may break compatibility with CSD95372Bxxx)
Force CCM in order to have predictable frequency spectrum
Ceramic bypassing for low ESR and ESL, these capacitors still work at f_{sw} of 1.25MHz (but barely). I'm including other, smaller capacitors to provide bypassing at higher frequencies to filter switching harmonics Expecting ripple voltage amplitude <100mV at full load; input power supply filter sh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
Snubber network to damp ringing from parasitic inductances and capacitances of package; just spitballing these values for now, and can change in the future Rate for 1/4W for a 20V bridge voltage, 1.25MHz f_{sw}
