Govish/Shimamp-Hardware/Class-D Prototype revB2/Class-D Prorotype RevB2/shimamp_LowSpeedSensing.kicad_sch

## KiCad design Class-D Prototype revB2/Class-D Prorotype RevB2/shimamp_LowSpeedSensing.kicad_sch (2023-11-08)


Parts:
C87, C88, C89, C90, C91: 100n; C_0603_1608Metric_Pad1.08x0.95mm_HandSolder; Part Number CL10B104KB8NNWC
R27, R31, R33, R35: 4.7k; R_0603_1608Metric_Pad0.98x0.95mm_HandSolder; Part Number RMCF0603FT4K70
R28, R32, R34, R36: 10k NTC; R_0603_1608Metric_Pad0.98x0.95mm_HandSolder; Part Number B57330V2103F260
R29: 2.2k 0.1%; R_1206_3216Metric_Pad1.30x1.75mm_HandSolder; Part Number RN73R2BTTD2201B25
R30: 220R 0.1%; R_0603_1608Metric_Pad0.98x0.95mm_HandSolder; Part Number RN73R1JTTD2200B25

Connections:
GND: C87.2, C88.2, C89.2, C90.2, C91.2, R28.2, R30.2, R32.2, R34.2, R36.2
SEN_VIN: C88.1, R29.2, R30.1
T_INFET: C91.1, R35.2, R36.1
T_PS1: C89.1, R31.2, R32.1
T_PS2: C90.1, R33.2, R34.1
T_REGS: C87.1, R27.2, R28.1
VIN: R29.1
VREF: R27.1, R31.1, R33.1, R35.1

Notes on the sheet:
These signals will be measured at a lower speed by the auxiliary ADC. These signals include the following: - Input voltage to the power stages - Center voltage reference for current sense amp - Power stage temperature x2 - Input stage temperature - Linear regulator temperature
