Govish/Shimamp-Hardware/Class-D Prototype revB2/Class-D Prorotype RevB2/shimamp_MCU.kicad_sch

## KiCad design Class-D Prototype revB2/Class-D Prorotype RevB2/shimamp_MCU.kicad_sch (2023-11-08)

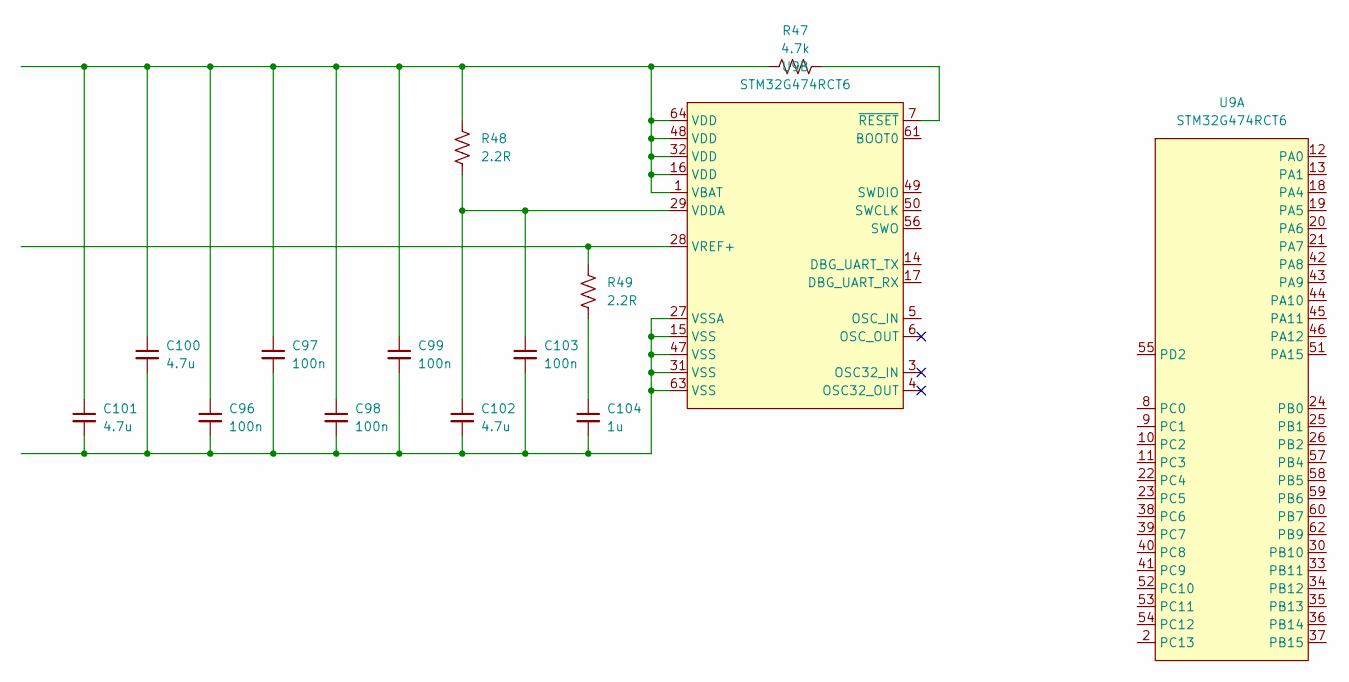
[picture p78: schematic shimamp_MCU.kicad_sch]

Parts:
C96, C97, C98, C99, C103: 100n; C_0603_1608Metric_Pad1.08x0.95mm_HandSolder; Part Number CL10B104KB8NNWC
C100, C101, C102: 4.7u; C_0805_2012Metric_Pad1.18x1.45mm_HandSolder; Part Number CL21A475KLCLQNC
C104: 1u; C_0805_2012Metric_Pad1.18x1.45mm_HandSolder; Part Number CL21B105KBFNNNG
R47: 4.7k; R_0603_1608Metric_Pad0.98x0.95mm_HandSolder; Part Number RMCF0603FT4K70
R48, R49: 2.2R; R_0805_2012Metric_Pad1.20x1.40mm_HandSolder; Part Number RMCF0603FT100K
U9: STM32G474RCT6; LQFP-64_10x10mm_P0.5mm; Part Number STM32G474RCT6

Connections:
unnamed: C96.1, C97.1, C98.1, C99.1, C100.1, C101.1, R47.1, R48.1, U9.1 (VBAT), U9.16 (VDD), U9.32 (VDD), U9.48 (VDD), U9.64 (VDD)
unnamed: C96.2, C97.2, C98.2, C99.2, C100.2, C101.2, C102.2, C103.2, C104.2, U9.15 (VSS), U9.27 (VSSA), U9.31 (VSS), U9.47 (VSS), U9.63 (VSS)
unnamed: C102.1, C103.1, R48.2, U9.29 (VDDA)
unnamed: C104.1, R49.2
unnamed: R47.2, U9.7 (~RESET)
unnamed: R49.1, U9.28 (VREF+)
