Govish/Shimamp-Hardware/Class-D Prototype revB2/Class-D Prorotype RevB2/shimamp_OutputFilter.kicad_sch

## KiCad design Class-D Prototype revB2/Class-D Prorotype RevB2/shimamp_OutputFilter.kicad_sch (2023-11-08)


Parts:
C70: 10n; C_0603_1608Metric_Pad1.08x0.95mm_HandSolder; Part Number CL10B103KB8NNNC
C71: 4.7n; C_0603_1608Metric_Pad1.08x0.95mm_HandSolder; Part Number CL10B472KB8NFNC
C72: 1n; C_0603_1608Metric_Pad1.08x0.95mm_HandSolder; Part Number CL10B102KB8NNNC

Connections:
OUT+: C70.1, C71.1, C72.1
OUT-: C70.2, C71.2, C72.2

Notes on the sheet:
Output filter is implemented as two common-mode filters (which have a byproduct of also attenuating differential mode). Each sheet contains one half of the filter.
Calculations for this filter (and control design) can be found under the 'simulations' folder in my Dropbox
Introduce a bit of purely differential filtering as well
