Govish/Shimamp-Hardware/Class-D Prototype revB2/Class-D Prorotype RevB2/shimamp_OutputFilterHalf.kicad_sch

## KiCad design Class-D Prototype revB2/Class-D Prorotype RevB2/shimamp_OutputFilterHalf.kicad_sch (2023-11-08)

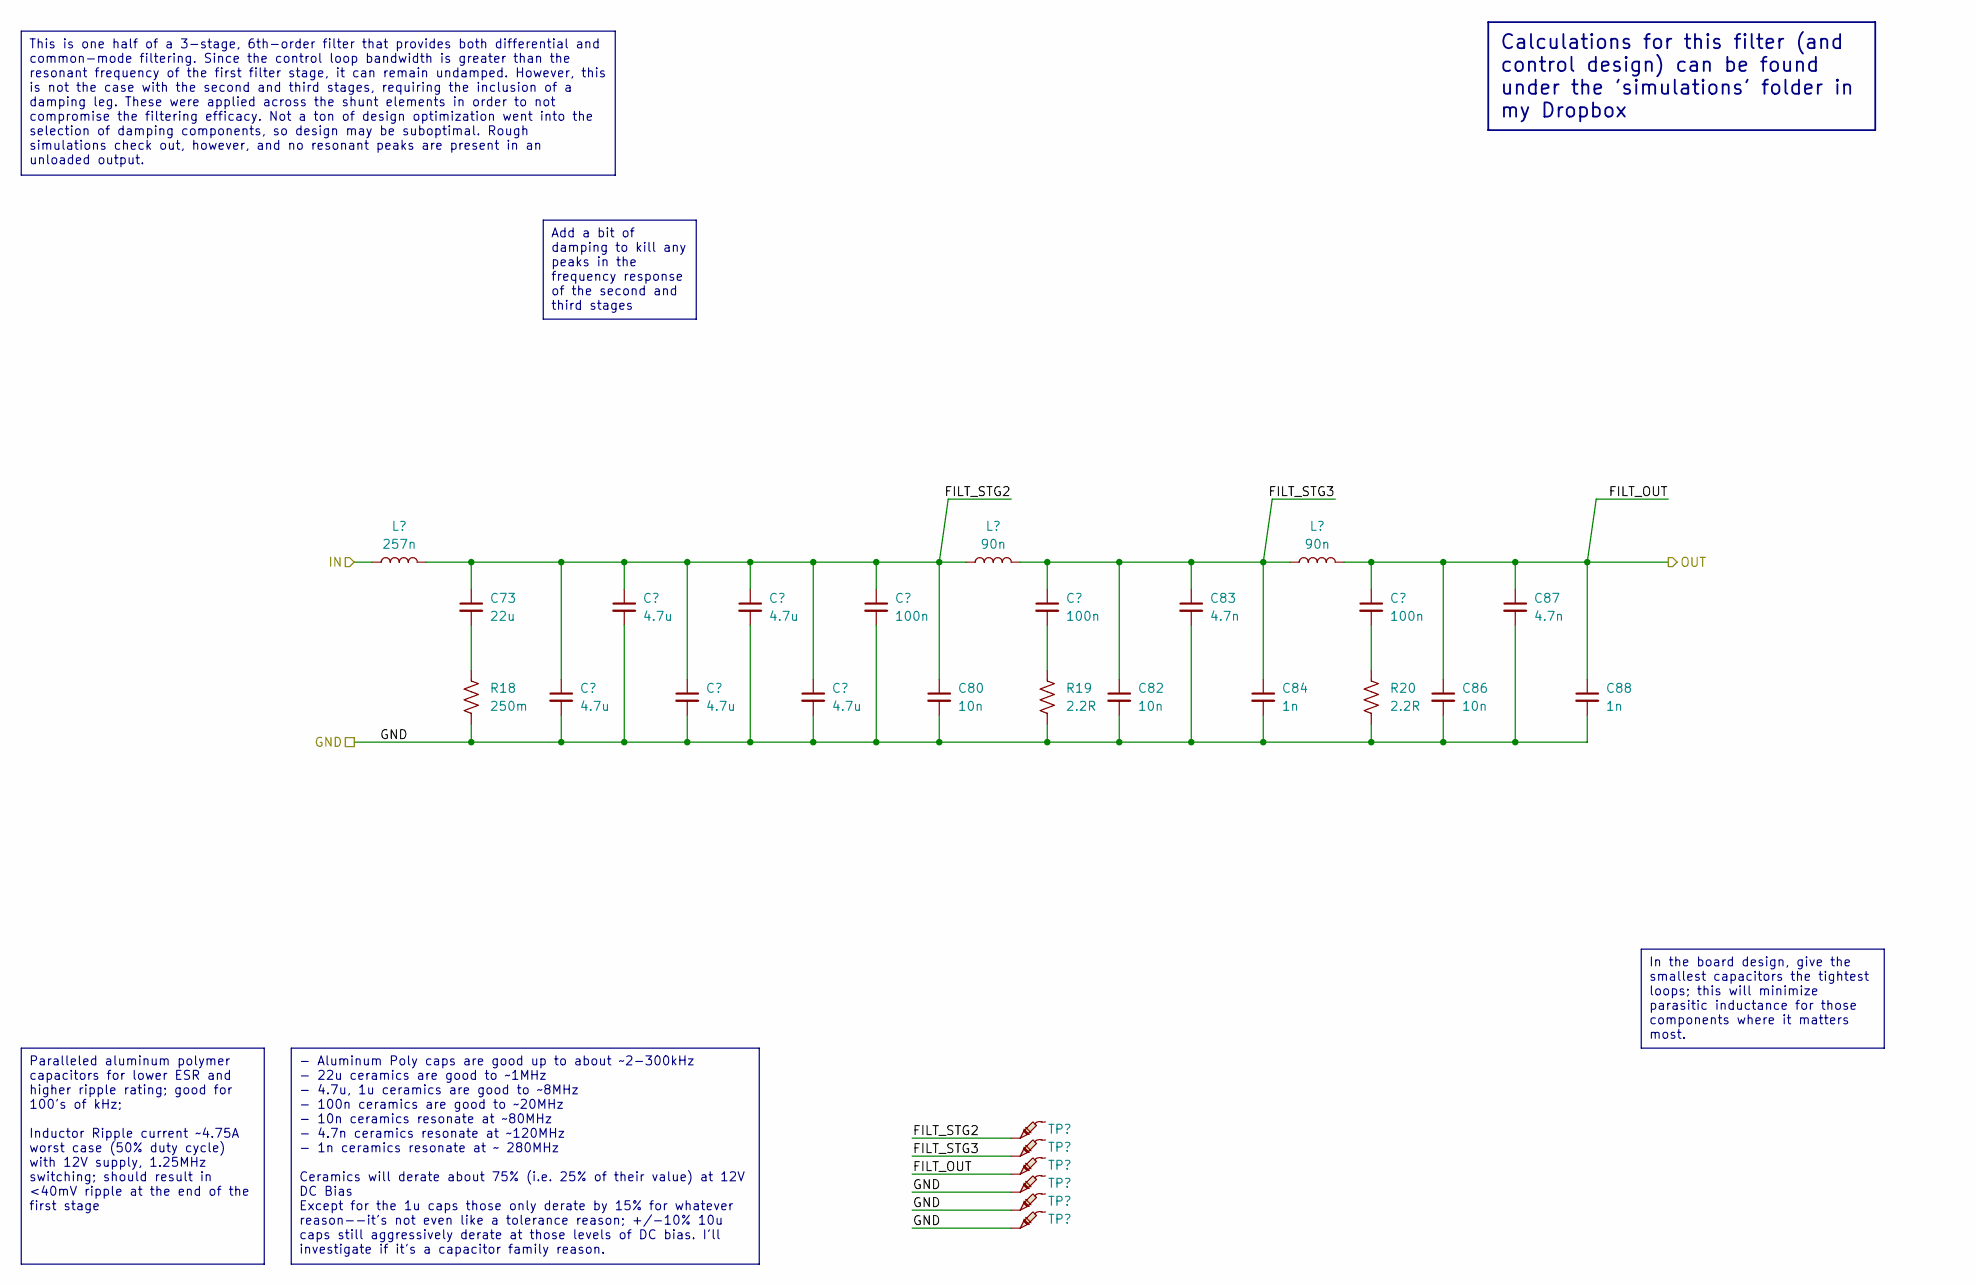
[picture p79: schematic shimamp_OutputFilterHalf.kicad_sch]

Parts:
C73: 22u; C_1210_3225Metric_Pad1.33x2.70mm_HandSolder; Part Number CL32B226KAJNNNE
C74, C75, C76, C77, C78: 4.7u; C_0805_2012Metric_Pad1.18x1.45mm_HandSolder; Part Number CL21A475KLCLQNC
C79, C81, C85: 100n; C_0603_1608Metric_Pad1.08x0.95mm_HandSolder; Part Number CL10B104KB8NNWC
C80, C82, C86: 10n; C_0603_1608Metric_Pad1.08x0.95mm_HandSolder; Part Number CL10B103KB8NNNC
C83, C87: 4.7n; C_0603_1608Metric_Pad1.08x0.95mm_HandSolder; Part Number CL10B472KB8NFNC
C84, C88: 1n; C_0603_1608Metric_Pad1.08x0.95mm_HandSolder; Part Number CL10B102KB8NNNC
L2: 257n; COILCRAFT_2014; Part Number 2014VS-251MED
L3, L4: 90n; COILCRAFT_1212; Part Number 1212VS-90NMED
R18: 250m; R_1206_3216Metric_Pad1.30x1.75mm_HandSolder; Part Number CSR1206FKR250
R19, R20: 2.2R; R_0805_2012Metric_Pad1.20x1.40mm_HandSolder; Part Number RPC0805JT2R20-UP
TP16, TP17, TP18, TP19, TP20, TP21: -; TestPoint_Pad_D2.0mm

Connections:
FILT_OUT: C85.1, C86.1, C87.1, C88.1, L4.2, TP18.1
FILT_STG2: C73.1, C74.1, C75.1, C76.1, C77.1, C78.1, C79.1, C80.1, L2.1, L3.1, TP16.1
FILT_STG3: C81.1, C82.1, C83.1, C84.1, L3.2, L4.1, TP17.1
GND: C74.2, C75.2, C76.2, C77.2, C78.2, C79.2, C80.2, C82.2, C83.2, C84.2, C86.2, C87.2, C88.2, R18.2, R19.2, R20.2, TP19.1, TP20.1, TP21.1
IN: L2.2
unnamed: C73.2, R18.1
unnamed: C81.2, R19.1
unnamed: C85.2, R20.1

Notes on the sheet:
Add a bit of damping to kill any peaks in the frequency response of the second and third stages
This is one half of a 3-stage, 6th-order filter that provides both differential and common-mode filtering. Since the control loop bandwidth is greater than the resonant frequency of the first filter stage, it can remain undamped. However, this is not the case with the second and third stages, requi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
Calculations for this filter (and control design) can be found under the 'simulations' folder in my Dropbox
- Aluminum Poly caps are good up to about ~2-300kHz - 22u ceramics are good to ~1MHz - 4.7u, 1u ceramics are good to ~8MHz - 100n ceramics are good to ~20MHz - 10n ceramics resonate at ~80MHz - 4.7n ceramics resonate at ~120MHz - 1n ceramics resonate at ~ 280MHz Ceramics will derate about 75% (i.e.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
Paralleled aluminum polymer capacitors for lower ESR and higher ripple rating; good for 100's of kHz; Inductor Ripple current ~4.75A worst case (50% duty cycle) with 12V supply, 1.25MHz switching; should result in <40mV ripple at the end of the first stage
In the board design, give the smallest capacitors the tightest loops; this will minimize parasitic inductance for those components where it matters most.
