Govish/Shimamp-Hardware/Class-D Prototype revB2/Class-D Prorotype RevB2/shimamp_OutputSensor.kicad_sch

## KiCad design Class-D Prototype revB2/Class-D Prorotype RevB2/shimamp_OutputSensor.kicad_sch (2023-11-08)

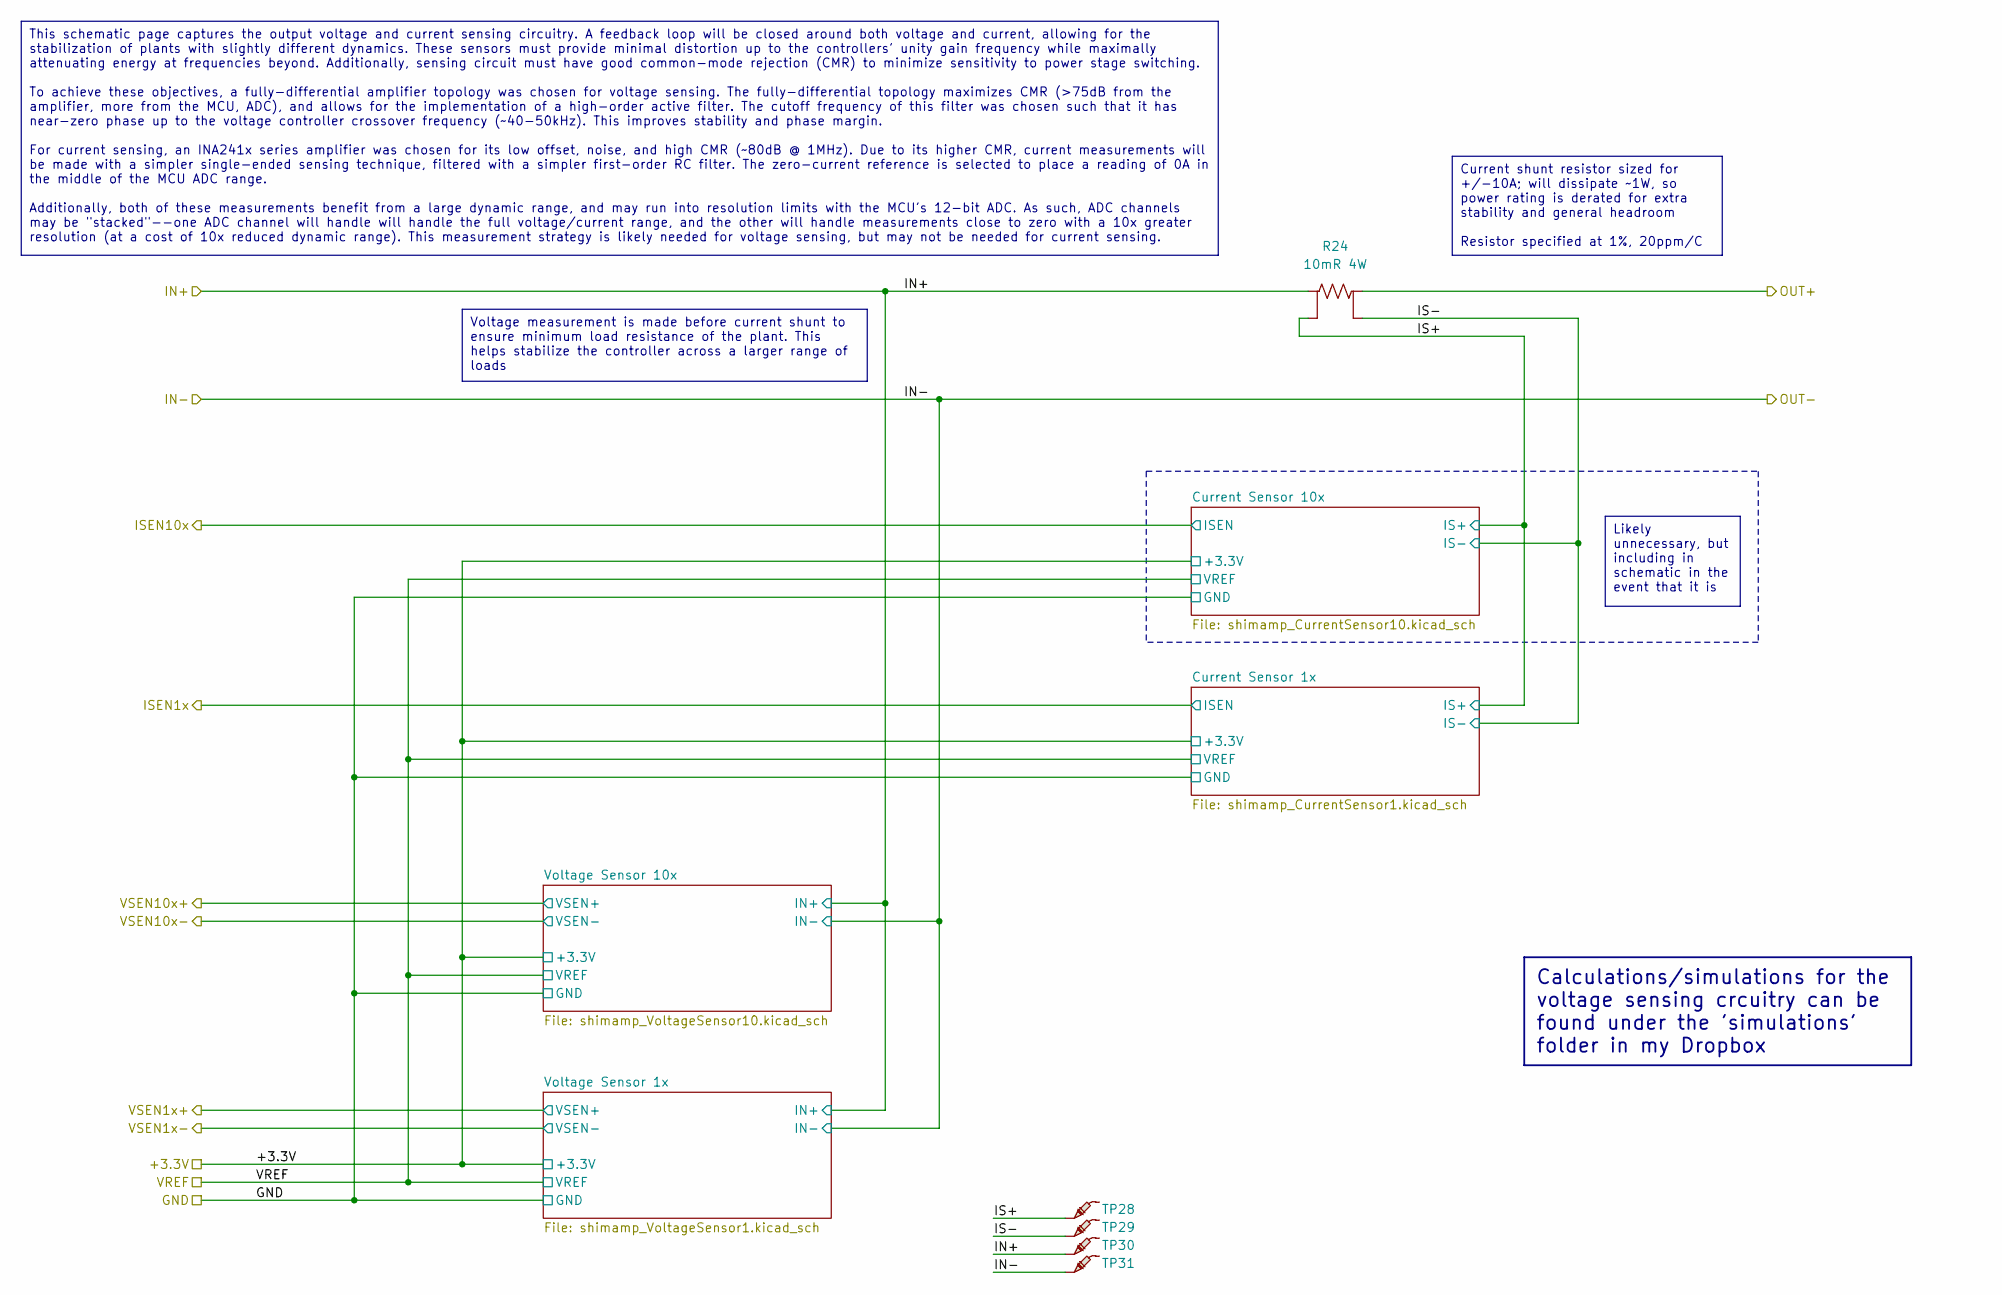
[picture p80: schematic shimamp_OutputSensor.kicad_sch]

Parts:
R24: 10mR 4W; R_2512_6332_CURRENT_SHUNT; Part Number VMS-R010-1.0-U
TP28, TP29, TP30, TP31: -; TestPoint_Pad_D2.0mm

Connections:
IN+: R24.2, TP30.1
IN-: TP31.1
IS+: R24.4, TP28.1
IS-: R24.3, TP29.1
OUT+: R24.1

Notes on the sheet:
This schematic page captures the output voltage and current sensing circuitry. A feedback loop will be closed around both voltage and current, allowing for the stabilization of plants with slightly different dynamics. These sensors must provide minimal distortion up to the controllers' unity gain f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
Calculations/simulations for the voltage sensing crcuitry can be found under the 'simulations' folder in my Dropbox
Likely unnecessary, but including in schematic in the event that it is
Voltage measurement is made before current shunt to ensure minimum load resistance of the plant. This helps stabilize the controller across a larger range of loads
Current shunt resistor sized for +/-10A; will dissipate ~1W, so power rating is derated for extra stability and general headroom Resistor specified at 1%, 20ppm/C
