Govish/Shimamp-Hardware/Class-D Prototype revB2/Class-D Prorotype RevB2/shimamp_PowerIn.kicad_sch

## KiCad design Class-D Prototype revB2/Class-D Prorotype RevB2/shimamp_PowerIn.kicad_sch (2023-11-08)

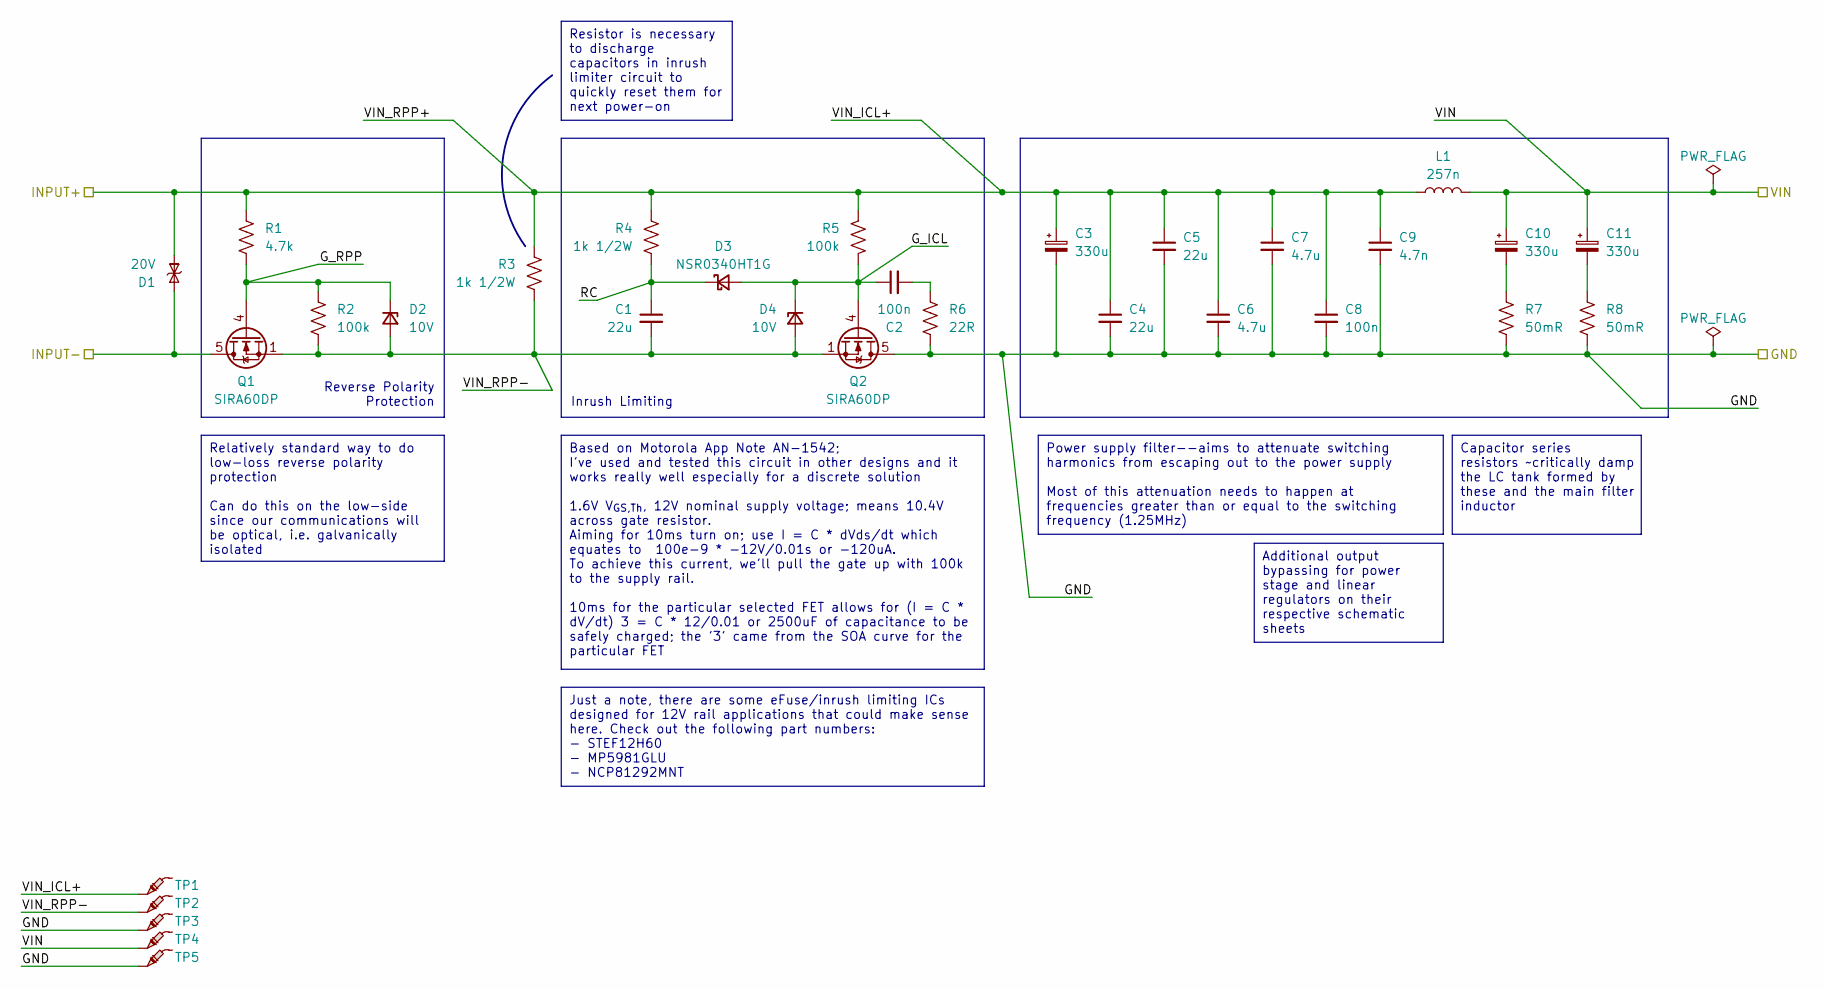
[picture p81: schematic shimamp_PowerIn.kicad_sch]

Parts:
C1, C4, C5: 22u; C_1210_3225Metric_Pad1.33x2.70mm_HandSolder; Part Number CL32B226KAJNNNE
C2, C8: 100n; C_0603_1608Metric_Pad1.08x0.95mm_HandSolder; Part Number CL10B104KB8NNWC
C3, C10, C11: 330u; CP_Elec_10x12.6; Part Number 25SVPF330M
C6, C7: 4.7u; C_0805_2012Metric_Pad1.18x1.45mm_HandSolder; Part Number CL21A475KLCLQNC
C9: 4.7n; C_0603_1608Metric_Pad1.08x0.95mm_HandSolder; Part Number CL10B472KB8NFNC
D1: 20V; D_SMC; Part Number SMCJ20CA
D2, D4: 10V; D_SOD-323_HandSoldering; Part Number MM3Z10VC
D3: NSR0340HT1G; D_SOD-323_HandSoldering; Part Number NSR0340HT1G
L1: 257n; COILCRAFT_2014; Part Number 2014VS-251MED
Q1, Q2: SIRA60DP; PQFN-8-EP_6x5mm_P1.27mm_Generic; Part Number SIRA60DP-T1-GE3
R1: 4.7k; R_0603_1608Metric_Pad0.98x0.95mm_HandSolder; Part Number RMCF0603FT4K70
R2, R5: 100k; R_0603_1608Metric_Pad0.98x0.95mm_HandSolder; Part Number RMCF0603FT100K
R3, R4: 1k 1/2W; R_1210_3225Metric_Pad1.30x2.65mm_HandSolder; Part Number RMCF1210JT1K00
R6: 22R; R_0603_1608Metric_Pad0.98x0.95mm_HandSolder; Part Number RMCF0603FT22R0
R7, R8: 50mR; R_2512_6332Metric_Pad1.40x3.35mm_HandSolder; Part Number CSRN2512FK50L0
TP1, TP2, TP3, TP4, TP5: -; TestPoint_Pad_D2.0mm

Connections:
GND: C3.2, C4.2, C5.2, C6.2, C7.2, C8.2, C9.2, Q2.5 (D), R6.2, R7.2, R8.2, TP3.1, TP5.1
G_ICL: C2.1, D3.2 (A), D4.1 (K), Q2.4 (G), R5.2
G_RPP: D2.1 (K), Q1.4 (G), R1.2, R2.1
INPUT+: C3.1, C4.1, C5.1, C6.1, C7.1, C8.1, C9.1, D1.1 (K), L1.2, R1.1, R3.1, R4.1, R5.1, TP1.1
INPUT-: D1.2 (A), Q1.5 (D)
unnamed: C2.2, R6.1
unnamed: C10.2, R7.1
unnamed: C11.2, R8.1
RC: C1.1, D3.1 (K), R4.2
VIN: C10.1, C11.1, L1.1, TP4.1
VIN_RPP-: C1.2, D2.2 (A), D4.2 (A), Q1.1 (S), Q1.2 (S), Q1.3 (S), Q2.1 (S), Q2.2 (S), Q2.3 (S), R2.2, R3.2, TP2.1

Notes on the sheet:
Additional output bypassing for power stage and linear regulators on their respective schematic sheets
Power supply filter--aims to attenuate switching harmonics from escaping out to the power supply Most of this attenuation needs to happen at frequencies greater than or equal to the switching frequency (1.25MHz)
Just a note, there are some eFuse/inrush limiting ICs designed for 12V rail applications that could make sense here. Check out the following part numbers: - STEF12H60 - MP5981GLU - NCP81292MNT
Based on Motorola App Note AN-1542; I've used and tested this circuit in other designs and it works really well especially for a discrete solution 1.6V V_{GS,Th}, 12V nominal supply voltage; means 10.4V across gate resistor. Aiming for 10ms turn on; use I = C * dVds/dt which equates to 100e-9 * -12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
Relatively standard way to do low-loss reverse polarity protection Can do this on the low-side since our communications will be optical, i.e. galvanically isolated
Resistor is necessary to discharge capacitors in inrush limiter circuit to quickly reset them for next power-on
Capacitor series resistors ~critically damp the LC tank formed by these and the main filter inductor
Inrush Limiting
Reverse Polarity Protection
