Govish/Shimamp-Hardware/Class-D Prototype revB2/Class-D Prorotype RevB2/shimamp_PowerStage.kicad_sch

## KiCad design Class-D Prototype revB2/Class-D Prorotype RevB2/shimamp_PowerStage.kicad_sch (2023-11-08)


Parts:
C19: 4.7n; C_0603_1608Metric_Pad1.08x0.95mm_HandSolder; Part Number CL10B472KB8NFNC
R11: 4.7k; R_0603_1608Metric_Pad0.98x0.95mm_HandSolder; Part Number RMCF0603FT4K70
R12, R13: 22R; R_0603_1608Metric_Pad0.98x0.95mm_HandSolder; Part Number RMCF0603FT22R0

Connections:
ENABLE: R11.2
FAULT: C19.1
GND: C19.2, R11.1
PWM: R12.2, R13.2
PWM+: R12.1
PWM-: R13.1

Notes on the sheet:
Limit rise-times slightly
Provide a more aggressive pulldown for ENABLE
Fault/temp sense can be ganged together like this according to datasheet; will be pulled high in fault condition Fault/temp sense additionally wants a small amount of load capacitance according to datasheet
