Govish/Shimamp-Hardware/Class-D Prototype revB2/Class-D Prorotype RevB2/shimamp_RailGeneration.kicad_sch

## KiCad design Class-D Prototype revB2/Class-D Prorotype RevB2/shimamp_RailGeneration.kicad_sch (2023-11-08)

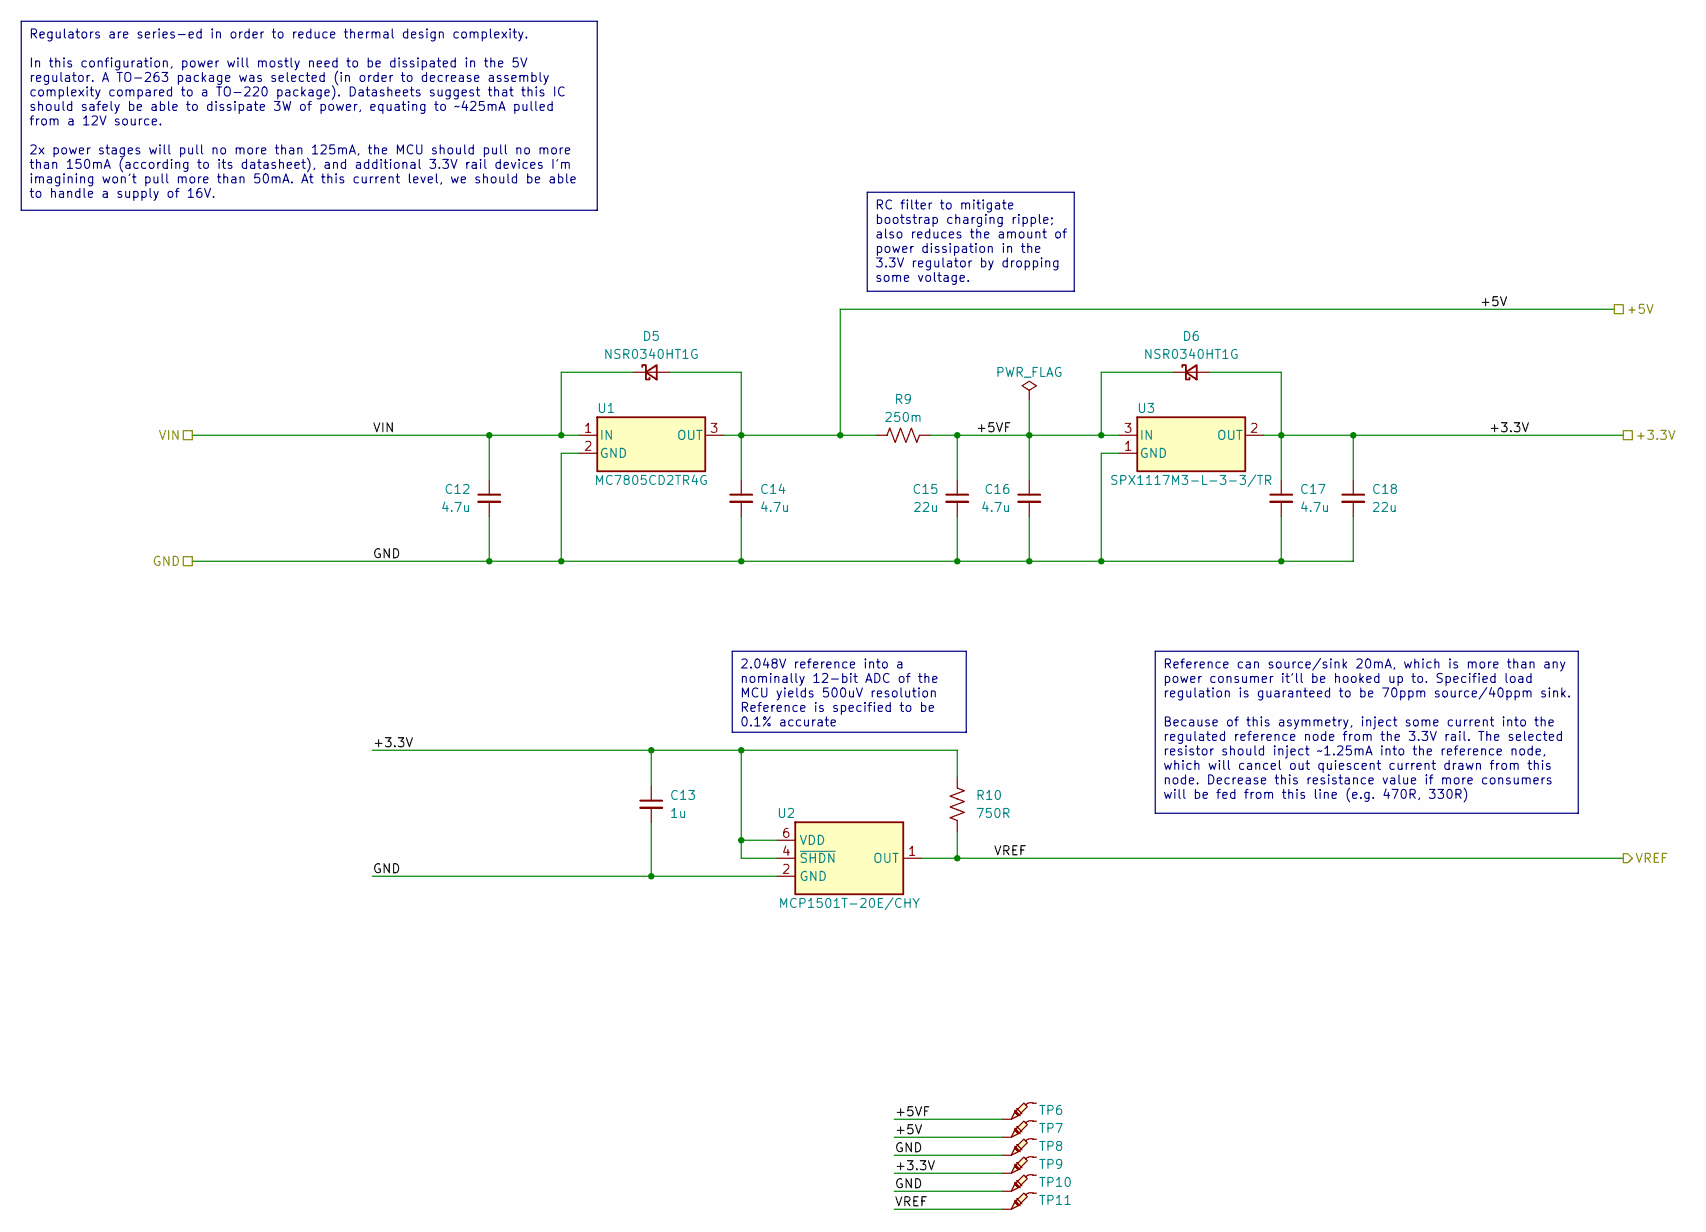
[picture p82: schematic shimamp_RailGeneration.kicad_sch]

Parts:
C12, C14, C16, C17: 4.7u; C_0805_2012Metric_Pad1.18x1.45mm_HandSolder; Part Number CL21A475KLCLQNC
C13: 1u; C_0805_2012Metric_Pad1.18x1.45mm_HandSolder; Part Number CL21B105KBFNNNG
C15, C18: 22u; C_1210_3225Metric_Pad1.33x2.70mm_HandSolder; Part Number CL32B226KAJNNNE
D5, D6: NSR0340HT1G; D_SOD-323_HandSoldering; Part Number NSR0340HT1G
R9: 250m; R_1206_3216Metric_Pad1.30x1.75mm_HandSolder; Part Number CSR1206FKR250
R10: 750R; R_0603_1608Metric_Pad0.98x0.95mm_HandSolder; Part Number RMCF0603FT750R
TP6, TP7, TP8, TP9, TP10, TP11: -; TestPoint_Pad_D2.0mm
U1: MC7805CD2TR4G; TO-263-2; Part Number MC7805CD2TR4G
U2: MCP1501T-20E/CHY; SOT-23-6; Part Number MCP1501T-20E/CHY
U3: SPX1117M3-L-3-3/TR; SOT-223-3_TabPin2; Part Number SPX1117M3-L-3-3/TR

Connections:
+3.3V: C13.1, C17.1, C18.1, D6.2 (A), R10.1, TP9.1, U2.4 (~SHDN), U2.6 (VDD), U3.2 (OUT)
+5V: C14.1, D5.2 (A), R9.1, TP7.1, U1.3 (OUT)
+5VF: C15.1, C16.1, D6.1 (K), R9.2, TP6.1, U3.3 (IN)
GND: C12.2, C13.2, C14.2, C15.2, C16.2, C17.2, C18.2, TP8.1, TP10.1, U1.2 (GND), U2.2 (GND), U2.3 (GND), U2.5 (GND), U3.1 (GND)
VIN: C12.1, D5.1 (K), U1.1 (IN)
VREF: R10.2, TP11.1, U2.1 (OUT)

Notes on the sheet:
Regulators are series-ed in order to reduce thermal design complexity. In this configuration, power will mostly need to be dissipated in the 5V regulator. A TO-263 package was selected (in order to decrease assembly complexity compared to a TO-220 package). Datasheets suggest that this IC should sa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
2.048V reference into a nominally 12-bit ADC of the MCU yields 500uV resolution Reference is specified to be 0.1% accurate
Reference can source/sink 20mA, which is more than any power consumer it'll be hooked up to. Specified load regulation is guaranteed to be 70ppm source/40ppm sink. Because of this asymmetry, inject some current into the regulated reference node from the 3.3V rail. The selected resistor should injec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
RC filter to mitigate bootstrap charging ripple; also reduces the amount of power dissipation in the 3.3V regulator by dropping some voltage.
