Govish/Shimamp-Hardware/Class-D Prototype revB2/Class-D Prorotype RevB2/shimamp_VoltageSensor1.kicad_sch

## KiCad design Class-D Prototype revB2/Class-D Prorotype RevB2/shimamp_VoltageSensor1.kicad_sch (2023-11-08)

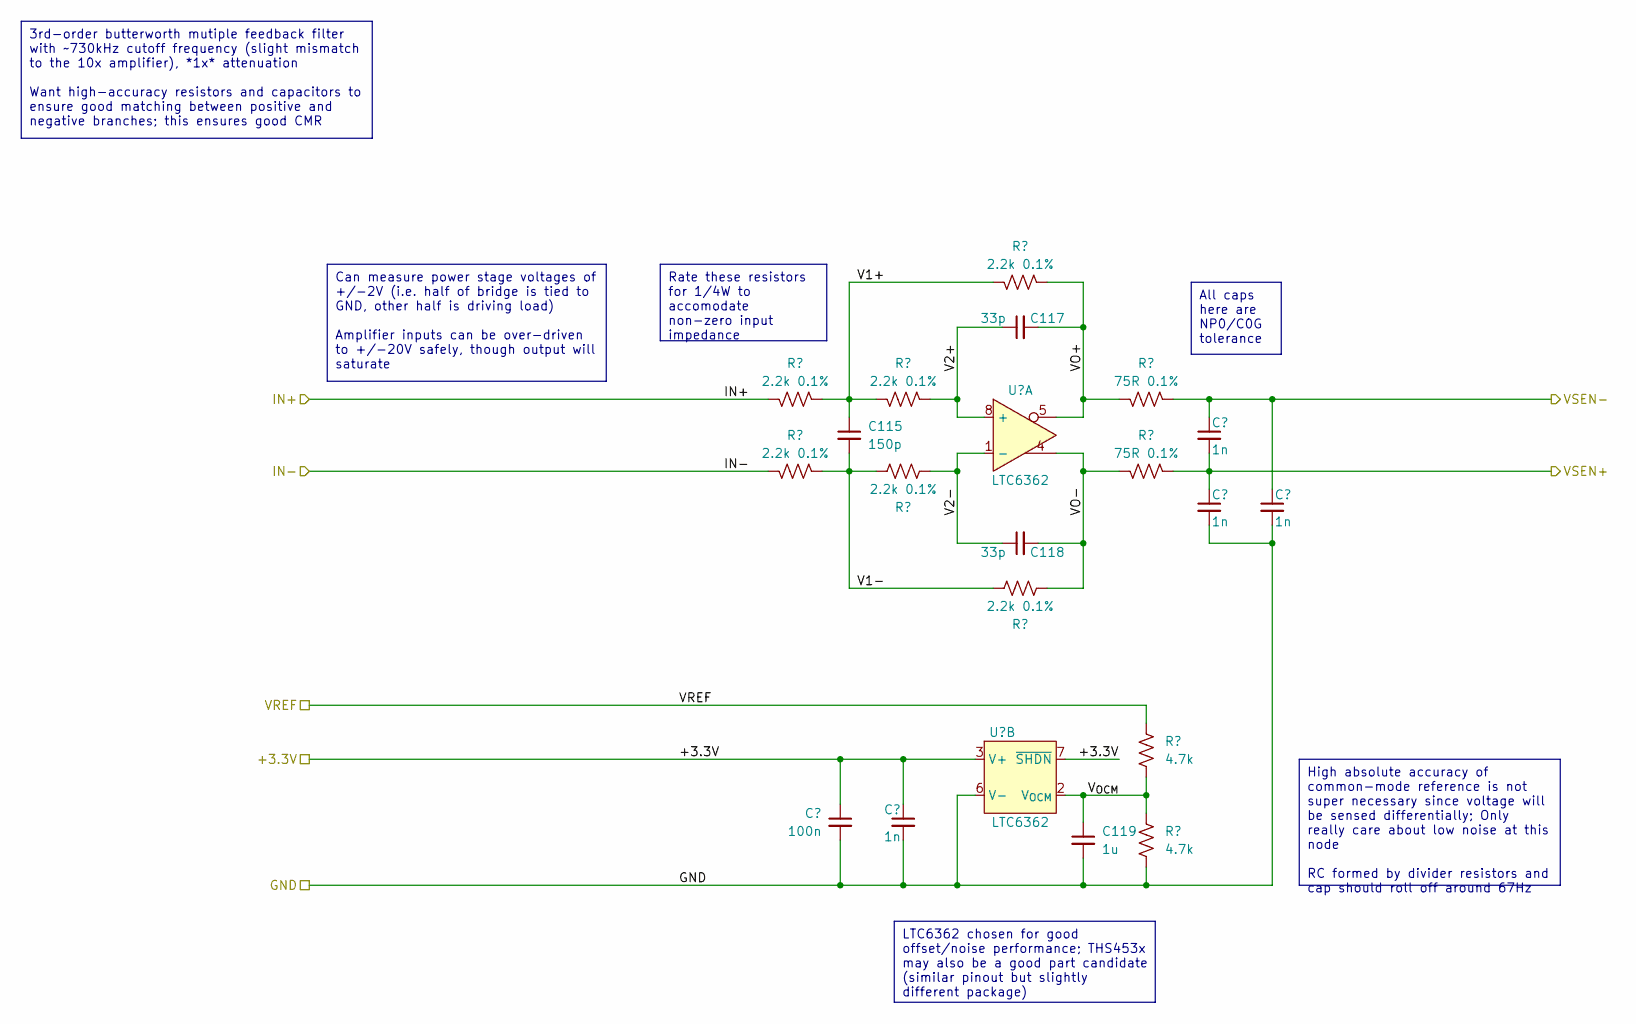
[picture p83: schematic shimamp_VoltageSensor1.kicad_sch]

Parts:
C114: 100n; C_0603_1608Metric_Pad1.08x0.95mm_HandSolder; Part Number CL10B104KB8NNWC
C115: 150p; C_0603_1608Metric_Pad1.08x0.95mm_HandSolder; Part Number GCM1885C2A151JA16D
C116, C120, C121, C122: 1n; C_0603_1608Metric_Pad1.08x0.95mm_HandSolder; Part Number CL10B102KB8NNNC
C117, C118: 33p; C_0603_1608Metric_Pad1.08x0.95mm_HandSolder; Part Number GCM1885C2A330JA16D
C119: 1u; C_0805_2012Metric_Pad1.18x1.45mm_HandSolder; Part Number CL21B105KBFNNNG
R35, R36, R37, R38, R39, R40: 2.2k 0.1%; R_1206_3216Metric_Pad1.30x1.75mm_HandSolder; Part Number RN73R2BTTD2201B25
R41, R42: 75R 0.1%; R_0603_1608Metric_Pad0.98x0.95mm_HandSolder; Part Number RN73R1JTTD75R0B25
R43, R44: 4.7k; R_0603_1608Metric_Pad0.98x0.95mm_HandSolder; Part Number RMCF0603FT4K70
U7: LTC6362; MSOP-8_3x3mm_P0.65mm; Part Number LTC6362CMS8#TRPBF

Connections:
+3.3V: C114.1, C116.1, U7.3 (V+), U7.7 (~SHDN)
GND: C114.2, C116.2, C119.2, C121.2, C122.2, R44.2, U7.6 (V-)
IN+: R35.2
IN-: R36.2
V1+: C115.1, R35.1, R37.2, R39.2
V1-: C115.2, R36.1, R38.2, R40.2
V2+: C117.1, R37.1, U7.8 (+)
V2-: C118.1, R38.1, U7.1 (-)
VO+: C117.2, R39.1, R41.2, U7.5
VO-: C118.2, R40.1, R42.2, U7.4
VREF: R43.1
VSEN+: C120.2, C121.1, R42.1
VSEN-: C120.1, C122.1, R41.1
V_{OCM}: C119.1, R43.2, R44.1, U7.2 (V_{OCM})

Notes on the sheet:
All caps here are NP0/C0G tolerance
LTC6362 chosen for good offset/noise performance; THS453x may also be a good part candidate (similar pinout but slightly different package)
Rate these resistors for 1/4W to accomodate non-zero input impedance
Can measure power stage voltages of +/-2V (i.e. half of bridge is tied to GND, other half is driving load) Amplifier inputs can be over-driven to +/-20V safely, though output will saturate
3rd-order butterworth mutiple feedback filter with ~730kHz cutoff frequency (slight mismatch to the 10x amplifier), *1x* attenuation Want high-accuracy resistors and capacitors to ensure good matching between positive and negative branches; this ensures good CMR
High absolute accuracy of common-mode reference is not super necessary since voltage will be sensed differentially; Only really care about low noise at this node RC formed by divider resistors and cap should roll off around 67Hz
