Govish/Shimamp-Hardware/Class-D Prototype revB2/Class-D Prorotype RevB2/shimamp_VoltageSensor10.kicad_sch

## KiCad design Class-D Prototype revB2/Class-D Prorotype RevB2/shimamp_VoltageSensor10.kicad_sch (2023-11-08)

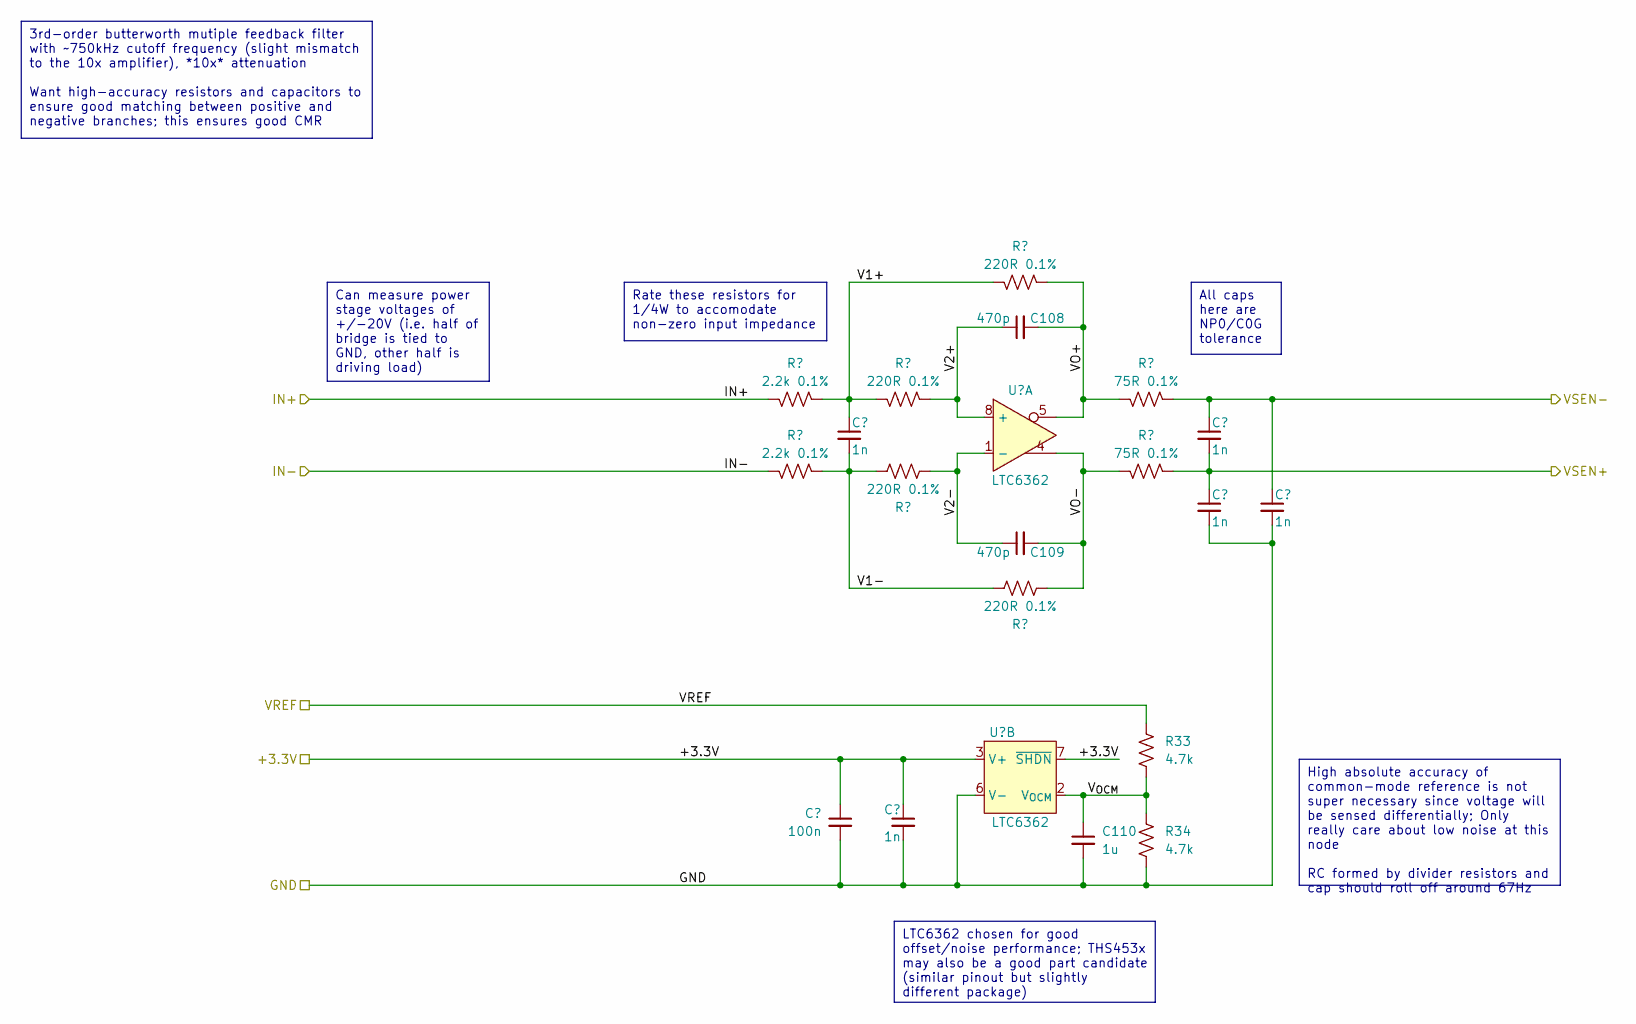
[picture p84: schematic shimamp_VoltageSensor10.kicad_sch]

Parts:
C105: 100n; C_0603_1608Metric_Pad1.08x0.95mm_HandSolder; Part Number CL10B104KB8NNWC
C106, C107, C111, C112, C113: 1n; C_0603_1608Metric_Pad1.08x0.95mm_HandSolder; Part Number CL10B102KB8NNNC
C108, C109: 470p; C_0603_1608Metric_Pad1.08x0.95mm_HandSolder; Part Number GCM1885C2A471FA16D
C110: 1u; C_0805_2012Metric_Pad1.18x1.45mm_HandSolder; Part Number CL21B105KBFNNNG
R25, R26: 2.2k 0.1%; R_1206_3216Metric_Pad1.30x1.75mm_HandSolder; Part Number RN73R2BTTD2201B25
R27, R28, R29, R30: 220R 0.1%; R_0603_1608Metric_Pad0.98x0.95mm_HandSolder; Part Number RN73R1JTTD2200B25
R31, R32: 75R 0.1%; R_0603_1608Metric_Pad0.98x0.95mm_HandSolder; Part Number RN73R1JTTD75R0B25
R33, R34: 4.7k; R_0603_1608Metric_Pad0.98x0.95mm_HandSolder; Part Number RMCF0603FT4K70
U6: LTC6362; MSOP-8_3x3mm_P0.65mm; Part Number LTC6362CMS8#TRPBF

Connections:
+3.3V: C105.1, C107.1, U6.3 (V+), U6.7 (~SHDN)
GND: C105.2, C107.2, C110.2, C112.2, C113.2, R34.2, U6.6 (V-)
IN+: R25.2
IN-: R26.2
V1+: C106.1, R25.1, R27.2, R29.2
V1-: C106.2, R26.1, R28.2, R30.2
V2+: C108.1, R27.1, U6.8 (+)
V2-: C109.1, R28.1, U6.1 (-)
VO+: C108.2, R29.1, R31.2, U6.5
VO-: C109.2, R30.1, R32.2, U6.4
VREF: R33.1
VSEN+: C111.2, C112.1, R32.1
VSEN-: C111.1, C113.1, R31.1
V_{OCM}: C110.1, R33.2, R34.1, U6.2 (V_{OCM})

Notes on the sheet:
LTC6362 chosen for good offset/noise performance; THS453x may also be a good part candidate (similar pinout but slightly different package)
3rd-order butterworth mutiple feedback filter with ~750kHz cutoff frequency (slight mismatch to the 10x amplifier), *10x* attenuation Want high-accuracy resistors and capacitors to ensure good matching between positive and negative branches; this ensures good CMR
All caps here are NP0/C0G tolerance
Rate these resistors for 1/4W to accomodate non-zero input impedance
Can measure power stage voltages of +/-20V (i.e. half of bridge is tied to GND, other half is driving load)
High absolute accuracy of common-mode reference is not super necessary since voltage will be sensed differentially; Only really care about low noise at this node RC formed by divider resistors and cap should roll off around 67Hz
